tocksin/placard/kicad/README.md

# KiCad project

Date: 2026-11-11

The Placard schematic and PCB layout, one KiCad project for the main board
and one for each cartridge.  The files are saved by KiCad 9, so open them
with KiCad 9 or newer.  Board revisions are in
[docs/hardware/RELEASES.md](../docs/hardware/RELEASES.md): rev A is the
board as ordered (git tag `rev-A`), and the files here are the working
rev B.

| File | What it is |
|---|---|
| `placard.kicad_pro` | the project; open this in KiCad |
| `placard.kicad_sch` | the schematic's root sheet (A3): one box per sheet, laid out like the block diagram |
| `power.kicad_sch` ... `expansion.kicad_sch` | the ten sheets (power and clock, control, PC and address mux, ALU and registers, data bus, memory and I/O decode, video timing, video and audio out, shared port, expansion slots), docs/hardware/SCHEMATIC_PLAN.md |
| `cartridge_64k/` | the 64K ROM cartridge (5 chips), its own project (`cartridge_64k.kicad_pro`, one sheet and a routed 4-layer board), using the same `lib/` |
| `cartridge_32k/` | the 32K ROM cartridge (3 chips), its own project (`cartridge_32k.kicad_pro`, one sheet and a routed 4-layer board), using the same `lib/`; mounting hole H1 at the same place as on the 64K board |
| `placard.kicad_pcb` | the main board, routed: 4 layers (F.Cu, In1.Cu = GND, In2.Cu = VCC, B.Cu) |
| `lib/placard.kicad_sym` | PLD symbols: `ATF22V10C` (generic) and one `ATF22V10C_<name>` per `.pld` file, with its pin names |
| `lib/placard_parts.kicad_sym` | other project symbols: `AS7C256C` SRAM, `Expansion_Slot`, `Cartridge_Slot`, `SNES_Pad_Socket`, `PS2_Dual_Stacked`, `USB_C_Power` |
| `lib/placard_std.kicad_sym` | copies of the stock KiCad symbols the sheets use (74xx, R, C, D, connectors, regulator, the cartridge EEPROM `28C256`, and the power symbols `+5V`, `GND`, `+3V3`, `GNDA`, `PWR_FLAG`) with larger pin text, written by `src/scripts/gen_kicad_std.py` |
| `lib/placard.pretty/` | project footprints: the main board's connectors and switches (written by `src/scripts/gen_kicad_connectors.py`), and kit versions of KiCad's DIP socket footprints (`DIP-nn_..._Socket_Puller`: chip-puller room on User.Eco1, part number in silkscreen) and of the axial resistor (`..._Value`: value in silkscreen), written by `src/scripts/gen_kicad_kit_footprints.py`, and copies of the KiCad 9.0.6 footprints the boards use (capacitors, diodes, LED, pin header, oscillator, TO-92, SIP resistor array, mounting holes, net tie; KiCad 9 format), written by `src/scripts/gen_kicad_stock_footprints.py` |
| `lib/placard.3dshapes/` | 3D models (STEP) for the connectors, switches and polyfuse, named after their footprints and referenced as `${KIPRJMOD}/lib/placard.3dshapes/...`, so they show in any KiCad version without a 3D library path; written by `src/scripts/gen_kicad_3d_models.py` (CadQuery), which also copies in KiCad's own models for SW2, J7 and J13, and KiCad's models for the stock, socket and resistor footprints, copied by `src/scripts/gen_kicad_stock_footprints.py` |
| `sym-lib-table`, `fp-lib-table` | point KiCad at the project libraries |
| `fab/` | the rev A Gerber and drill files as ordered ([fab/README.md](fab/README.md)) |

The main board is 290 x 215 mm (290 wide, the keyboard's width; 215 deep, so
kit builders have room), 4 layers, placed and routed.

Main board

Main board copper, front red and back blue

The back edge carries USB-C power, audio line out, VGA and the stacked PS/2;
the left side the power switch, reset button and SD card; the front edge the
two SNES ports.  The cartridge and the four expansion cards stand up
through the case top.  Every DIP sits in a socket footprint with 2.5 mm of
chip-puller room clear past each socket end, and Cn sits beside Un.
`src/scripts/gen_board_pictures.py` draws the two pictures (and the
cartridge pictures in [EXPANSION.md](../docs/architecture/EXPANSION.md))
from the board files without changing them; rerun it after a layout change.

The board file is edited in KiCad and by the autorouter, so it is the
source.  `src/scripts/gen_kicad_pcb.py` made the first outline and placement
and `src/scripts/gen_kicad_cart_pcb.py` the cartridges' placement; do not
run either on the boards now (the cartridge script leaves an existing board
alone unless given `--force`).  The first placement drawings are in
[docs/archive/](../docs/archive/README.md).

The footprints KiCad has no part for (cartridge slot, expansion slots,
PS/2, SNES, the power switch, the relay) are written by
`src/scripts/gen_kicad_connectors.py`.  The SNES sockets were measured from
the part; the others are drawn from typical dimensions for the part family,
so check them against the parts when the rev A boards arrive.
Their 3D models (`src/scripts/gen_kicad_3d_models.py`) are drawn at typical
dimensions too, with the leads put on the footprint pads.  J4 (SD), J7 (VGA),
F1 and SW2 use project copies of KiCad's footprints (`placard:` library) only so
they can point at the project's models; the pads are KiCad's.
The schematic rules (which chips go on which sheet, numbering, and how
the sheets are drawn) are in [docs/hardware/SCHEMATIC_PLAN.md](../docs/hardware/SCHEMATIC_PLAN.md).  Parts and U-numbers come from
[docs/architecture/CHIPS.md](../docs/architecture/CHIPS.md); the PLD pinouts come from the `.pld` files
in `src/`.

Every part carries Manufacturer and MPN fields (empty where no part number
is chosen yet), set from the `MPN` table in `src/scripts/gen_kicad_schematic.py`,
so KiCad's BOM export lists them.  `src/scripts/gen_bom.py` writes one grouped
bill of materials per assembly (main board, 64K and 32K cartridges, case),
indexed in [docs/bom/BOM.md](../docs/bom/BOM.md), each as .md and .csv, including the
bare PCBs, sockets, shells and screws that are not on the schematic.

Backups, autosaves, lock files, `*.kicad_prl` (per-user view settings) and
`fp-info-cache` are git-ignored.

## PLD symbols

`src/scripts/gen_kicad_symbols.py` writes `lib/placard.kicad_sym` from the
`PIN` statements in `src/pld/*.pld`; rerun it after changing a PLD's pins
(it overwrites the whole library).  The pins are placed for the schematic,
not in pin-number order: the script's `LAYOUT` table puts inputs on the
left and outputs on the right, buses together in bit order, and each
function's pins in their own group.  Where one PLD does two unrelated jobs
(the audio PLD's /AC_SEL, the port PLD's pad read, the memory control's
RUN input) a dashed line across the box separates them.  Active-low pins are
`/NAME`, VCC (24) is on top and GND (12) underneath, unused pins are `nc`
(no-connect type), and the `.pld` file name is under the part number.  The
script stops if a `.pld`'s pins and its `LAYOUT` entry no longer match.
Each symbol has the footprint `Package_DIP:DIP-24_W7.62mm` and the
ATF22V10C datasheet link.

## Other symbols

`src/scripts/gen_kicad_parts.py` writes `lib/placard_parts.kicad_sym`, in
the same style, for the parts KiCad's libraries do not have: the AS7C256C
SRAM, the expansion slot (Molex 87715-9106 as the cartridge slot, contacts A1-A32 and B1-B32)
and the cartridge slot (Molex 87715-9106, 2 x 32 keyed, contacts A1-A32
and B1-B32), as in EXPANSION.md, with the +5 V and GND contacts stacked on
one pin each, the SNES pad socket (IO.md) and
`USB_C_Power`, the 5 V input: a power-only 6-contact USB-C receptacle
(GCT USB4125, footprint `placard:USB_C_Receptacle_GCT_USB4125_6P_HandSolder`:
KiCad's USB4125 footprint with the SMD pads 1.5 mm longer for the iron, made by gen_kicad_connectors.py)
with a 5.1k resistor from CC1 and from CC2 to GND so a charger gives 5 V.  Make
changes in the script, since rerunning it overwrites the library.

Every symbol, footprint and 3D model the sheets and boards use is in `lib/`
(since 2026-10-26): the projects' library tables list only the placard
libraries, so the project opens the same on any PC and DRC/ERC find nothing
missing or different from its library.  The parts below started as KiCad
library parts and are used through their copies in `placard_std` and
`placard.pretty`:

| Part | KiCad symbol |
|---|---|
| SN74F377AN | `74xx:74LS377` |
| SN74F541N | `74xx:74LS541` |
| CD74ACT273E | `74xx:74HC273` |
| SN74HCT574N | `74xx:74HCT574` |
| 25.175 MHz oscillator | `Oscillator:ACO-xxxMHz` |
| 3.3 V regulator (MCP1700-3302E/TO) | `Regulator_Linear:MCP1700x-330xxTO` |
| VGA | `Connector:DE15_Receptacle_HighDensity_MountingHoles` |
| SD socket | `Connector:SD_Card` |
| Audio line out | `Connector_Audio:AudioJack3` |
| Pull-up arrays | `Device:R_Network08` |

Set the Value to the real part number when placing them.
`src/scripts/render_kicad_symbols.py OUTDIR` draws all of these as PNG
review sheets (needs kicad-cli, cairosvg and Pillow).

## Schematic sheets

`src/scripts/gen_kicad_schematic.py` wrote the `.kicad_sch` files (main
board and cartridges) from its pin-by-pin net lists.  Since 2026-10-30 the
main-board sheets are edited in KiCad and the saved sheets are the source:
never commit a full regeneration of them.  To use the script for one sheet,
run it in a scratch copy, take only that sheet and check the netlist
against the saved one (docs/hardware/SCHEMATIC_PLAN.md).  Nets with two or more pins on a sheet are wired by the small router in
`src/scripts/kicad_route.py`, and numbered groups (`D0`-`D7`, ...) are drawn
as one bus per sheet (docs/hardware/SCHEMATIC_PLAN.md, "How the sheets are drawn").
`--check` compares KiCad's exported netlist with the script's nets and
runs basic electrical checks; for the full ERC open the project in KiCad
(Inspect > Electrical Rules Checker).  PDFs of both are in
[`../schematics/`](../schematics/).

## Dimension drawing

[`../docs/hardware/placard_main_dimensions.pdf`](../docs/hardware/placard_main_dimensions.pdf)
is a three-sheet mm drawing of the main board: outline and mounting holes,
edge connector positions, and the expansion card and cartridge space.  It is
made by `src/scripts/gen_board_dimensions.py`, which needs KiCad 9 (pcbnew
Python and kicad-cli).  The script never writes `placard.kicad_pcb`: it
adds KiCad dimension objects on Dwgs.User in temporary copies and plots
those, so rerun it after the layout changes.
