tocksin/placard/kicad/fab/README.md

# Fabrication files

These are the **rev A** outputs as ordered on 2026-11-06 (git tag `rev-A`,
see [docs/hardware/RELEASES.md](../../docs/hardware/RELEASES.md)). The working
main board and 32K cart files are now rev B, so these no longer match them;
regenerate before ordering rev B.

Generated with kicad-cli 9.0.8 from copies of the board files (the boards
themselves were not changed). Main board regenerated 2026-11-03 from main at
PR #243 (routed expansion-redesign board); cartridges 2026-10-29 (rev A).
Zone fills are the ones saved in each .kicad_pcb; kicad-cli 9 has no refill
option, so refill (B) and save in pcbnew before regenerating if a board was
edited after its last fill.

| Folder | Board | Size (mm) | Layers |
|---|---|---|---|
| `main/` | `kicad/placard.kicad_pcb` | 290.1 x 215.1 | 4, 1.6 mm |
| `cart32k/` | `kicad/cartridge_32k/cartridge_32k.kicad_pcb` | 39.1 x 66.1 | 4, 1.57 mm |
| `cart64k/` | `kicad/cartridge_64k/cartridge_64k.kicad_pcb` | 39.1 x 102.25 | 4, 1.57 mm |

Each folder holds `gerber/` (the files to zip and upload) and `drc.rpt`.
The upload zips (`placard_<board>_gerbers.zip`, Gerber files at the zip root)
and the ODB++ zips (`placard_<board>_odb.zip`) are git-ignored; copies are
in the project files under `hardware/fab/`.

## Gerber and drill settings

- Gerber RS-274X with X2 attributes, Protel extensions (.gtl .gbl .gto .gbo
  .gts .gbs .gtp .gbp .gm1; inner layers .g1 = In1 GND, .g2 = In2 VCC),
  soldermask subtracted from silkscreen, plus a Gerber job file (.gbrjob).
- Drill: Excellon, mm, decimal zeros, absolute origin, oval holes in
  alternate (G85) mode, PTH and NPTH in separate files, drill maps in Gerber X2.
- These settings match the JLCPCB and PCBWay KiCad guides, so one zip works
  for both.

## Ordering notes

- Upload the Gerber zip to JLCPCB or PCBWay. Both quote and check
  Gerber + Excellon zips; the ODB++ zip is for fabs or assembly houses that
  ask for it.
- Cartridges: the edge fingers mate with a Molex 87715-9106 (PCIe style)
  slot, so order 1.6 mm (1.57) thickness with gold fingers (hard gold / ENIG)
  and a 45 degree finger bevel.
- Main board 2026-11-03: refill gave a file identical to the saved one; DRC
  with schematic parity 0 violations, 0 unconnected, 0 parity issues.
- DRC (all three boards, run with each project's own rules and footprint
  library; main board uses the PCBWay-margin rules): 0 errors, 0 warnings,
  0 unconnected pads.
- Saved fills checked against a fresh refill: all three identical. The carts
  were regenerated on 2026-10-29 after Justin's Update PCB from Schematic
  (nets renamed to ADDR*/DATABUS*, part-number fields added; the mounting hole
  H1, which is not in the cart schematics, was put back at its old position)
  and a refill; copper geometry is unchanged apart from the refill.
- S/N box (17 x 5.5 mm) is a filled silk rectangle on all three boards
  (2026-10-29), so a black marker shows up on it.
