tocksin/placard/docs/sound/SOUND.md

# Sound

Date: 2026-11-11

The video circuit plays sound by itself.  On every scan line it reads one
8-bit sample from RAM, the same way it reads pixels, and a register feeds that
sample to a resistor DAC.  Software only keeps a 525-byte buffer filled.

| | |
|---|---|
| Format | 8-bit unsigned mono, 80h = silence |
| Sample rate | the line rate: 31.469 kHz at 25.175 MHz (31.25 kHz on the FPGA's 25.000 MHz) |
| Buffer | 5DF3h-5FFFh, 525 bytes, one frame, played in address order and repeated |
| Added chips | audio slot PLD (ATF22V10C) and DAC register (SN74HCT574N); the DAC, filter and line output are passives |
| CPU cost | one stall clock per line (525 per frame, 0.13 %) |

## Schematic

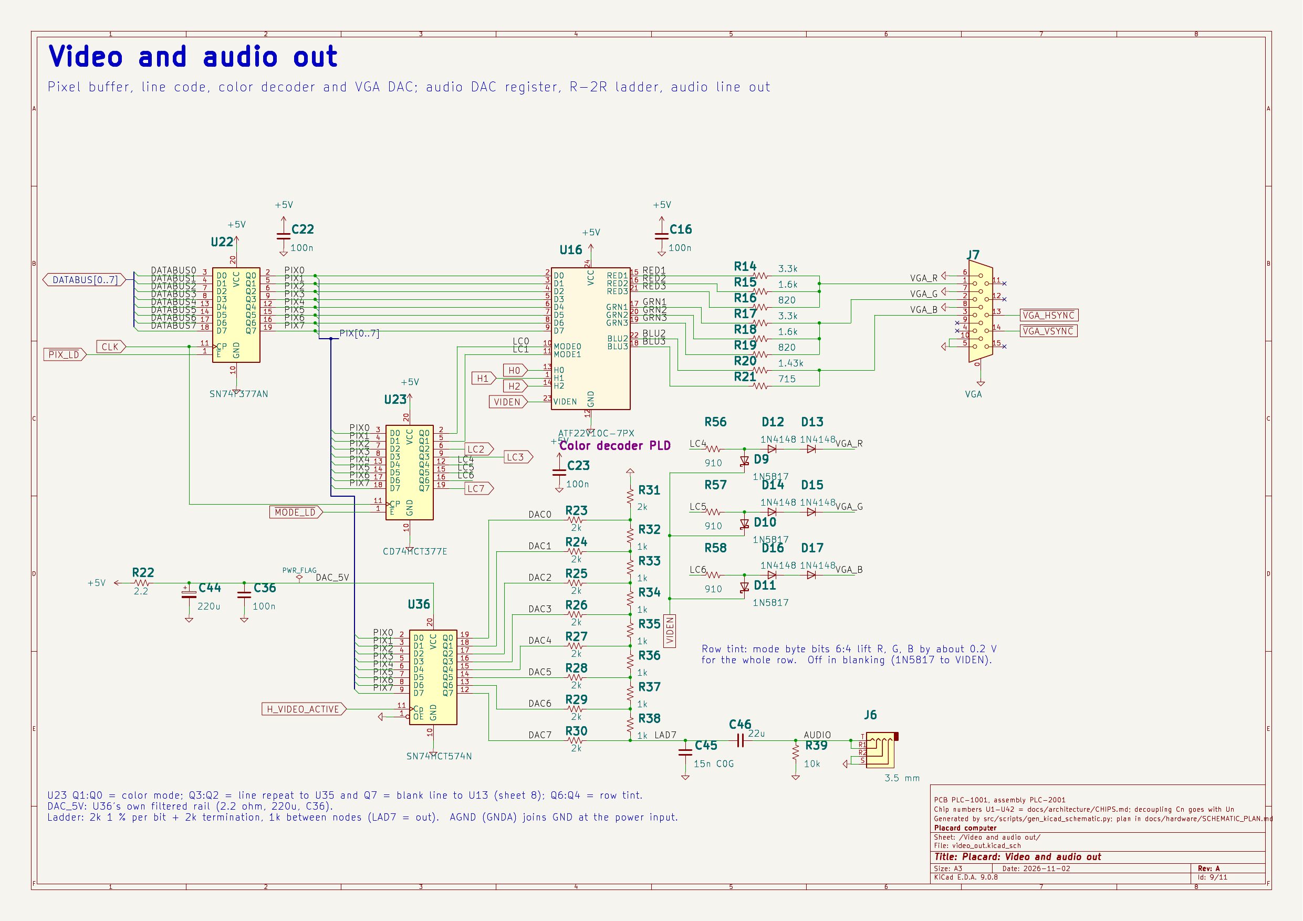
[picture p30: schematics/placard_video_audio_schematic.png]
Video and audio out, sheet 9 of the schematic


This is sheet 9 of the schematic (`schematics/placard_main.pdf`): the pixel
buffer (U22), the DAC register (U36) with its filtered supply (R22, C44,
C36), the R-2R ladder (R23-R38), the filter (C45, C46, R39) and the jack
(J6).  The audio slot PLD (U35) and the Sync PLD (U15) that make the read
are on sheet 8.

## How the sample is read

**The read.**  The Sync PLD raises PIXEL_ENABLE for one more
clock per line, in clock 1 of an 8-clock group in horizontal blanking, on all
525 lines including vertical blanking.  It is a video read in every way: the
address mux selects the video address, the Branch PLD stalls the CPU, the
memory control PLD enables the RAM (video reads always read the RAM), and
the pixel buffer (F377) loads the byte.

**The address.**  The video address is H9:H3 on A15:A9 and V8:V0 on A8:A0.
The V counter runs 499-1023, 525 lines, but only 9 bits of it reach the
address, so lines 499-511 and 1011-1023 would read the same 13 bytes and 13
samples would repeat every frame (a 60 Hz buzz).  The audio slot PLD fixes
that by reading in group 46 when V9 = 0 and in group 47 when V9 = 1, which
puts V9 on A9:

| Lines | V9 | Group | H9:H3 | Addresses |
|---|---|---|---|---|
| 499-511 | 0 | 46 | 0101110 | 5C00h + 499..511 = 5DF3h-5DFFh |
| 512-1023 | 1 | 47 | 0101111 | 5E00h + 0..511 = 5E00h-5FFFh |

One frame reads 5DF3h through 5FFFh in order.  The buffer is at the top of
section 2, just below the video memory; the I/O window is 5000h-53FFh
(groups 40-41), where no memory answers.  The row address bits the audio
slot PLD remaps for the line repeat are passed through unchanged in groups
32-47, so the audio read is not affected by a row's mode byte.

**The output.**  The mode byte read (group 45) comes before the audio read,
so the pixel buffer holds the sample until the first pixel read of the line
loads it (end of clock 1 of group 48).  A 74HCT574 clocked by the rising
edge of H_VIDEO_ACTIVE (H counter PLD pin 22, start of group 48) copies it.
So every sample lasts exactly one line (800 clocks), even though the read
itself moves 8 clocks between group 46 and group 47.

### Audio slot PLD (`ATF22V10_AUDIO.pld`, `audio_pld.vhd`)

It also marks group 45, where the video circuit
reads the line's mode byte (see [VIDEO.md](../video/VIDEO.md#mode-byte)), and makes
four row address bits for the line repeat (see
[VIDEO.md](../video/VIDEO.md#line-repeat)).

    BLANK_RD = !H9 & H8 & !H7 & H6 & H5 &  H4 &  H3 &  V9      /* group 47 */
             # !H9 & H8 & !H7 & H6 & H5 &  H4 & !H3 & !V9      /* group 46 */
             # !H9 & H8 & !H7 & H6 & H5 & !H4 &  H3;           /* group 45 */

    MODE_LD  = !H9 & H8 & !H7 & H6 & H5 & !H4 &  H3;           /* pin 22, active low */

| Pin | Signal | From / to |
|---:|---|---|
| 1 | V0 | V counter PLD pin 14 (Q0) |
| 2-8 | H9, H8, H7, H6, H5, H4, H3 | H counter PLD pins 20, 19, 18, 17, 16, 15, 14 |
| 9 | V9 | V counter PLD pin 19 (Q9) |
| 10, 11, 13 | V1, V7, V8 | V counter PLD pins 23, 17, 18 |
| 14, 15 | LC2, LC3 | Line code register (74HCT377) Q2, Q3 |
| 17-20 | R0, R1, R7, R8 | Address mux video inputs for A0, A1, A7, A8 |
| 22 | /MODE_LD | Line code register (74HCT377) /E |
| 23 | BLANK_RD | Sync PLD pin 13 |
| 16, 21 | unused | |

### Sync PLD term

    PIXEL_ENABLE.D = V_VIDEO_ACTIVE & H_VIDEO_ACTIVE & H2 & H1 & !H0
                   # BLANK_RD & H2 & H1 & !H0;

BLANK_RD comes in on the Sync PLD's pin 13 and reads in clock 1 of the
group it marks, like a pixel read ([VIDEO_TIMING.md](../timing/VIDEO_TIMING.md)).

### Timing

| Path | Total | Slack at 39.72 ns (datasheet) |
|---|---:|---:|
| BLANK_RD to the Sync register: H counter tCO 5.5, audio PLD tPD 7.5, Sync tS 3.5 | 16.5 ns | +23.2 |
| The audio read: the same path as a pixel read, through /RAM_OE ([VIDEO_TIMING.md](../timing/VIDEO_TIMING.md)) | 36.4 ns | +3.4 (−1.1 on the routed board, see [TIMING.md](../timing/TIMING.md)) |
| DAC register data: the pixel buffer is steady from group 46/47 to clock 1 of group 48, and the clock edge (H_VIDEO_ACTIVE, tCO 5.5 ns) is at the start of group 48 | at least 6 clocks before the edge and 2 after | |

### Checked in simulation

The FPGA model (GHDL) reads exactly one sample per line, 5DF3h-5FFFh in
order with no repeats, and the DAC register steps once per line.

## DAC, filter and audio line out

All passive, with no op-amp and no headphone amplifier: the jack is an
audio **line out**, meant for a line input (an amplifier, powered speakers,
a mixer or a capture card, 10 kΩ or more).  It is not a headphone output
(Justin, 2026-10-23).

    +5V ──2.2Ω──┬── VCC (pin 20) of the 74HCT574 ("DAC 5V")
                ├── 220µF ── AGND
                └── 100nF ── AGND

    74HCT574 Q7 (MSB) ─ 2k ─┬───────────────── ladder out (Rth = 1k)
    74HCT574 Q6       ─ 2k ─┼ 1k ┐
                             ...  (each node: 2k from its bit,
    74HCT574 Q1       ─ 2k ─┼ 1k ┐  1k to the next node up)
    74HCT574 Q0 (LSB) ─ 2k ─┤
                             └─ 2k ─ AGND   (termination)

    ladder out ──┬── 15nF ── AGND                (filter)
                 └── 22µF ceramic ────────────────┬── jack tip and ring
                                                  └── 10k ── AGND   (bleed)
    jack sleeve ── AGND

### The register

- **74HCT574, not 74HC574 or 74F574.**  HCT inputs read the pixel buffer's
  74F outputs (2.7 V minimum high) correctly, which an HC input (3.5 V
  threshold at 5 V) does not.  HCT outputs swing rail to rail, which the
  ladder needs for even steps; 74F outputs only reach about 3.4 V and differ
  from bit to bit.
- D7:D0 from the pixel buffer Q7:Q0.  CLK from H_VIDEO_ACTIVE (H counter PLD
  pin 22).  /OE (pin 1) to ground.
- **Power it from its own filtered rail** (2.2 Ω, 220 µF and 100 nF above).
  The ladder's full scale is this chip's VCC, so any noise on it comes out in
  the audio in proportion to the sample (at silence, 80h, half of it).  The
  chip and ladder draw at most about 5 mA, which drops about 11 mV across the
  2.2 Ω (0.2 % of full scale), less than one step.
- In the FPGA model the register is `audioDacProc` in `basys_top.vhd`, and
  Q7:Q0 come out on Pmod JA (JA10 = Q7 down to JA1 = Q0, 3.3 V full scale).
  The same ladder and output work there, at two thirds of the level.

### The R-2R ladder

| Part | Value | Qty |
|---|---|---:|
| 2R: one per bit, plus the termination | 2.00 kΩ, 1 % metal film | 9 |
| R: between neighboring nodes | 1.00 kΩ, 1 % metal film | 7 |

- Open-circuit output = VCC × code / 256, so 0 V to 4.98 V, 2.49 V at
  silence (80h).  The ladder's output resistance is R (1 kΩ) at every code.
- The low R (1 k instead of a more usual 10 k) keeps the output impedance
  low enough to drive a line input and its cable without a buffer.  Each bit
  sources at most about 2.5 mA, well inside what a 74HCT574 output can do.
- Linearity: with 1 % parts the steps are even to about 7 bits.  The HCT
  output resistance (roughly 25-50 Ω) against 2 kΩ adds about one step of
  error at the middle of the range.  Neither is audible as distortion in
  sound like this.  For better, use 0.1 % parts for the MSB leg and the two
  legs below it.

### The filter

One capacitor, 15 nF (C0G or film), from the ladder output to AGND.

- Into a line input (10 kΩ or more) it forms a single pole with the
  ladder's 1 kΩ: 10.6 kHz (11.7 kHz with a 10 kΩ load).  That softens the
  31.5 kHz steps.
- A low-impedance load (headphones, 16-32 Ω) would swamp the 1 kΩ and the
  pole would move far above the audio.  That is one more reason the jack is
  a line out only.
- A C0G (NP0) or film capacitor, not X7R, whose value moves with voltage.

### The line output

| Part | Value | Why |
|---|---|---|
| Coupling capacitor | 22 µF ceramic (X5R/X7R, non-polar), 10 V or more | blocks the 2.49 V offset; low corner about 7 Hz into 16 Ω, under 1 Hz into 10 kΩ |
| Bleed resistor | 10 kΩ, jack side to AGND | holds the jack side at 0 V so plugging in does not pop; also the minimum load when nothing is plugged in |
| Jack J6 | 3.5 mm, 4 pole (TRRS); tip and ring tied together, sleeve to AGND | mono on both channels of a stereo line input |

- **Level.**  Into a 10 kΩ line input (in parallel with the 10 kΩ bleed,
  5 kΩ in all) a full-scale sine is about 4.2 V peak to peak (1.5 V rms,
  +3.4 dBV); open circuit it is 5 V peak to peak.  That is hotter than the
  consumer line level (-10 dBV, 0.9 V peak to peak) but under the 2 V rms
  most line inputs accept.  Software sets the volume by scaling the samples
  around 80h; a sine of 80h ± 20h is about 1 V peak to peak, close to
  consumer line level.  Output impedance is about 1 kΩ.
- **Headphones are not supported.**  There is no headphone amplifier: into
  16-32 Ω headphones the swing drops to about 80-150 mV peak to peak, very
  quiet.
  Plug the jack into an amplifier or powered speakers instead.
- **Short circuit** (a plug going in): the 1 kΩ ladder resistance limits the
  current, so nothing is harmed.
- **Power-on.**  At power-up the coupling capacitor charges to 2.49 V, which
  makes one soft thump if an amplifier is already connected.  After that the
  output stays at mid-scale (see the click-free rules), so it happens only
  once.
- **Grounds:** the ladder termination, the 15 nF capacitor, the bleed
  resistor and the jack sleeve all return to an analog ground (AGND) that
  meets the logic ground at one point, at the power input.

## Click-free rules

The hardware never adds a click on its own:

1. **One sample per line, no gaps, no repeats**, on all 525 lines, and every
   update at the same point in the line.
2. **All 8 bits change on one edge** of the 74HCT574, so the ladder never sees
   a half-updated value; the few-ns skew between bits is far above the audio
   band, and the filter removes it.
3. **Silence is 80h**, and the output is AC coupled, so starting and stopping
   never makes a DC step.
4. **Power-up.**  Video reads always come from the RAM (memory control PLD), which is random at power-up, so the output plays noise until
   software fills 5DF3h-5FFFh with 80h; that should be one of the first things
   a program (or the boot loader) does.  The 74HCT574 powers up with a random
   value for one line (32 us), which the filter and coupling capacitor turn
   into nothing worth hearing.

Software has its own part:

- Fade a sound in and out over a few milliseconds; never cut it off mid-wave.
- Leave 80h in the buffer when nothing is playing.
- Keep the buffer filled ahead of playback (next section).  If a program stops
  refilling, the last frame repeats, which is a buzz, so fade to 80h first.

## Software

### The sound driver

The library's sound driver (`src/scripts/placard_snd.asm`, in the library
at `SND_CODE`, ROM x9200-x96FF, section 4) does the buffer work.  A program calls `snd_init` once,
`snd_update` once every frame (from anywhere in the frame; a game loop that
already calls `wait_frames` or `frame_poll` just adds it), and starts sounds
with one call:

```
    (CALL snd_init)             ; once
    ...
    ld   69, ac                 ; A 440 Hz
    (CALL snd_beep)             ; a short note that fades out
    ...
loop:
    (CALL snd_update)           ; every frame
    ...
```

| Routine | In | Does |
|---|----|---|
| `snd_tone` | R1:R0 = step (frequency in Hz x 1.0413), AC = volume 0-127, R2 = frames (0 = until stopped), R3 = volume taken off each frame | Square wave |
| `snd_note` | AC = MIDI note 0-127 (60 = middle C, 69 = A 440) | R1:R0 = the step for `snd_tone` |
| `snd_beep` | AC = MIDI note | Volume 96, 12 frames, fading by 8 a frame |
| `snd_noise` | AC = volume, R0 = rate 1-128 (128ths of the line rate), R2, R3 as `snd_tone` | Noise (a 16-bit LFSR, the same seed each time) for drums and hits |
| `snd_play` | R1:R0 = samples (RAM or ROM), R3:R2 = count, AC = rate 1-128 (128 = 31.5 kHz, 32 = 7.9 kHz) | 8-bit unsigned samples, 80h = silence |
| `snd_stop` | | Silent within a frame |
| `snd_busy` | | AC = 0 when silent |

One sound plays at a time; starting another replaces it.  The step is a
16-bit phase increment per line (32768 = half a cycle per line), so the
pitch error is under 0.01 % above 100 Hz.

**How `snd_update` keeps up.**  Instead of double buffering it writes just
behind the player: it waits for the line read to change (so it knows the
line exactly, to 4 lines) and writes every sample from where it stopped
last time up to the line now playing.  Sounds start within a frame.  When
the sound is over and the buffer has been all 80h for two laps, it returns
at once.  The line read only says where the player is within its lap, so
the driver also counts the frames between calls (`FRAME_LO`, which
`frame_poll`, `wait_frames` and BASIC keep): a call a whole frame after
the last one, with the player a line or two past where it was, writes a
lap and the little more, not just the little more.

**Measured CPU time** (`test_snd.py`, about 380,000 usable clocks per frame):

| Sound | Clocks per frame | Share |
|---|---:|---:|
| Silence (buffer clean) | about 90 | 0 % |
| Samples (`snd_play`) | about 18,300 | 5 % |
| Tone | about 26,000 | 7 % |
| Noise | about 42,700 | 11 % |

Plus up to 3,200 clocks waiting for the line read to change.  The driver
uses zero page x90-x9E and T0-T3.  `test_snd.py` checks the buffer against
a Python model of every sound, sample for sample.

### The music player

For music, `src/scripts/placard_mus.masm` is a four-voice SID-style player
(patterns, instruments, envelopes, effects, a fifth voice for sound effects)
that a program includes instead of the driver: [MUSIC.md](MUSIC.md).

### By hand

A program that does not use the driver can fill the buffer itself.

**Playback position.**  The sample playing is line V - 499, and the line read
at 5000h returns V9:V2 (V / 4).

**Double buffering.**  The buffer splits at line 768, which is where the line
read reaches C0h and the address reaches 5F00h:

| Half | Lines | Line read | Bytes | Addresses |
|---|---|---|---|---|
| A | 499-767 | 7Ch-BFh | 269 | 5DF3h-5EFFh |
| B | 768-1023 | C0h-FFh | 256 | 5F00h-5FFFh (one page) |

At least twice per frame (every 8 ms), read the line count and refill the
half that is not playing:

    ld 0x50, y
    ld [y,x], ac          ; line read (V9:V2)
    ; ac >= 0xC0: half B is playing, so refill half A if not done this frame
    ; ac <  0xC0: half A is playing, so refill half B if not done this frame

Each refill has 8 ms to finish, so no exact timing is needed.  If one is
late, the old half plays again (a stutter).

**Other rates.**  Writing each sample twice gives 15.7 kHz, four times
7.9 kHz.  A tone with a whole number of cycles per frame (a multiple of
59.94 Hz) loops with no refills at all.

**CPU time** (estimates from the instruction clock counts in CPU.md, not
measured; about 380,000 CPU clocks per frame):

| Work | Clocks per sample | Per frame |
|---|---:|---:|
| Hardware read (stall) | 1 | 0.14 % |
| Polling the line read twice | | under 0.1 % |
| Silence or a looping tone | 0 | 0 % |
| Copying a stored sound | about 25 | about 3.5 % |
| One generated voice (phase add and wavetable) | about 40 | about 5.5 % |
| Each extra mixed voice | about +25 | about +3.5 % |

## Memory map impact

- 5DF3h-5FFFh is the audio buffer while sound is used.  5A20h-5BFFh holds the
  row mode bytes (see [VIDEO.md](../video/VIDEO.md#mode-byte)).  4000h-4FFFh,
  5400h-5A1Fh and 5C00h-5DF2h are free.
- The video reads the buffer from the RAM whatever the map says.  For the
  CPU to read it back, section 2 (map bit 2) must read RAM.
