tocksin/placard/docs/software/SOFTWARE_ROADMAP.md

# Software roadmap

Date: 2026-11-11

Programs to write for the Placard, what each needs, and where it fits.
The libraries it builds on are in [LIBRARY.md](LIBRARY.md)
and [IO.md](../architecture/IO.md).  The sizes below are estimates, to be replaced by real
numbers as each program is written.

## The long-term plan

The ROM holds only the essentials: the library (core routines, font, I/O
drivers, FAT, sound), the boot loader, and a small resident program that
can find and load everything else from the SD card.  Other programs are
files on the SD card, loaded into RAM one at a time.  The cartridge can be
32 KB (x8000-xFFFF, mirrored) or 64 KB (ROM.md, "Loading the cartridge"),
so the resident set shares **x8000-xFFFF (32 KB)** with the library, one
kind of thing per 8 KB section (ROM.md, "ROM map").

### What the machine gives a program

| Resource | Amount | Notes |
|---|---|---|
| Clock | 25.175 MHz | one frame = 800 × 525 = 420,000 clocks, 59.94 Hz |
| CPU time | about 380,000 clocks a frame | 80 video stall clocks per drawn line (38,400 a frame); blanked rows give them back (VIDEO.md, "Blank line") |
| Native instructions | 2-4 clocks each, about 3 typical | about 125,000 a frame, 7.5 million a second |
| ROM, resident | x8000-xBFFF (16 KB) on a 32 KB cart | plus x2000-x3FFF and x6000-x7FFF on a 64 KB cart |
| RAM for a loaded program | x0100-x1EFF (7.75 KB) and x2000-x3FFF (8 KB, map section 1 to RAM) | about 15.75 KB of code; x1F00-x1FFF is `LIB_RAM` |
| RAM for data | x4000-x4CFF (3.25 KB), x5400-x5A1F, x5C00-x5DF2 | x4D00-x4FFF is the FAT buffer |
| Video RAM freed | 20 KB with an 80 × 28 text screen | see below |

**Text screen versus free RAM.**  The full 80 × 60 console uses all 37.5 KB
of video RAM.  A program that needs memory (editor, assembler, BASIC, CP/M)
can use text rows 0-27 only (1x rows 0-223, which use the low 256 bytes of
each video column) and blank the rest of the screen: that leaves the high
256 bytes of every column free, 80 pages (x61, x63 ... xFF), 20 KB, and the
blanked lines give back about 20,000 clocks a frame.  The pages are not
contiguous, so programs keep their data in 256-byte pages through a page
list.  Reading them needs sections 3-7 mapped to RAM, so that code runs
from RAM (as `plot1` and `con_scroll` do), not from ROM x6000-xFFFF.

## Missing pieces in the library

| Piece | Needed by | Size | Notes |
|---|---|---|---|
| FAT write | DOS, editor, assembler, BASIC SAVE | 3.2 KB | **Done 2026-10-26** (`placard_fsw.masm`, in the 32K image at xD600, vectors x8010-x8020): create, write, close, delete, save; every FAT kept up to date.  Not yet: rename, make folder. |
| Program file format | DOS, loader, every SD program | small | **Done 2026-10-26**: the `.PLC` header ("PLC", type, load address, length, entry; [DOS.md](DOS.md#program-files-plc)), `gen_plc.py` |
| Faster scroll / partial redraw | editor, monitor, BASIC | 0.5-1 KB | `con_scroll` takes 46 ms for the full 60 rows; an editor redraws only changed lines and scrolls a 28-row window (about half the time) |

## Programs

### 1. Monitor (SD program, MON.PLC)

Examine and change memory, hex dump, fill, copy, compare, jump to an
address, load and save memory ranges to SD files, and a disassembler built
from the opcode table (`reference/opcode_map.html`).  It is the first
program to write, because everything after it is debugged with it.

- Needs: console, keyboard (`kbd_getc`, `con_gets`), FAT read; FAT write for
  "save".
- Size: 3-5 KB, plus 1.5-2 KB for the disassembler.  RAM: a line buffer.
- BASIC takes the ROM's free space, so the monitor is
  planned as a program on the card; BASIC's `PEEK`, `POKE` and `CALL` cover
  quick changes without a card.

### 2. DOS: file browser and SD loader - done 2026-10-26

`dos.masm`, [DOS.md](DOS.md): `DOS.PLC` on the SD card (in the ROM until
later the same day, when it moved to the card to make room for BASIC; the
ROM keeps a 1.5 KB loader, `rom32.masm`, that starts it and runs programs).  A file browser
(Up / Down, Enter runs a `.PLC` file or opens a folder, Backspace, Del, B
picks the boot program) with a command line (`RUN`, `LOAD`, `SAVE`, `DEL`,
`CD`, `BOOT`, `DIR`), `BOOT.CFG` for what starts at power-up, Esc held at
power-up for the browser.  The FAT writer (`placard_fsw.masm`, 3.2 KB at
xD600) and the `.PLC` program file format (`gen_plc.py`) came with it; the
demo menu became a program on the card (`menu.masm`).  Not yet: `TYPE`,
`COPY`, `REN`, `MD`, `RD`.

### 3. Text editor (SD program)

A full-screen editor for assembly source: 80 × 28 window, cursor keys,
insert/delete, line join/split, search, go to line, load/save, and maybe
cut/paste of a line range.

- Needs: keyboard (PS/2), console, FAT read
  and write, faster redraw.
- Code: 4-6 KB.  Text buffer: the 20 KB of freed video pages plus
  x4000-x4CFF, about 23 KB of text, as a list of 256-byte pages holding
  lines (a gap per page) so inserting never moves the whole file.
- Files bigger than that are split with `#include`.

### 4. Assembler (SD program)

A native assembler for the Placard's own syntax, the subset of the
customasm rules the repo uses: labels, `NAME = value`, `#addr`, `#d`
(bytes and strings), `#include`, expressions with `+ - * / & | ^ >> <<`,
`>>8` and `&0xFF` for address halves.  Two passes, reading the source from
SD each pass, writing a program file (or a raw binary) to SD.  It warns
about a branch that leaves its page, like `placard_sim.py`.

- Needs: FAT read and write, console for errors, the library's jump table
  names (an include file with the `jt_` addresses, which never change).
- Code: 6-8 KB.  Symbol table: about 12 bytes a symbol, so 1,000-1,500
  symbols in 12-18 KB of freed video pages.
- Speed: the SD card reads 75 KB/s and parsing costs a few hundred native
  instructions a line, so a 20 KB source assembles in a few seconds.
- With the editor this makes the machine self-hosting.  Editor and
  assembler can later share one program (edit, assemble, run, back to the
  editor) if the memory allows.

### 5. BASIC (ROM, 32K image)

A 16-bit integer BASIC in the style of Tiny BASIC or Apple Integer BASIC:
line numbers, `PRINT`, `INPUT`, `IF`, `GOTO`, `GOSUB`, `FOR`, arrays,
strings, `PEEK`, `POKE`, `CALL`, `LOAD`, `SAVE`, `DIR`.  Placard extras:
`PLOT`, `LINE`, `MODE` (row color mode and repeat), `TINT`, `PAD`,
`SOUND`, `WAIT` (frames).  Floating point later, probably as a library of
its own.

- Needs: console, keyboard, FAT read and write, sound, pixel routines
  (`plot1`, and the 2/4/8 bpp plots still to write).
- Code: 6-10 KB (integer), 3-4 KB more for floating point.  Program space:
  the freed video pages, about 20 KB, or more when a program draws in 2x/4x
  rows.
- Speed: a tokenised interpreter should do a few thousand simple
  statements a second, ahead of the 1 MHz home computers' BASICs.
- BASIC is in the ROM (x8100-xAFFF of the 32K
  image, about 10.5 KB) with the DOS on the card, so the machine is useful
  without a card.
- **Done 2026-10-26** ([BASIC.md](BASIC.md)): a Microsoft-style integer
  BASIC with strings, arrays, `DATA`, graphics under a text window, sound
  and `SAVE`/`LOAD` of text files, about 9 KB.  Written in a compact
  bytecode (`basic.vm`, compiled by `vmc.py`) run by a small native
  machine (`basic.masm`).  80 x 60 or 80 x 30 text.

### 6. Console emulator: CHIP-8 and SUPER-CHIP (SD program)

The realistic console emulator.  CHIP-8 is a small virtual machine made for
hobby games (35 opcodes, 64 × 32 display, 16 keys, two 60 Hz timers);
SUPER-CHIP adds 128 × 64 and scrolling.  Hundreds of free games exist.

- Needs: keyboard or SNES pad, sound (`snd_beep`), FAT read for the game
  files, a file picker.
- Code: 2-3 KB.  RAM: 4 KB for the machine.
- Speed: games run 500-1,000 CHIP-8 instructions a second; at 50-100 native
  instructions each that is about 5 % of the CPU.  Each CHIP-8 pixel can be
  one whole byte of a 1 bpp row (8 pixels wide) with 4x line repeat, so
  drawing is just storing 00 or FF.
- Runs at full speed with room to spare: a good first emulator.

### 7. CP/M emulator (SD program)

An 8080 emulator with the BDOS and BIOS written natively (CP/M's calls to
address 0005 and the BIOS jump table trap into Placard code), so the 8080
memory holds only the program area.  Disks are disk image files on the SD
card, read and written block by block in place (the image is made full
size on a PC, so the FAT never has to grow it).

- Needs: FAT read, `sd_write` into an existing file, console with a 24-line
  terminal (ADM-3A or VT52 codes), keyboard.
- Code: the 8080 core, BDOS and BIOS, 10-14 KB, run from RAM x0100-x3FFF so
  sections 3-7 can stay mapped to RAM while the 8080 runs.
- 8080 memory: through a page table (the 8080's high address byte picks a
  Placard page), from the freed video pages and x4000-x4CFF: about 26-30 KB
  of TPA.  Enough for many CP/M programs (Microsoft BASIC-80, small
  assemblers and editors); some want 48 KB or more and will not run.
- Speed: about 40-50 native instructions per 8080 instruction, so about
  150,000-190,000 8080 instructions a second, roughly a 1-1.3 MHz 8080.
  Usable, a bit slower than a real 2 MHz CP/M machine.
- A RAM expansion card (a banked 128 KB SRAM behind a slot's I/O window)
  would give a full 64 KB TPA later; not designed.
- The BDOS and BIOS are our own code, so no Digital Research code has to
  ship; the CP/M programs themselves come from disk images.
- Z80 instead of 8080 (most later CP/M software) costs more decode work
  and about 20-30 % more time per instruction.

## Which computers it could emulate

The rule of thumb from the estimates above: an emulated 6502 runs like a
**0.5-0.6 MHz 6502** and an emulated Z80 or 8080 like a **1-1.3 MHz Z80**,
before any time spent on the emulated machine's video and sound.  So a
1 MHz 6502 machine runs at about half speed, less when its screen or sound
chip needs much work.  Machines whose screen is plain text, or that spend
most of their time waiting for the keyboard, feel much better than that
number.  Machines with clever video chips (most consoles) do not work.

| Machine | CPU | Screen | Estimated speed | Verdict |
|---|---|---|---|---|
| CHIP-8, SUPER-CHIP | virtual machine | 64 × 32, 128 × 64 mono | full speed, about 5 % of the CPU | **Yes** (program 6) |
| Apple 1, KIM-1, Ben Eater-style 6502 | 6502, 1 MHz | 40 × 24 text terminal or LEDs | CPU about 55 %, but they wait on the terminal, so they feel full speed | **Yes**, small and easy; a good first 6502 core |
| CP/M (8080) | 8080, 2 MHz | 80 × 24 terminal | about 50-65 % | **Yes** (program 7) |
| ZX81 | Z80, 3.25 MHz | 32 × 24 characters, mono | close to a real one in SLOW mode, which spends about three quarters of its time drawing the screen | **Probably yes**; simple screen, 1-16 KB RAM, 8 KB ROM |
| TRS-80 Model I | Z80, 1.77 MHz | 64 × 16 text, block graphics | about 60 % | **Decent**; text screen, 4-16 KB RAM |
| VIC-20 | 6502, 1.02 MHz | 22 × 23 characters (176 × 184), 16 colors | about 40-55 % | **Possible, at about half speed**; see below |
| Apple II | 6502, 1 MHz | 40 × 24 text, lo-res, 280 × 192 hi-res with artifact color | about 50 %, hi-res games slower | Text and BASIC yes, hi-res games poor |
| ZX Spectrum | Z80, 3.5 MHz | 256 × 192 with color per 8 × 8 cell | about 30 % | No |
| Commodore 64, NES, Atari 2600, Game Boy | 6502 or similar with a sprite/video chip | | 15-40 % | No |

**VIC-20 in more detail.**  It is one of the better fits among real home
computers, because it is small and its screen is made of characters:

- *Memory:* 5 KB of RAM and 20 KB of ROM (BASIC 8 KB, KERNAL 8 KB,
  character set 4 KB).  It fits: ROM images in the 20 KB of freed video
  pages (or in the cartridge ROM on a 64 KB cart), emulator code in RAM
  x0100-x3FFF, the VIC's RAM in x4000-x4CFF.  A 3-8 KB memory expansion
  also fits; a 24 KB one does not.
- *CPU:* the 6502 core at about half the speed of the real 1.02 MHz one.
- *Screen:* 506 character cells.  Redrawing a cell costs about 100 native
  instructions, so the emulator keeps track of which cells and character
  shapes changed and redraws only those.  BASIC and slow games look fine;
  games that scroll the whole screen or rewrite many character shapes
  every frame slow down further.
- *Color:* the hard part.  The VIC-20 gives each cell its own color, but
  the Placard's rows that are wide enough are 1 bpp (640 across, so the
  VIC's 176 pixels can be shown three times wider, one color per row with
  the row tint) or 2 bpp (320 across, a fixed 4-color palette).  The
  16-color rows are only 160 across, 16 pixels short.  Expect a
  compromise: monochrome with tinted rows, or 16 colors with the picture
  squeezed to 160 across.
- *Sound:* 3 square-wave voices and noise, mixed into the audio buffer one
  sample a line, about 15,000-25,000 clocks a frame.
- *ROMs:* the Commodore ROMs are still copyrighted; the user would supply
  their own images on the SD card.

So a VIC-20 emulator could run BASIC and simple games at about half speed
with simplified color.  The Apple 1 / KIM-1 machine is the better first
6502 target: same CPU core, far less work, and it feels full speed.

## Atari 2600: not feasible at full speed

The 2600 is cheap for a real 2600 because its video chip (the TIA) does the
pixel work in hardware.  An emulator has to do the TIA's work in software
as well as the 6507's, and keep the two in step to the cycle, because
2600 games "race the beam": they rewrite the TIA's registers in the middle
of a line to change the playfield, move sprites and change colors.

**What one 2600 frame needs:**

| Job | Work | Placard clocks |
|---|---|---|
| 6507 | 262 lines × 76 cycles = 19,912 cycles; about 4,000-6,000 instructions executed (the rest is waiting in WSYNC) | 5,000 × ~40 native × 3 = **about 600,000** |
| TIA picture | 192 lines × 160 pixels: playfield, 2 sprites, 2 missiles, ball, priorities, 15 collision bits, writes split at their color clock | at least ~5 native per output byte plus ~150 per line: **about 320,000** |
| TIA sound | 2 channels of polynomial counters, one sample a line | about 15,000 |
| **Total** | | **about 935,000** |
| Placard has | | **about 380,000** |

So even a carefully written emulator runs about **2.5 times too slow**: a
game would play at about 40 % speed (24 frames a second instead of 60),
with its music slowed to match.  That is a best case; cycle-exact sprite
positioning (`RESPx`, `HMOVE` and its comb), collisions for every pixel and
bank switching add to it, and the first version would likely be 4-8 times
too slow.

The picture is a second problem: the 2600 has 128 colors at 160 pixels
across.  The Placard's 4 bpp rows are 160 across but a fixed 16-color
palette, and its 8 bpp rows have 256 colors but only 80 pixels across.

**Verdict:** a slow-motion demo of a simple 4 KB game is possible as a
stunt, but a usable 2600 emulator is not; it is left off the list.
Realistic instead:

- CHIP-8 / SUPER-CHIP (program 6), at full speed.
- **Native 2600-style games**: the Placard is far faster than a 2600 when
  it runs its own code (the side-scroller and ray caster already run at
  60 frames a second).  Remakes of 2600 classics written in Placard code,
  or a "fantasy console" (a small sprite and tile engine in the library
  plus a game file format loaded from SD), give the same games at full
  speed and in color.

## Order

1. FAT write and the program file format: done (2026-10-26).
2. DOS with the SD loader and boot choice: done (2026-10-26); moved to the
   card the same day.
3. BASIC in the ROM: done (2026-10-26).
4. Monitor (MON.PLC), text editor.
5. Assembler (the machine is then self-hosting).
6. CHIP-8 / SUPER-CHIP.
7. CP/M (8080).
8. Later: a 6502 core with an Apple 1 or KIM-1 around it, then maybe a
   ZX81, TRS-80 or VIC-20; native games or a fantasy console engine.

Each program gets a Python model and a `placard_sim.py` test like the
library and the demos.  The 32K image ([ROM.md](../architecture/ROM.md#the-32k-image))
holds the loader, BASIC and the FAT writer in x8000-xBFFF; the rest are
programs on the card.
