tocksin/placard/docs/software/LIBRARY.md

# Standard library

`src/scripts/placard_lib.asm` is a library of subroutines for Placard
programs, with a standard way to call them, a software stack, and a zero
page map that every program shares.  `src/scripts/lib_demo.asm` is a short
example program that uses it, and `src/scripts/test_lib.py` tests every
routine in the simulator.

Date: 11/11/2026

| File | What it is |
|---|---|
| `src/scripts/placard_lib.asm` | The routines.  Each has a header with its inputs, outputs, changed registers and clocks |
| `src/scripts/zeropage.asm` | The zero page variable assignments (included by the library) |
| `src/scripts/lib_font.asm` | 8x8 font, generated by `gen_lib_font.py` |
| `src/scripts/lib_demo.asm` | Example program (`build\lib_demo.bat` loads it on the board) |
| `src/scripts/test_lib.py` | Tests every routine against a Python model and measures its clocks |
| `src/scripts/rom_lib.asm` | The library and font alone, for the ROM image (`rom_lib.hex`) |

lib_demo in the simulator

## Using the library

```
#include "placard.asm"
#include "placard_lib.asm"      ; includes zeropage.asm and lib_font.asm

count = 0x20                    ; program variables: zero page x20-x8F

#addr 0x6000                    ; programs run in place from the ROM
main:
    ld   STACK_TOP, ac          ; set up the stack before anything else
    ld   ac, [SP]
    ...
```

The library is one block at the top of the ROM, just under the boot loader,
and runs in place.  The most used parts are highest:

| ROM address | Part | Constant | Source |
|---|---|---|---|
| xFB00-xFBFF | Jump table | `LIB_JT` | `placard_lib.asm` |
| xF400-xFAFF | Core routines | `LIB_CODE` | `placard_lib.asm` |
| xEC00-xF3FF | 8x8 font | `LIB_FONT` | `lib_font.asm` |
| xDC00-xEBFF | I/O drivers | `IO_CODE` | `placard_io.asm` |
| xD700-xDBFF | Sound driver | `SND_CODE` | `placard_snd.asm` |
| xD500-xD6FF | Line input, mouse pointer | `INPUT_CODE` | `placard_input.asm` |
| xC700-xD4FF | FAT file reader | `FS_CODE` | `placard_fs.asm` |
| xC600-xC6FF | Expansion slot helpers, then `con_dec16` in the page's free end | `SLOT_CODE` | `placard_slot.asm`, `lib_dec16.asm` |
| xC500-xC5FF | Menu hook | `MENU_CODE` | `placard_menu.asm` |
| xC000-xC4FF | PS/2 driver: keyboard decoding, the turns, `ps2_pause`, `wait_frames_io`; the mouse routines, `ps2_tx`/`ps2_rx`, `ps2_poll`, `ps2_cmd` and `kbd_lights` sit in free ends of I/O pages 1 and B-E; xC200-xC217 stay free (the bring-up ROM's marker) | `PS2_CODE` | `placard_ps2.asm` |
| RAM x1F00-x1FFF | Code that reads the video RAM (end of `plot1`, `con_scroll`), `lib_far` at x1FA0 (`LIB_FAR`) and `memset`'s loop (`ms_run`) | `LIB_RAM` | `placard_lib.asm` |

`placard_lib.asm` sets every constant and includes the other files.  These
are standard places that every program shares, so keep them.  The library
runs in sections 6 and 7, so they must read the ROM whenever a program
calls it (they do in map 05).  The code that reads the video RAM maps
sections 3-7 to RAM, so it can't run from there: it is assembled at
`LIB_RAM`, x1F00-x1FFF, and the boot loader copies it from the ROM into the
RAM before anything else.  Programs must leave RAM x1F00-x1FFF alone.

A program runs in place from ROM x6000-xBFFF (entry at x6000) and may put
more code and tables at ROM x2000-x3FFF (the 64K development image), or is
a `.PLC` file on the SD card that the ROM's loader (for the DOS) loads into RAM x0100-x3FFF
([DOS.md](DOS.md#program-files-plc)); the library is the same for both.  The boot loader maps the zero
page and x4000-x5FFF to RAM (map = 05, also in `MAP_SHADOW`) and jumps to
x6000.  Program variables and buffers go in RAM: the zero page x20-x8F,
x0100-x1EFF, x4000-x4CFF (x4D00-x4FFF if the program does not use the
FAT reader), x5400-x5A1F and x5C00-x5DF2 (the mode bytes are
at x5A20-x5BFF and the audio buffer is x5DF3-x5FFF).  A 2x or 4x screen
frees part of the video area too (see `vid_mode`).  The RAM is random at power-up, so set
variables in code.  The video always reads the RAM; to read the video RAM,
map sections 3-7 to RAM and back (`plot1` and `con_scroll` do this
themselves).  Both customasm and `placard_sim.py` assemble the library to the
same bytes.  See [ROM.md](../architecture/ROM.md).  New programs use the library routines
and the zero page map below.

The simulator's assembler now accepts `#include`, `NAME = value` constants
and `#d "string", 0x00` data, as customasm does, and `#addr` may go back to
a lower address (overlapping bytes are still an error).

## Jump table

`LIB_JT`, xFB00-xFBFF, has one 4-byte entry per public routine
(`ld routine >> 8, y` / `jmp routine`), labelled `jt_<name>`.  Entries are
only ever added at the end, never moved or removed, so code built without
`placard_lib.asm` (a card's boot code, a program loaded from the SD card)
can CALL a routine at its table address and keep working when the library
changes.  A program that includes `placard_lib.asm` may call the routines
directly instead, 4 clocks faster.  64 entries fit; 55 are used:

| Entry | Address | Routines |
|---|---|---|
| 0-24 | xFB00-xFB60 | `lib_leave` `map_set` `frame_poll` `wait_frames` `rand8` `add16` `sub16` `mul8` `div8` `div16` `memset` `memcpy` `vid_clear` `vid_mode` `vid_addr` `plot1` `con_putc` `con_newline` `con_home` `con_clear` `con_puts` `con_hex8` `con_dec8` `con_dec16` `con_scroll` |
| 25-35 | xFB64-xFB8C | `port_init` `kbd_scan` `kbd_getc` `pad_read` `spi_byte` `sd_init` `sd_read` `sd_write` `mouse_init` `mouse_poll` `mouse_cmd` |
| 36-44 | xFB90-xFBB0 | `snd_init` `snd_update` `snd_tone` `snd_note` `snd_beep` `snd_noise` `snd_play` `snd_stop` `snd_busy` |
| 45-53 | xFBB4-xFBD4 | `slot_id` `fs_mount` `fs_root` `fs_next` `fs_open` `fs_read` `fs_load` `con_gets` `mouse_move` |
| 54 | xFBD8 | `menu_poll` |
| 55 | xFBDC | `wait_frames_io` |
| 56 | xFBE0 | `ps2_poll` |

Entry n is at xFB00 + 4n.  A CALL through the table:

```
    ld   LINK_LO, x
    ld   back, [x]
    ld   LINK_HI, x
    ld   back >> 8, [x]
    ld   0xFB, y                ; jt_con_putc, entry 16
    jmp  0x40
back:
```

## Calling convention

There is no call instruction and no hardware stack.  A call puts the return
address in the zero page bytes `LINK_LO` / `LINK_HI` and jumps; the routine
returns with an indirect jump through them.  Every call needs its own return
label.

**CALL** (6 instructions, 12 bytes, 18 clocks; keeps AC, changes X and Y)

```
    ld   LINK_LO, x
    ld   back, [x]              ; return address low byte
    ld   LINK_HI, x
    ld   back >> 8, [x]         ; return address high byte
    ld   routine >> 8, y
    jmp  routine
back:
```

**RETURN** from a leaf routine (2 instructions, 8 clocks; keeps AC and X)

```
    ld   [LINK_HI], y
    jmp  [LINK_LO]
```

- Arguments go in **AC** and **R0-R7**.  Results come back in **AC**, **X**
  and **R0-R7**.  **Y** can never carry a result, because the return jump
  loads it.
- **R0-R7** belong to the caller.  A routine changes only the R registers
  its table entry lists.
- **T0-T7** are scratch.  Any library routine may change any of them, so a
  value kept in a T register does not survive a call.
- A 16-bit value in two R registers is written high:low, so `R1:R0` means
  R0 is the low byte.
- A **tail call** (jumping to another routine as the last step, without
  CALL) passes the caller's LINK on, so the other routine returns straight
  to the caller.  `con_clear` and `con_newline` do this.

## Software stack

The stack is the top of the zero page, xC0-xFF (64 bytes).  `SP` holds the
address of the next free byte, and the stack grows down from xFF.  It uses
the `[0,X]` address mode, so it never touches Y.

**PUSH AC** (6 instructions, 21 clocks; keeps AC, changes X)

```
    ld   [SP], x
    ld   ac, [x]
    ld   [SP], ac
    dec
    ld   ac, [SP]
    ld   [x], ac
```

**POP AC** (5 instructions, 16 clocks; changes X).  The value is the last
thing loaded into AC, so `beq` / `blt` can test it straight away.

```
    ld   [SP], ac
    inc
    ld   ac, [SP]
    ld   ac, x
    ld   [x], ac
```

X can't be read (it is not a source, CPU.md "Source mode"), so to push a
value that is in X, push it from wherever X was loaded from.  Nothing checks
for overflow: pushing more than 64 bytes runs down into the program
variables.

### Reading X

X is a destination and an address register only.  Code that needs the
value back keeps it somewhere it can read:

- **Loops**: count in AC and copy it to X each pass (`ld ac, x`), or let
  the ALU add the base on the way (`add base, x` makes X = AC + base).
  A store of an immediate (`ld 0xFF, [y,x]`) or a same-address copy
  (`ld [y,x], [y,x]`) leaves AC free for the count.
- **X loaded from memory** (`ld [p], x`): read the same byte into AC
  (`ld [p], ac`) instead of copying X.
- **Counts that AC can't hold**: keep them in the zero page and reload X
  from there (`ld [i], x`).
- **Counting down to 0**: `sub 1, ac` then `bcc loop` stops after AC = 0
  (the borrow sets the carry).

### Routines that call other routines

A CALL overwrites LINK, so a routine that makes calls (not a leaf) saves its
own return address on the stack when it starts, with **PUSH_LINK**, and
returns by jumping to **lib_leave**, which pops it.  Both keep AC, so AC can
carry an argument in and a result out.

**PUSH_LINK** (12 instructions, 42 clocks; keeps AC, changes X, uses 2
stack bytes)

```
    ld   ac, [SAVE_AC]
    ld   [SP], x
    ld   [LINK_HI], ac
    ld   ac, [x]
    ld   [SP], ac
    dec
    ld   ac, x
    dec
    ld   ac, [SP]
    ld   [LINK_LO], ac
    ld   ac, [x]
    ld   [SAVE_AC], ac
```

**LEAVE** (49 clocks with lib_leave; keeps AC, changes X and Y)

```
    ld   lib_leave >> 8, y
    jmp  lib_leave
```

Everything the routine pushed must be popped before LEAVE.  A template:

```
print_twice:                    ; AC = character, printed twice
    (PUSH_LINK)
    (CALL con_putc)             ; con_putc keeps AC
    (CALL con_putc)
    (LEAVE)
```

`con_puts`, `con_hex8`, `con_dec8` and `con_dec16` in the library are
complete examples.

## Zero page map

`zeropage.asm` defines these names.  Program variables go in x20-x8F.

| Address | Name | Used by | Use |
|---|---|---|-----|
| 00-03 | | program | Reset code: `ld main >> 8, y` / `jmp main` |
| 04 | `LINK_LO` | call | Return address low byte |
| 05 | `LINK_HI` | call | Return address high byte |
| 06 | `SP` | stack | Software stack pointer, next free byte |
| 07 | `MAP_SHADOW` | map_set, plot1, con_scroll | Copy of the write-only ROM/RAM map register (the boot sets it to 05 for a ROM program) |
| 08 | `FRAME_LO` | frame_poll, wait_frames | Frame counter low byte |
| 09 | `FRAME_HI` | frame_poll, wait_frames | Frame counter high byte |
| 0A | `LINE_LAST` | frame_poll, wait_frames | Last line read value |
| 0B | `RAND_LO` | rand8 | Random generator state low byte |
| 0C | `RAND_HI` | rand8 | Random generator state high byte |
| 0D | `CUR_COL` | console | Cursor byte column, 0-79 |
| 0E | `CUR_ROW` | console | Cursor text row, 0-59 |
| 0F | `SAVE_AC` | stack | AC parked by PUSH_LINK and lib_leave |
| 10-17 | `R0`-`R7` | caller | Arguments and results |
| 18-1F | `T0`-`T7` | library | Scratch, changed by any routine |
| 20-8F | `USER_ZP` | program | 112 bytes for the program's own variables |
| 90-9E | `SND_*` | sound driver | Sound state ([SOUND.md](../sound/SOUND.md#software)); free if the program never calls `snd_*` |
| 9F | `SND_LASTF` | sound driver | Frames counted at the last `snd_update` (bit 7: a whole lap being written) |
| A0-BF | `IO_ZP` | I/O drivers | Keyboard state and buffer, SD and mouse state, driver scratch ([IO.md](../architecture/IO.md#zero-page)) |
| C0-FF | `STACK_LOW`-`STACK_TOP` | stack | Software stack, grows down from FF |

Section 0 (x0000-x1FFF) must read from RAM for the zero page to work.

## Routines

Clocks are for the routine and its RETURN, without the 18-clock CALL, as
`test_lib.py` measured them.  They leave out video stalls (the CPU loses 1
clock in 8 during active video).  At 25.175 MHz, 25,175 clocks is 1 ms.
"Changes" lists everything a routine may change besides LINK and SAVE_AC;
AC is listed when it does not come back as a result.

### Stack

| Routine | In | Out | Changes | Clocks |
|---|----|-----|---|---|
| `lib_leave` | Return address on the stack (from PUSH_LINK).  Jump to it, don't CALL it | AC kept | X, Y, SP + 2 | 49 with the jump |

### Arithmetic

All of them use the carry flag (`bcs`, `bcc`, see [Idioms](#idioms)).
`add16` and `sub16` do not use T0-T2.

| Routine | In | Out | Changes | Clocks |
|---|----|-----|---|---|
| `add16` | R1:R0 = a, R3:R2 = b | R1:R0 = a + b (mod 65536), AC = R1 | - | 36-40 |
| `sub16` | R1:R0 = a, R3:R2 = b | R1:R0 = a - b (mod 65536), AC = R1 | - | 36-40 |
| `mul8` | R0 = a, R1 = b | R3:R2 = a × b, AC = R3 | T0 | 62-164, 123 on average (two table look-ups; the longer times are for a + b over 255) |
| `div8` | R0 = dividend, R1 = divisor | AC = quotient, X = remainder | T0-T3 | about 580-790 |
| `div16` | R1:R0 = dividend, R2 = divisor | R1:R0 = quotient, AC = X = remainder | T1-T3 | about 1300-1890; about 680-890 for a dividend under 256 (8 steps instead of 16) |
| `rand8` | RAND_HI:RAND_LO = state (seed it once, not 0) | AC = random byte | T0, state | 73-93 |

All are unsigned.  A divisor of 0 gives a quotient of all ones (00FF from
`div16` for a dividend under 256) and the dividend as the remainder.
`mul8` is a quarter-square multiply, as the 6502 machines did it: a × b =
f(a + b) - f(|a - b|) with f(n) = n² / 4 from two 256-byte tables in the
boot loader's free pages (`SQ_LO` xFF00, `SQ_HI` xFC00; `lib_sqtab.asm`,
made by `gen_lib_sqtab.py`, included by `rom_boot.asm`).  `rand8` is xorshift16 (`x ^= x << 7; x ^= x >> 9;
x ^= x << 8`), which runs through all 65,535 non-zero states.

### Memory

| Routine | In | Out | Changes | Clocks |
|---|----|-----|---|---|
| `memset` | AC = value, R1:R0 = address, R2 = count (0 = 256) | R1:R0 = end address, R2 = 0 | X, Y, T0, T1 | about 95 + 14 per byte (3,735 for 256; about 60 more across a page end) |
| `memcpy` | R1:R0 = source, R3:R2 = destination, R4 = count (0 = 256) | R1:R0, R3:R2 advanced, R4 = 0 | AC, X, Y | 9 + 64 per byte |

`memset`'s loop is four instructions in `LIB_RAM` (`ms_run`), where
`memset` writes the value and the offset into the loop's own operands
(self-modifying code, which a ROM routine can't do); it fills each run
from its last byte down, and is slower than the old loop only for 1 to 3
bytes.  `memcpy` copies first byte first, so an overlap is safe only when the
destination is below the source.  For more than 256 bytes, call again: the
pointers already point at the next block.

### Video and system

| Routine | In | Out | Changes | Clocks |
|---|----|-----|---|---|
| `vid_addr` | AC = byte column 0-79, R3:R2 = row 0-479 | AC = address high byte, X = low byte, for the row's own line repeat | T0, T1, T4 | 72-76 (1x), 85-89 (2x), 105-109 (4x) |
| `vid_clear` | AC = mode byte: bits 1:0 = 1, 2, 4, 8 bpp (0-3), bits 3:2 = 1x, 2x, 4x (0-2), bits 6:4 = R, G, B tint, bit 7 = blank | x6000-xFFFF = 0, every mode byte = AC | AC, X, Y, T0, T1 | 505,794 (20.1 ms) |
| `vid_mode` | AC = mode byte | Every row's mode byte = AC, pixels kept | AC, X, Y, T0 | 11,061 |
| `plot1` | R1:R0 = x 0-639, R3:R2 = y 0-479, AC = 0 clears, else sets | One pixel of a 1 bpp row (1x, 2x or 4x) | AC, X, Y, T0-T6 | 223-256 |
| `map_set` | AC = map (bit n = 1: section n reads RAM) | Map register and MAP_SHADOW = AC | Y | 18 |
| `frame_poll` | | AC = line read (V9:V2, 124-255), FRAME + 1 when a new frame started, LINE_LAST = AC | X, Y, T0 | 39-53 |
| `wait_frames` | AC = frames 1-255 (0 = 256) | FRAME + AC | AC, X, Y, T0, T1 | Until the AC-th new frame starts |
| `wait_frames_io` | AC = frames 1-255 (0 = 256) | as `wait_frames` | AC, X, Y, T0-T7, IO_T0-IO_T3, IO_TMP | `wait_frames`, taking the mouse's and a PS/2 keyboard's bytes from the receiver while it waits ([IO.md](../architecture/IO.md#turns-who-has-the-line)) |
| `ps2_poll` | - | - | AC, X, Y, T0-T6, IO_T0-IO_T3, IO_TMP | takes what the PS/2 devices sent (keys into the buffer, mouse packets into `mouse_poll`'s sum) and gives the line to the right device; for a program that polls more often than once a frame, or has no `kbd_scan` call; about 150 clocks with nothing in |

- After `vid_addr`, `ld ac, y` and then `ld [y,x], ac` or `ld ac, [y,x]`
  read or write the byte.
- Row r's mode byte is at x5A20 + r (x5A20-x5BFF), so a program can give
  different rows different modes.  The video circuit reads it from the RAM in
  horizontal blanking, before the row's pixels, so it takes no screen space.
  `vid_addr` and `plot1` read it too, so section 2 must read RAM (the boot
  sets map = 05).
- Bits 3:2 of the mode byte are the line repeat: in 2x (01) each byte shows
  on two lines and in 4x (10) on four, and the row's bytes move within the
  byte column (see [VIDEO.md](../video/VIDEO.md#line-repeat)).  Use `vid_addr` rather
  than x6020 + column × 512 + row for such rows.  Give both rows of a 2x
  pair (all four of a 4x group) the same repeat bits.  A full 2x screen
  leaves the even video pages x60, x62 ... xFE free (20 KB), a full 4x
  screen x6000-x617F, x6200-x637F ... (30 KB).  1x rows 0-223 never share a
  byte with 2x or 4x rows.
- Bits 6:4 of the mode byte tint the row (red, green, blue: about +0.2 V on
  that channel, black pixels included) and bit 7 blanks it (black, and no
  pixel reads, so the CPU is not stalled on those lines).  The library
  routines keep them as given: `vid_clear` and `vid_mode` copy the whole
  byte, and `vid_addr` and `plot1` look at bits 3:2 only.  Write a row's
  mode byte (x5A20 + r) to tint or blank just that row; blanking every row
  while computing gives the CPU about 10 % more clocks per frame
  ([VIDEO.md](../video/VIDEO.md#blank-line)).
- `plot1` became slower when it learned the line repeat (it calls
  `vid_addr`, 148-159 clocks before).  The text console still assumes 1x
  rows.
- `plot1`'s x = 0 is the first visible pixel (byte column 0, bit 0).
- `plot1` and `con_scroll` read the video RAM, so they write the map with
  `MAP_SHADOW` or F8 (sections 3-7 read RAM) for the read and write
  `MAP_SHADOW` back before they return.  `MAP_SHADOW` must hold the map
  (the boot sets it).
- `frame_poll` must run at least once per frame (16.8 ms) or it misses
  frames.  Elapsed time is FRAME × 16.8 ms plus the line value for finer
  detail (4 lines, 128 µs per step); see the
  [video line read](../../README.md#video-line-read).
- `wait_frames` reads the line right away, so the first frame it counts may
  be partly over: the wait is between AC - 1 and AC frames.
- `map_set` returns with its next fetch from the caller's section, so that
  section's map bit must not change, or its ROM and RAM must hold the same
  bytes (see the [memory map](../../README.md#memory-map)).

### Text console

An 80 × 60 text screen of 8×8 characters on 1 bpp rows.  The cursor is
`CUR_COL` (byte column 0-79) and `CUR_ROW` (text row 0-59); write those two
bytes to move it.  The font has printable ASCII (20-7E); codes 80-FF print
the same characters in inverse video.  Call `con_clear` (or `con_home`
after setting the modes yourself) before printing.

**Your own font.**  `con_putc` (and so `con_puts`, the number routines and
`con_gets`) takes each character's pixels from the font that `FONT_PG`
(zero page xBF) points at.  The boot and the card loader set it to the
standard font, `LIB_FONT >> 8`.  To use another, put 8 pages somewhere the
program's map reads (RAM x0100-x5FFF for a card program), page k holding
row k (0 = top) of all 256 characters, the same layout as `lib_font.asm`
(`gen_lib_font.py` writes it), and store the first page's high byte:

```
    ld   MY_FONT >> 8, ac
    ld   ac, [FONT_PG]
```

BASIC, SCRAPWRIGHT, the tracker and the text demo draw their own text and
read the font through `FONT_PG` as well.  The loader puts the standard font
back whenever a program starts or ends.

| Routine | In | Out | Changes | Clocks | Stack |
|---|----|-----|---|---|---|
| `con_clear` | | Screen cleared, every row 1 bpp, cursor at 0, 0 | AC, X, Y, T0, T1 | 505,814 (20.1 ms) | |
| `con_home` | | Cursor at column 0, row 0 | X | 20 | |
| `con_putc` | AC = character, 0A = newline | AC kept, cursor moved on | X, Y, T0-T5 | 376 | |
| `con_newline` | | AC kept, cursor at the start of the next row | X, Y, T0-T5 | 39 | |
| `con_scroll` | | AC kept, text moved up one row, bottom row cleared | X, Y, T1-T5 | 1,159,005 (46.0 ms) | |
| `con_puts` | R1:R0 = string ending in a 00 byte | R1:R0 = address of the 00 | AC, X, Y, T0-T5 | about 369 per character | 2 |
| `con_hex8` | AC = value | Two hex digits, AC kept | X, Y, T0-T5 | 859 | 3 |
| `con_dec8` | AC = value 0-255 | Decimal, no leading zeros | AC, X, Y, T0-T7 | 570-1527 | 4 |
| `con_dec16` | R1:R0 = value 0-65535 | Decimal, no leading zeros; R1:R0 = 0, R2 = 10 | AC, X, Y, T0-T5 | about 900-4,200 (about 800 a digit) | 2 |

Moving past column 79 wraps to the next row, and moving past row 59 scrolls
the screen up one text row (49 ms) and stays on row 59.  Strings in a
program are written with `#d`:

```
title:
    #d "PLACARD", 0x0A, 0x00
```

### Sound

The sound driver (`placard_snd.asm`) keeps the audio buffer filled with one
sound at a time.  Call `snd_init` once and `snd_update` every frame; the
others only set a sound up.  [SOUND.md](../sound/SOUND.md#software) has the details.

| Routine | In | Out | Changes | Clocks |
|---|----|-----|---|---|
| `snd_init` | | Buffer = 80h, no sound | AC, X, Y | about 6,300 |
| `snd_update` | | Samples written up to the line playing | AC, X, Y, T0-T3 | 18k-42k a frame while a sound plays, about 90 when silent |
| `snd_tone` | R1:R0 = step (Hz x 1.0413), AC = volume 0-127, R2 = frames (0 = until stopped), R3 = fade per frame | | AC | about 110 |
| `snd_note` | AC = MIDI note 0-127 (69 = A 440) | R1:R0 = step for `snd_tone` | AC, X | about 50 |
| `snd_beep` | AC = MIDI note | A 12-frame note that fades | AC, X, Y | about 180 |
| `snd_noise` | AC = volume, R0 = rate 1-128, R2 = frames, R3 = fade | | AC | about 110 |
| `snd_play` | R1:R0 = samples, R3:R2 = count, AC = rate 1-128 (128 = 31.5 kHz) | | AC | about 90 |
| `snd_stop` | | Silent within a frame | AC | 20 |
| `snd_busy` | | AC = 0 when silent | | 17 |

### Calls from a program that maps every section to RAM

A program that keeps code or data above x6000 in the RAM (SCRAPWRIGHT and
the tracker run with the map at FF) can't see the ROM, so it can't call the
library directly.  `lib_far`, at the fixed address `LIB_FAR` (x1FA0, in
`LIB_RAM`, so it is there under any map), makes the call for it: it sets
the map to `MAP_SHADOW` (07 or 05: set it once at the start), calls the
routine, sets the map back to FF and returns to the caller.  The program
has one small stub per routine, which writes the routine's address into
`lib_far` and jumps to it; the program CALLs the stub as if it were the
routine:

```
l_mul8:                         ; CALL l_mul8 as if it were mul8
    ld   LF_HI >> 8, y
    ld   LF_HI & 0xFF, x
    ld   mul8 >> 8, [y,x]
    ld   LF_LO & 0xFF, x
    ld   mul8 & 0xFF, [y,x]
    ld   LIB_FAR >> 8, y
    jmp  LIB_FAR
```

| Routine | In | Out | Changes | Clocks |
|---|----|-----|---|---|
| `lib_far` | The stub's CALL (LINK), the routine's address (written by the stub), the routine's AC and R0-R7, `MAP_SHADOW` = the library's map | The routine's AC, R0-R7 and carry; the map FF | X, Y, LINK, SAVE_AC, what the routine changes (X does not come back) | 95 more than calling the routine directly |

The stub (14 bytes) runs under any map, uses no stack, and keeps every T
register the routine keeps; a stub that wraps the call in PUSH_LINK, a
map write, CALL, a map write and LEAVE is about 48 bytes and 129 clocks.
`lib_far` is not re-entrant (no library routine calls back into a
program).

### Expansion cards

| Routine | In | Out | Changes | Clocks |
|---|----|-----|---|---|
| `slot_id` | AC = slot 1-4 | AC = card ID (0 = no card or no "PLC" header), R1:R0 = the slot's base address | X, Y | about 110 |

The boot loader runs a card's boot code before the program starts; see
[EXPANSION.md](../architecture/EXPANSION.md#boot-code-on-a-card).

### SD card files (FAT16 and FAT32)

`placard_fs.asm` reads files from an SD card formatted by a PC (FAT16 or
FAT32, with or without a partition table; short 8.3 names; read only).
Call `sd_init` and then `fs_mount`.  [IO.md](../architecture/IO.md#files-on-the-sd-card)
has the details.

| Routine | In | Out |
|---|----|-----|
| `fs_mount` | | AC = 0, the root is the current folder |
| `fs_root` | | AC = 0, the root is the current folder |
| `fs_next` | | AC = 0 and `FS_ENTRY` = the next entry of the current folder, 1 at the end |
| `fs_open` | R1:R0 = name ending in 00 ("GAME.BIN", "GAMES", "..") | AC = 0: a file is open (`FS_REM` = its size) or a folder is the current folder |
| `fs_read` | R5:R4 = 512-byte buffer | AC = 0 and R5:R4 + 512, 1 at the end of the file |
| `fs_load` | R1:R0 = name, R5:R4 = load address | AC = 0 when loaded |

Errors in AC: 1 end, 2 not found, 4 and 5 SD read errors, 8 not mounted,
9 no FAT file system, 10 FAT12.  They change R0-R5, T0-T7 and the I/O
zero page scratch.  A sector takes about 160,000 clocks (75 KB/s).

Writing (`fs_create`, `fs_write`, `fs_close`, `fs_delete`, `fs_save`) is
not in the library: it is part of the 32K image, reached through the
vectors at x8010-x8020 ([DOS.md](DOS.md#the-fat-writer)).

### Line input and mouse pointer

| Routine | In | Out | Changes | Clocks |
|---|----|-----|---|---|
| `con_gets` | R1:R0 = buffer, R2 = most characters (1-255) | AC = length, the line and a 00 in the buffer; Backspace works, Enter ends | R3, X, Y, T0-T7, I/O scratch | waits for keys |
| `mouse_move` | R1:R0 = X, R3:R2 = Y, after `mouse_poll` returns 1 | X and Y moved by the packet, kept to 0-639, 0-479 | AC | 88-138 |

### Demo menu

| Routine | In | Out | Changes | Clocks |
|---|----|-----|---|---|
| `menu_poll` | call about once per frame, after `frame_poll` | returns, or never returns when Esc is down or the program's time is up under the DOS or the menu ([MENU.md](MENU.md)) | AC, X, Y, T0; when `kbd_scan` has not run this frame, also as `ps2_poll` | 15 without the menu block, about 75 with it, plus `ps2_poll` (about 150) when the program doesn't scan the keyboard itself |

## Idioms

Branches test AC (`blt` AC < 0, `bne`, `beq`, `ble` AC <= 0) or the carry
flag (`bcs`, `bcc`).  There is no `bgt` or `bge`: branch the other way with
`ble` or `blt`.

**Carry flag.**  Every ADD or SUB with an AC, X or Y destination (`inc`,
`dec` and `shl` too) sets it: the carry out of an add, the borrow out of a
subtract (1 when a < b, unsigned), the bit shifted out by `shl`.  Every
other instruction keeps it, stores and ADD/SUB to RAM included, so it can be
tested a few instructions later (CPU.md, "Carry flag").

**Unsigned compare a ≥ b** (both 0-255):

```
    ld   [a], ac
    sub  [b], ac
    bcc  a_ge_b                 ; no borrow
```

**AC ≥ 0 / AC > 0**: `blt` or `ble` round the code that runs when it is.

**Bit 7 into the carry**: `shl` (it also shifts AC).  `div8` and `div16`
shift a byte left and test the bit that fell out with `bcc`.

**16-bit add** (how `add16` does it): add the low bytes, then add the
carry into the high byte with `inc` before adding the other high byte
(`sub16` is the same with `sub` and `dec`):

```
    ld   [R0], ac
    add  [R2], ac
    ld   ac, [R0]
    ld   [R1], ac               ; ld and stores keep the carry
    bcc  no_carry
    inc
no_carry:
    add  [R3], ac
    ld   ac, [R1]
```

The `inc` changes the carry, so after it the flag is not the carry out of
the whole sum.  For more bytes, `inc` sets the carry only when the byte was
FF (and is then 00, so the add after it cannot carry): `fs_add` in
`placard_fs.asm` adds 32 bits that way.

**Branches stay in their page.**  A conditional branch changes only the low
byte of PC, so a routine's branches and their targets must be in one
256-byte page; `jmp` (with Y) crosses pages.  `placard_sim.py` reports a
branch that leaves its page; customasm does not.

## Testing

```
python3 test_lib.py             600 random cases per routine, about 20 s
python3 test_lib.py --quick     60 cases
python3 test_lib.py -k div      only the tests whose name contains "div"
```

Each routine is called through the CALL sequence above with its inputs set
directly in memory, and its results are compared with a Python model.  The
test also fails if a routine changes any zero page byte its documentation
does not list, or leaves SP moved.  The simulator does not model the video
line read, so the test supplies it: a V counter that steps every 800 clocks
through 525 lines.

## Not in the library yet

The keyboard, SNES pad, SD card and mouse drivers are in
`placard_io.asm` at `IO_CODE`, included by `placard_lib.asm`, with the
same calling convention; [IO.md](../architecture/IO.md) lists them and `test_io.py` tests
them.  Pixel routines for 2, 4 and 8 bpp rows, line drawing and writing
files to the SD card are good next additions.  The library has no free
pages left (the PS/2 keyboard driver takes xC000-xC4FF): new
code goes below xC000 (taking ROM from the program area) or into the free
ends of pages, and new public routines get the next jump table entries.  `test_snd.py`, `test_fs.py` and `test_slots.py` test the
sound driver, the FAT reader and the slot helpers.
