tocksin/placard/docs/timing/TIMING.md

# Timing at 25.175 MHz

Date: 2026-11-03

This is the worst-case timing of the Placard as it is built: the PLD
sources in `src/pld`, the parts in [CHIPS.md](../architecture/CHIPS.md),
and the routed main board `kicad/placard.kicad_pcb` with the 64K
cartridge `kicad/cartridge_64k`.  Every path is given twice: from the
datasheets alone, and on the board with its trace delays and clock skew.

The documents next to this one go into single paths in more detail:
[FETCH_TIMING.md](FETCH_TIMING.md) (instruction fetch and the address
muxes), [WE_TIMING.md](WE_TIMING.md) (the RAM write strobe),
[ALU_TIMING.md](ALU_TIMING.md) (ALU, wait clock, carry),
[VIDEO_TIMING.md](VIDEO_TIMING.md) (video read and pixel pipeline) and
[XY_TIMING.md](XY_TIMING.md) (X/Y-indexed addresses).

## Summary

From the datasheets, every path meets 25.175 MHz with a 50 % clock.
Since I/O decode PLD revision 07 the I/O selects come straight from the
address and no I/O read waits for STALL ([I/O reads](#io-reads)), so a
plain 15 ns SRAM on an expansion card meets timing; and since Sync PLD
revision 11 /WE falls with CLK, which closed the zero-page store start on
the board ([Memory writes](#memory-writes)).

On the routed board (main 2026-11-03: router v4 with the track-length
budgets of `src/scripts/router_v4/budgets.py`, the memory control PLD on
CLK_E (fix 4) and a 505.9 mm CLK_E lead), every path meets 25.175 MHz
with a 50 % clock, and the setup paths keep at least 1.8 ns.  The tightest:

| Path | Datasheet | Board |
|---|---:|---:|
| RAM address hold after /WE (end of write) | +0.5 | +0.75 |
| Zero-page read `[0,D]` into D | +3.4 | +1.81 |
| Write pulse, tWP | +2.4 | +2.24 |
| STALL to the State PLD strobes and an F377 /E | +7.2 | +2.43 |
| Fetch from the cartridge ROM through /ROM_OE | +1.9 | +2.56 |
| Fetch from RAM through /RAM_OE | +1.9 | +3.20 |
| Expansion slot read, plain 15 ns SRAM card (worst slot) | +8.7 | +3.41 |
| Port select hold after /WE (port and PS/2 PLDs) | | +0.94 |

Rerun from scratch on 2026-11-03 after the expansion redesign (branch-111):
the 64K cartridge's track lengths were re-measured from
`kicad/cartridge_64k/cartridge_64k.kicad_pcb` (unchanged from
`src/scripts/router_v4/timing/cart_c64.json`; the 32K board is shorter on
every path) and `budgets.py` run on the new main board at a fixed 50 %
clock; the example card is the plain SRAM card of
[EXPANSION.md](../architecture/EXPANSION.md#card-timing), at its fingers.
Every figure above is unchanged by the redesign; the new I/O paths are
under [I/O reads](#io-reads) and [Hold and race checks](#hold-and-race-checks).

The four paths that were short on the earlier board (cartridge ROM fetch,
zero-page read and video read at −1.1, RAM fetch through /OE at −0.2) are
closed: fix 4 moves /OE about 3.7 ns earlier and the budgets kept the data
bus short (DATABUS0 U31 → U22 is now 96 mm, was 819).  The datasheet
column keeps U11 on CLK; with fix 4 the /OE rows gain about 3 ns there too.
These are worst-case figures; typical PLD and SRAM delays are about half
the maximum.  The scripts are listed under [Method](#method); rerun them
after any routing change.

The clock's duty cycle is an open item: the design needs a high half of
about 42 % to 54.6 % from the datasheets ([Clock duty](#clock-duty)), and
the ECS-100A oscillator is only specified to 40/60 %.

## Clock and assumptions

- **Clock**: 25.175 MHz from oscillator X1, T = 39.72 ns.  The high half
  must be between about 42 % and 54.6 % of the period (below), so the
  oscillator needs a 50 % output or one divided down to it.
- **Clock tree**: X1 drives **CLK_E** to the Sync PLD's pin 9 first, then
  at least 420 mm of track (500 mm nominal, about 3 ns) to net tie NT2;
  **CLK**, on the far side of NT2, goes to every other chip, the Sync
  PLD's pin 1 included.  The Sync PLD makes /WE from both: it falls with
  CLK and rises on CLK_E, about 3 ns ahead of everything clocked by CLK
  ([WE_TIMING.md](WE_TIMING.md)).
- **Memory control PLD on CLK_E** (schematic 2026-11-02, timing fix 4; on
  the routed board since 2026-11-03, 34.5 mm from X1): U11
  pin 1 moves from CLK to the CLK_E tap next to X1, so /RAM_OE and /ROM_OE
  fall and rise about 3.7 ns earlier.  That gives every read through /OE
  (fetch, cartridge ROM fetch, operand, zero-page, video) its margin back
  and lets the high half reach 53 % with 0.5 ns to spare on the new
  placement (`src/scripts/router_v4/budgets.py U11E=1`).  The earlier /OE high
  leaves the bus to its capacitance and the 10k pull-ups until the
  capture edge, and shortens the memory/F541 overlap at the start of EXEC.
- **Worst case**: datasheet maximum delays and minimum setup times at 0 to
  70 °C.  Hold checks use the datasheet minimums (PLD tPD 3.0, tCO 2.0).
- **PLD pin feedback**: an equation that names another combinational
  output pin costs a second tPD; registered feedback reaches the array
  after tCF (2.5 ns).  Intermediate expressions cost nothing.
- **Board**: track delay 6 ps/mm (FR4, unloaded).  The data bus has about
  19 loads, so it is somewhat slower than that.  Each path is measured from
  the edge at X1 to the edge at the capturing chip, so clock skew is
  included.

## Parts and datasheet figures

| Part | Used for | Figures (ns) |
|---|---|---|
| ATF22V10C-7PX (PDIP-24) | all 20 main-board PLDs and the cartridge loader | tPD 3.0 to 7.5, tCO 2.0 to 5.5 (DIP), tCF 2.5, tS 3.5, tH 0, tEA 7.5 |
| AS7C256C-15PCN | main RAM U31, U32; cartridge SRAMs | tAA 15, tACE 15, tOE 7, tOHZ 7, tOLZ 0, tAS 0, tAW 12, tWP 10, tDW 8, tDH 0, tWR 0 |
| SN74F377AN | D, AC, X, Y, pixel buffer | CLK to Q 4 to 10.5, data setup 2, /E setup 4.5, hold 1 |
| SN74F541N | source drivers U26, U27; line read U29 | A to Y 1.5 to 6, enable 2.5 to 9.5, disable 1.5 to 6.5 |
| CD74ACT273E | ROM/RAM map register | CP to Q 12.3 |

Sources: Atmel ATF22V10C datasheet 0735P (tCO 5.5 is the DIP figure),
Alliance AS7C256C Rev 1.0 (June 2024), TI SN74F377A (SDFS018D) and
SN74F541 (SDFS021A).

**Logic levels**: 74F outputs guarantee 2.5 V high and the AS7C256C needs
2.4 V, so the source F541s drive the RAM with 0.1 V to spare; the series
resistors between them and the data bus carry only input leakage.  The
PLD and SRAM outputs (2.4 V) drive only TTL-level inputs.  No plain 74HC
input sits on the address or data bus.

## The routed board

Clock lengths (mm of track):

| Net | To | mm |
|---|---|---:|
| CLK_E | X1 → U11 memory control, U15 pin 9 (Sync) | 34.5, 117.7 |
| | X1 → NT2 (the delay lead, rule ≥ 420, aim 480 to 540) | 505.9 |
| CLK (past NT2) | U18 D, U13, U15 pin 1 (Sync), U23 | 79, 112, 132, 132 |
| | U21 Y, U17 IR, U22 pixel buffer, U14 | 152, 159, 166, 174 |
| | U3 PC low, U20 X, U1 State, U19 AC, U4 PC high, U2 Branch | 181, 187, 203, 206, 222, 245 |
| | J8 cartridge, J9 to J12 slots | 50; 150, 161, 189, 218 |

Other nets that set the limits:

| Net | From → to | mm |
|---|---|---:|
| /WE | U15 → U31, U32 | 115, 133 |
| PC_ENABLE | U1 → muxes U8, U9, U10, U7 | 51 to 91 |
| PIXEL_ENABLE | U15 → muxes U10, U9, U8, U7; → U2 | 152 to 273; 208 |
| STALL_IN / STALL_OUT | U2 → J8 / J8 → U1, U3, U4 | 198 / 193, 256, 289 |
| DATABUS0 | U31 → U22, U18, U1, U17 | 96, 181, 304, 353 |
| DATABUS0 | J8 → U1 | 296 |
| D5, D6, D7 | U18 → muxes | 137, 165, 182 |
| /RAM_OE, /ROM_OE | U11 → U32, U31 / → J8 | 35, 54 / 71 |
| /CE_HI | U12 → U32, J8 | 43, 87 |

## All paths

Slack in ns.  "Board" is the main board of 2026-11-03 with the 64K
cartridge and a 50 % clock; paths with more than about 8 ns from the
datasheets were not measured on the board.

### Memory reads

A CPU read starts when the clock falls: the memory control PLD gates
/RAM_OE and /ROM_OE with !CLK, so the memories only drive the bus in the
low half of a clock.  A read is therefore limited either by the address
(tAA from the address muxes) or by /OE (clock fall, memory control PLD,
tOE).

| Path | Stages (datasheet) | Datasheet | Board |
|---|---|---:|---:|
| Fetch, address side: PC_ENABLE tCO, mux, tAA, State/IR setup | 5.5 + 7.5 + 15 + 3.5 = 31.5 | +8.2 | +4.1 |
| Fetch after a branch (the PC loads at the same edge) | same | +8.2 | +4.1 |
| Fetch from RAM through /RAM_OE: clock fall, memory control, tOE, setup | 19.9 + 7.5 + 7 + 3.5 = 37.9 | +1.9 | +3.2 |
| Fetch from the cartridge ROM through /ROM_OE | same | +1.9 | +2.6 |
| Operand from RAM into D (LOAD_IMM) | 19.9 + 7.5 + 7 + 2 = 36.4 | +3.4 | +5.1 |
| Operand from the cartridge ROM into D | same | +3.4 | +4.5 |
| X/Y-indexed read after FETCH into D | same | +3.4 | +5.1 |
| Zero-page read `[0,D]` after LOAD_IMM (D register 10.5, mux 7.5, tAA 15, or /OE) | | +3.4 | +1.8 |
| Upper 32K chip: /CE_HI (selects 5.5, I/O decode 7.5), tACE 15, setup 2 | 30.0 | +9.7 | |
| Video read into the pixel buffer: PIXEL_ENABLE tCO, mux, tAA, or /OE | | +3.4 | +6.1 |

### Memory writes

/WE = !CLK_E & !CLK & !RW & !PIXEL_ENABLE (Sync PLD revision 11), so a
write uses the low half of a store's EXEC clock: it starts when CLK
falls and ends about 3 ns before the CPU's clock rises (on CLK_E).

| Check | Datasheet | Board |
|---|---:|---:|
| Zero-page store start: address (D register 10.5 + mux 7.5 = 18) before /WE can fall (T/2 + 3 = 22.9) | +4.9 | +4.2 |
| Zero-page store start: /CE_HI before /WE can fall (13 vs 22.9) | +9.9 | +9.4 |
| Store after a video stall: video address gone before /WE can fall | +9.9 | +7.9 |
| RW settled before CLK falls (IR 5.5 + State 7.5 = 13 vs T/2) | +6.9 | +5.0 |
| End of write: /WE high (7.5 − 3 = 4.5) before the address, /CE_LO, /CE_HI change (2 + 3 = 5) | +0.5 | +0.75 |
| End of write: data held until /WE is high (source F541s off) | +2.0 | +5.0 |
| Write data setup, tDW 8 (source bus valid by 22.5 ns) | +9.2 | +4.8 |
| Write pulse, tWP 10: low half less the CLK_E lead (3) less the spread of the two /WE edges (4.5), 12.4 | +2.4 | +2.2 |
| tAW 12: address by 18 vs /WE high at T at the earliest (T − 12 = 27.7) | +9.7 | |

### CPU control, ALU and branches

| Path | Stages | Datasheet | Board |
|---|---|---:|---:|
| STALL to the State PLD strobes and an F377 /E: PIXEL_ENABLE tCO, Branch STALL, cartridge PLD, State, /E setup | 5.5 + 7.5 + 7.5 + 7.5 + 4.5 = 32.5 | +7.2 | +2.4 |
| STALL to the PC PLDs | 5.5 + 7.5 + 7.5 + 3.5 = 24.0 | +15.7 | +11.9 |
| Single-clock ALU op, source AC after FETCH: IR 5.5, /AC_SEL 7.5, F541 enable 9.5, ALU 7.5, AC setup 2 | 32.0 | +7.7 | +3.6 |
| Single-clock ALU op, source D: /SRC_EN (State 5.5, Branch 7.5), F541 enable 9.5, ALU 7.5, AC setup 2 | 32.0 | +7.7 | |
| ADD/SUB, two clocks (lookahead ALU, 5 levels) | 22.5 + 37.5 + 2 = 62.0 of 79.4 | +17.4 | |
| Carry flag: source bus 22.5, four ALU levels 30, Branch setup 3.5 | 56.0 of 79.4 | +23.4 | |
| Branch decision: IR 5.5, ALU F (PASS A) 7.5, Z 7.5, LOAD_PC_LOW 7.5, PC setup 3.5 | 31.5 | +8.2 | |
| Branch target (AC or D on the source bus) into the PC PLDs | 22.5 + 3.5 = 26.0 | +13.7 | |
| Opcode into X_ENABLE / Y_ENABLE (State PLD, from the data bus) | as the fetch | +8.2 | +4.1 |

### I/O reads

Since I/O decode PLD revision 07 the decode makes the selects straight
from the address: `IOSEL = !PIXEL_ENABLE & !PC_ENABLE & Y_ENABLE &
Y = 0101 00xx`, and /P0, /PORT and /EXP1-/EXP4 are combinational outputs
of U12, valid about 13 ns into the clock.  A read is the select and Q0
low (LOAD_MEM): the line read F541 U29 has /OE1 = /P0 and /OE2 = Q0, the
port and PS/2 PLDs use `PORT & !Q0`, and an expansion card uses /EXPn
and Q0 itself.  None of it waits for STALL.  D still loads with the
State PLD's /LOAD_IMM, which waits for STALL (the STALL row under
[CPU control](#cpu-control-alu-and-branches)).

| Path | Stages | Datasheet | Board |
|---|---|---:|---:|
| Line read (U29): select 13, F541 enable 9.5, D setup 2 | 24.5 | +15.2 | +11.7 |
| Port (U38) or PS/2 (U42) read: select 13, PLD tEA 7.5, D setup 2 | 22.5 | +17.2 | +13.6 |
| Expansion card read, a card within the [card budget](../architecture/EXPANSION.md#card-timing) (select 13, card 16, D setup 2) | 31.0 | +8.7 | +3.4 (worst slot, plain 15 ns SRAM card) |

The board figures are the `io_line_read`, `io_port_read` and `slot_read`
checks of `budgets.py` on the present tracks (U12 inputs from the
register tracks, the select track, the longest data bus track to D).
Revision 06 decoded `RD = IO & !PC_ENABLE & !Q0 & !PIXEL_ENABLE` one PLD
pass later and gave +3.4 (line read), +5.2 and +5.7 (port, PS/2) and
+0.6 (expansion, with a card that had to read ahead through a register).

### Video and the rest

| Path | Stages | Datasheet |
|---|---|---:|
| Pixel buffer /E (Branch PLD /PIX_LD from PIXEL_ENABLE) | 5.5 + 7.5 + 4.5 = 17.5 | +22.2 |
| PIXEL_ENABLE.D: H_VIDEO_ACTIVE tCO, Sync setup | 5.5 + 3.5 = 9.0 | +30.7 |
| H_TC to the V counter | 5.5 + 7.5 + 3.5 = 16.5 | +23.2 |
| Color decoder: pixel buffer 10.5, two levels, settled into a 39.7 ns pixel | 25.5 | no register after it |
| Video address (H, V, audio PLD row bits): changes in clock 0 of a group, read in clock 1 | over a clock | |
| I/O write selects: /PORT, /EXPn and /MAP_WR's P0 at 13 before /WE falls (22.9) | | +9.9 |
| ROM/RAM map write into the very next fetch: /MAP_WR high by T + 12, map CP→Q 12.3, memory control 7.5, tOE 7, setup 3.5 | 42.3 | −2.6 (software rule below) |

**Map write rule**: the instruction straight after a write to the map
register must not be fetched from a section whose map bit that write
changes, unless ROM and RAM hold the same byte there.  The shadow copy
(copy the ROM into the RAM under it, then map it to RAM) is safe, and so
is any instruction between the map write and the first fetch from the
switched section.

### Bus hand-overs

The source F541s and the memories share one data bus
([CPU.md](../architecture/CPU.md), "One data bus").

| Hand-over | Check | Slack |
|---|---|---:|
| End of EXEC: source F541s off (/SRC_EN 13 + disable 6.5 = 19.5) before a read can start (clock fall + 3) | 19.5 vs 22.9 | +3.4 (+2.2 at a 47 % high half) |
| Start of EXEC: the memory stops driving (/OE high by 7.5, tOHZ 7 = 14.5) while the F541s can turn on from about 7.5 ns | overlap up to 7 ns | limited by the series resistors |
| End of a write: data held, /WE high first | above | +2.0 |
| I/O reads: neither memory drives in 5000h-53FFh | | |

### Clock duty

- High half at most **54.6 %**: a fetch through /OE starts at the clock
  fall and has 1.9 ns from the datasheets (on the board +3.2 ns at 50 %
  since fix 4).  The write pulse (tWP) allows up to 55.9 %
  (about 53 % on the board).
- High half at least about **42 %**: the hand-over at the end of EXEC
  (source F541s off by 19.5 ns, a read starts at the clock fall + 3);
  below that the overlap is limited only by the 47 Ω series resistors.
  The zero-page store start allows 37.8 % (about 43 % on the board) and
  RW 32.7 %.
- A 50 % clock meets all of them.  **Open item**: the ECS-100A is
  specified only to 40/60 % symmetry (at 1.4 V), typical 50 ± 3 %.  The
  CTS MXO45 (full-size DIP-14, 5 V, pin-compatible) is specified to
  45/55 % at VDD/2.

## Cartridge loader

The cartridge PLD writes its SRAMs only while it loads them, one address
per 8-clock group, with the CPU held at the PC by STALL_OUT
([WE_TIMING.md](WE_TIMING.md#cartridge-sram-loader)):

| Check | Slack |
|---|---:|
| Address setup to /SR_WE low | +148 |
| Address hold after /SR_WE high | +79.9 |
| tAW 12 | +176 |
| tWP 10 | +26 |
| tDW 8 (EEPROM byte valid by K0 + 178 ns) | +14.6 |

## Hold and race checks

- **Register hold**: the data bus cannot change earlier than about 8 ns
  after an edge (PLD tCO 2 + mux 3 + the RAM's tOH 3), and the ALU result
  no earlier than F377 4 + PLD 3, against the F377's 1 ns data hold and
  the PLD's 0 ns.  The clock skew on the board (past NT2, CLK reaches U18
  after 79 mm and U2 after 245 mm, 1.0 ns apart) is inside that margin;
  U11 on CLK_E only drives /OE.
- **I/O select hold after /WE**: the port and PS/2 PLDs clock on /WE and
  hold their registers while /PORT is high, so /PORT must stay low until
  after /WE rises: +0.94 ns on the board (`port_sel_hold`).  The slot
  selects hold +2.05 ns and the slot data +1.37 ns after /WE.
- **RAM address hold after /WE**: +0.5 from the datasheets, +0.75 on the
  board; it rests on the CLK_E lead (≥ 420 mm of track).
- **Line code register** (CD74HCT377): copies the mode byte from the pixel
  buffer with /E from /MODE_LD in blanking; the pixel buffer holds the
  byte for several clocks around it.

## Method

- Board: `kicad/placard.kicad_pcb` (2026-11-03, PR #238 and #239, then
  the expansion redesign of branch-111) and
  `kicad/cartridge_64k/cartridge_64k.kicad_pcb`.
- Each length is the shortest path along the net's tracks and vias from
  the driving pin to the load pin, at 6 ps/mm
  (`src/scripts/router_v4/tracklen.py`).
- The paths: `U11E=1 FIXED=CLK_E:X1-8:NT2-1 DUTY=0.5,0.5 python budgets.py
  kicad/placard.kicad_pcb out.json` in `src/scripts/router_v4` prints the
  slack of every check on the present tracks ("slack now"); DUTY=0.45,0.53
  gives the worst case over that high-half range.  The I/O reads
  and the expansion slots are checks of the same script (`io_*`,
  `slot_*`, `port_sel_hold`).  The 2026-11-02 scripts
  (`meas.py`, `timing.py`) are in the project files under
  `hardware/routing/timing_2026-11-02/`.
