tocksin/placard/docs/case/CASE.md

# Case

Date: 2026-11-02

This is a concept for the PLACARD case. The case is black powder-coated
aluminium, strong on the bottom and sides, with a clear acrylic top so the
board shows through. Each expansion slot (J9-J12) and the cartridge slot (J8)
has its own removable 3D-printed cover, held on by snap tabs that click through
small slots in the acrylic. A cover that is out parks under the case, upside down: its tabs
click into slots in the floor, right below where it fits on the top. The case
stands on 10 mm feet, so the parked covers clear the desk.

The aluminium is a tray (the floor with the front and right walls) and two
flat plates for the back and left walls. Only the back and left have
connectors that reach through the wall (VGA, audio, power and reset), so the
board drops straight down into the tray. Each plate then slides onto its
connectors from outside and screws to the floor, and the acrylic top holds
the tops of all four walls. Every connector opening is a single clean hole
in one part, and no seam runs through any of them.

There is no built-in keyboard; the computer takes a PS/2 keyboard on J5.

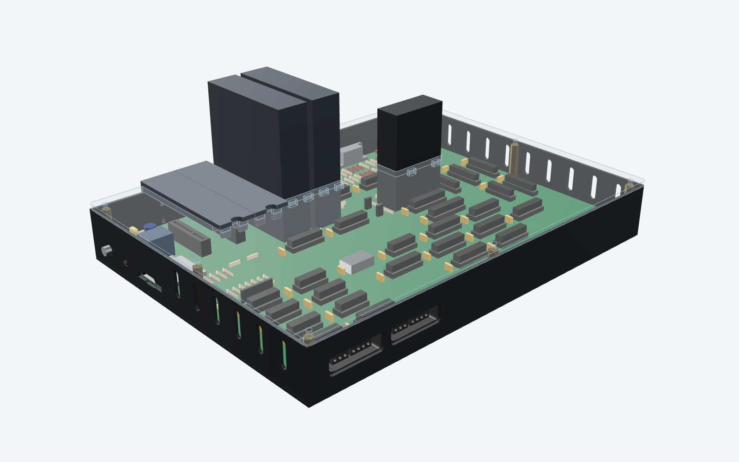
[picture p33: docs/case/case_assembled.png]
Assembled with a 32K cartridge and two cards; their covers are parked underneath


Every cover fitted

Underside: all five covers parked in the floor slots, 10 mm feet, vent slots

Exploded: tray, back and left plates slid out, board on its standoffs, acrylic top, covers

Everything here is made by `src/scripts/gen_case.py` from the board file, so
the cut-outs follow the connectors when they move. The script reads each
wall connector's position from `kicad/placard.kicad_pcb`, and where the
connector's 3D model (`kicad/lib/placard.3dshapes`) meets the wall. The board
file is only read, never written. The files in `case/` and these drawings
were made from the 290 x 215 mm board.

## Size

| | mm | in |
|---|--:|--:|
| Outside, width x depth | 295 x 220 | 11.6 x 8.7 |
| Height, desk to the acrylic top | 50.6 | 1.99 |
| Height of the case itself, without the feet | 40.6 | 1.60 |
| Feet | 10 | 0.39 |

The case is the board plus 0.5 mm all round and the 2 mm walls. Its height is
set by the stacked PS/2 socket J5, which is 25 mm tall; the acrylic top,
lying on the walls, clears it by 2 mm. The feet are as tall as a parked cover (7 mm) plus 3 mm.

Walls (back, left, front, right, with the side vent slots) and a section front to back: a cover in place and the same cover parked under the floor

## Parts

| Part | Qty | Material and finish | Made by |
|---|--:|---|---|
| Tray | 1 | 2.0 mm 5052-H32 aluminium, two bends (inside radius 2 mm, open front-right corner with a relief): the floor, to the case's outside edges, with the front wall (SNES cut-outs) and the right wall up to the acrylic, with vent slots in the floor and 10 in the right wall, 10 small parking slots for the covers' tabs and 14 countersunk M3 holes (8 at the board holes H1-H8 for the floor standoffs' screws, 6 for the plate screws), plus 4 plain 3.4 mm holes at the feet for optional screw-on feet. Black powder coat | Sheet metal service: laser cut, bend, countersink, powder coat |
| Back plate | 1 | 2.0 mm 5052-H32, standing on the floor, with a 14 mm flange bent in along the bottom: USB-C, audio, VGA and PS/2 cut-outs, an M3 screw hole behind each expansion slot (J9-J12) with a parking hole for that slot's cover 12.6 mm below it, 3 plain 3.4 mm screw holes in the flange (loose M3 hex nuts on top), the flange notched round the floor standoffs and J7's pins | Same |
| Left plate | 1 | Same: power switch, reset and SD cut-outs, 6 vent slots, 3 screw holes | Same |
| Acrylic top | 1 | 4 mm clear cast acrylic, 295 x 220 mm, laser cut, with 14 small slots (6.4 x 2.2 mm) for the covers' tabs | Laser cutting service |
| Slot cover | 4 | 3D printed in one piece, PETG (black): plug, cap, two snap tabs, back lip with a dome (`case/slot_cover.stl`) | The builder or kitter prints them |
| Cartridge cover | 1 | Same, sized for J8, four snap tabs (`case/cart_cover.stl`) | Same |
| M3 male-female hex standoff, 6 mm, 6 mm stud | 8 | On the floor under board holes H1-H8, screwed down from below; its stud goes up through the board | |
| M3 female-female hex standoff, 27 mm | 8 | On the 6 mm standoffs' studs, board top to the acrylic top; clamps the board | Ettinger and others sell 1 mm steps; or 25 mm + a 2 mm spacer |
| M3 x 8 button head screw, black or stainless | 8 | Acrylic top | |
| M3 x 6 countersunk screw | 14 | Up through the floor, flush under the case: 8 into the floor standoffs, 6 through the plates' flanges into hex nuts | |
| M3 hex nut, ISO 4032 (5.5 across flats, 2.4 mm) | 6 | On top of the plates' flanges, under the board's edge. The screw goes 2 mm into it, so its tip stays 2 mm under the board; the parts nearest (SW2's and K1's leads, R1/R2, F1) are clear of it | |
| M3 x 6 button head screw, black | 4 | Through the back plate into each expansion card's shell (one per card fitted) | |
| Rubber feet, 16 mm across, 10 mm tall, self-adhesive | 4 | 24 mm in from each corner, clear of the corner standoffs and the parked covers. Each sticks on over the floor's foot hole | Or screw-on feet, see "Screw-on feet" below |

The VGA connector's 4-40 jackscrews pass through the back plate and hold it
to J7 as well.

All three metal parts are powder coated the same stock black, the cheapest
finish (Justin, 2026-10-27). There is no printing or engraving on the case.

STEP models of every part are in `case/`, and the DXF cutting file for the
acrylic top is in `case/dxf/`. The covers print from `case/slot_cover.stl`
(print 4) and `case/cart_cover.stl`, turned cap face down for the bed.
Sheet metal services (Protocase, JLCCNC, PCBWay, Xometry) quote bent parts
from STEP. SendCutSend wants a flat pattern, which their own tool or any CAD
program unfolds from the STEP.

## How it goes together

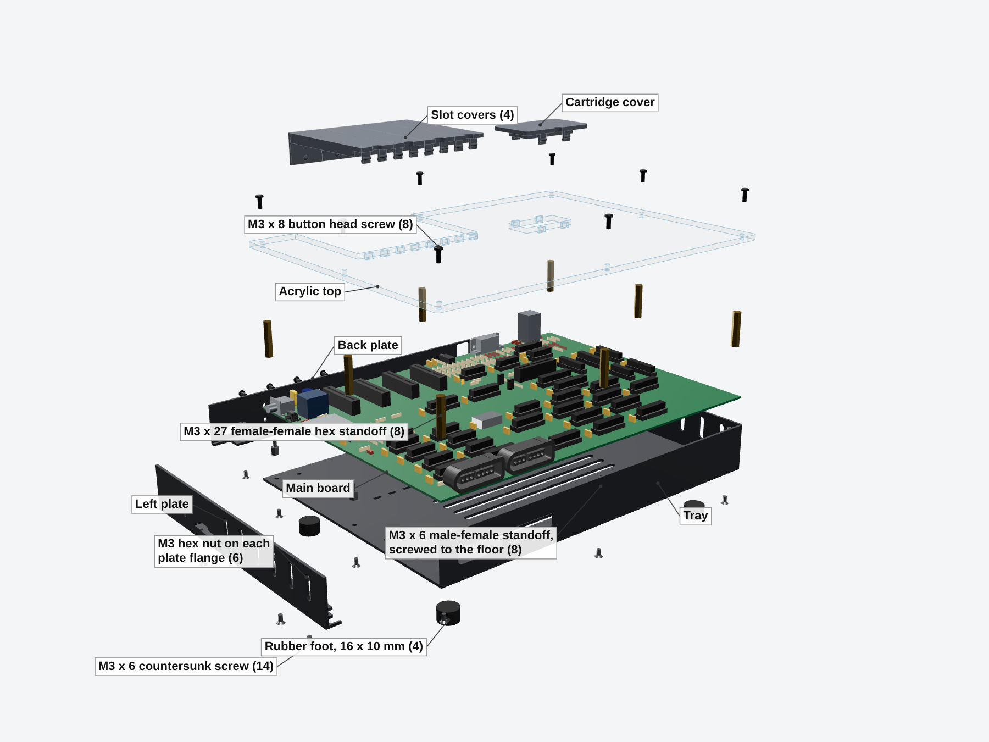
[picture p34: docs/case/case_exploded_hardware.png]
Exploded view with all the case hardware


Exploded view from the back: card screws, plate screws, feet

Each fastener stack, exploded along its axis

The hardware meshes and the stack drawing come from
`src/scripts/case_render/gen_case_hardware.py` (run after `gen_case.py --mesh`;
views `exploded_hw` and `exploded_hw_rear`).

1. The sheet metal service powder coats the tray and plates. There is no
   PEM hardware in any part.
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
