tocksin/placard/docs/case_concept_snap_bends_rear.png

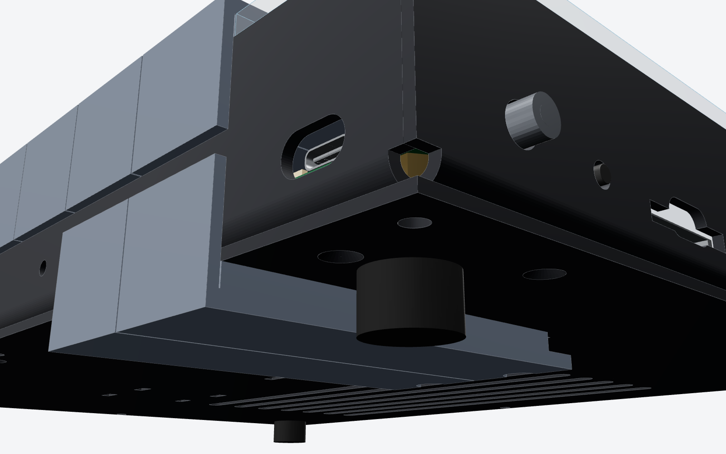
docs/case_concept_snap_bends_rear.png
