tocksin/placard/docs/case_concept_snap_lifted.png

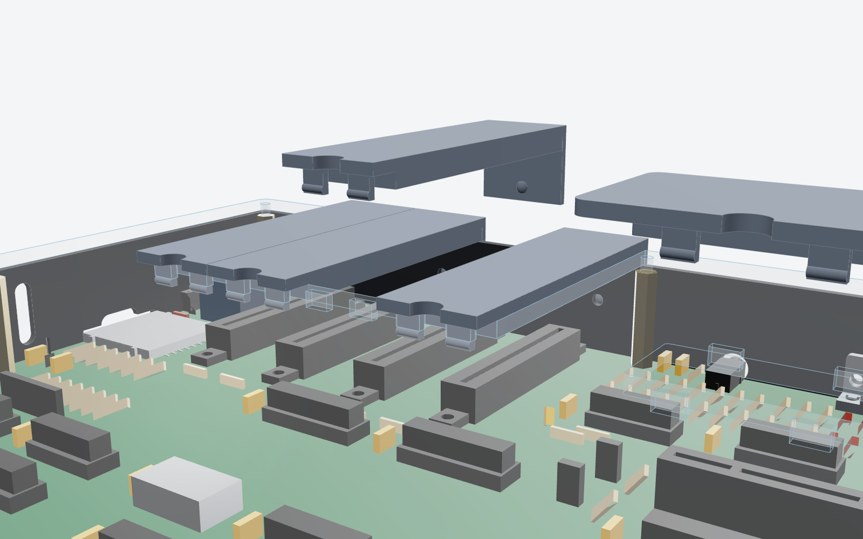
docs/case_concept_snap_lifted.png
