tocksin/placard/docs/case_concept_snap_rear.png

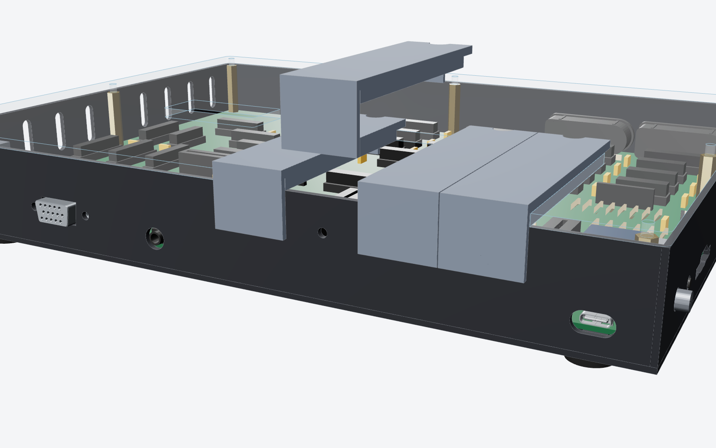
docs/case_concept_snap_rear.png
