tocksin/placard/docs/case_concept_snap_section.png

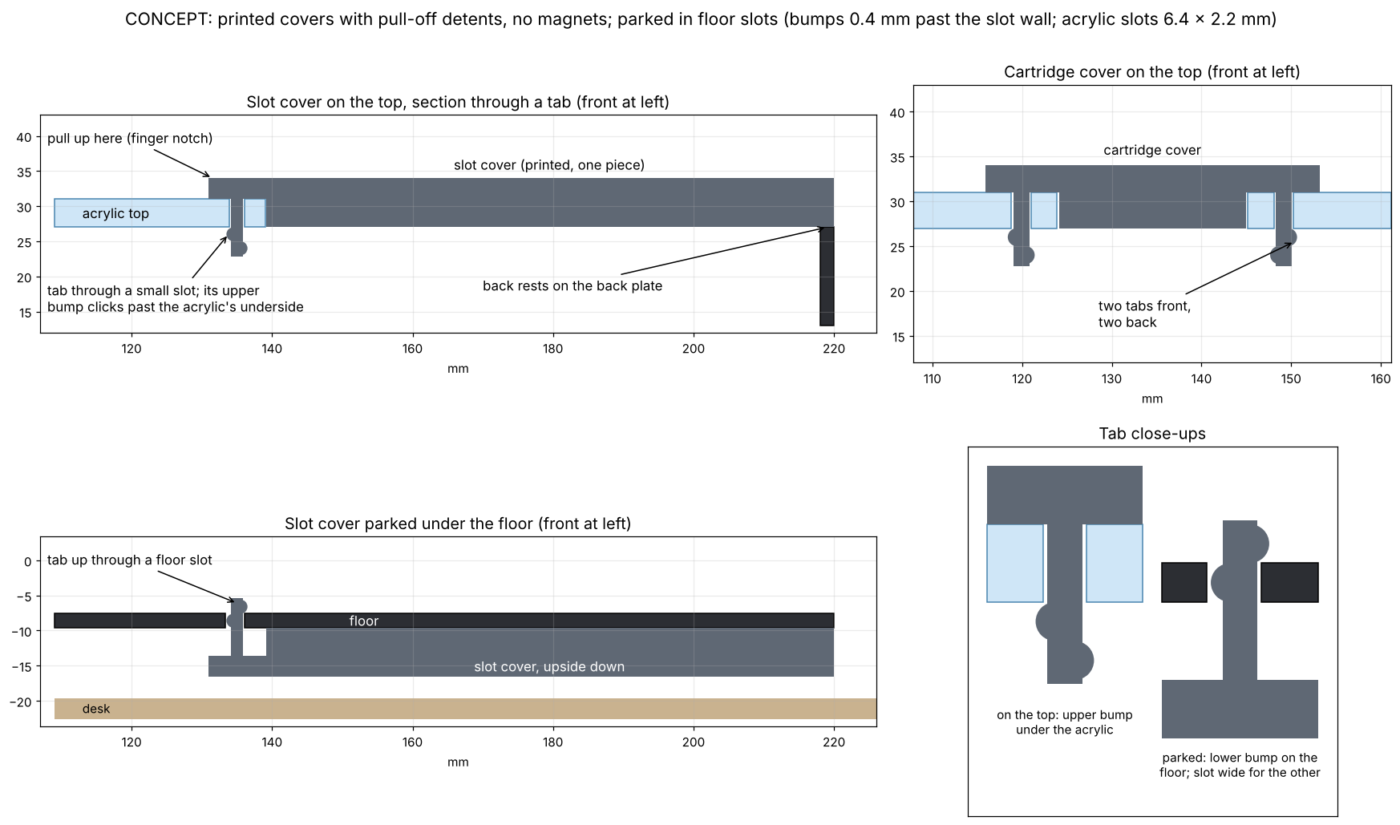
docs/case_concept_snap_section.png
