tocksin/placard/docs/keyboard_schematic.png

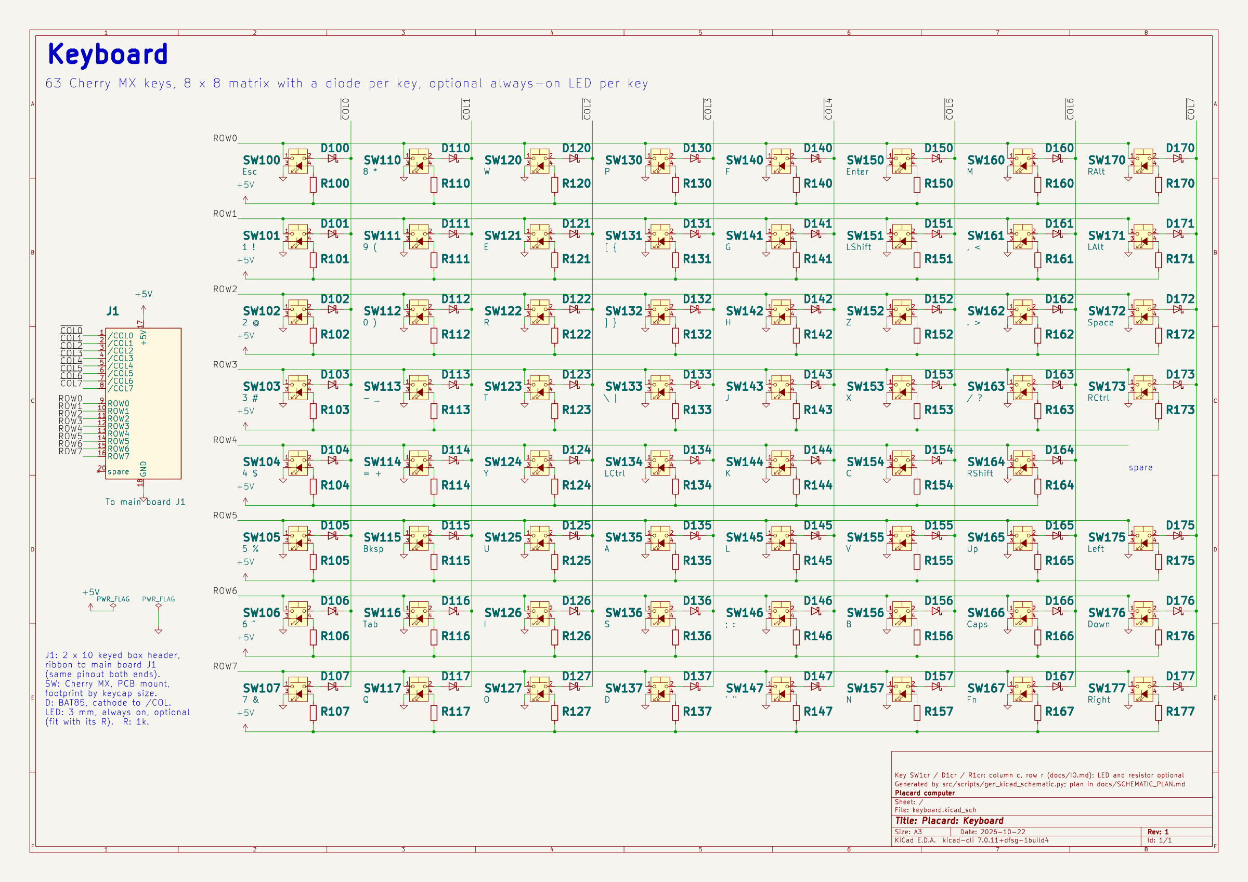
docs/keyboard_schematic.png
