tocksin/placard/reference/game_of_life_sim.png

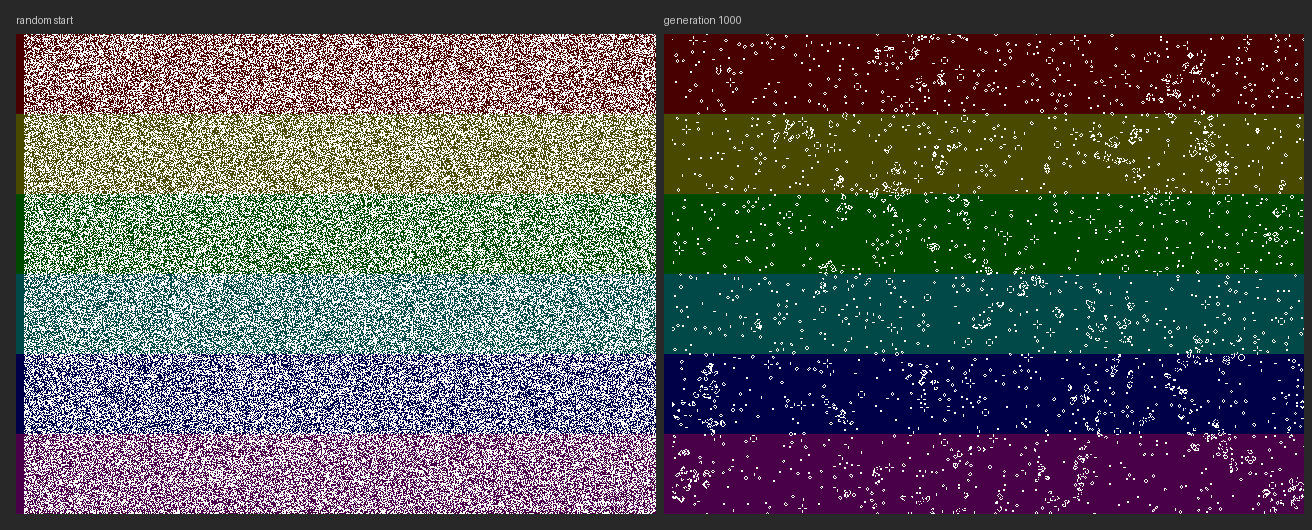
reference/game_of_life_sim.png
