tocksin/placard/reference/lamp_brine.png

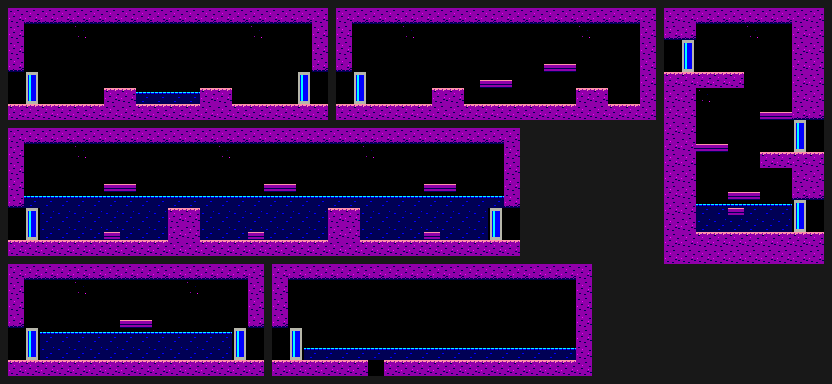
reference/lamp_brine.png
