tocksin/placard/reference/mandelbrot_sim.png

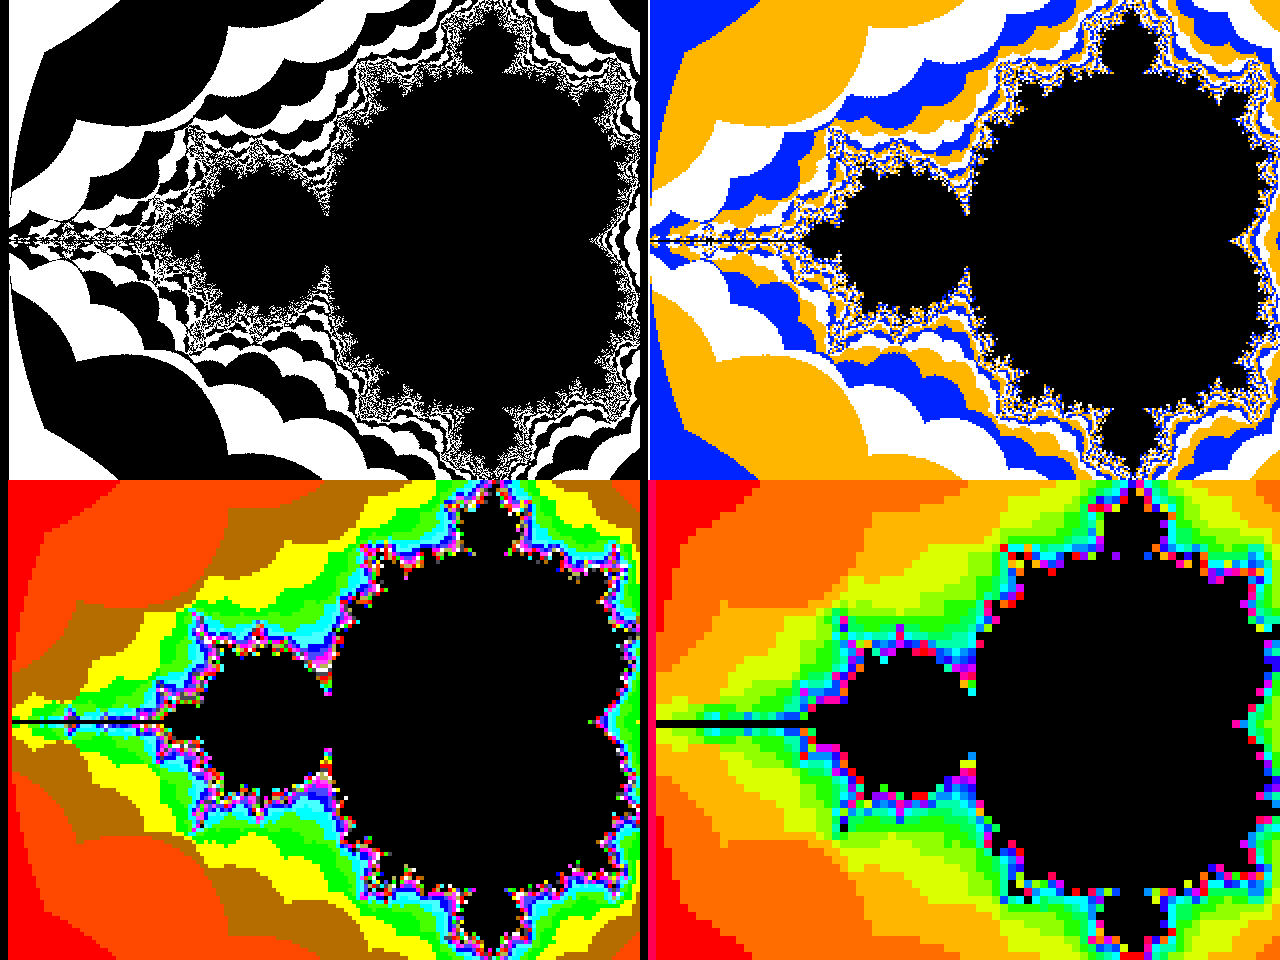
reference/mandelbrot_sim.png
