tocksin/placard/reference/skyward_story.png

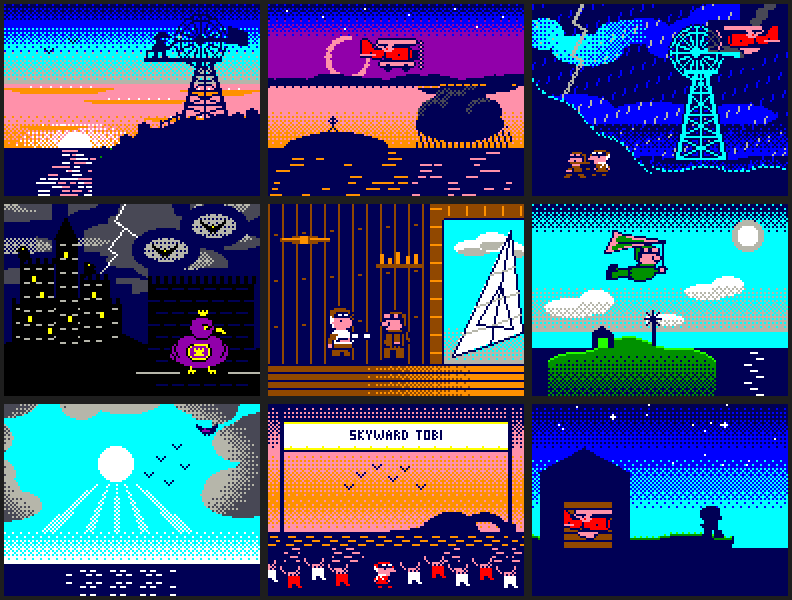
reference/skyward_story.png
