tocksin/placard/reference/wire3d_sim.png

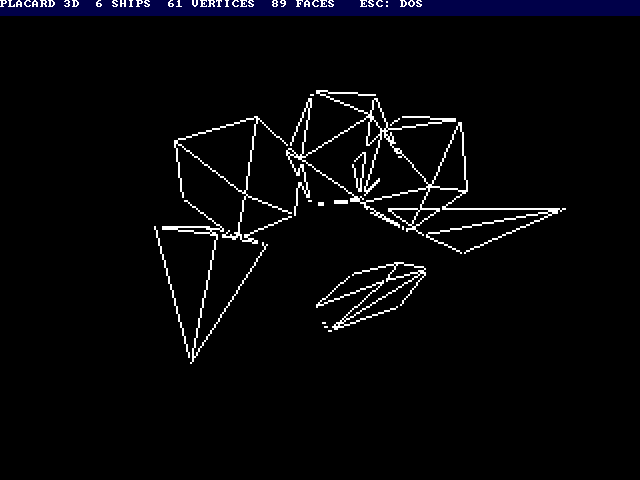
reference/wire3d_sim.png
