tocksin/placard/src/scripts/router_v4/bench/bench_cpu_tidy.png

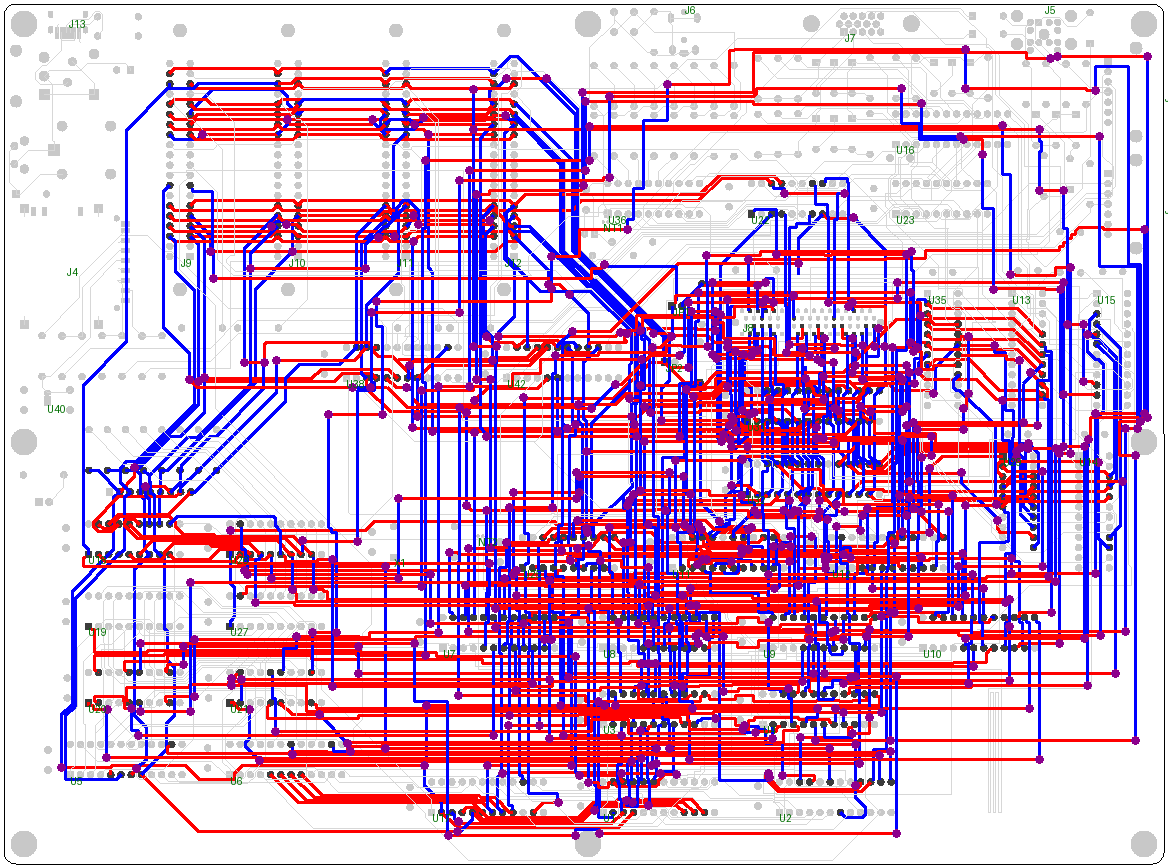
src/scripts/router_v4/bench/bench_cpu_tidy.png
