tocksin/placard/case/quote/PARTS.csv

part | description | qty_per_case | material | finish | process | hardware | size_mm | files
tray | Tray: floor, front and right walls (2 bends) | 1 | Aluminium 5052-H32, 2.0 mm (0.080 in) | Black powder coat, stock color, texture or matte, both sides | laser cut, bend (press brake), countersink, powder coat | No PEM hardware in the tray.; 14 x 3.4 mm holes with a 90 deg countersink, 6.5 mm on the underside (M3 flat head screws: 8 at the board holes H1-H8 into the floor standoffs, 6 through the plates' flanges into nuts); 4 x 3.4 mm plain holes (no countersink) at the feet, 24 mm in from each corner; 10 small slots, 6.4 wide, for the printed covers' tabs (parking under the case) | bent 295.0 x 220.0 x 36.6; flat 328.1 x 253.1 | step/tray.step, dxf/tray_flat.dxf, pdf/tray.pdf
back_plate | Back plate (1 bend) | 1 | Aluminium 5052-H32, 2.0 mm (0.080 in) | Black powder coat, stock color, texture or matte, both sides | laser cut, bend (press brake), powder coat | No PEM hardware.; 3 x 3.4 mm plain holes in the flange (M3 screws, loose nuts fitted by the builder); 8 x 3.4 mm holes in the wall: 4 card screws, 4 cover parking holes | bent 291.0 x 16.0 x 34.6; flat 291.0 x 47.1 | step/back_plate.step, dxf/back_plate_flat.dxf, pdf/back_plate.pdf
left_plate | Left plate (1 bend) | 1 | Aluminium 5052-H32, 2.0 mm (0.080 in) | Black powder coat, stock color, texture or matte, both sides | laser cut, bend (press brake), powder coat | No PEM hardware.; 3 x 3.4 mm plain holes in the flange (M3 screws, loose nuts fitted by the builder) | bent 16.0 x 218.0 x 34.6; flat 218.0 x 47.1 | step/left_plate.step, dxf/left_plate_flat.dxf, pdf/left_plate.pdf
acrylic_top | Top, 4 mm clear acrylic | 1 | Clear cast acrylic (PMMA), 4 mm, protective film both sides | none | laser cut |  | 295.0 x 220.0 x 4 | step/acrylic_top.step, dxf/acrylic_top.dxf, pdf/acrylic_top.pdf
