tocksin/placard/case/dxf/acrylic_top_4mm.dxf

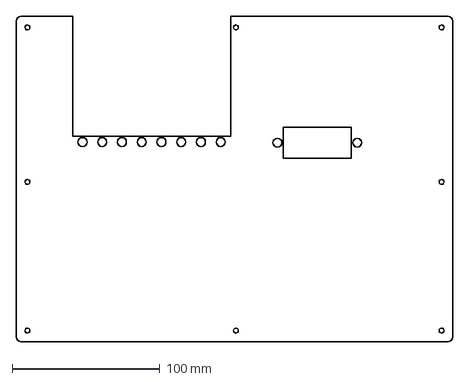
[picture p46: CAD file, 2026-10-29]
case/dxf/acrylic_top_4mm.dxf
295.0 x 220.0 mm
