tocksin/placard/case/print/tray_front_left.stl

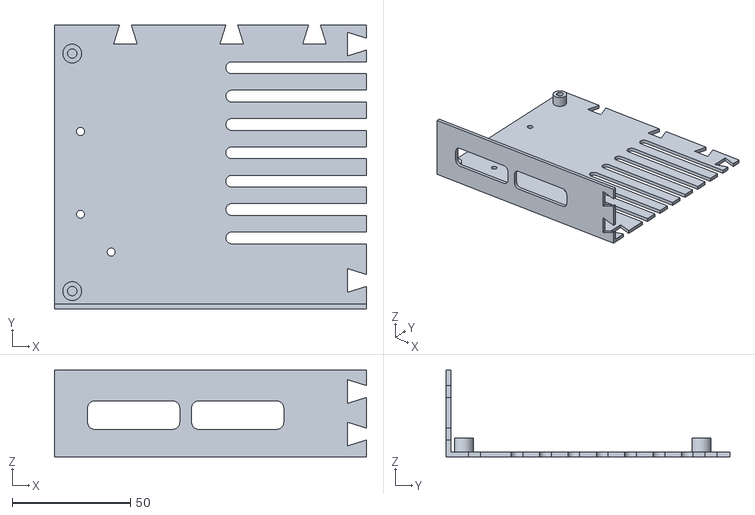
[picture p47: CAD file, 2026-11-02]
case/print/tray_front_left.stl
132.0 x 120.0 x 36.6
