tocksin/placard/case/quote/dxf/back_plate_flat.dxf

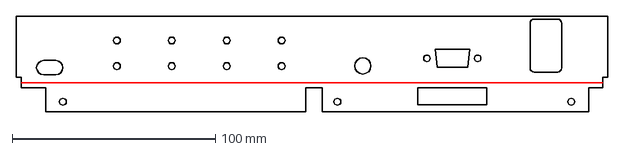
[picture p48: CAD file, 2026-11-01]
case/quote/dxf/back_plate_flat.dxf
291.0 x 47.1 mm
