tocksin/placard/case/quote/step/tray.step

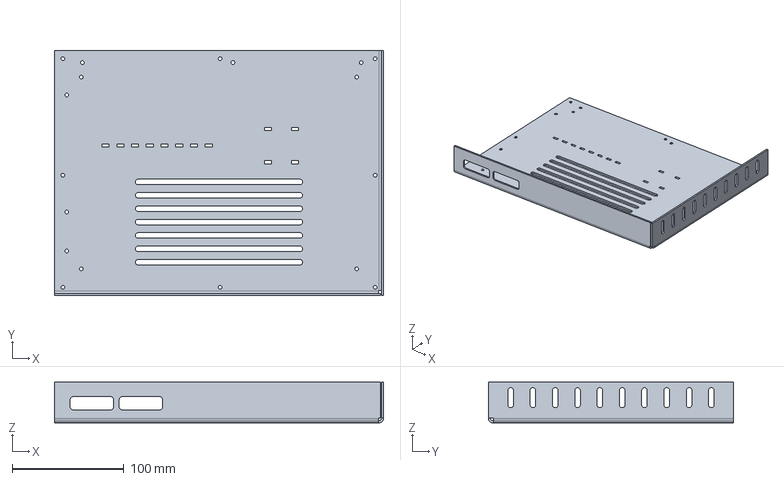
[picture p49: CAD file, 2026-11-02]
case/quote/step/tray.step
295.0 x 220.0 x 36.6 mm
