tocksin/placard/case/dxf/magnet_jig_base_3mm.dxf

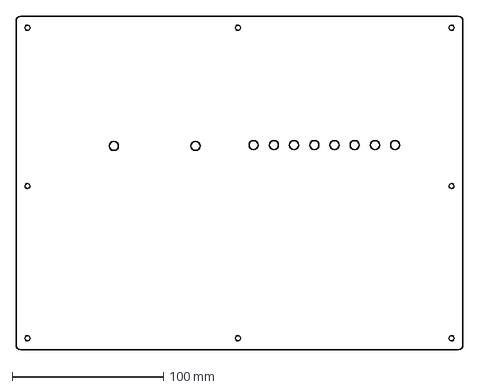
[picture p50: CAD file, 2026-10-29]
case/dxf/magnet_jig_base_3mm.dxf
295.0 x 220.0 mm
