tocksin/placard/case/left_plate.step

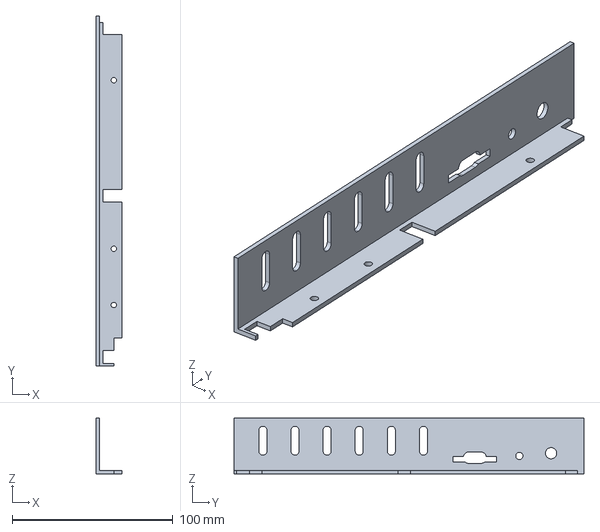
[picture p51: CAD file, 2026-11-01]
case/left_plate.step
16.0 x 218.0 x 34.6 mm
