tocksin/placard/case/print/tray_back_right.stl

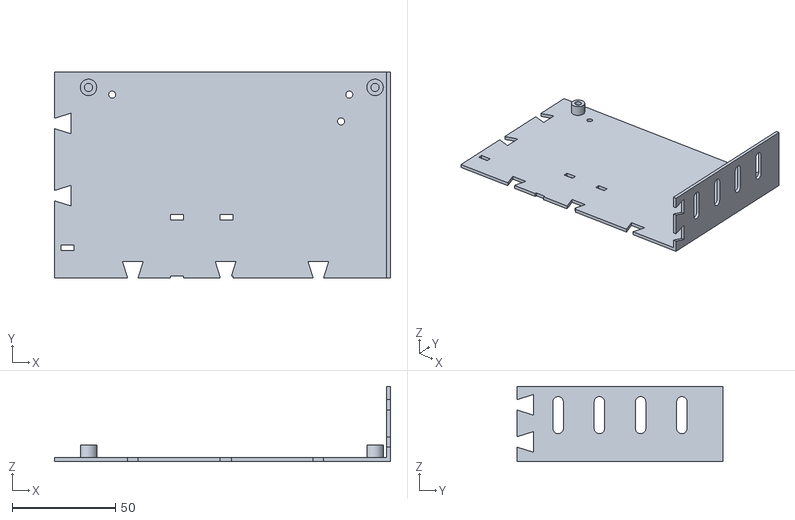
[picture p52: CAD file, 2026-11-02]
case/print/tray_back_right.stl
163.0 x 100.0 x 36.6
