tocksin/placard/case/acrylic_top.step

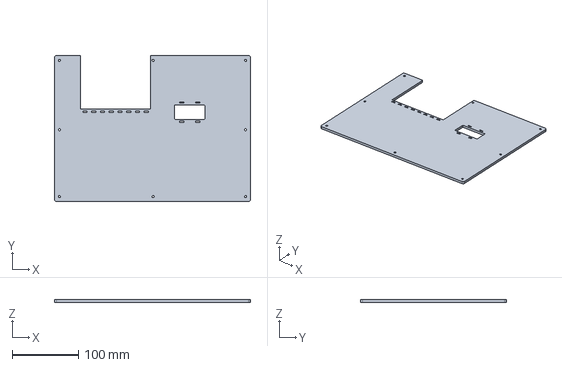
[picture p54: CAD file, 2026-11-01]
case/acrylic_top.step
295.0 x 220.0 x 4.00 mm
