tocksin/placard/case/print/back_plate_left.stl

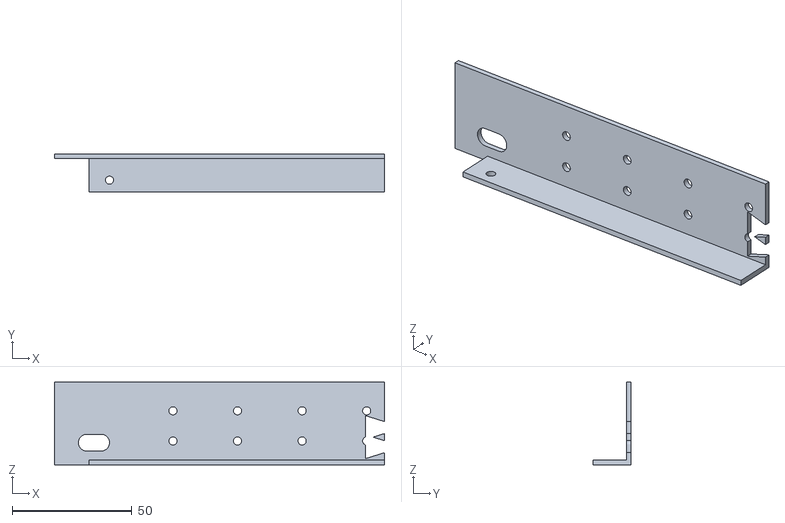
[picture p56: CAD file, 2026-11-01]
case/print/back_plate_left.stl
138.0 x 16.0 x 34.6
