tocksin/placard/case/back_plate.step

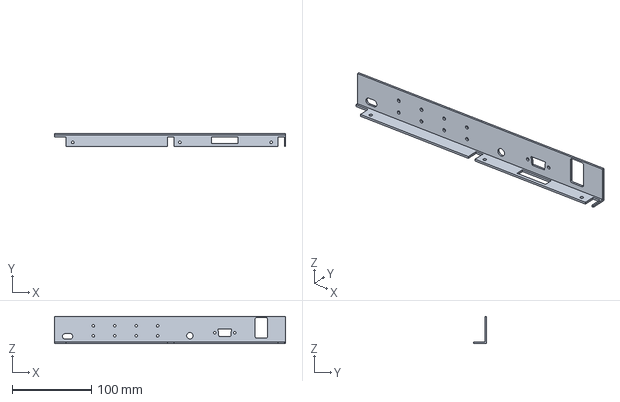
[picture p57: CAD file, 2026-10-30]
case/back_plate.step
291.0 x 16.0 x 34.6 mm
