tocksin/placard/case/print/left_plate_front.stl

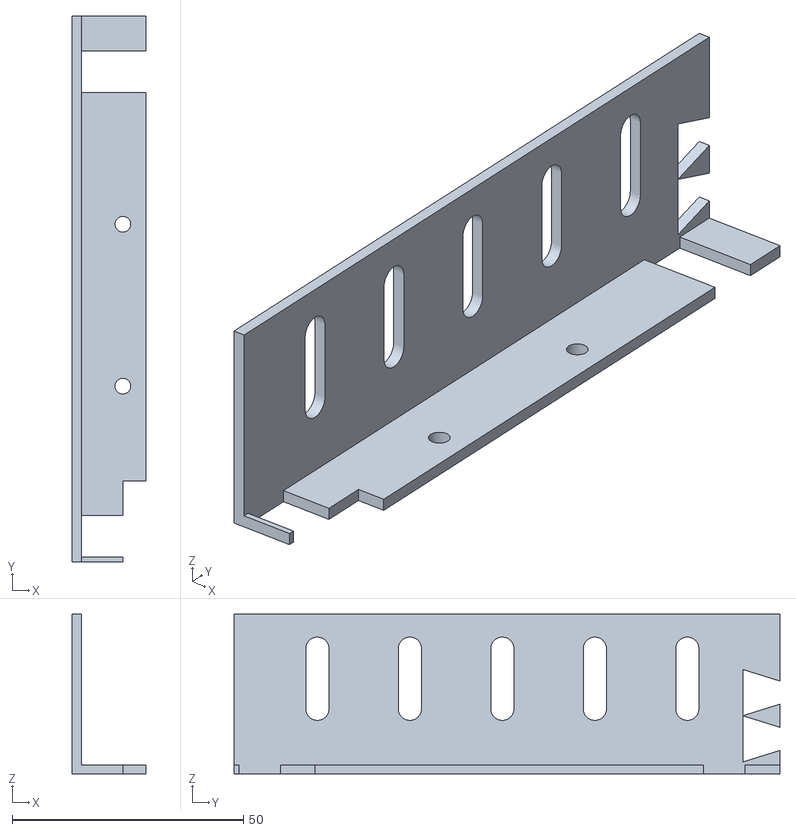
[picture p58: CAD file, 2026-10-30]
case/print/left_plate_front.stl
16.0 x 118.0 x 34.6
