tocksin/placard/case/quote/step/cart_cover_plug.step

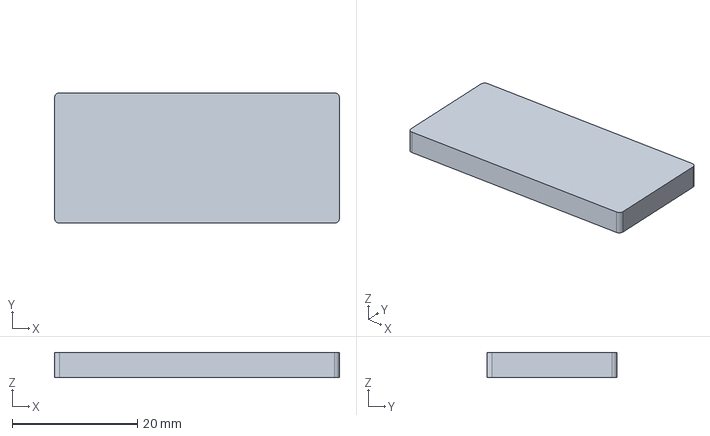
[picture p59: CAD file, 2026-10-30]
case/quote/step/cart_cover_plug.step
45.6 x 20.8 x 4.00 mm
