tocksin/placard/case/cart_cover.step

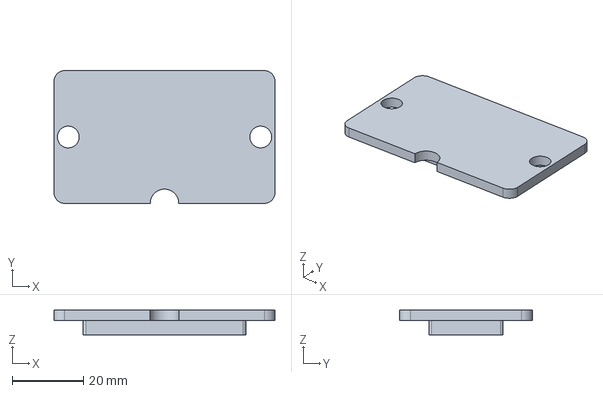
[picture p60: CAD file, 2026-10-29]
case/cart_cover.step
62.0 x 37.2 x 7.00 mm
