tocksin/placard/case/print/tray_front_right.stl

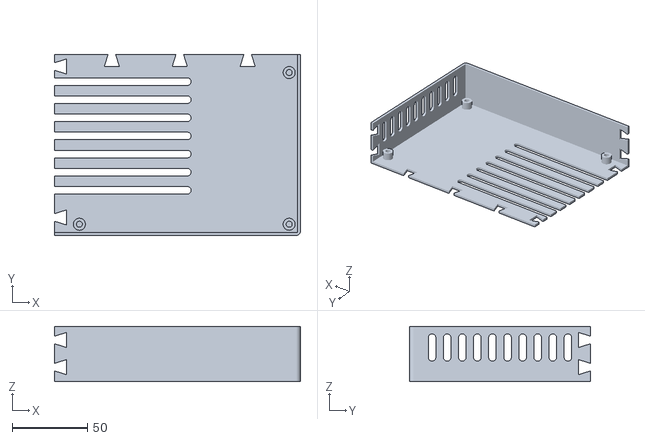
[picture p61: CAD file, 2026-10-29]
case/print/tray_front_right.stl
163.0 x 120.0 x 36.6
