tocksin/placard/case/quote/step/cart_cover_cap.step

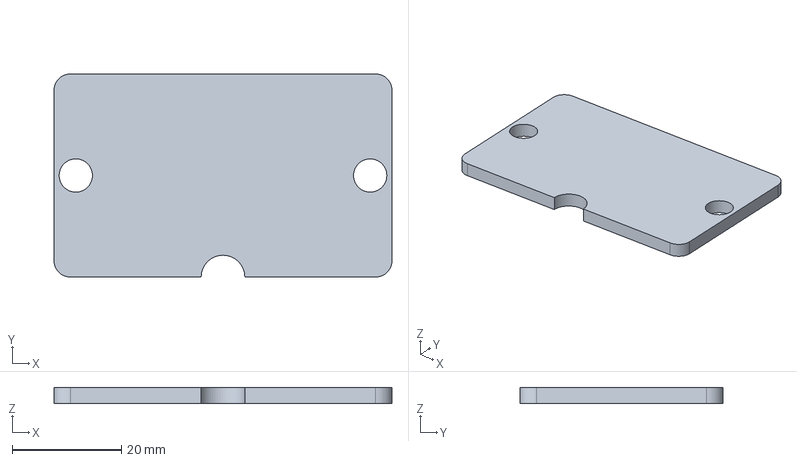
[picture p62: CAD file, 2026-10-30]
case/quote/step/cart_cover_cap.step
62.0 x 37.2 x 3.00 mm
