tocksin/placard/case/print/top_front_right.stl

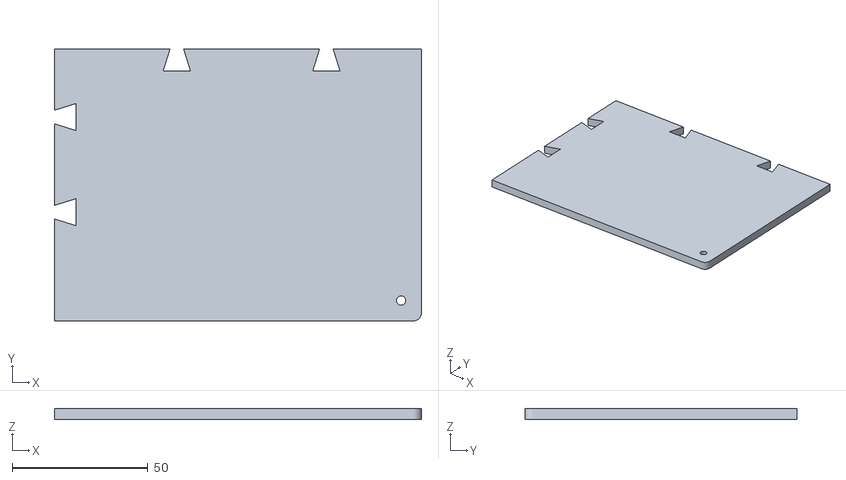
[picture p63: CAD file, 2026-10-29]
case/print/top_front_right.stl
135.0 x 100.0 x 4.00
