tocksin/placard/case/quote/step/slot_cover_cap.step

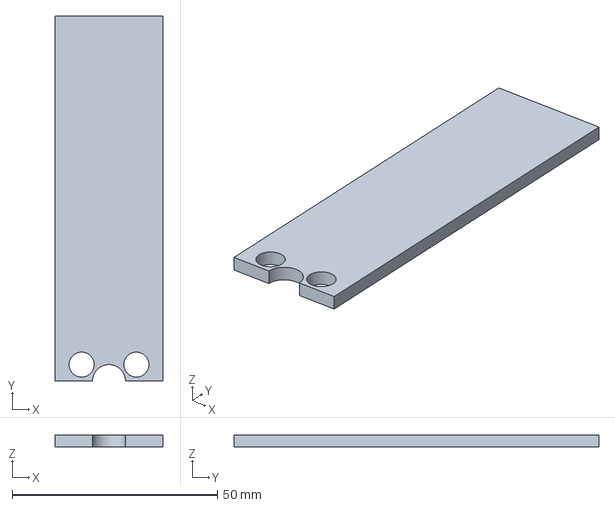
[picture p64: CAD file, 2026-10-30]
case/quote/step/slot_cover_cap.step
26.3 x 89.0 x 3.00 mm
