tocksin/placard/case/slot_cover.step

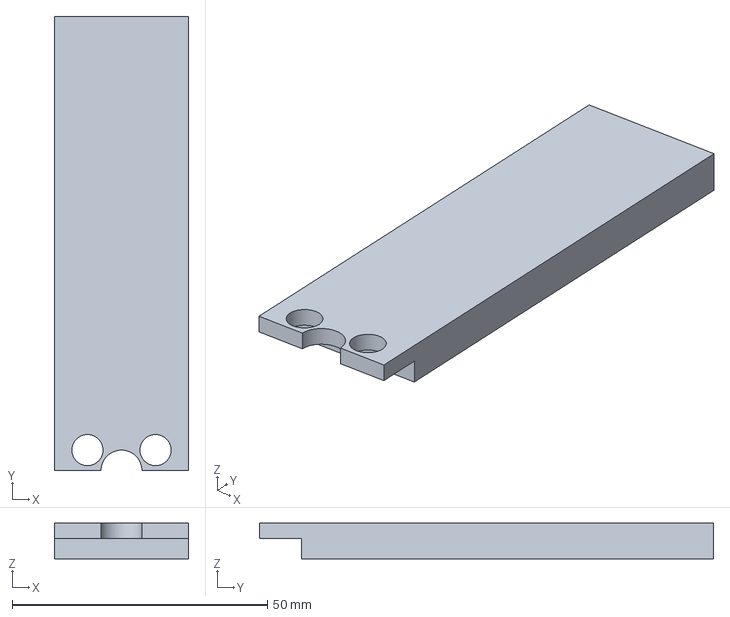
[picture p65: CAD file, 2026-10-29]
case/slot_cover.step
26.3 x 89.0 x 7.00 mm
