tocksin/placard/case/print/left_plate_back.stl

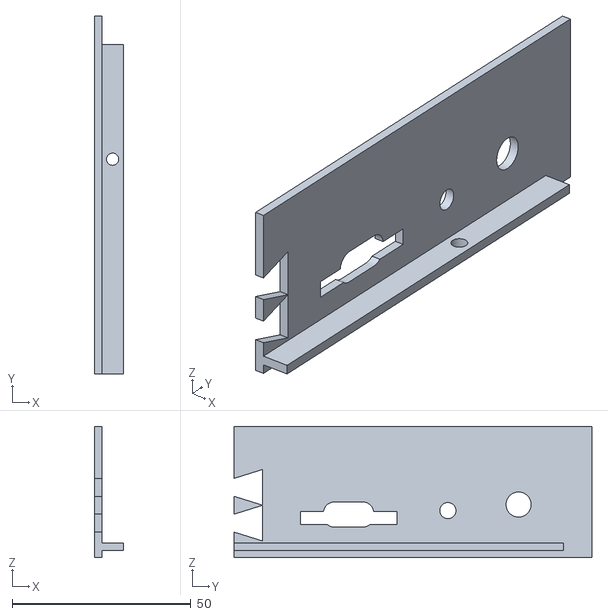
[picture p66: CAD file, 2026-10-29]
case/print/left_plate_back.stl
8.00 x 100.0 x 36.6
