tocksin/placard/case/print/key_2mm.stl

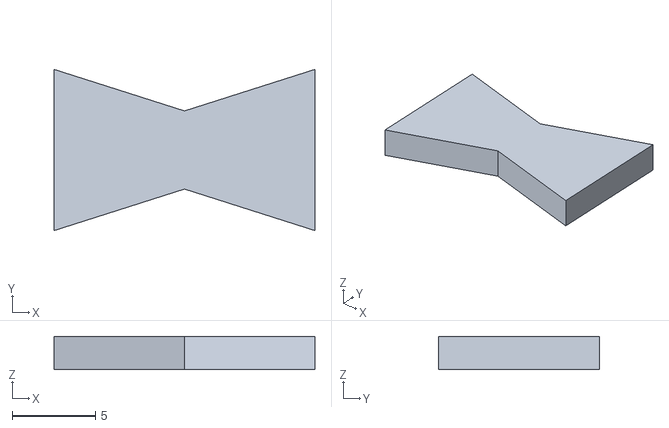
[picture p67: CAD file, 2026-10-29]
case/print/key_2mm.stl
15.7 x 9.70 x 2.00
