tocksin/placard/(list of files, cad)

Other CAD files:
case/tray.step
case/quote/step/acrylic_top.step
case/print/cart_cover.stl
case/quote/dxf/acrylic_top.dxf
case/quote/dxf/cart_cover_cap.dxf
