tocksin/placard/docs/case_concept_snap_assembled.png

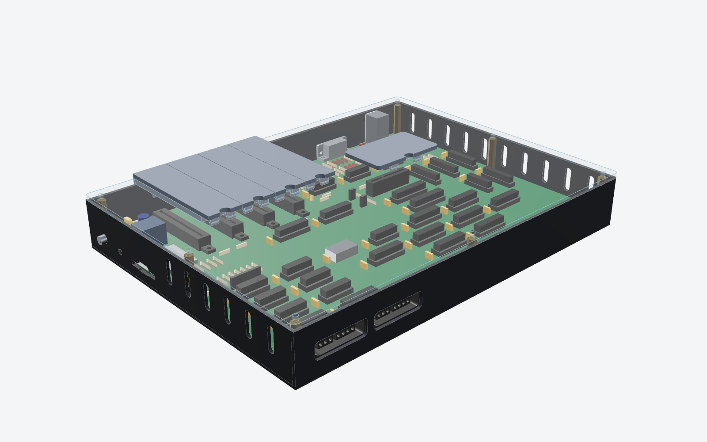
docs/case_concept_snap_assembled.png
