tocksin/placard/docs/hardware/bringup_screens/step21_tone.png

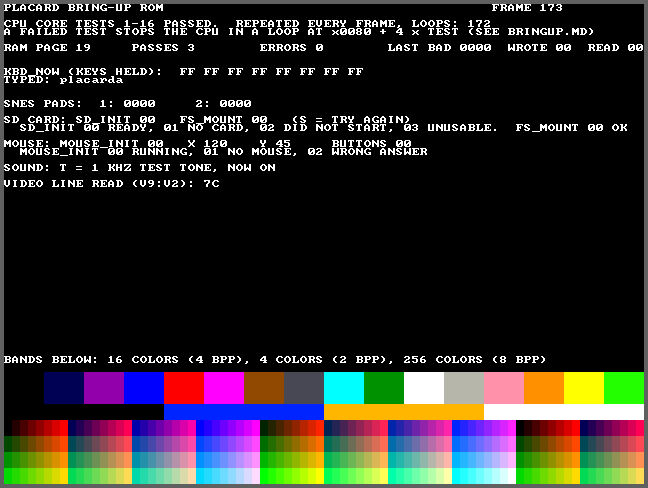
docs/hardware/bringup_screens/step21_tone.png
