tocksin/placard/schematics/placard_main.pdf

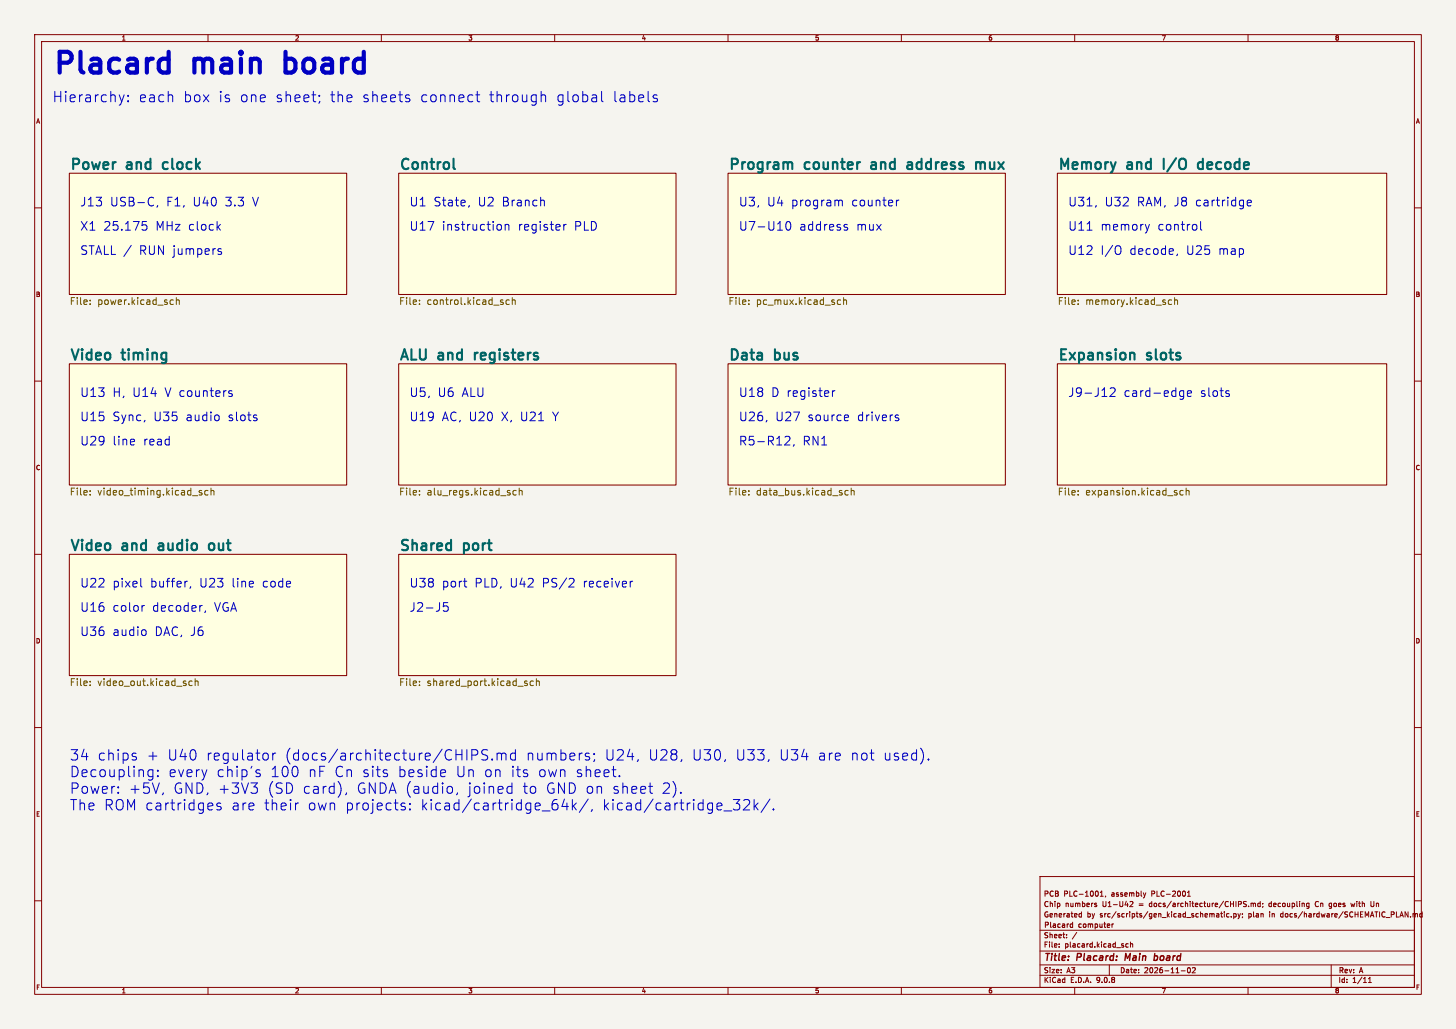
[picture p96: page 1]

Hierarchy: each box is one sheet; the sheets connect through global labels

U22 pixel buffer, U23 line code
U16 color decoder, VGA
U36 audio DAC, J6

U38 port PLD, U42 PS/2 receiver

Power: +5V, GND, +3V3 (SD card), GNDA (audio, joined to GND on sheet 2).

Id: 1/11 Title: Placard: Main board

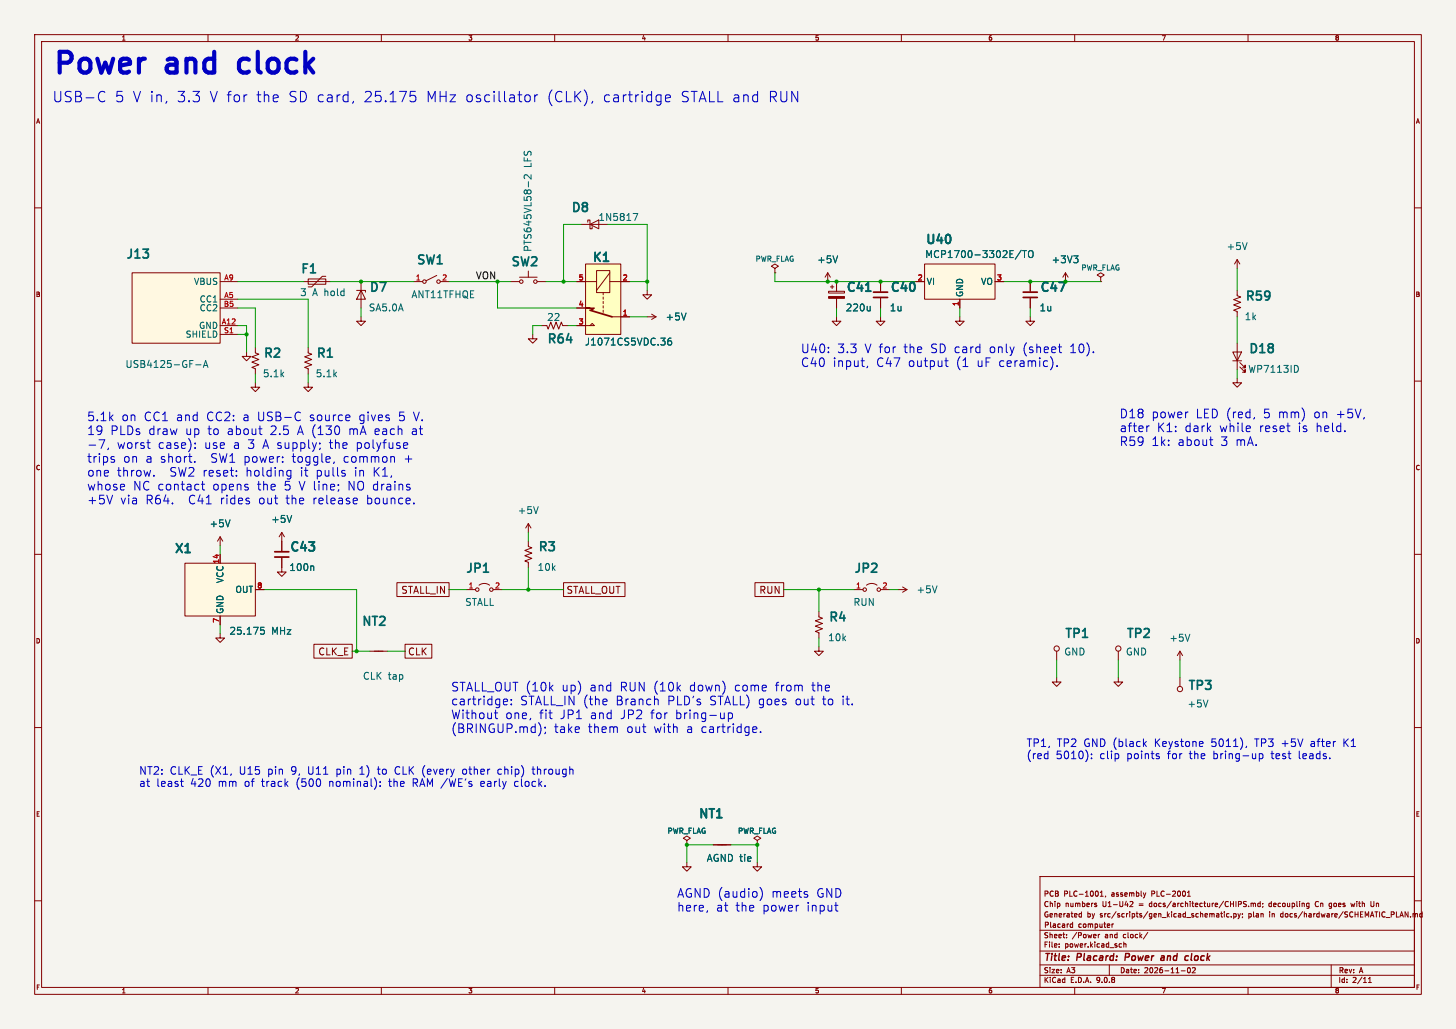
[picture p97: page 2]

U40: 3.3 V for the SD card only (sheet 10).
C40 input, C47 output (1 uF ceramic).

5.1k on CC1 and CC2: a USB-C source gives 5 V.
19 PLDs draw up to about 2.5 A (130 mA each at
-7, worst case): use a 3 A supply; the polyfuse
whose NC contact opens the 5 V line; NO drains
+5V via R64. C41 rides out the release bounce.

D18 power LED (red, 5 mm) on +5V,
after K1: dark while reset is held.
R59 1k: about 3 mA.

STALL_OUT (10k up) and RUN (10k down) come from the
Without one, fit JP1 and JP2 for bring-up
(BRINGUP.md); take them out with a cartridge.

TP1, TP2 GND (black Keystone 5011), TP3 +5V after K1

NT2: CLK_E (X1, U15 pin 9, U11 pin 1) to CLK (every other chip) through

AGND (audio) meets GND
here, at the power input

Id: 2/11 Title: Placard: Power and clock

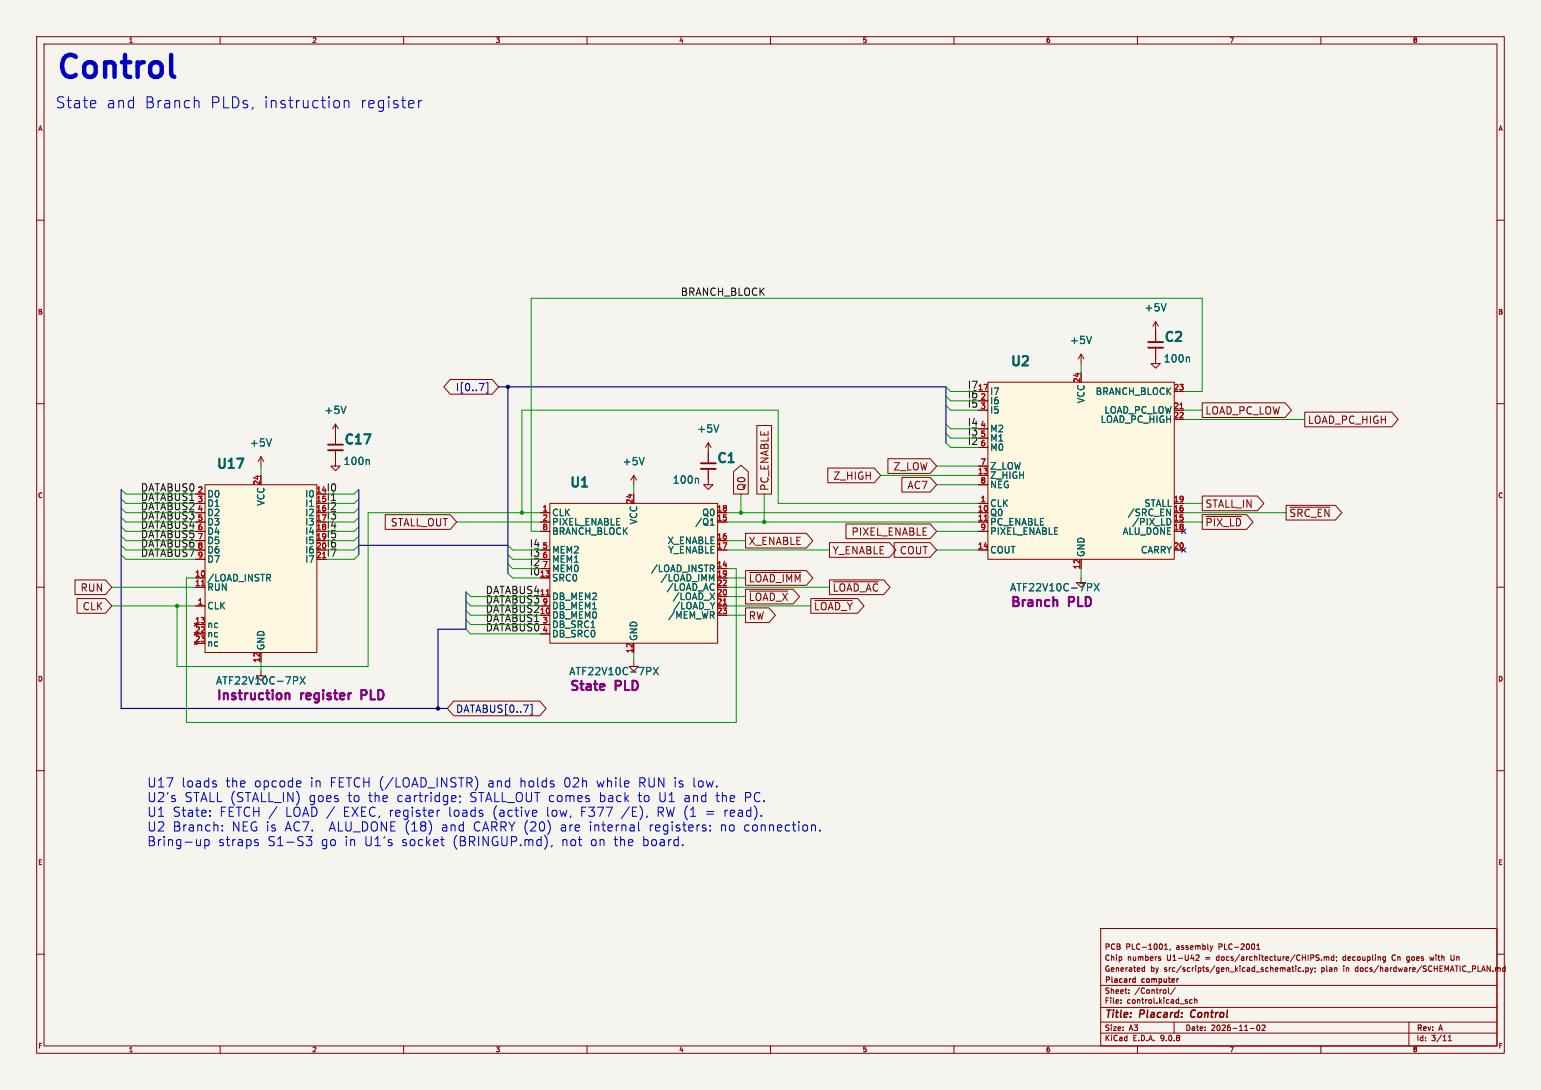
[picture p98: page 3]

U17 loads the opcode in FETCH (/LOAD_INSTR) and holds 02h while RUN is low.
U1 State: FETCH / LOAD / EXEC, register loads (active low, F377 /E), RW (1 = read).

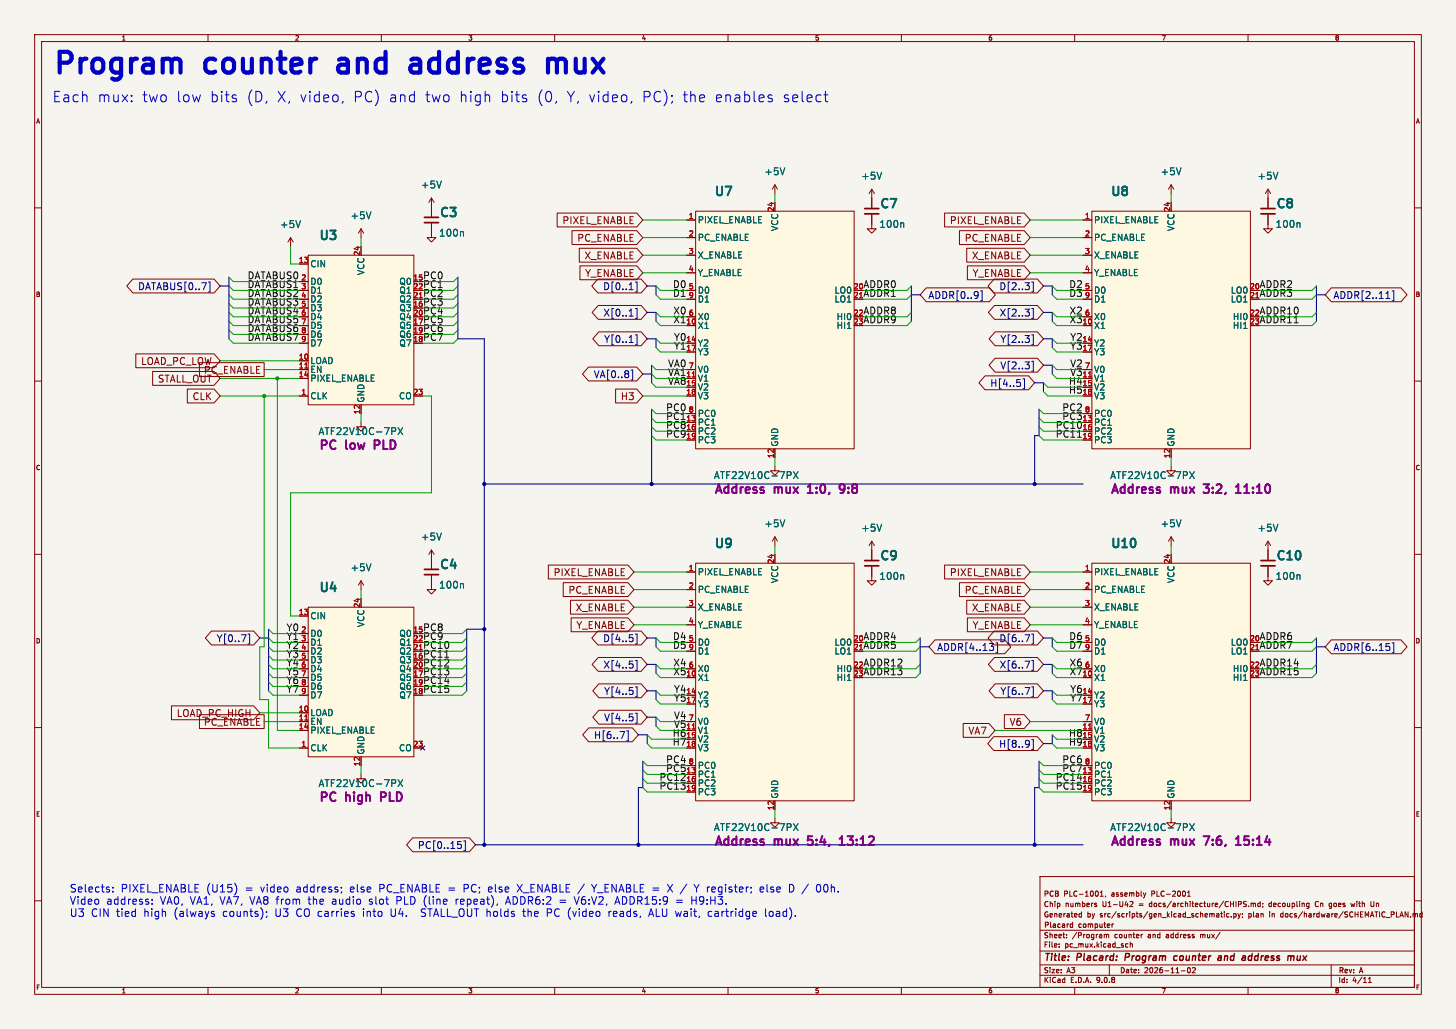
[picture p99: page 4]

Program counter and address mux

Each mux: two low bits (D, X, video, PC) and two high bits (0, Y, video, PC); the enables select

Selects: PIXEL_ENABLE (U15) = video address; else PC_ENABLE = PC; else X_ENABLE / Y_ENABLE = X / Y register; else D / 00h.
Video address: VA0, VA1, VA7, VA8 from the audio slot PLD (line repeat), ADDR6:2 = V6:V2, ADDR15:9 = H9:H3.

Id: 4/11 Title: Placard: Program counter and address mux

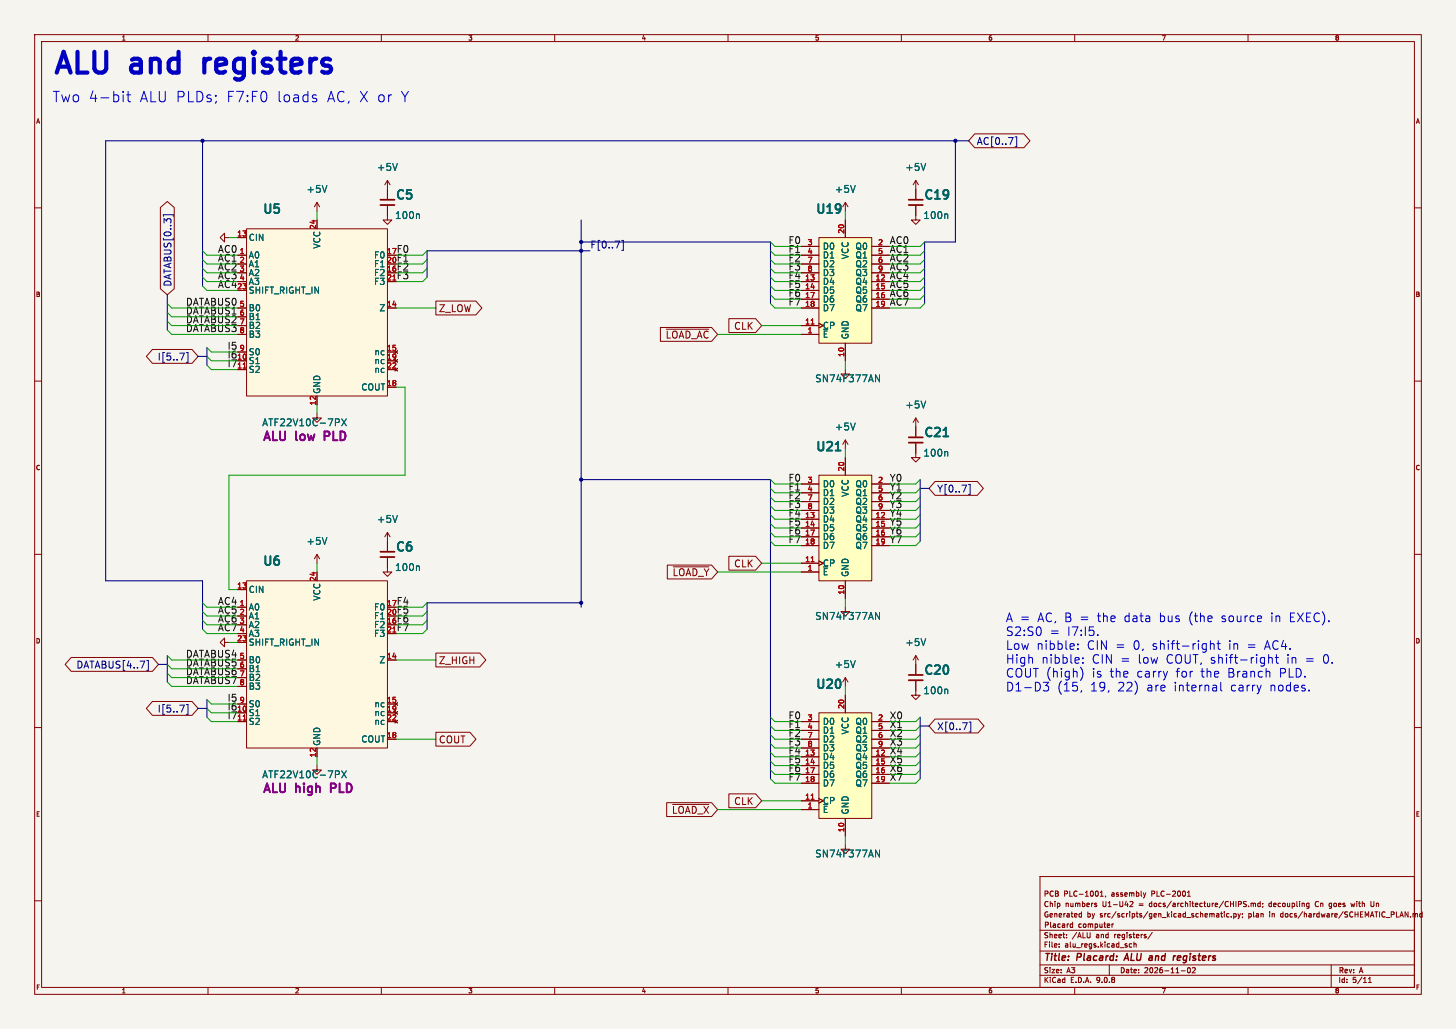
[picture p100: page 5]

A = AC, B = the data bus (the source in EXEC).
COUT (high) is the carry for the Branch PLD.
D1-D3 (15, 19, 22) are internal carry nodes.

Id: 5/11 Title: Placard: ALU and registers

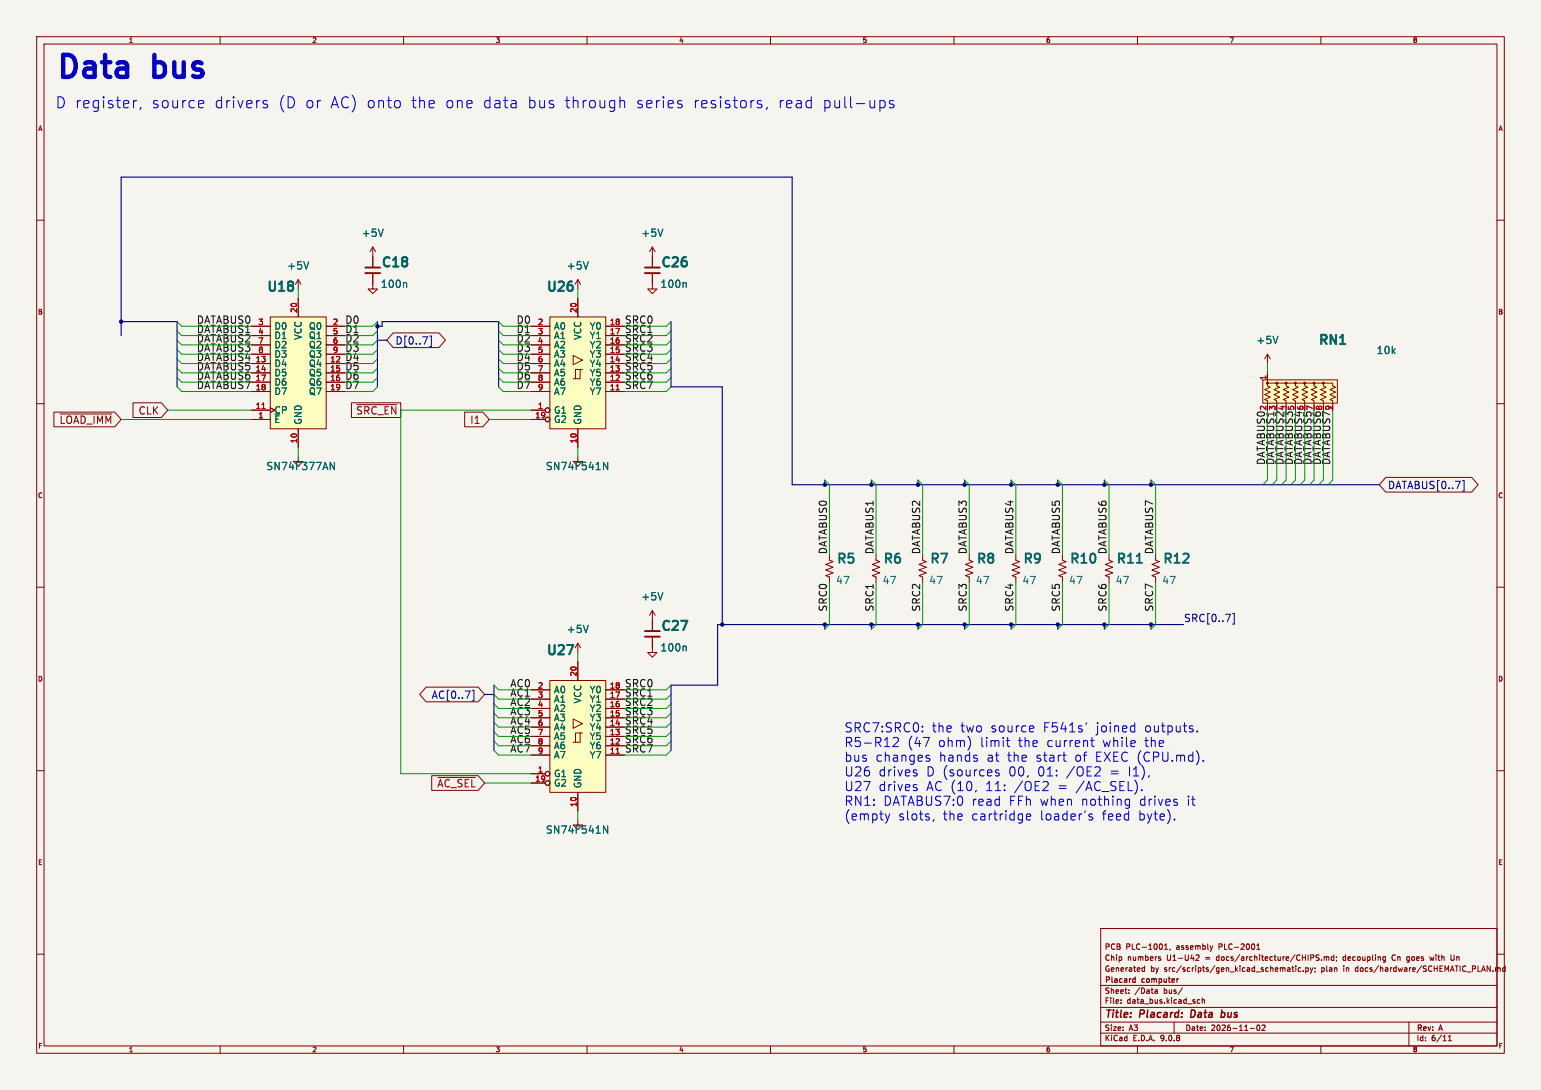
[picture p101: page 6]

SRC7:SRC0: the two source F541s' joined outputs.
bus changes hands at the start of EXEC (CPU.md).
U26 drives D (sources 00, 01: /OE2 = I1),
U27 drives AC (10, 11: /OE2 = /AC_SEL).
RN1: DATABUS7:0 read FFh when nothing drives it

Id: 6/11 Title: Placard: Data bus

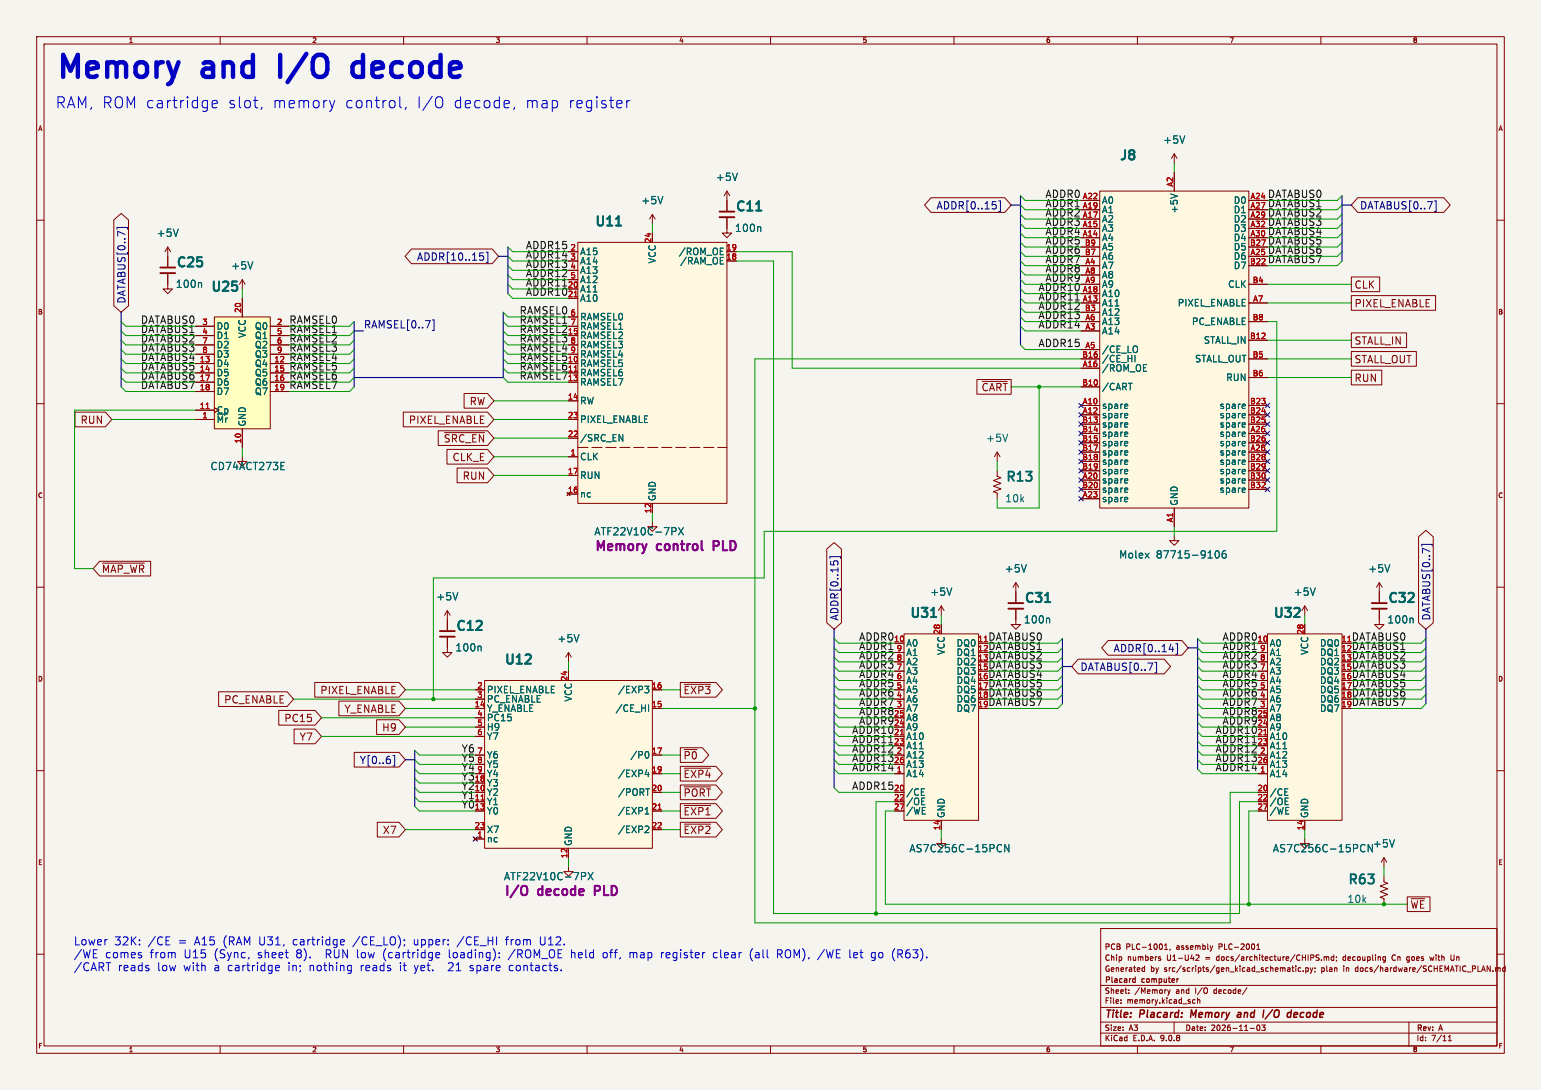
[picture p102: page 7]

Id: 7/11 Title: Placard: Memory and I/O decode

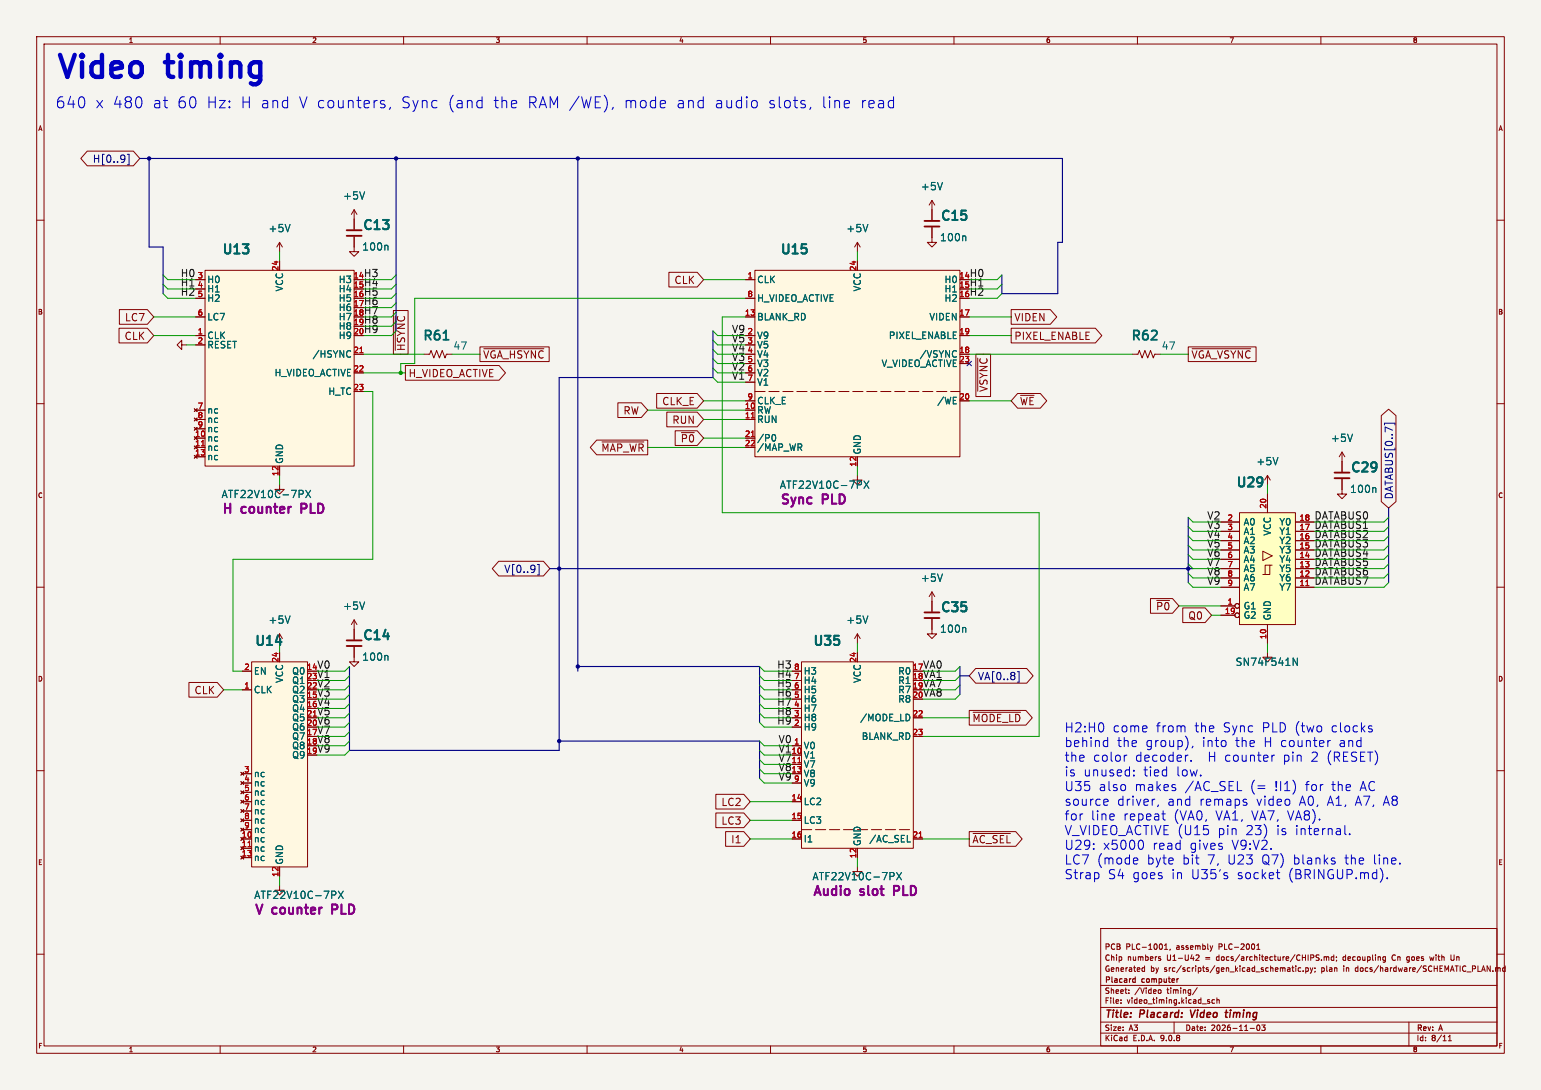
[picture p103: page 8]

640 x 480 at 60 Hz: H and V counters, Sync (and the RAM /WE), mode and audio slots, line read
H0 3 H1 4 H2 5 LC7 6 CLK 1 RESET 2 nc

H2:H0 come from the Sync PLD (two clocks
behind the group), into the H counter and
is unused: tied low.
U35 also makes /AC_SEL (= !I1) for the AC
source driver, and remaps video A0, A1, A7, A8
for line repeat (VA0, VA1, VA7, VA8).
V_VIDEO_ACTIVE (U15 pin 23) is internal.
U29: x5000 read gives V9:V2.
LC7 (mode byte bit 7, U23 Q7) blanks the line.
Strap S4 goes in U35's socket (BRINGUP.md).

Id: 8/11 Title: Placard: Video timing

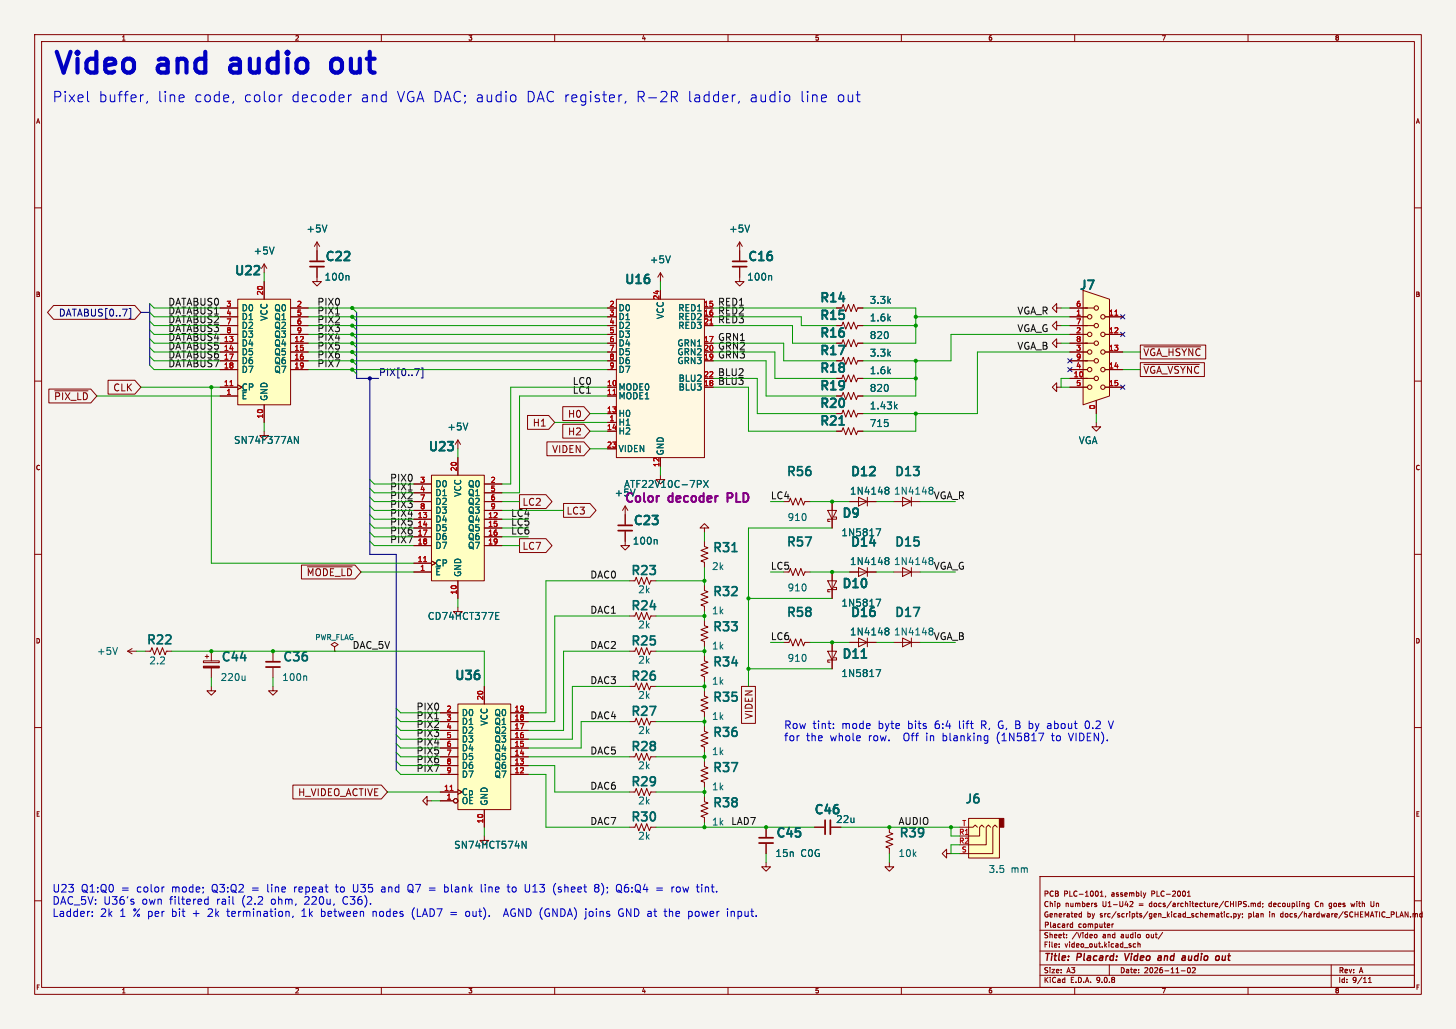
[picture p104: page 9]

Video and audio out

Pixel buffer, line code, color decoder and VGA DAC; audio DAC register, R-2R ladder, audio line out

Row tint: mode byte bits 6:4 lift R, G, B by about 0.2 V

U23 Q1:Q0 = color mode; Q3:Q2 = line repeat to U35 and Q7 = blank line to U13 (sheet 8); Q6:Q4 = row tint.

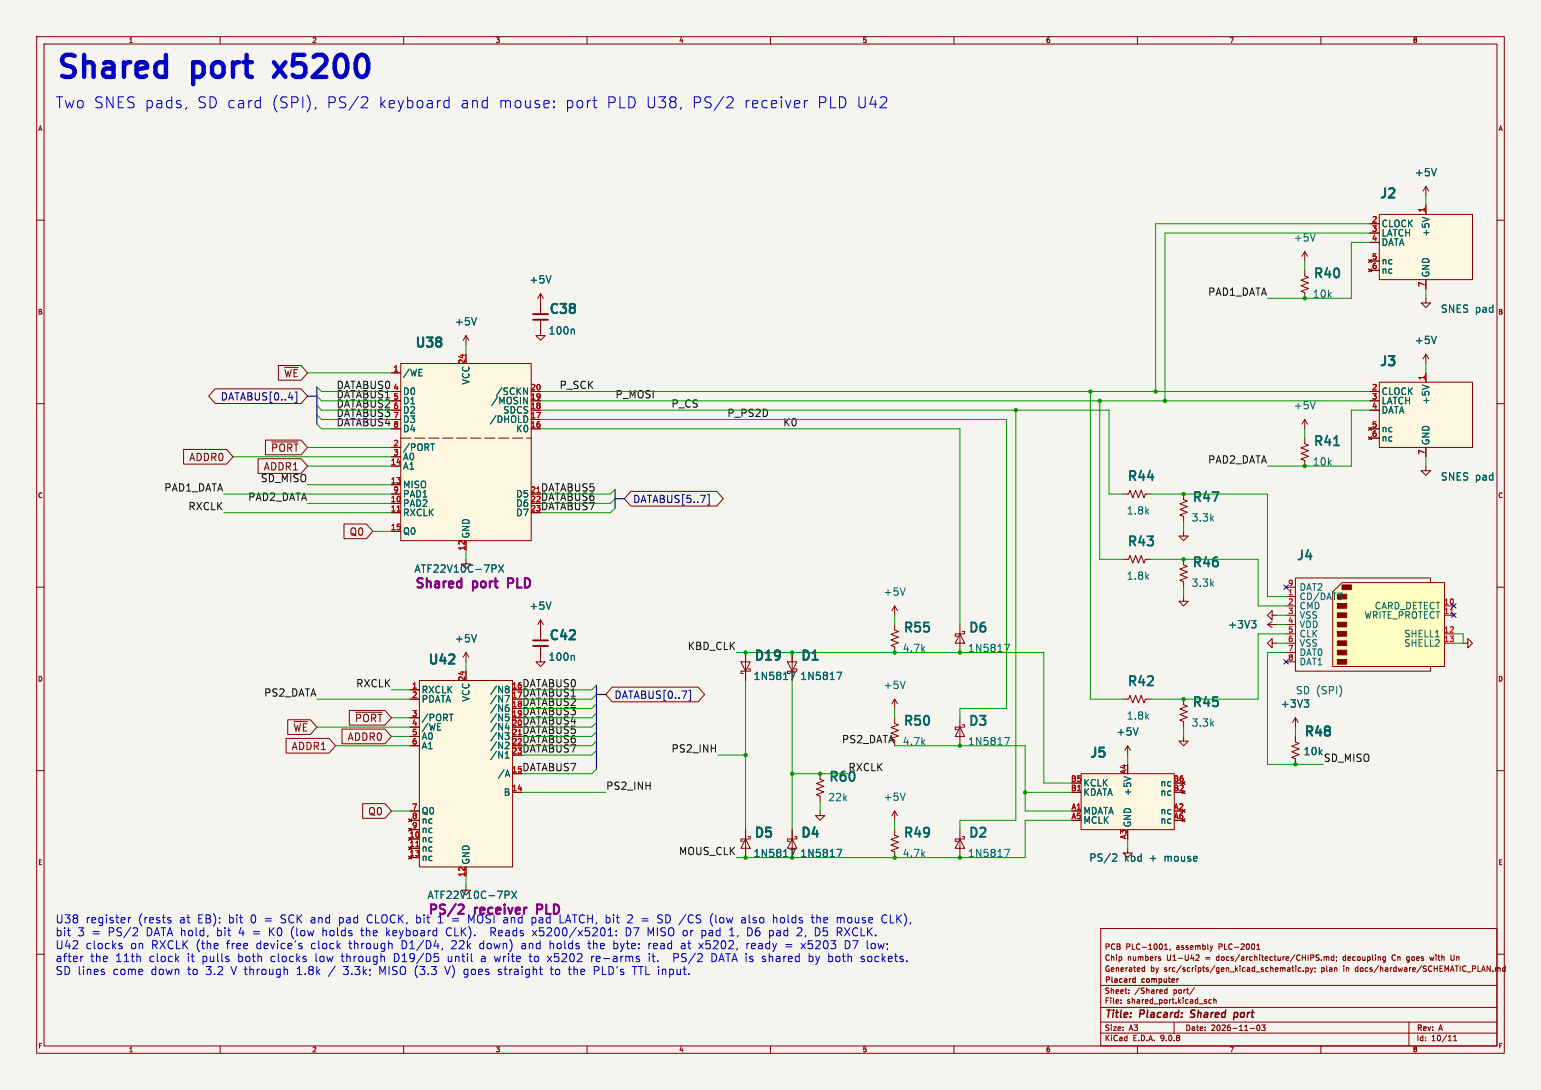
[picture p105: page 10]

Two SNES pads, SD card (SPI), PS/2 keyboard and mouse: port PLD U38, PS/2 receiver PLD U42

U38 register (rests at EB): bit 0 = SCK and pad CLOCK, bit 1 = MOSI and pad LATCH, bit 2 = SD /CS (low also holds the mouse CLK),
U42 clocks on RXCLK (the free device's clock through D1/D4, 22k down) and holds the byte: read at x5202, ready = x5203 D7 low;

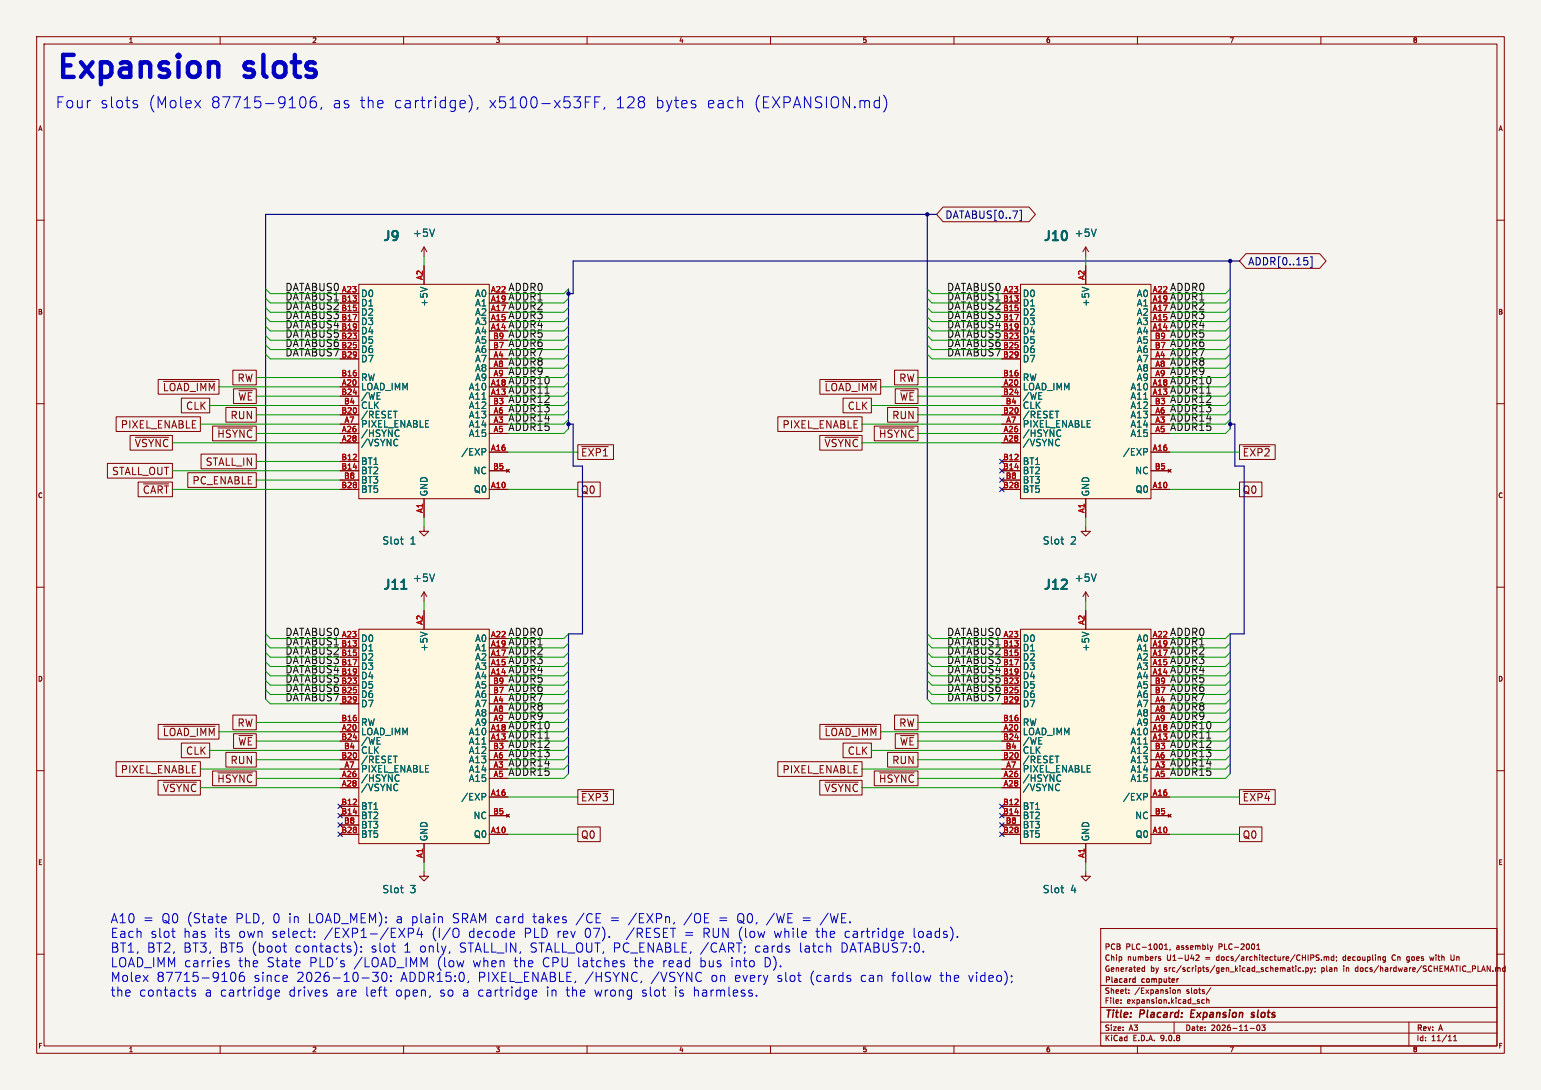
[picture p106: page 11]

A10 = Q0 (State PLD, 0 in LOAD_MEM): a plain SRAM card takes /CE = /EXPn, /OE = Q0, /WE = /WE.
LOAD_IMM carries the State PLD's /LOAD_IMM (low when the CPU latches the read bus into D).

Id: 11/11 Title: Placard: Expansion slots
