tocksin/placard/schematics/placard_cartridge_32k.pdf

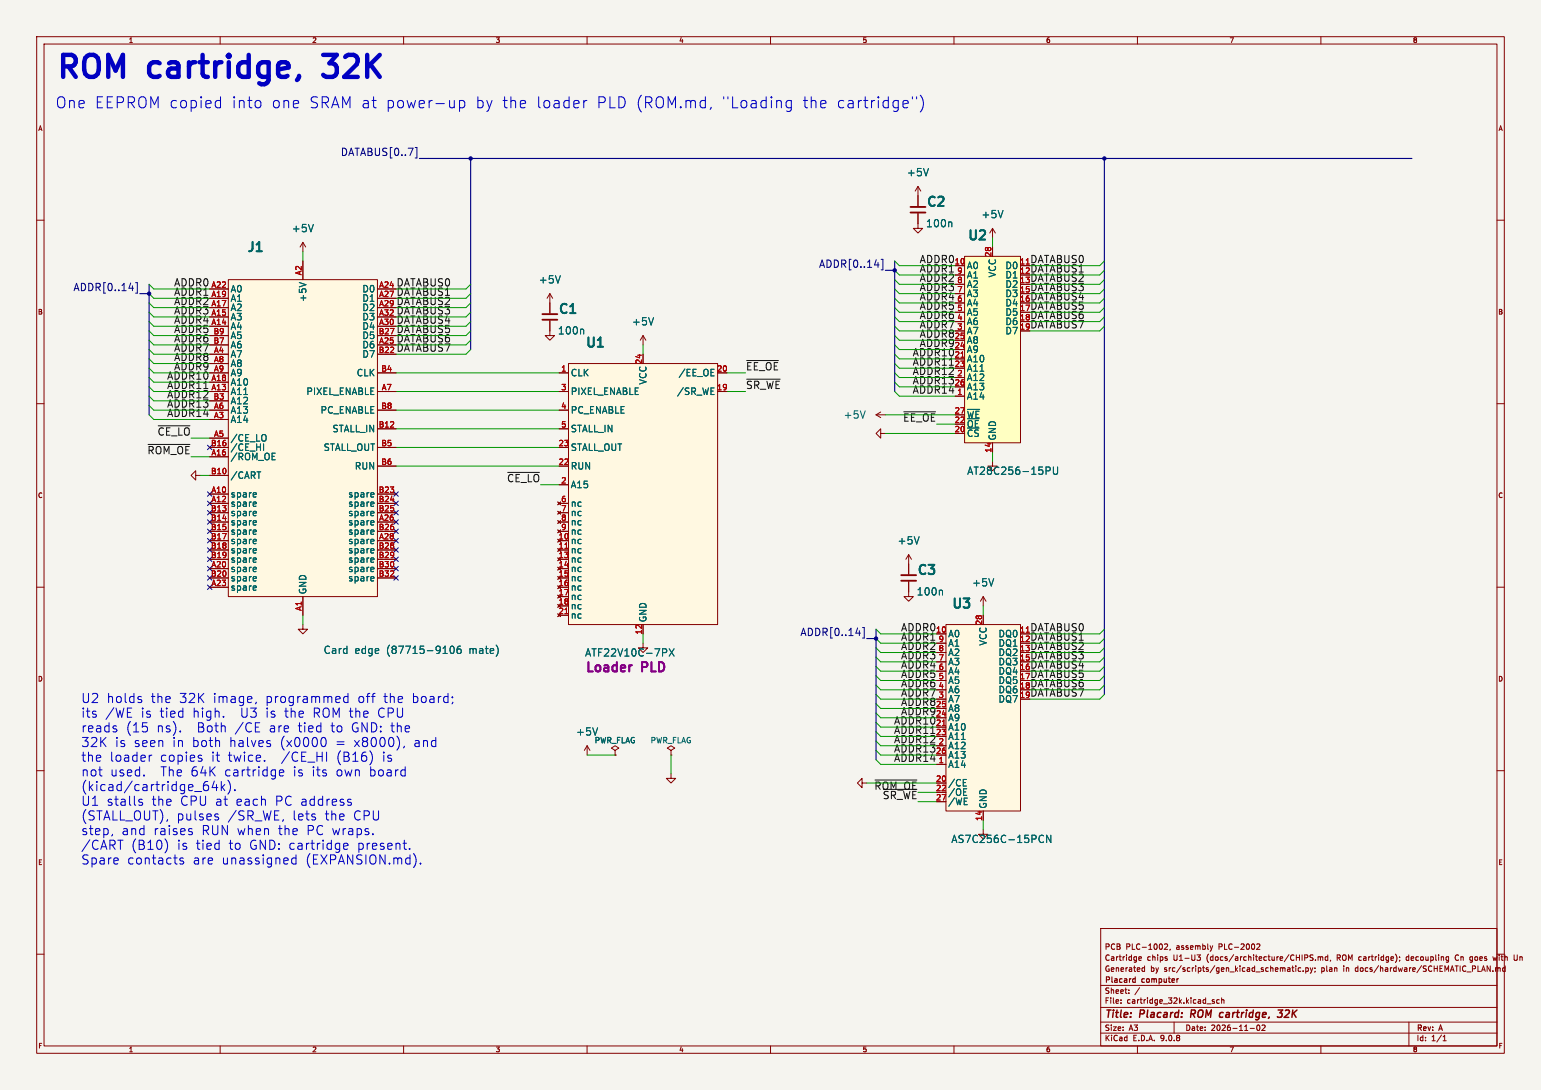
[picture p107: page 1]

32K is seen in both halves (x0000 = x8000), and
(kicad/cartridge_64k).
U1 stalls the CPU at each PC address
(STALL_OUT), pulses /SR_WE, lets the CPU
step, and raises RUN when the PC wraps.
