tocksin/placard/case/quote/pdf/acrylic_top.pdf

# Top, 4 mm clear acrylic - flat pattern, inside face up (mm)

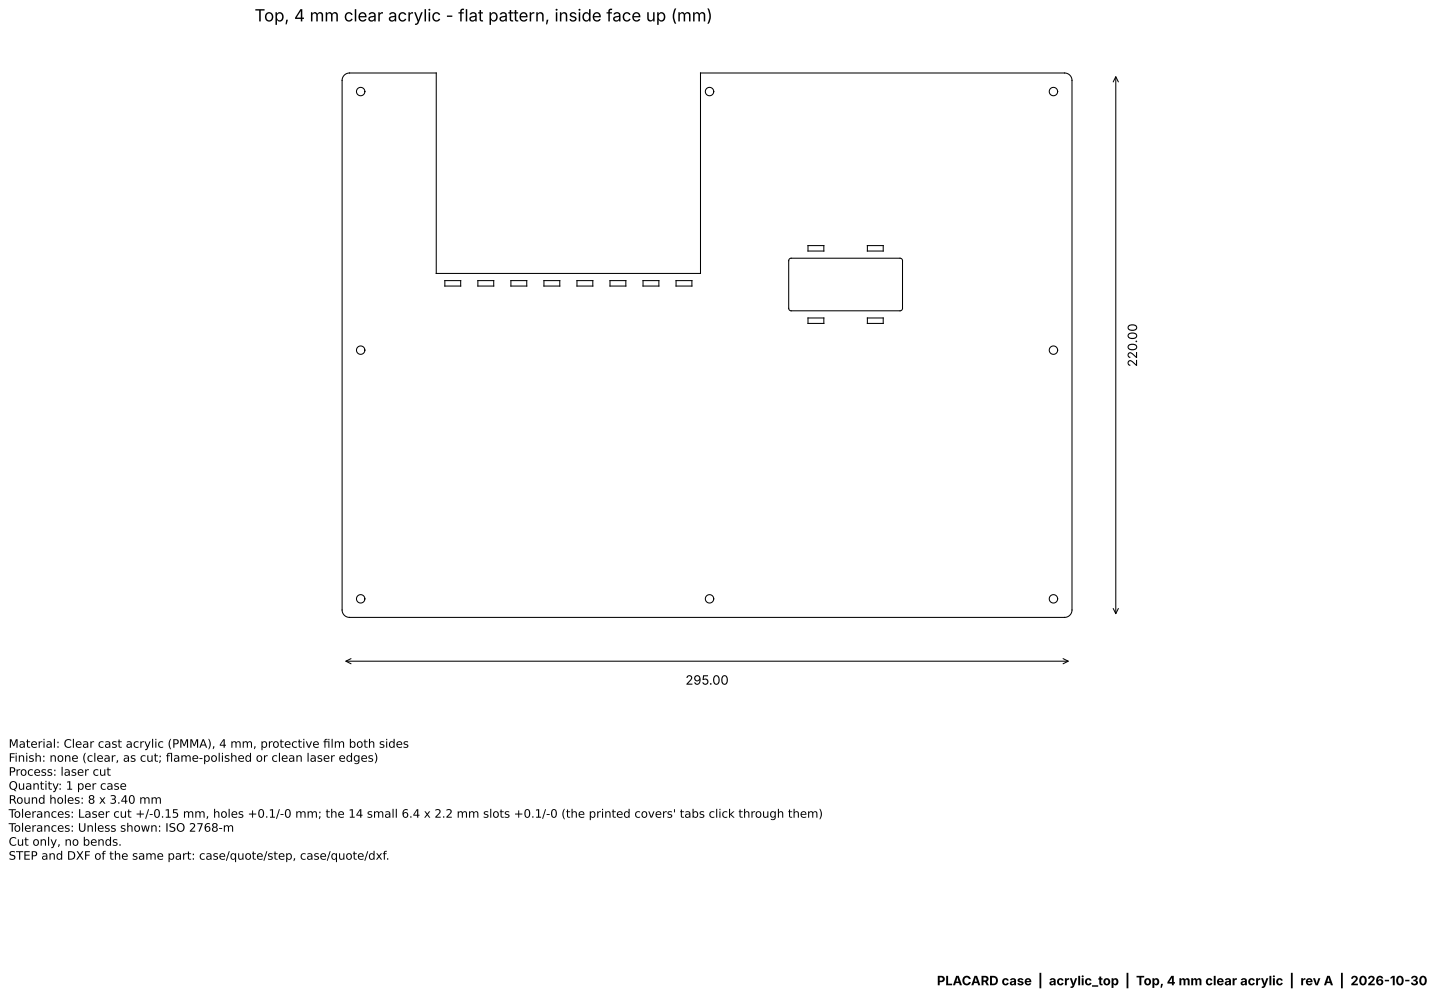
[picture p108: page 1]

Material: Clear cast acrylic (PMMA), 4 mm, protective film both sides
Finish: none (clear, as cut; flame-polished or clean laser edges)
Process: laser cut
Quantity: 1 per case
Round holes: 8 x 3.40 mm
Tolerances: Laser cut +/-0.15 mm, holes +0.1/-0 mm; the 14 small 6.4 x 2.2 mm slots +0.1/-0 (the printed covers' tabs click through them)
Tolerances: Unless shown: ISO 2768-m
Cut only, no bends.
STEP and DXF of the same part: case/quote/step, case/quote/dxf.

PLACARD case | acrylic_top | Top, 4 mm clear acrylic | rev A | 2026-10-30
