tocksin/placard/kicad/placard.kicad_pcb

## KiCad design kicad/placard.kicad_pcb (2026-11-06)

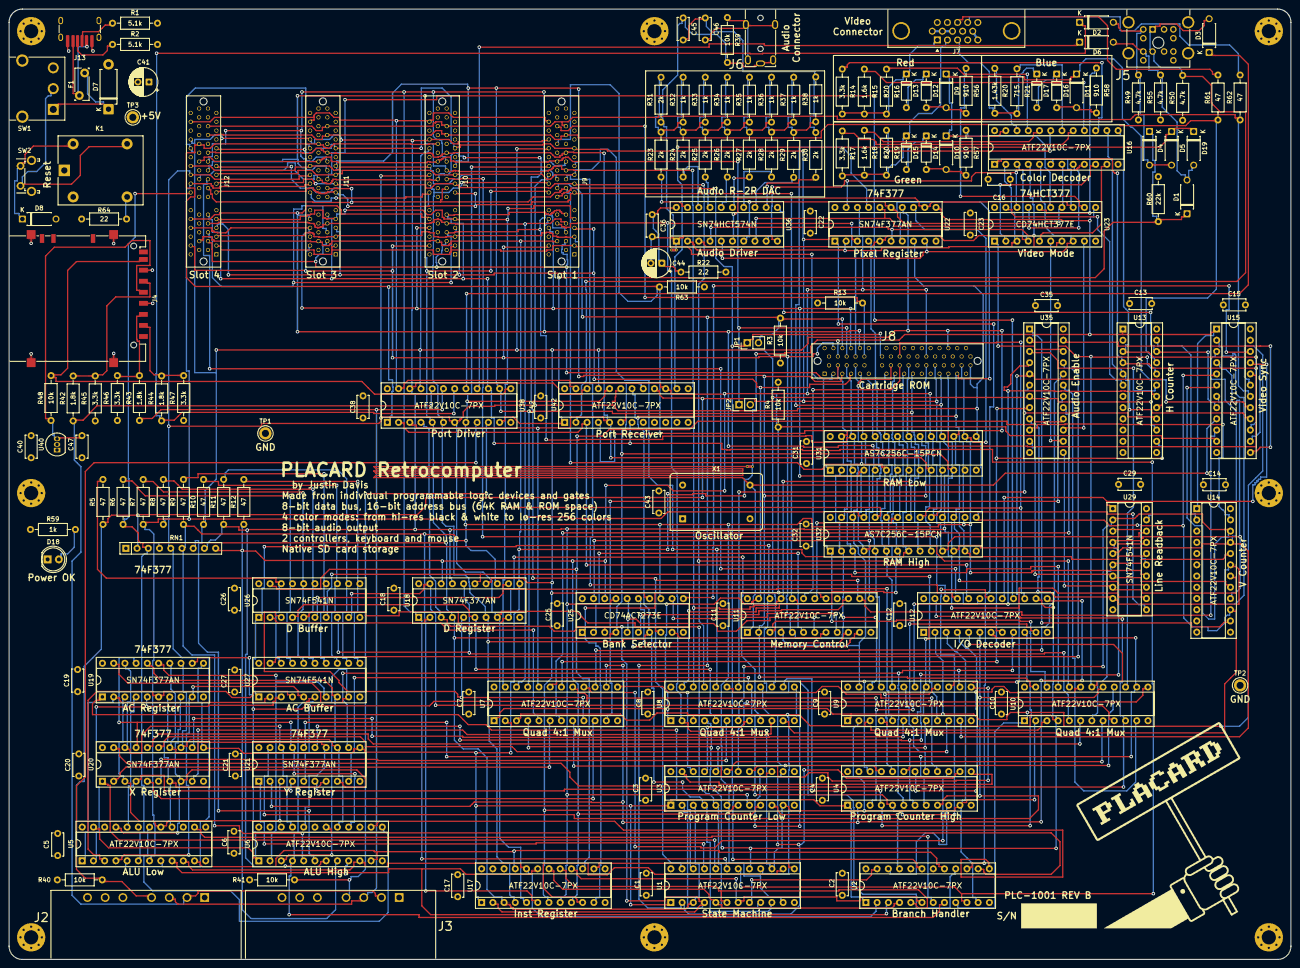
[picture p109: board placard.kicad_pcb from above]

Board: 4 copper layers, 290.0 x 215.0 mm, 187 parts (0 on the bottom side), 255 nets.

Parts:
C1, C2, C3, C4, C5, C6, C7, C8, C9, C10, C11, C12, C13, C14, C15, C16, C17, C18, C19, C20, C21, C22, C23, C25, C26, C27, C29, C31, C32, C35, C36, C38, C42, C43: 100n; C_Disc_D5.0mm_W2.5mm_P5.00mm
C40, C47: 1u; C_Disc_D5.0mm_W2.5mm_P5.00mm
C41, C44: 220u; CP_Radial_D6.3mm_P2.50mm
C45: 15n C0G; C_Disc_D5.0mm_W2.5mm_P5.00mm
C46: 22u; C_Disc_D5.0mm_W2.5mm_P5.00mm
D1, D2, D3, D4, D5, D6, D8, D9, D10, D11, D19: 1N5817; D_DO-41_SOD81_P7.62mm_Horizontal_Pad1.6
D7: SA5.0A; D_DO-15_P10.16mm_Horizontal
D12, D13, D14, D15, D16, D17: 1N4148; D_DO-35_SOD27_P7.62mm_Horizontal
D18: WP7113ID; LED_D5.0mm
F1: 3 A hold; Fuse_Bourns_MF-RG300
H1, H2, H3, H4, H5, H6, H7, H8: M3; MountingHole_3.2mm_M3_Pad_Via
J2, J3: SNES pad; SNES_Pad_Socket_Horizontal
J4: SD (SPI); SD_Hirose_DM1AA_SF_PEJ82
J5: PS/2 kbd + mouse; PS2_Kycon_KMDGX-6S-6S-S4N
J6: 3.5 mm; Jack_3.5mm_Tensility_54-00174_Horizontal
J7: VGA; DSUB-15-HD_Female_Horizontal_P2.29x1.98mm_EdgePinOffset3.03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
J8: Molex 87715-9106; Molex_87715-9106_PCIe_x4_Vertical
J9: Slot 1; Molex_87715-9106_Expansion_Slot
J10: Slot 2; Molex_87715-9106_Expansion_Slot
J11: Slot 3; Molex_87715-9106_Expansion_Slot
J12: Slot 4; Molex_87715-9106_Expansion_Slot
J13: USB4125-GF-A; USB_C_Receptacle_GCT_USB4125_6P_HandSolder
JP1: STALL; PinHeader_1x02_P2.54mm_Vertical
JP2: RUN; PinHeader_1x02_P2.54mm_Vertical
K1: J1071CS5VDC.36; Relay_SPDT_CIT_J107
LOGO1: PLACARD_Logo
NT1: AGND tie; NetTie-2_THT_Pad0.3mm
NT2: CLK tap; NetTie-2_THT_Pad0.3mm
R1, R2: 5.1k; R_Axial_DIN0207_L6.3mm_D2.5mm_P10.16mm_Horizontal_Value
R3, R4, R13, R39, R40, R41, R48, R63: 10k; R_Axial_DIN0207_L6.3mm_D2.5mm_P10.16mm_Horizontal_Value
R5, R6, R7, R8, R9, R10, R11, R12, R61, R62: 47; R_Axial_DIN0207_L6.3mm_D2.5mm_P10.16mm_Horizontal_Value
R14, R17, R45, R46, R47: 3.3k; R_Axial_DIN0207_L6.3mm_D2.5mm_P10.16mm_Horizontal_Value
R15, R18: 1.6k; R_Axial_DIN0207_L6.3mm_D2.5mm_P10.16mm_Horizontal_Value
R16, R19: 820; R_Axial_DIN0207_L6.3mm_D2.5mm_P10.16mm_Horizontal_Value
R20: 1.43k; R_Axial_DIN0207_L6.3mm_D2.5mm_P10.16mm_Horizontal_Value
R21: 715; R_Axial_DIN0207_L6.3mm_D2.5mm_P10.16mm_Horizontal_Value
R22: 2.2; R_Axial_DIN0207_L6.3mm_D2.5mm_P10.16mm_Horizontal_Value
R23, R24, R25, R26, R27, R28, R29, R30, R31: 2k; R_Axial_DIN0207_L6.3mm_D2.5mm_P10.16mm_Horizontal_Value
R32, R33, R34, R35, R36, R37, R38, R59: 1k; R_Axial_DIN0207_L6.3mm_D2.5mm_P10.16mm_Horizontal_Value
R42, R43, R44: 1.8k; R_Axial_DIN0207_L6.3mm_D2.5mm_P10.16mm_Horizontal_Value
R49, R50, R55: 4.7k; R_Axial_DIN0207_L6.3mm_D2.5mm_P10.16mm_Horizontal_Value
R56, R57, R58: 910; R_Axial_DIN0207_L6.3mm_D2.5mm_P10.16mm_Horizontal_Value
R60: 22k; R_Axial_DIN0207_L6.3mm_D2.5mm_P10.16mm_Horizontal_Value
R64: 22; R_Axial_DIN0207_L6.3mm_D2.5mm_P10.16mm_Horizontal_Value
RN1: 10k; R_Array_SIP9
SW1: ANT11TFHQE; SW_Toggle_CIT_ANT11TFHQE
SW2: PTS645VL58-2 LFS; SW_Tactile_SPST_Angled_PTS645Vx58-2LFS
TP1, TP2: GND; TestPoint_Keystone_5010-5014_Multipurpose
TP3: +5V; TestPoint_Keystone_5010-5014_Multipurpose
U1, U2, U3, U4, U5, U6, U7, U8, U9, U10, U11, U12, U13, U14, U15, U16, U17, U35, U38, U42: ATF22V10C-7PX; DIP-24_W7.62mm_Socket_Puller
U18, U19, U20, U21, U22: SN74F377AN; DIP-20_W7.62mm_Socket_Puller
U23: CD74HCT377E; DIP-20_W7.62mm_Socket_Puller
U25: CD74ACT273E; DIP-20_W7.62mm_Socket_Puller
U26, U27, U29: SN74F541N; DIP-20_W7.62mm_Socket_Puller
U31, U32: AS7C256C-15PCN; DIP-28_W7.62mm_Socket_Puller
U36: SN74HCT574N; DIP-20_W7.62mm_Socket_Puller
U40: MCP1700-3302E/TO; TO-92_Inline
X1: 25.175 MHz; Oscillator_DIP-14

Connections:
+3V3: C47.1, J4.4 (VDD), R48.1, U40.3 (VO)
+5V: C1.1, C2.1, C3.1, C4.1, C5.1, C6.1, C7.1, C8.1, C9.1, C10.1, C11.1, C12.1, C13.1, C14.1, C15.1, C16.1, C17.1, C18.1, C19.1, C20.1, C21.1, C22.1, C23.1, C25.1, C26.1, C27.1, C29.1, C31.1, C32.1, C35.1, C38.1, C40.1, C41.1, C42.1, C43.1, J2.1 (+5V), J3.1 (+5V), J5.A4 (+5V), J5.B4 (+5V), J8.A2 (+5V), J8.B2 (+5V), J9.A2 (+5V), J9.B2 (+5V), J10.A2 (+5V), J10.B2 (+5V), J11.A2 (+5V), J11.B2 (+5V), J12.A2 (+5V), J12.B2 (+5V), JP2.2 (B), K1.1, R3.1, R13.1, R22.1, R40.1, R41.1, R49.1, R50.1, R55.1, R59.1, R63.1, RN1.1 (common), TP3.1, U1.24 (VCC), U2.24 (VCC), U3.13 (CIN), U3.24 (VCC), U4.24 (VCC), U5.24 (VCC), U6.24 (VCC), U7.24 (VCC), U8.24 (VCC), U9.24 (VCC), U10.24 (VCC), U11.24 (VCC), U12.24 (VCC), U13.24 (VCC), U14.24 (VCC), U15.24 (VCC), U16.24 (VCC), U17.24 (VCC), U18.20 (VCC), U19.20 (VCC), U20.20 (VCC), U21.20 (VCC), U22.20 (VCC), U23.20 (VCC), U25.20 (VCC), U26.20 (VCC), U27.20 (VCC), U29.20 (VCC), U31.28 (VCC), U32.28 (VCC), U35.24 (VCC), U38.24 (VCC), U40.2 (VI), U42.24 (VCC), X1.14 (VCC)
/ALU and registers/F0: U5.17 (F0), U19.3 (D0), U20.3 (D0), U21.3 (D0)
/ALU and registers/F1: U5.20 (F1), U19.4 (D1), U20.4 (D1), U21.4 (D1)
/ALU and registers/F2: U5.16 (F2), U19.7 (D2), U20.7 (D2), U21.7 (D2)
/ALU and registers/F3: U5.21 (F3), U19.8 (D3), U20.8 (D3), U21.8 (D3)
/ALU and registers/F4: U6.17 (F0), U19.13 (D4), U20.13 (D4), U21.13 (D4)
/ALU and registers/F5: U6.20 (F1), U19.14 (D5), U20.14 (D5), U21.14 (D5)
/ALU and registers/F6: U6.16 (F2), U19.17 (D6), U20.17 (D6), U21.17 (D6)
/ALU and registers/F7: U6.21 (F3), U19.18 (D7), U20.18 (D7), U21.18 (D7)
/Control/BRANCH_BLOCK: U1.8 (BRANCH_BLOCK), U2.23 (BRANCH_BLOCK)
/Data bus/SRC0: R5.2, U26.18 (Y0), U27.18 (Y0)
/Data bus/SRC1: R6.2, U26.17 (Y1), U27.17 (Y1)
/Data bus/SRC2: R7.2, U26.16 (Y2), U27.16 (Y2)
/Data bus/SRC3: R8.2, U26.15 (Y3), U27.15 (Y3)
/Data bus/SRC4: R9.2, U26.14 (Y4), U27.14 (Y4)
/Data bus/SRC5: R10.2, U26.13 (Y5), U27.13 (Y5)
/Data bus/SRC6: R11.2, U26.12 (Y6), U27.12 (Y6)
/Data bus/SRC7: R12.2, U26.11 (Y7), U27.11 (Y7)
/Memory and I/O decode/RAMSEL0: U11.6 (RAMSEL0), U25.2 (Q0)
/Memory and I/O decode/RAMSEL1: U11.7 (RAMSEL1), U25.5 (Q1)
/Memory and I/O decode/RAMSEL2: U11.15 (RAMSEL2), U25.6 (Q2)
/Memory and I/O decode/RAMSEL3: U11.8 (RAMSEL3), U25.9 (Q3)
/Memory and I/O decode/RAMSEL4: U11.9 (RAMSEL4), U25.12 (Q4)
/Memory and I/O decode/RAMSEL5: U11.10 (RAMSEL5), U25.15 (Q5)
/Memory and I/O decode/RAMSEL6: U11.11 (RAMSEL6), U25.16 (Q6)
/Memory and I/O decode/RAMSEL7: U11.13 (RAMSEL7), U25.19 (Q7)
/Power and clock/VON: K1.4, SW1.2 (B), SW2.1
/Shared port/K0: D6.1 (K), U38.16 (K0)
/Shared port/KBD_CLK: D1.2 (A), D6.2 (A), D19.2 (A), J5.B5 (KCLK), R55.2
/Shared port/MOUS_CLK: D2.2 (A), D4.2 (A), D5.2 (A), J5.A5 (MCLK), R49.2
/Shared port/PAD1_DATA: J2.4 (DATA), R40.2, U38.9 (PAD1)
/Shared port/PAD2_DATA: J3.4 (DATA), R41.2, U38.10 (PAD2)
/Shared port/PS2_DATA: D3.2 (A), J5.A1 (MDATA), J5.B1 (KDATA), R50.2, U42.2 (PDATA)
/Shared port/PS2_INH: D5.1 (K), D19.1 (K), U42.14 (B)
/Shared port/P_CS: D2.1 (K), R44.1, U38.18 (SDCS)
/Shared port/P_MOSI: J2.3 (LATCH), J3.3 (LATCH), R43.1, U38.19 (/MOSIN)
/Shared port/P_PS2D: D3.1 (K), U38.17 (/DHOLD)
/Shared port/P_SCK: J2.2 (CLOCK), J3.2 (CLOCK), R42.1, U38.20 (/SCKN)
/Shared port/RXCLK: D1.1 (K), D4.1 (K), R60.1, U38.11 (RXCLK), U42.1 (RXCLK)
/Shared port/SD_MISO: J4.7 (DAT0), R48.2, U38.13 (MISO)
/Video and audio out/AUDIO: C46.2, J6.R1, J6.T, R39.1
/Video and audio out/BLU2: R20.1, U16.22 (BLU2)
/Video and audio out/BLU3: R21.1, U16.18 (BLU3)
/Video and audio out/DAC0: R23.1, U36.19 (Q0)
/Video and audio out/DAC1: R24.1, U36.18 (Q1)
/Video and audio out/DAC2: R25.1, U36.17 (Q2)
/Video and audio out/DAC3: R26.1, U36.16 (Q3)
/Video and audio out/DAC4: R27.1, U36.15 (Q4)
/Video and audio out/DAC5: R28.1, U36.14 (Q5)
/Video and audio out/DAC6: R29.1, U36.13 (Q6)
/Video and audio out/DAC7: R30.1, U36.12 (Q7)
/Video and audio out/DAC_5V: C36.1, C44.1, R22.2, U36.20 (VCC)
/Video and audio out/GRN1: R17.1, U16.17 (GRN1)
/Video and audio out/GRN2: R18.1, U16.20 (GRN2)
/Video and audio out/GRN3: R19.1, U16.19 (GRN3)
/Video and audio out/LAD7: C45.1, C46.1, R30.2, R38.2
/Video and audio out/LC0: U16.10 (MODE0), U23.2 (Q0)
/Video and audio out/LC1: U16.11 (MODE1), U23.5 (Q1)
/Video and audio out/LC4: R56.1, U23.12 (Q4)
/Video and audio out/LC5: R57.1, U23.15 (Q5)
/Video and audio out/LC6: R58.1, U23.16 (Q6)
/Video and audio out/PIX0: U16.2 (D0), U22.2 (Q0), U23.3 (D0), U36.2 (D0)
/Video and audio out/PIX1: U16.3 (D1), U22.5 (Q1), U23.4 (D1), U36.3 (D1)
/Video and audio out/PIX2: U16.4 (D2), U22.6 (Q2), U23.7 (D2), U36.4 (D2)
/Video and audio out/PIX3: U16.5 (D3), U22.9 (Q3), U23.8 (D3), U36.5 (D3)
/Video and audio out/PIX4: U16.6 (D4), U22.12 (Q4), U23.13 (D4), U36.6 (D4)
/Video and audio out/PIX5: U16.7 (D5), U22.15 (Q5), U23.14 (D5), U36.7 (D5)
/Video and audio out/PIX6: U16.8 (D6), U22.16 (Q6), U23.17 (D6), U36.8 (D6)
/Video and audio out/PIX7: U16.9 (D7), U22.19 (Q7), U23.18 (D7), U36.9 (D7)
/Video and audio out/RED1: R14.1, U16.15 (RED1)
/Video and audio out/RED2: R15.1, U16.16 (RED2)
/Video and audio out/RED3: R16.1, U16.21 (RED3)
/Video and audio out/VGA_B: D17.1 (K), J7.3, R20.2, R21.2
/Video and audio out/VGA_G: D15.1 (K), J7.2, R17.2, R18.2, R19.2
/Video and audio out/VGA_R: D13.1 (K), J7.1, R14.2, R15.2, R16.2
AC0: U5.1 (A0), U19.2 (Q0), U27.2 (A0)
AC1: U5.2 (A1), U19.5 (Q1), U27.3 (A1)
AC2: U5.3 (A2), U19.6 (Q2), U27.4 (A2)
AC3: U5.4 (A3), U19.9 (Q3), U27.5 (A3)
AC4: U5.23 (SHIFT_RIGHT_IN), U6.1 (A0), U19.12 (Q4), U27.6 (A4)
AC5: U6.2 (A1), U19.15 (Q5), U27.7 (A5)
AC6: U6.3 (A2), U19.16 (Q6), U27.8 (A6)
AC7: U2.8 (NEG), U6.4 (A3), U19.19 (Q7), U27.9 (A7)
ADDR0: J8.A22 (A0), J9.A22 (A0), J10.A22 (A0), J11.A22 (A0), J12.A22 (A0), U7.20 (LO0), U31.10 (A0), U32.10 (A0), U38.3 (A0), U42.5 (A0)
ADDR1: J8.A19 (A1), J9.A19 (A1), J10.A19 (A1), J11.A19 (A1), J12.A19 (A1), U7.21 (LO1), U31.9 (A1), U32.9 (A1), U38.14 (A1), U42.6 (A1)
ADDR2: J8.A17 (A2), J9.A17 (A2), J10.A17 (A2), J11.A17 (A2), J12.A17 (A2), U8.20 (LO0), U31.8 (A2), U32.8 (A2)
ADDR3: J8.A15 (A3), J9.A15 (A3), J10.A15 (A3), J11.A15 (A3), J12.A15 (A3), U8.21 (LO1), U31.7 (A3), U32.7 (A3)
ADDR4: J8.A14 (A4), J9.A14 (A4), J10.A14 (A4), J11.A14 (A4), J12.A14 (A4), U9.20 (LO0), U31.6 (A4), U32.6 (A4)
ADDR5: J8.B9 (A5), J9.B9 (A5), J10.B9 (A5), J11.B9 (A5), J12.B9 (A5), U9.21 (LO1), U31.5 (A5), U32.5 (A5)
ADDR6: J8.B7 (A6), J9.B7 (A6), J10.B7 (A6), J11.B7 (A6), J12.B7 (A6), U10.20 (LO0), U31.4 (A6), U32.4 (A6)
ADDR7: J8.A4 (A7), J9.A4 (A7), J10.A4 (A7), J11.A4 (A7), J12.A4 (A7), U10.21 (LO1), U31.3 (A7), U32.3 (A7)
ADDR8: J8.A8, J9.A8, J10.A8, J11.A8, J12.A8, U7.22 (HI0), U31.25 (A8), U32.25 (A8)
ADDR9: J8.A9, J9.A9, J10.A9, J11.A9, J12.A9, U7.23 (HI1), U31.24 (A9), U32.24 (A9)
ADDR10: J8.A18 (A10), J9.A18 (A10), J10.A18 (A10), J11.A18 (A10), J12.A18 (A10), U8.22 (HI0), U11.21 (A10), U31.21 (A10), U32.21 (A10)
ADDR11: J8.A13 (A11), J9.A13 (A11), J10.A13 (A11), J11.A13 (A11), J12.A13 (A11), U8.23 (HI1), U11.20 (A11), U31.23 (A11), U32.23 (A11)
ADDR12: J8.B3 (A12), J9.B3 (A12), J10.B3 (A12), J11.B3 (A12), J12.B3 (A12), U9.22 (HI0), U11.5 (A12), U31.2 (A12), U32.2 (A12)
ADDR13: J8.A6 (A13), J9.A6 (A13), J10.A6 (A13), J11.A6 (A13), J12.A6 (A13), U9.23 (HI1), U11.4 (A13), U31.26 (A13), U32.26 (A13)
ADDR14: J8.A3 (A14), J9.A3 (A14), J10.A3 (A14), J11.A3 (A14), J12.A3 (A14), U10.22 (HI0), U11.3 (A14), U31.1 (A14), U32.1 (A14)
ADDR15: J8.A5 (/CE_LO), J9.A5 (A15), J10.A5 (A15), J11.A5 (A15), J12.A5 (A15), U10.23 (HI1), U11.2 (A15), U31.20 (/CE)
CLK: J8.B4 (CLK), J9.B4 (CLK), J10.B4 (CLK), J11.B4 (CLK), J12.B4 (CLK), NT2.2, U1.1 (CLK), U2.1 (CLK), U3.1 (CLK), U4.1 (CLK), U13.1 (CLK), U14.1 (CLK), U15.1 (CLK), U17.1 (CLK), U18.11 (CP), U19.11 (CP), U20.11 (CP), U21.11 (CP), U22.11 (CP), U23.11 (CP)
CLK_E: NT2.1, U11.1 (CLK), U15.9 (CLK_E), X1.8 (OUT)
COUT: U2.14 (COUT), U6.18 (COUT)
D0: U7.5 (D0), U18.2 (Q0), U26.2 (A0)
D1: U7.9 (D1), U18.5 (Q1), U26.3 (A1)
D2: U8.5 (D0), U18.6 (Q2), U26.4 (A2)
D3: U8.9 (D1), U18.9 (Q3), U26.5 (A3)
D4: U9.5 (D0), U18.12 (Q4), U26.6 (A4)
D5: U9.9 (D1), U18.15 (Q5), U26.7 (A5)
D6: U10.5 (D0), U18.16 (Q6), U26.8 (A6)
D7: U10.9 (D1), U18.19 (Q7), U26.9 (A7)
DATABUS0: J8.A24 (D0), J9.A23 (D0), J10.A23 (D0), J11.A23 (D0), J12.A23 (D0), R5.1, RN1.2 (R1), U1.4 (DB_SRC0), U3.2 (D0), U5.5 (B0), U17.2 (D0), U18.3 (D0), U22.3 (D0), U25.3 (D0), U29.18 (Y0), U31.11 (DQ0), U32.11 (DQ0), U38.4 (D0), U42.16 (/N8)
DATABUS1: J8.A27 (D1), J9.B13 (D1), J10.B13 (D1), J11.B13 (D1), J12.B13 (D1), R6.1, RN1.3 (R2), U1.3 (DB_SRC1), U3.3 (D1), U5.6 (B1), U17.3 (D1), U18.4 (D1), U22.4 (D1), U25.4 (D1), U29.17 (Y1), U31.12 (DQ1), U32.12 (DQ1), U38.5 (D1), U42.17 (/N7)
DATABUS2: J8.A29 (D2), J9.B15 (D2), J10.B15 (D2), J11.B15 (D2), J12.B15 (D2), R7.1, RN1.4 (R3), U1.10 (DB_MEM0), U3.4 (D2), U5.7 (B2), U17.4 (D2), U18.7 (D2), U22.7 (D2), U25.7 (D2), U29.16 (Y2), U31.13 (DQ2), U32.13 (DQ2), U38.6 (D2), U42.18 (/N6)
DATABUS3: J8.A32 (D3), J9.B17 (D3), J10.B17 (D3), J11.B17 (D3), J12.B17 (D3), R8.1, RN1.5 (R4), U1.9 (DB_MEM1), U3.5 (D3), U5.8 (B3), U17.5 (D3), U18.8 (D3), U22.8 (D3), U25.8 (D3), U29.15 (Y3), U31.15 (DQ3), U32.15 (DQ3), U38.7 (D3), U42.19 (/N5)
DATABUS4: J8.A30 (D4), J9.B19 (D4), J10.B19 (D4), J11.B19 (D4), J12.B19 (D4), R9.1, RN1.6 (R5), U1.11 (DB_MEM2), U3.6 (D4), U6.5 (B0), U17.6 (D4), U18.13 (D4), U22.13 (D4), U25.13 (D4), U29.14 (Y4), U31.16 (DQ4), U32.16 (DQ4), U38.8 (D4), U42.20 (/N4)
DATABUS5: J8.B27 (D5), J9.B23 (D5), J10.B23 (D5), J11.B23 (D5), J12.B23 (D5), R10.1, RN1.7 (R6), U3.7 (D5), U6.6 (B1), U17.7 (D5), U18.14 (D5), U22.14 (D5), U25.14 (D5), U29.13 (Y5), U31.17 (DQ5), U32.17 (DQ5), U38.21 (D5), U42.21 (/N3)
DATABUS6: J8.A25 (D6), J9.B25 (D6), J10.B25 (D6), J11.B25 (D6), J12.B25 (D6), R11.1, RN1.8 (R7), U3.8 (D6), U6.7 (B2), U17.8 (D6), U18.17 (D6), U22.17 (D6), U25.17 (D6), U29.12 (Y6), U31.18 (DQ6), U32.18 (DQ6), U38.22 (D6), U42.22 (/N2)
DATABUS7: J8.B22 (D7), J9.B29 (D7), J10.B29 (D7), J11.B29 (D7), J12.B29 (D7), R12.1, RN1.9 (R8), U3.9 (D7), U6.8 (B3), U17.9 (D7), U18.18 (D7), U22.18 (D7), U25.18 (D7), U29.11 (Y7), U31.19 (DQ7), U32.19 (DQ7), U38.23 (D7), U42.15 (/A), U42.23 (/N1)
GND: C1.2, C2.2, C3.2, C4.2, C5.2, C6.2, C7.2, C8.2, C9.2, C10.2, C11.2, C12.2, C13.2, C14.2, C15.2, C16.2, C17.2, C18.2, C19.2, C20.2, C21.2, C22.2, C23.2, C25.2, C26.2, C27.2, C29.2, C31.2, C32.2, C35.2, C38.2, C40.2, C41.2, C42.2, C43.2, C47.2, D7.2 (A), D8.2 (A), D18.1 (K), J2.7 (GND), J3.7 (GND), J4.3 (VSS), J4.6 (VSS), J4.12 (SHELL1), J4.13 (SHELL2), J5.A3 (GND), J5.B3 (GND), J5.SH (SHIELD), J7.0, J7.5, J7.6, J7.7, J7.8, J7.10, J8.A1 (GND), J8.A11 (GND), J8.A21 (GND), J8.A31 (GND), J8.B1 (GND), J8.B11 (GND), J8.B21 (GND), J8.B31 (GND), J9.A1 (GND), J9.A11 (GND), J9.A12 (GND), J9.A21 (GND), J9.A31 (GND), J9.B1 (GND), J9.B11 (GND), J9.B18 (GND), J9.B21 (GND), J9.B26 (GND), J9.B30 (GND), J9.B31 (GND), J9.B32 (GND), J10.A1 (GND), J10.A11 (GND), J10.A12 (GND), J10.A21 (GND), J10.A31 (GND), J10.B1 (GND), J10.B11 (GND), J10.B18 (GND), J10.B21 (GND), J10.B26 (GND), J10.B30 (GND), J10.B31 (GND), J10.B32 (GND), J11.A1 (GND), J11.A11 (GND), J11.A12 (GND), J11.A21 (GND), J11.A31 (GND), J11.B1 (GND), J11.B11 (GND), J11.B18 (GND), J11.B21 (GND), J11.B26 (GND), J11.B30 (GND), J11.B31 (GND), J11.B32 (GND), J12.A1 (GND), J12.A11 (GND), J12.A12 (GND), J12.A21 (GND), J12.A31 (GND), J12.B1 (GND), J12.B11 (GND), J12.B18 (GND), J12.B21 (GND), J12.B26 (GND), J12.B30 (GND), J12.B31 (GND), J12.B32 (GND), J13.A12 (GND), J13.B12 (GND), J13.S1 (SHIELD), K1.2, NT1.1, R1.2, R2.2, R4.2, R45.2, R46.2, R47.2, R60.2, R64.2, TP1.1, TP2.1, U1.12 (GND), U2.12 (GND), U3.12 (GND), U4.12 (GND), U5.12 (GND), U5.13 (CIN), U6.12 (GND), U6.23 (SHIFT_RIGHT_IN), U7.12 (GND), U8.12 (GND), U9.12 (GND), U10.12 (GND), U11.12 (GND), U12.12 (GND), U13.2 (RESET), U13.12 (GND), U14.12 (GND), U15.12 (GND), U16.12 (GND), U17.12 (GND), U18.10 (GND), U19.10 (GND), U20.10 (GND), U21.10 (GND), U22.10 (GND), U23.10 (GND), U25.10 (GND), U26.10 (GND), U27.10 (GND), U29.10 (GND), U31.14 (GND), U32.14 (GND), U35.12 (GND), U38.12 (GND), U40.1 (GND), U42.12 (GND), X1.7 (GND)
GNDA: C36.2, C44.2, C45.2, J6.R2, J6.S, NT1.2, R31.1, R39.2, U36.1 (OE), U36.10 (GND)
H0: U13.3 (H0), U15.14 (H0), U16.13 (H0)
H1: U13.4 (H1), U15.15 (H1), U16.1 (H1)
H2: U13.5 (H2), U15.16 (H2), U16.14 (H2)
H3: U7.18 (V3), U13.14 (H3), U35.8 (H3)
H4: U8.15 (V2), U13.15 (H4), U35.7 (H4)
H5: U8.18 (V3), U13.16 (H5), U35.6 (H5)
H6: U9.15 (V2), U13.17 (H6), U35.5 (H6)
H7: U9.18 (V3), U13.18 (H7), U35.4 (H7)
H8: U10.15 (V2), U13.19 (H8), U35.3 (H8)
H9: U10.18 (V3), U12.5 (H9), U13.20 (H9), U35.2 (H9)
H_VIDEO_ACTIVE: U13.22 (H_VIDEO_ACTIVE), U15.8 (H_VIDEO_ACTIVE), U36.11 (Cp)
I0: U1.13 (SRC0), U17.14 (I0)
I1: U17.15 (I1), U26.19 (G2), U35.16 (I1)
I2: U1.7 (MEM0), U2.6 (M0), U17.16 (I2)
I3: U1.6 (MEM1), U2.5 (M1), U17.17 (I3)
I4: U1.5 (MEM2), U2.4 (M2), U17.18 (I4)
I5: U2.3 (I5), U5.9 (S0), U6.9 (S0), U17.19 (I5)
I6: U2.2 (I6), U5.10 (S1), U6.10 (S1), U17.20 (I6)
I7: U2.17 (I7), U5.11 (S2), U6.11 (S2), U17.21 (I7)
LC2: U23.6 (Q2), U35.14 (LC2)
LC3: U23.9 (Q3), U35.15 (LC3)
LC7: U13.6 (LC7), U23.19 (Q7)
LOAD_PC_HIGH: U2.22 (LOAD_PC_HIGH), U4.10 (LOAD)
LOAD_PC_LOW: U2.21 (LOAD_PC_LOW), U3.10 (LOAD)
unnamed: D7.1 (K), F1.2, SW1.1 (A)
unnamed: D8.1 (K), K1.5, SW2.2
unnamed: D10.2 (A), D14.2 (A), R57.2
unnamed: D11.2 (A), D16.2 (A), R58.2
unnamed: D9.2 (A), D12.2 (A), R56.2
unnamed: D12.1 (K), D13.2 (A)
unnamed: D14.1 (K), D15.2 (A)
unnamed: D16.1 (K), D17.2 (A)
unnamed: D18.2 (A), R59.2
unnamed: F1.1, J13.A9 (VBUS), J13.B9 (VBUS)
unnamed: J4.1 (CD/DAT3), R44.2, R47.1
unnamed: J4.5 (CLK), R42.2, R45.1
unnamed: J4.2 (CMD), R43.2, R46.1
unnamed: J8.B16 (/CE_HI), U12.15 (/CE_HI), U32.20 (/CE)
unnamed: J8.A16 (/ROM_OE), U11.19 (/ROM_OE)
unnamed: J13.A5 (CC1), R1.1
unnamed: J13.B5 (CC2), R2.1
unnamed: K1.3, R64.1
unnamed: R23.2, R31.2, R32.1
unnamed: R24.2, R32.2, R33.1
unnamed: R25.2, R33.2, R34.1
unnamed: R26.2, R34.2, R35.1
unnamed: R27.2, R35.2, R36.1
unnamed: R28.2, R36.2, R37.1
unnamed: R29.2, R37.2, R38.1
unnamed: U1.14 (/LOAD_INSTR), U17.10 (/LOAD_INSTR)
unnamed: U3.23 (CO), U4.13 (CIN)
unnamed: U5.18 (COUT), U6.13 (CIN)
unnamed: U11.18 (/RAM_OE), U31.22 (/OE), U32.22 (/OE)
unnamed: U13.23 (H_TC), U14.2 (EN)
unnamed: U15.13 (BLANK_RD), U35.23 (BLANK_RD)
PC0: U3.15 (Q0), U7.8 (PC0)
PC1: U3.22 (Q1), U7.13 (PC1)
PC2: U3.21 (Q2), U8.8 (PC0)
PC3: U3.16 (Q3), U8.13 (PC1)
PC4: U3.20 (Q4), U9.8 (PC0)
PC5: U3.17 (Q5), U9.13 (PC1)
PC6: U3.19 (Q6), U10.8 (PC0)
PC7: U3.18 (Q7), U10.13 (PC1)
PC8: U4.15 (Q0), U7.16 (PC2)
PC9: U4.22 (Q1), U7.19 (PC3)
PC10: U4.21 (Q2), U8.16 (PC2)
PC11: U4.16 (Q3), U8.19 (PC3)
PC12: U4.20 (Q4), U9.16 (PC2)
PC13: U4.17 (Q5), U9.19 (PC3)
PC14: U4.19 (Q6), U10.16 (PC2)
PC15: U4.18 (Q7), U10.19 (PC3), U12.4 (PC15)
PC_ENABLE: J8.B8 (PC_ENABLE), J9.B8 (BT3), U1.15 (/Q1), U2.11 (PC_ENABLE), U3.11 (EN), U4.11 (EN), U7.2 (PC_ENABLE), U8.2 (PC_ENABLE), U9.2 (PC_ENABLE), U10.2 (PC_ENABLE), U12.3 (PC_ENABLE)
PIXEL_ENABLE: J8.A7 (PIXEL_ENABLE), J9.A7 (PIXEL_ENABLE), J10.A7 (PIXEL_ENABLE), J11.A7 (PIXEL_ENABLE), J12.A7 (PIXEL_ENABLE), U2.9 (PIXEL_ENABLE), U7.1 (PIXEL_ENABLE), U8.1 (PIXEL_ENABLE), U9.1 (PIXEL_ENABLE), U10.1 (PIXEL_ENABLE), U11.23 (PIXEL_ENABLE), U12.2 (PIXEL_ENABLE), U15.19 (PIXEL_ENABLE)
Q0: J9.A10 (SEL), J10.A10 (SEL), J11.A10 (SEL), J12.A10 (SEL), U1.18 (Q0), U2.10 (Q0), U29.19 (G2), U38.15 (nc), U42.7 (nc)
RUN: J8.B6 (RUN), J9.B20 (/RESET), J10.B20 (/RESET), J11.B20 (/RESET), J12.B20 (/RESET), JP2.1 (A), R4.1, U11.17 (RUN), U15.11 (RUN), U17.11 (RUN), U25.1 (~Mr)
RW: J9.B16 (RW), J10.B16 (RW), J11.B16 (RW), J12.B16 (RW), U1.23 (/MEM_WR), U11.14 (RW), U15.10 (RW)
STALL_IN: J8.B12 (STALL_IN), J9.B12 (BT1), JP1.1 (A), U2.19 (STALL)
STALL_OUT: J8.B5 (STALL_OUT), J9.B14 (BT2), JP1.2 (B), R3.2, U1.2 (PIXEL_ENABLE), U3.14 (PIXEL_ENABLE), U4.14 (PIXEL_ENABLE)
V0: U14.14 (Q0), U35.1 (V0)
V1: U14.23 (Q1), U15.7 (V1), U35.10 (V1)
V2: U8.7 (V0), U14.22 (Q2), U15.6 (V2), U29.2 (A0)
V3: U8.11 (V1), U14.15 (Q3), U15.5 (V3), U29.3 (A1)
V4: U9.7 (V0), U14.16 (Q4), U15.4 (V4), U29.4 (A2)
V5: U9.11 (V1), U14.21 (Q5), U15.3 (V5), U29.5 (A3)
V6: U10.7 (V0), U14.20 (Q6), U29.6 (A4)
V7: U14.17 (Q7), U29.7 (A5), U35.11 (V7)
V8: U14.18 (Q8), U29.8 (A6), U35.13 (V8)
V9: U14.19 (Q9), U15.2 (V9), U29.9 (A7), U35.9 (V9)
VA0: U7.7 (V0), U35.17 (R0)
VA1: U7.11 (V1), U35.18 (R1)
VA7: U10.11 (V1), U35.19 (R7)
VA8: U7.15 (V2), U35.20 (R8)
VIDEN: D9.1 (K), D10.1 (K), D11.1 (K), U15.17 (VIDEN), U16.23 (VIDEN)
X0: U7.6 (X0), U20.2 (Q0)
X1: U7.10 (X1), U20.5 (Q1)
X2: U8.6 (X0), U20.6 (Q2)
X3: U8.10 (X1), U20.9 (Q3)
X4: U9.6 (X0), U20.12 (Q4)
X5: U9.10 (X1), U20.15 (Q5)
X6: U10.6 (X0), U20.16 (Q6)
X7: U10.10 (X1), U12.23 (Q0), U20.19 (Q7)
X_ENABLE: U1.16 (X_ENABLE), U7.3 (X_ENABLE), U8.3 (X_ENABLE), U9.3 (X_ENABLE), U10.3 (X_ENABLE)
Y0: U4.2 (D0), U7.14 (Y2), U12.13 (A8), U21.2 (Q0)
Y1: U4.3 (D1), U7.17 (Y3), U12.11 (A9), U21.5 (Q1)
Y2: U4.4 (D2), U8.14 (Y2), U12.10 (A10), U21.6 (Q2)
Y3: U4.5 (D3), U8.17 (Y3), U12.18 (A11), U21.9 (Q3)
Y4: U4.6 (D4), U9.14 (Y2), U12.9 (A12), U21.12 (Q4)
Y5: U4.7 (D5), U9.17 (Y3), U12.8 (A13), U21.15 (Q5)
Y6: U4.8 (D6), U10.14 (Y2), U12.7 (A14), U21.16 (Q6)
Y7: U4.9 (D7), U10.17 (Y3), U12.6 (Y7), U21.19 (Q7)
Y_ENABLE: U1.17 (Y_ENABLE), U7.4 (Y_ENABLE), U8.4 (Y_ENABLE), U9.4 (Y_ENABLE), U10.4 (Y_ENABLE), U12.14 (Y_ENABLE)
Z_HIGH: U2.13 (Z_HIGH), U6.14 (Z)
Z_LOW: U2.7 (Z_LOW), U5.14 (Z)
~AC_SEL: U27.19 (G2), U35.21 (/AC_SEL)
~CART: J8.B10 (/CART), J9.B28 (BT5), R13.2
~EXP1: J9.A16 (/EXP), U12.21 (/EXP1)
~EXP2: J10.A16 (/EXP), U12.22 (/EXP2)
~EXP3: J11.A16 (/EXP), U12.16 (/MAP_WR)
~EXP4: J12.A16 (/EXP), U12.19 (/PORT_WR)
~HSYNC: J9.A26 (/HSYNC), J10.A26 (/HSYNC), J11.A26 (/HSYNC), J12.A26 (/HSYNC), R61.1, U13.21 (/HSYNC)
~LOAD_AC: U1.22 (/LOAD_AC), U19.1 (~E)
~LOAD_IMM: J9.A20 (LOAD_IMM), J10.A20 (LOAD_IMM), J11.A20 (LOAD_IMM), J12.A20 (LOAD_IMM), U1.19 (/LOAD_IMM), U18.1 (~E)
~LOAD_X: U1.20 (/LOAD_X), U20.1 (~E)
~LOAD_Y: U1.21 (/LOAD_Y), U21.1 (~E)
~MAP_WR: U15.22 (nc), U25.11 (Cp)
~MODE_LD: U23.1 (~E), U35.22 (/MODE_LD)
~P0: U12.17 (/LINE_RD), U15.21 (nc), U29.1 (G1)
~PIX_LD: U2.15 (/PIX_LD), U22.1 (~E)
~PORT: U12.20 (/PORT_RD), U38.2 (/PORT_RD), U42.3 (/PORT_RD)
~SRC_EN: U2.16 (/SRC_EN), U11.22 (/SRC_EN), U26.1 (G1), U27.1 (G1)
~VGA_HSYNC: J7.13, R61.2
~VGA_VSYNC: J7.14, R62.2
~VSYNC: J9.A28 (/VSYNC), J10.A28 (/VSYNC), J11.A28 (/VSYNC), J12.A28 (/VSYNC), R62.1, U15.18 (/VSYNC)
~WE: J9.B24 (/WE), J10.B24 (/WE), J11.B24 (/WE), J12.B24 (/WE), R63.2, U15.20 (/WE), U31.27 (/WE), U32.27 (/WE), U38.1 (/PORT_WR), U42.4 (/PORT_WR)
