tocksin/placard/kicad/cartridge_32k/cartridge_32k.kicad_pcb

## KiCad design kicad/cartridge_32k/cartridge_32k.kicad_pcb (2026-11-06)

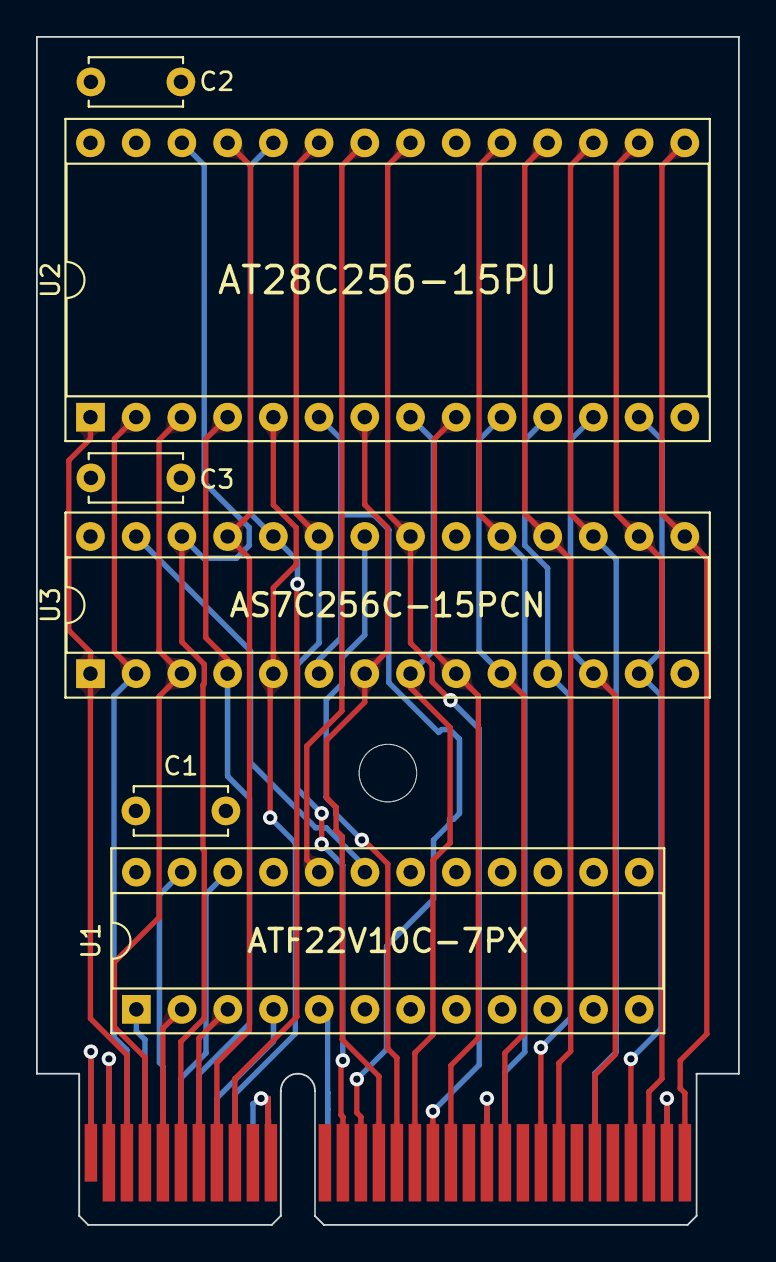
[picture p110: board cartridge_32k.kicad_pcb from above]

Board: 4 copper layers, 39.0 x 66.0 mm, 8 parts (0 on the bottom side), 35 nets.

Parts:
C1, C2, C3: 100n; C_Disc_D5.0mm_W2.5mm_P5.00mm
H1: M3; MountingHole_3.2mm_M3
J1: Card edge (87715-9106 mate); Card_Edge_87715-9106
U1: ATF22V10C-7PX; DIP-24_W7.62mm_Socket_Puller
U2: AT28C256-15PU; DIP-28_W15.24mm_Socket_Puller
U3: AS7C256C-15PCN; DIP-28_W7.62mm_Socket_Puller

Connections:
+5V: C1.1, C2.1, C3.1, J1.A2 (+5V), J1.B2 (+5V), U1.24 (VCC), U2.27 (~WE), U2.28 (VCC), U3.28 (VCC)
/ADDR0: J1.A22 (A0), U2.10 (A0), U3.10 (A0)
/ADDR1: J1.A19 (A1), U2.9 (A1), U3.9 (A1)
/ADDR2: J1.A17 (A2), U2.8 (A2), U3.8 (A2)
/ADDR3: J1.A15 (A3), U2.7 (A3), U3.7 (A3)
/ADDR4: J1.A14 (A4), U2.6 (A4), U3.6 (A4)
/ADDR5: J1.B9 (A5), U2.5 (A5), U3.5 (A5)
/ADDR6: J1.B7 (A6), U2.4 (A6), U3.4 (A6)
/ADDR7: J1.A4 (A7), U2.3 (A7), U3.3 (A7)
/ADDR8: J1.A8, U2.25 (A8), U3.25 (A8)
/ADDR9: J1.A9, U2.24 (A9), U3.24 (A9)
/ADDR10: J1.A18 (A10), U2.21 (A10), U3.21 (A10)
/ADDR11: J1.A13 (A11), U2.23 (A11), U3.23 (A11)
/ADDR12: J1.B3 (A12), U2.2 (A12), U3.2 (A12)
/ADDR13: J1.A6 (A13), U2.26 (A13), U3.26 (A13)
/ADDR14: J1.A3 (A14), U2.1 (A14), U3.1 (A14)
/DATABUS0: J1.A24 (D0), U2.11 (D0), U3.11 (DQ0)
/DATABUS1: J1.A27 (D1), U2.12 (D1), U3.12 (DQ1)
/DATABUS2: J1.A29 (D2), U2.13 (D2), U3.13 (DQ2)
/DATABUS3: J1.A32 (D3), U2.15 (D3), U3.15 (DQ3)
/DATABUS4: J1.A30 (D4), U2.16 (D4), U3.16 (DQ4)
/DATABUS5: J1.B27 (D5), U2.17 (D5), U3.17 (DQ5)
/DATABUS6: J1.A25 (D6), U2.18 (D6), U3.18 (DQ6)
/DATABUS7: J1.B22 (D7), U2.19 (D7), U3.19 (DQ7)
/~CE_LO: J1.A5 (/CE_LO), U1.2 (A15)
/~EE_OE: U1.20 (/EE_OE), U2.22 (~OE)
/~ROM_OE: J1.A16 (/ROM_OE), U3.22 (/OE)
/~SR_WE: U1.19 (/SR_WE), U3.27 (/WE)
GND: C1.2, C2.2, C3.2, J1.A1 (GND), J1.A11 (GND), J1.A21 (GND), J1.A31 (GND), J1.B1 (GND), J1.B10 (/CART), J1.B11 (GND), J1.B21 (GND), J1.B31 (GND), U1.12 (GND), U2.14 (GND), U2.20 (~CS), U3.14 (GND), U3.20 (/CE)
unnamed: J1.B4 (CLK), U1.1 (CLK)
unnamed: J1.B8 (PC_ENABLE), U1.4 (PC_ENABLE)
unnamed: J1.A7 (PIXEL_ENABLE), U1.3 (PIXEL_ENABLE)
unnamed: J1.B6 (RUN), U1.22 (RUN)
unnamed: J1.B12 (STALL_IN), U1.5 (STALL_IN)
unnamed: J1.B5 (STALL_OUT), U1.23 (STALL_OUT)
