tocksin/placard/src/hdl/state_pld.vhd

-- ============================================================
-- STATE_CTRL  (VHDL conversion of ATF22V10_STATE.pld, Rev 15)
-- Rev 15 is the same logic as Rev 13; Rev 14 (opcode byte stored XOR FDh) was reverted 2026-10-21.
-- Date: 10/21/2026
--
-- Binary state machine:  Q1 Q0
--     00 FETCH, 01 LOAD_IMM, 10 LOAD_MEM, 11 EXEC
--
-- Zero-page ([0,D]) accesses chain LOAD_IMM (operand byte -> D)
-- into LOAD_MEM (D used as the address).
--
-- Rev 10: a store from AC or X to [0,X] or [Y,X] goes FETCH ->
-- LOAD_MEM -> EXEC, so the write clock's address, source bus and
-- instruction FF are a clock old (see the PLD source).  Q0 moved to
-- pin 18 and load_instr to pin 14 for product terms.
--
-- Rev 11: source 1x with mem = 101 always goes FETCH -> LOAD_IMM.
-- BGE with an AC or X target has a pad byte after the opcode, so
-- branch_block is no longer used in FETCH.
-- (Branch PLD Rev 11 made memory field 101 BCC, branch if carry
-- clear, in place of BGE; the pad byte and these equations stay.)
--
-- Rev 12: mem_wr no longer has "not pixel_enable" (pixel_enable here is
-- STALL).  The memory control PLD blocks the write strobe during a video
-- stall with the real PIXEL_ENABLE, so mem_rw settles early in the clock.
--
-- Rev 13: the five load strobes (pins 14, 19-22) are declared active
-- low, because each drives a 74F377 /E (load when low).  The ports are
-- load_instr_n, load_imm_n, load_x_n, load_y_n and load_ac_n; the
-- equations are unchanged.
--
-- Equations are transcribed directly from the PLD source
-- without optimization.  All pins are kept as individual
-- std_logic signals.
--
-- Pin 15 is !Q1 (= PC_ENABLE) and pin 23 is !MEM_WR (= R/W,
-- 1 = read), exactly as declared in the PLD.
-- PC_INC is not generated here: PC_INC = pc_enable and not pixel_enable.
--
-- branch_block (pin 8, from the branch PLD) inhibits load_ac, load_x,
-- load_y and the memory write in EXEC while a branch/jump executes.
-- ============================================================

library ieee;
use ieee.std_logic_1164.all;

entity state_pld is
    port (
        clk          : in  std_logic;   -- pin 1
        pixel_enable : in  std_logic;   -- pin 2, STALL from the branch PLD (pixel enable or ALU wait)
        db_src1      : in  std_logic;   -- pin 3, data bus bit 1 (instruction being fetched)
        db_src0      : in  std_logic;   -- pin 4, data bus bit 0 (instruction being fetched)
        mem2         : in  std_logic;   -- pin 5, memory field bit 2 (from instruction FF)
        mem1         : in  std_logic;   -- pin 6
        mem0         : in  std_logic;   -- pin 7
        branch_block : in  std_logic;   -- pin 8, from branch PLD (1 = branch/jump executing)
        db_mem1      : in  std_logic;   -- pin 9, data bus bit 3 (instruction being fetched)
        db_mem0      : in  std_logic;   -- pin 10, data bus bit 2
        db_mem2      : in  std_logic;   -- pin 11, data bus bit 4
        src0         : in  std_logic;   -- pin 13, source field bit 0 (from instruction FF)

        q0           : out std_logic;   -- pin 18, state bit 0
        pc_enable    : out std_logic;   -- pin 15, = not q1
        x_enable     : out std_logic;   -- pin 16, registered
        y_enable     : out std_logic;   -- pin 17, registered
        load_instr_n : out std_logic;   -- pin 14, low = load (F377 /E)
        load_imm_n   : out std_logic;   -- pin 19, low = load (F377 /E)
        load_x_n     : out std_logic;   -- pin 20, low = load (F377 /E)
        load_y_n     : out std_logic;   -- pin 21, low = load (F377 /E)
        load_ac_n    : out std_logic;   -- pin 22, low = load (F377 /E)
        mem_rw       : out std_logic    -- pin 23, 1 = read, 0 = write
    );
end entity state_pld;

architecture rtl of state_pld is

    -- Internal copies of the state registers so they can be
    -- read back inside the architecture.  Registers power up
    -- to 0 (FETCH), as on the ATF22V10C.
    signal q0_r     : std_logic := '0';
    signal q1_r     : std_logic := '0';
    signal x_enable_r : std_logic := '0';
    signal y_enable_r : std_logic := '0';

    signal s_fetch  : std_logic;
    signal s_limm   : std_logic;
    signal s_lmem   : std_logic;
    signal s_exec   : std_logic;

    signal dest_ac  : std_logic;
    signal dest_x   : std_logic;
    signal dest_y   : std_logic;
    signal dest_ram : std_logic;

    signal mem_wr   : std_logic;

    -- load strobes as logical true (the pins are their inverse, Rev 13)
    signal load_instr : std_logic;
    signal load_imm   : std_logic;
    signal load_x     : std_logic;
    signal load_y     : std_logic;
    signal load_ac    : std_logic;

begin

    -- --------------------------------------------------------
    -- State decode
    -- --------------------------------------------------------
    s_fetch <= not q1_r and not q0_r;
    s_limm  <= not q1_r and q0_r;
    s_lmem  <= q1_r and not q0_r;
    s_exec  <= q1_r and q0_r;

    -- --------------------------------------------------------
    -- State registers
    -- --------------------------------------------------------
    process (clk)
    begin
        if rising_edge(clk) then
            q0_r <= (q0_r and pixel_enable)
                 or (s_fetch and not pixel_enable and db_src1 and not db_mem1)
                 or (s_fetch and not pixel_enable and db_src1 and not db_mem2)
                 or (s_fetch and not pixel_enable and not db_src1 and not db_src0)
                 or (s_fetch and not pixel_enable and not db_mem1 and not db_mem0)
                 or (s_fetch and not pixel_enable and not db_mem2 and db_mem1 and db_mem0)
                 or (s_limm  and not pixel_enable and not src0)
                 or (s_limm  and not pixel_enable and mem2 and not mem1 and mem0)
                 or (s_lmem  and not pixel_enable);

            q1_r <= (q1_r and pixel_enable)
                 or (s_fetch and not pixel_enable and not db_src1 and db_src0 and not db_mem1 and db_mem0)
                 or (s_fetch and not pixel_enable and not db_src1 and db_src0 and db_mem2 and db_mem1)
                 or (s_fetch and not pixel_enable and not db_src1 and db_src0 and not db_mem2 and db_mem1 and not db_mem0)
                 or (s_fetch and not pixel_enable and db_src1 and not db_mem2)
                 or (s_fetch and not pixel_enable and db_src1 and db_mem1)
                 or (s_fetch and not pixel_enable and db_src1 and not db_mem0)
                 or (s_limm  and not pixel_enable)
                 or (s_lmem  and not pixel_enable);

            -- Memory-mode address selects (registered).
            -- Loaded from the data bus memory field on a FETCH clock the
            -- CPU owns (the same condition as load_instr), held otherwise.
            x_enable_r <= (s_fetch and not pixel_enable and not db_mem2 and not db_mem1 and db_mem0)
                       or (s_fetch and not pixel_enable and not db_mem2 and db_mem1 and not db_mem0)
                       or (s_fetch and not pixel_enable and db_mem2 and db_mem1 and not db_mem0)
                       or (s_fetch and not pixel_enable and db_mem2 and db_mem1 and db_mem0)
                       or (q1_r and x_enable_r)
                       or (q0_r and x_enable_r)
                       or (pixel_enable and x_enable_r);

            y_enable_r <= (s_fetch and not pixel_enable and not db_mem2 and db_mem1 and not db_mem0)
                       or (s_fetch and not pixel_enable and db_mem2 and db_mem1 and db_mem0)
                       or (q1_r and y_enable_r)
                       or (q0_r and y_enable_r)
                       or (pixel_enable and y_enable_r);
        end if;
    end process;

    q0        <= q0_r;
    pc_enable <= not q1_r;

    -- --------------------------------------------------------
    -- Memory field decode
    -- --------------------------------------------------------
    x_enable <= x_enable_r;
    y_enable <= y_enable_r;

    dest_ac  <= (not mem2 and not mem1 and not mem0)
             or (not mem2 and not mem1 and mem0)
             or (not mem2 and mem1 and not mem0);

    dest_x   <= not mem2 and mem1 and mem0;

    dest_y   <= mem2 and not mem1 and not mem0;

    dest_ram <= (mem2 and not mem1 and mem0)
             or (mem2 and mem1 and not mem0)
             or (mem2 and mem1 and mem0);

    -- --------------------------------------------------------
    -- Strobes
    -- --------------------------------------------------------
    load_instr <= s_fetch and not pixel_enable;

    load_imm   <= (s_limm and not pixel_enable)
               or (s_lmem and not pixel_enable);

    load_ac    <= s_exec and not pixel_enable and not branch_block and dest_ac;

    load_x     <= s_exec and not pixel_enable and not branch_block and dest_x;

    load_y     <= s_exec and not pixel_enable and not branch_block and dest_y;

    mem_wr     <= s_exec and not branch_block and dest_ram;

    mem_rw     <= not mem_wr;

    -- Rev 13: the strobe pins are active low (F377 /E)
    load_instr_n <= not load_instr;
    load_imm_n   <= not load_imm;
    load_x_n     <= not load_x;
    load_y_n     <= not load_y;
    load_ac_n    <= not load_ac;

end architecture rtl;
