tocksin/placard/src/hdl/mem_ctrl_pld.vhd

-- ============================================================
-- MEMORY READ ENABLES
-- VHDL conversion of ATF22V10_MEM_CTRL.pld (revision 10)
-- Date: 11/02/2026
--
-- Revision 10: /WE is gone (pin 16 free).  The Sync PLD (revision 10)
-- makes it from an early clock tap, CLK_E, so it is back high before
-- the address can change now that the address muxes take their
-- selects directly (docs/timing/FETCH_TIMING.md).
--
-- Replaces the '32 OR gate (/WE = RW or CLK) and the read enables
-- of ROM/RAM select revision 03.  Every memory bus cycle uses the
-- low half of the clock only, so the memories never drive the data
-- bus in the high half (see the PLD source and docs/timing/TIMING.md).
--
-- Revision 06: the RAM write-data buffer is gone and the source bus is
-- the data bus.  The source F541s drive it in EXEC with pixelEnable = 0,
-- so srcEn (pin 22, branch PLD pin 16) blocks CPU reads then.
-- Revision 07: pin 22 is active low (srcEnN), as the branch PLD's pin 16
-- became when the source '138 was removed.
--
-- Revision 08: pin 17 is an input, run, from the ROM cartridge: low
-- while the cartridge loads its SRAM.  romOeN stays high while run is
-- low (romRead = cpuRead and run).  run also drives the map register's
-- /MR and the cards' /RESET, so the mapRun register is gone.
--
-- Revision 02 (until revision 08): mapRun (pin 19) is a register that powers up to 0 and
-- loads 1 on every clock, so it is low from power-up to the first
-- clock.  It drives /MR of the 74ACT273 map register, which clears the
-- map to all ROM before the CPU starts.
--
-- Revision 03: ramsel2 (pin 15) maps 4000h-4FFFh like the other
-- sections (it was always RAM).  romOeN moved to pin 19 and mapRun to
-- pin 17.
--
-- Revision 04: a video read (pixelEnable = 1) always reads the RAM;
-- only CPU reads follow the map, so the CPU can run from the ROM under
-- the video area while the video shows the RAM.
--
-- Revision 05: the I/O window is 5000h-53FFh.  a11 (pin 20) and a10
-- (pin 21) let 5400h-5FFFh be memory again, mapped by ramsel2, and
-- read by the video (mode bytes and the audio buffer).
--
--     write  = not rw and not pixelEnable
--     cpuRead   = rw and not pixelEnable and srcEnN
--     videoRead = pixelEnable
--     weN    = low while clk = 0 and a write   (Sync PLD since revision 10)
--     romOeN = low while clk = 0, run = 1 and a CPU read of a ROM section
--     ramOeN = low while clk = 0 and a CPU read of a RAM section,
--              or a video read
--              (section 2 is mapped for 4000h-4FFFh and 5400h-5FFFh;
--              neither memory reads in the I/O window 5000h-53FFh)
--
-- rw is State PLD pin 23 (Rev 12: low for the whole EXEC state of a
-- store).  pixelEnable is the Sync PLD's PIXEL_ENABLE, not STALL.
--
-- Equations are transcribed directly from the PLD source
-- without optimization.  All pins are kept as individual
-- std_logic signals.
--
-- Pin assignments (ATF22V10C):
--   1  clk         2  a15        3  a14        4  a13       5  a12
--   6  ramsel0     7  ramsel1    8  ramsel3    9  ramsel4  10  ramsel5
--  11  ramsel6    13  ramsel7   14  rw        15  ramsel2
--  20  a11        21  a10       23  pixelEnable
--  16  free       17  run       18  ramOeN    19  romOeN
--  22  srcEnN
-- ============================================================

library ieee;
use ieee.std_logic_1164.all;

entity mem_ctrl_pld is
    port (
        clk         : in  std_logic;   -- pin 1, CPU clock (array input only)
        a15         : in  std_logic;   -- pin 2
        a14         : in  std_logic;   -- pin 3
        a13         : in  std_logic;   -- pin 4
        a12         : in  std_logic;   -- pin 5
        ramsel0     : in  std_logic;   -- pin 6, map from the 74ACT273 map register
        ramsel1     : in  std_logic;   -- pin 7
        ramsel3     : in  std_logic;   -- pin 8
        ramsel4     : in  std_logic;   -- pin 9
        ramsel5     : in  std_logic;   -- pin 10
        ramsel6     : in  std_logic;   -- pin 11
        ramsel7     : in  std_logic;   -- pin 13
        ramsel2     : in  std_logic;   -- pin 15 (I/O pin used as input)
        rw          : in  std_logic;   -- pin 14, State PLD pin 23, 0 = store
        pixelEnable : in  std_logic;   -- pin 23, Sync PLD PIXEL_ENABLE
        a11         : in  std_logic;   -- pin 20 (I/O pin used as input, revision 05)
        a10         : in  std_logic;   -- pin 21 (I/O pin used as input, revision 05)
        srcEnN      : in  std_logic;   -- pin 22, branch PLD pin 16, 0 = source F541s drive the bus (revision 07)
        run         : in  std_logic;   -- pin 17, ROM cartridge, 0 = loading (revision 08)

        romOeN      : out std_logic;   -- pin 19, ROM /OE
        ramOeN      : out std_logic    -- pin 18, RAM /OE
    );
end entity mem_ctrl_pld;

architecture rtl of mem_ctrl_pld is

    -- section decode
    signal sec0 : std_logic;
    signal sec1 : std_logic;
    signal sec2 : std_logic;
    signal sec3 : std_logic;
    signal sec4 : std_logic;
    signal sec5 : std_logic;
    signal sec6 : std_logic;
    signal sec7 : std_logic;

    signal cpuRead   : std_logic;
    signal videoRead : std_logic;
    signal romRead   : std_logic;
    signal romOe   : std_logic;
    signal ramOe   : std_logic;

begin

    -- ---------------- section decode ----------------

    sec0 <= (not a15) and (not a14) and (not a13);
    sec1 <= (not a15) and (not a14) and (    a13);
    sec2 <= (not a15) and (    a14) and (not a13);
    sec3 <= (not a15) and (    a14) and (    a13);
    sec4 <= (    a15) and (not a14) and (not a13);
    sec5 <= (    a15) and (not a14) and (    a13);
    sec6 <= (    a15) and (    a14) and (not a13);
    sec7 <= (    a15) and (    a14) and (    a13);

    -- ---------------- bus cycle ----------------

    cpuRead   <= (not clk) and rw and (not pixelEnable) and srcEnN;
    videoRead <= (not clk) and pixelEnable;

    -- ---------------- equations ----------------

    romRead <= cpuRead and run;

    romOe <= (sec0 and (not ramsel0) and romRead)
          or (sec1 and (not ramsel1) and romRead)
          or (sec2 and (not a12) and (not ramsel2) and romRead)
          or (sec2 and a11 and (not ramsel2) and romRead)
          or (sec2 and a10 and (not ramsel2) and romRead)
          or (sec3 and (not ramsel3) and romRead)
          or (sec4 and (not ramsel4) and romRead)
          or (sec5 and (not ramsel5) and romRead)
          or (sec6 and (not ramsel6) and romRead)
          or (sec7 and (not ramsel7) and romRead);

    ramOe <= (sec0 and ramsel0 and cpuRead)
          or (sec1 and ramsel1 and cpuRead)
          or (sec2 and (not a12) and ramsel2 and cpuRead)
          or (sec2 and a11 and ramsel2 and cpuRead)
          or (sec2 and a10 and ramsel2 and cpuRead)
          or (sec3 and ramsel3 and cpuRead)
          or (sec4 and ramsel4 and cpuRead)
          or (sec5 and ramsel5 and cpuRead)
          or (sec6 and ramsel6 and cpuRead)
          or (sec7 and ramsel7 and cpuRead)
          or (a15 and videoRead)
          or ((not a14) and videoRead)
          or (a13 and videoRead)
          or ((not a12) and videoRead)
          or (a11 and videoRead)
          or (a10 and videoRead);

    romOeN <= not romOe;
    ramOeN <= not ramOe;

end architecture rtl;
