tocksin/placard/src/hdl/sync_pld.vhd

--------------------------------------------------------------------------------
-- Name     VGA_SYNC
-- PartNo   01
-- Date     2026-11-03
-- Revision 12
-- Designer Justin
-- Company
-- Assembly
-- Location
-- Device   ATF22V10C (CUPL: g22v10)
--
-- Converted from WinCUPL source ATF22V10_SYNC.pld (Revision 12)
--
-- Revision 12: /MAP_WR (pin 22), the map register clock, moved here from
-- the I/O decode PLD (rev 07), made from the page 0 select /P0 (pin 21)
-- with the /WE equation.
--
-- Pin assignments (ATF22V10C, 24-pin DIP/SOIC; pin 12 = GND, pin 24 = VCC):
--   PIN 1  = CLK
--   PIN 2  = V9
--   PIN 3  = V5
--   PIN 4  = V4
--   PIN 5  = V3
--   PIN 6  = V2
--   PIN 7  = V1
--   PIN 8  = H_VIDEO_ACTIVE
--   PIN 9  = CLK_E             (early clock tap, revision 10; was PC_ENABLE)
--   PIN 10 = RW                (revision 10; was Y_ENABLE)
--   PIN 11 = RUN               (revision 10; was X_ENABLE)
--   PIN 13 = BLANK_RD
--
--   PIN 14 = H0                (registered output)
--   PIN 15 = H1                (registered output)
--   PIN 16 = H2                (registered output)
--   PIN 17 = VIDEN             (registered output; VIDEO_ACTIVE before revision 08)
--   PIN 18 = VSYNC             (combinatorial output, ACTIVE LOW)
--   PIN 19 = PIXEL_ENABLE      (registered output)
--   PIN 20 = /WE               (combinatorial output, ACTIVE LOW, OE = RUN; revision 10, was ADDR_SEL)
--   PIN 21 = /P0               (input, ACTIVE LOW, I/O decode PLD pin 17; revision 12)
--   PIN 22 = /MAP_WR           (combinatorial output, ACTIVE LOW; revision 12)
--   PIN 23 = V_VIDEO_ACTIVE    (registered output)
--------------------------------------------------------------------------------

library ieee;
use ieee.std_logic_1164.all;

entity sync_pld is
    port (
        -- ============================================================
        -- INPUTS
        -- ============================================================

        CLK              : in  std_logic;   -- PIN 1

        -- Vertical counter inputs
        -- V9:V1 are bits 9..1 of the external 10-bit vertical counter.
        -- V0 is not connected, so each decode below sees two counts at
        -- once (e.g. 532 and 533 look identical to this PLD).
        -- V8, V7 and V6 are not connected and are not needed.
        V9               : in  std_logic;   -- PIN 2
        V5               : in  std_logic;   -- PIN 3
        V4               : in  std_logic;   -- PIN 4
        V3               : in  std_logic;   -- PIN 5
        V2               : in  std_logic;   -- PIN 6
        V1               : in  std_logic;   -- PIN 7

        -- Horizontal active-video indication
        H_VIDEO_ACTIVE   : in  std_logic;   -- PIN 8

        -- RAM write strobe inputs (revision 10; pins 9-11 were the
        -- PC_ENABLE, Y_ENABLE and X_ENABLE inputs of the address mux
        -- control, which went to the mux PLDs themselves)
        CLK_E            : in  std_logic;   -- PIN 9, early clock tap (the same clock in the FPGA model)
        RW               : in  std_logic;   -- PIN 10, State PLD pin 23, 0 = store
        RUN              : in  std_logic;   -- PIN 11, ROM cartridge, 0 = loading

        -- Blanking read slot, from the audio slot PLD (revision 06; named
        -- AUD_SLOT before revision 07).  High for the whole 8-clock group
        -- of each line where the mode byte (group 45, see docs/video/VIDEO.md) or the
        -- audio sample (group 46 or 47, see docs/sound/SOUND.md) is read (groups
        -- 37-39 before audio slot PLD revision 03).
        BLANK_RD         : in  std_logic;   -- PIN 13

        -- ============================================================
        -- OUTPUTS
        -- ============================================================

        H0               : out std_logic;   -- PIN 14
        H1               : out std_logic;   -- PIN 15
        H2               : out std_logic;   -- PIN 16

        VIDEN            : out std_logic;   -- PIN 17
        VSYNC            : out std_logic;   -- PIN 18  (active low)

        PIXEL_ENABLE     : out std_logic;   -- PIN 19

        WE_N             : out std_logic;   -- PIN 20  (active low; floats while RUN = 0 on the real part)

        -- Map register write strobe (revision 12)
        P0_N             : in  std_logic;   -- PIN 21  (active low, I/O decode PLD pin 17: page 0 select)
        MAP_WR_N         : out std_logic;   -- PIN 22  (active low, map register clock)

        -- Vertical active-region state (registered).
        -- Needed internally by VIDEN, PIXEL_ENABLE and VSYNC.
        -- Brought out on pin 23 because the 22V10 has no buried registers.
        V_VIDEO_ACTIVE   : out std_logic    -- PIN 23
    );

    -- Pin number attributes for the fitter
    attribute pin_numbers : string;
    attribute pin_numbers of sync_pld : entity is
        "CLK:1 V9:2 V5:3 V4:4 V3:5 V2:6 V1:7 H_VIDEO_ACTIVE:8 " &
        "CLK_E:9 RW:10 RUN:11 BLANK_RD:13 " &
        "H0:14 H1:15 H2:16 VIDEN:17 VSYNC:18 PIXEL_ENABLE:19 " &
        "WE_N:20 P0_N:21 MAP_WR_N:22 V_VIDEO_ACTIVE:23";
end entity sync_pld;


architecture rtl of sync_pld is

    -- Internal copies of the output pins (outputs are also used as feedback).
    -- The ATF22V10C powers up with all registers at 0, so the registers are
    -- initialized to '0' to match the device in simulation.
    signal H0_Q              : std_logic := '0';
    signal H1_Q              : std_logic := '0';
    signal H2_Q              : std_logic := '0';
    signal V_VIDEO_ACTIVE_Q  : std_logic := '0';
    signal VIDEN_Q           : std_logic := '0';
    signal PIXEL_ENABLE_Q    : std_logic := '0';

    -- Next-state (D input) equations
    signal H0_D              : std_logic;
    signal H1_D              : std_logic;
    signal H2_D              : std_logic;
    signal V_VIDEO_ACTIVE_D  : std_logic;
    signal VIDEN_D           : std_logic;
    signal PIXEL_ENABLE_D    : std_logic;

begin

    -- ============================================================
    -- HORIZONTAL LOW-BIT COUNTER
    -- ============================================================

    --
    -- H0 toggles every clock.
    --
    -- H1 toggles whenever H0 is high.
    --
    -- H2 toggles whenever H1 and H0 are both high.
    --
    -- Revision 08: H2:H0 goes straight to the color decoder as its
    -- pixel select, so the count runs two clocks behind the 8-clock
    -- group of the H counter PLD (revision 07):
    --
    --     clock of the group   0    1    2    3    4    5    6    7
    --     H2:H0               110  111  000  001  010  011  100  101
    --
    -- The byte is read in clock 1 (H2:H0 = 111), the pixel buffer
    -- loads at the end of it, and its first pixel is shown in clock 2
    -- (H2:H0 = 000).  The H counter PLD advances the group on 101.
    -- The counter equations do not change; only the decodes that use
    -- H2:H0 do.  Before revision 08, H2:H0 was 000 in clock 0 and a
    -- two-stage delay register (F574) between this PLD and the color
    -- decoder delayed H2:H0 and VIDEO_ACTIVE by two clocks.
    --

    H0_D <= not H0_Q;

    H1_D <= H1_Q xor H0_Q;

    H2_D <= H2_Q xor (H1_Q and H0_Q);


    -- ============================================================
    -- VERTICAL ACTIVE-REGION STATE
    -- ============================================================

    --
    -- V_VIDEO_ACTIVE is high for vertical counts 544-1023.
    --
    -- Counts 512-543 have V9 = 1 and V5 = 0.
    -- Count 544 is the first count with V9 = 1 and V5 = 1.
    -- Only V9 and V5 are needed to detect it.
    --
    -- Set:
    --     V9 = 1
    --     V5 = 1
    --
    -- Once set, it holds while V9 is high.  V5 returns low at
    -- count 576, but the held state keeps the region active.
    --
    -- V9 going low (counter wraps from 1023) clears it.
    --

    V_VIDEO_ACTIVE_D <= V9 and (V5 or V_VIDEO_ACTIVE_Q);


    -- ============================================================
    -- VIDEO ENABLE (color decoder VIDEN)
    -- ============================================================

    --
    -- VIDEN blanks the color decoder.  It is high for the 640 clocks
    -- in which pixels are shown: from clock 2 of group 48 (the first
    -- pixel of the first byte) to clock 1 of group 28 of the next line
    -- (the last pixel of the last byte), on lines where V_VIDEO_ACTIVE
    -- is high (counts 544-1023).
    --
    -- Revision 08: registered, and loaded only in clock 1 of each group
    -- (H2:H0 = 111, the video read clock).  It holds on the other seven
    -- clocks.  In clock 1 of group 48 H_VIDEO_ACTIVE has just gone high,
    -- so VIDEN goes high at the end of it; in clock 1 of group 28 it has
    -- just gone low, so VIDEN goes low at the end of it.  That is
    -- exactly the old VIDEO_ACTIVE (V_VIDEO_ACTIVE & H_VIDEO_ACTIVE,
    -- combinational) delayed by two clocks in the delay register, which
    -- is no longer needed.  Nothing else used VIDEO_ACTIVE.
    --

    VIDEN_D <=
          (V_VIDEO_ACTIVE_Q
      and H_VIDEO_ACTIVE
      and H2_Q
      and H1_Q
      and H0_Q)
       or (VIDEN_Q
      and (not H2_Q))
       or (VIDEN_Q
      and (not H1_Q))
       or (VIDEN_Q
      and (not H0_Q));


    -- ============================================================
    -- PIXEL ENABLE
    -- ============================================================

    --
    -- One byte is read every eight clocks during active video.
    --
    -- PIXEL_ENABLE is registered, so it is decoded in the first clock
    -- of the group and is high in the second one, where the byte is
    -- read.  Since revision 08 those are H2:H0 = 110 and 111 (000 and
    -- 001 before).  Being registered,
    -- it reaches the address mux PLDs (their select since revision 10,
    -- ADDR_SEL before) and the State, PC and Branch PLDs at tCO,
    -- instead of three array passes after the clock (see
    -- docs/timing/VIDEO_TIMING.md).
    --
    -- It is decoded from the V_VIDEO_ACTIVE register and the
    -- H_VIDEO_ACTIVE input, so it is one array pass.
    --
    -- The pixel buffer loads at the end of the second clock, so its
    -- first pixel is shown in the third (H2:H0 = 000), and the color
    -- decoder takes H2:H0 and VIDEN from this PLD directly.
    --
    -- Audio (revision 06): one more read per line, on every line
    -- including vertical blanking, in clock 1 of the group that
    -- BLANK_RD marks (group 38 or 39, in horizontal blanking).  It is
    -- a video read in every way: the address mux takes the video
    -- address, the CPU stalls, MEM_CTRL enables the RAM or ROM by the
    -- map, and the pixel buffer loads the byte.  The pixel buffer
    -- holds it until the first pixel read of the line (group 48), and
    -- the DAC register copies it at the end of HSYNC (group 42).
    --
    -- Mode byte (revision 07): the audio slot PLD (revision 02) also
    -- marks group 37 on every line, so the same term reads the line's
    -- mode byte there, and the line code register copies it from the
    -- pixel buffer.  The input is renamed BLANK_RD; the equations do
    -- not change.
    --

    PIXEL_ENABLE_D <=
          (V_VIDEO_ACTIVE_Q
      and H_VIDEO_ACTIVE
      and H2_Q
      and H1_Q
      and (not H0_Q))
       or (BLANK_RD
      and H2_Q
      and H1_Q
      and (not H0_Q));


    -- ============================================================
    -- VERTICAL SYNC
    -- ============================================================

    --
    -- VSYNC is logically true during counts 532-533; the VSYNC pin is
    -- active low (declared !VSYNC since revision 09), so it is low during sync.
    --
    -- V0 is not available, so counts 532 and 533 are decoded together:
    --
    --     532 = 10 0001 0100
    --     533 = 10 0001 0101
    --
    -- V4:V1 = 1010 selects 532-533 within any 32-count window.
    -- V9 = 1 restricts the match to counts 512-1023, and
    -- !V_VIDEO_ACTIVE restricts it to counts 512-543 (before the
    -- active region begins at 544).  The only count in 512-543 with
    -- V4:V1 = 1010 is 532-533, so V8, V7, V6 and V5 are not needed.
    --

    VSYNC <= not (V9 and (not V_VIDEO_ACTIVE_Q) and V4 and (not V3) and V2 and (not V1));


    -- ============================================================
    -- RAM WRITE STROBE (revision 10)
    -- ============================================================

    --
    -- Revision 10 (docs/timing/FETCH_TIMING.md): the address mux
    -- control (ADDR_SEL, ADDR_SEL_HI, ADDR_SEL_LO) is gone; the four
    -- mux PLDs (quad_4to1_mux revision 02) take PIXEL_ENABLE and the
    -- State PLD's enables as their selects directly.
    --
    -- This PLD takes over the RAM write strobe from the memory control
    -- PLD (same equation, revision 09 there), but from CLK_E, an early
    -- tap of the clock: the clock net runs from the oscillator to this
    -- pin first, then through about 500 mm of track (3 ns) before any
    -- other load, pin 1 included.  So /WE is back high before the
    -- address or a chip enable can change (docs/timing/WE_TIMING.md).  In the
    -- FPGA model CLK_E is the same clock as CLK.
    --
    --     /WE low while CLK_E = 0, RW = 0 and PIXEL_ENABLE = 0
    --
    -- The output enable term is RUN (WE.OE = RUN): the pin floats while
    -- RUN is low so a slot-1 boot card can drive /WE.  As in the memory
    -- control model before, the FPGA model does not model the float; it
    -- drives the equation, which is high while RUN is low anyway (the
    -- IR holds 02h, which writes nothing).
    --

    -- Revision 11: /WE also waits for CLK, so it falls on the later edge
    -- and still rises on CLK_E (the same clock in the FPGA model).
    WE_N <= not ((not CLK_E) and (not CLK) and (not RW) and (not PIXEL_ENABLE_Q));

    -- Revision 12: the map register strobe, /WE's equation and the page 0
    -- select (MAP_WR = !CLK_E & !CLK & !RW & !PIXEL_ENABLE & P0).
    MAP_WR_N <= not ((not CLK_E) and (not CLK) and (not RW) and (not PIXEL_ENABLE_Q) and (not P0_N));


    -- ============================================================
    -- Registers (rising-edge D flip-flops, ATF22V10C
    -- output macrocells in registered mode)
    -- ============================================================

    process (CLK)
    begin
        if rising_edge(CLK) then
            H0_Q             <= H0_D;
            H1_Q             <= H1_D;
            H2_Q             <= H2_D;
            V_VIDEO_ACTIVE_Q <= V_VIDEO_ACTIVE_D;
            VIDEN_Q          <= VIDEN_D;
            PIXEL_ENABLE_Q   <= PIXEL_ENABLE_D;
        end if;
    end process;


    -- ============================================================
    -- Output pin connections
    -- ============================================================

    H0             <= H0_Q;
    H1             <= H1_Q;
    H2             <= H2_Q;
    V_VIDEO_ACTIVE <= V_VIDEO_ACTIVE_Q;
    VIDEN          <= VIDEN_Q;
    PIXEL_ENABLE    <= PIXEL_ENABLE_Q;

end architecture rtl;
