tocksin/placard/src/scripts/placard_sim.py

#!/usr/bin/env python3
"""
placard_sim.py - assembler and instruction-level simulator for the Placard CPU

    python3 placard_sim.py prog.asm                 assemble, write prog.hex
    python3 placard_sim.py prog.asm --run           assemble and run
    python3 placard_sim.py prog.asm --run --hw-alu  run with the VHDL alu4 model
    python3 placard_sim.py prog.asm --run --png out.png   also render the screen
    python3 placard_sim.py prog.asm --run --stop-at LABEL  stop when PC = LABEL
    python3 placard_sim.py prog.asm --run --boot    start from the ROM image
                                                    (rom_boot.asm, the library
                                                    and the program) like the
                                                    hardware, see docs/architecture/ROM.md

The assembler accepts the syntax defined in placard.asm (it is not a general
customasm replacement: only #include, #addr, #overlay, #d8 and #d ("strings"
and 0x hex literals) directives and "NAME = expression" constants are
supported; #overlay X is #addr X for bytes that are RAM under a ROM address
at run time, kept at X + x10000 in the memory returned: a program's overlay,
gen_plc.py --overlay).  #include "file" pastes the
file in, relative to the including file, except placard.asm (the rule
definitions), which is skipped.  A constant must be defined before an #addr
that uses it.  Use it to check programs and to get a hex file
when customasm is not at hand; customasm with placard.asm should produce the
same bytes.

The simulator follows the hardware instruction flow (State PLD rev 12,
Branch PLD rev 11):
  - operand byte fetched for: immediate source; memory source with a [0,D]
    mode (MEM 000, 011, 100); register source with MEM 101 (zero-page store,
    or BCC with an AC or X target, whose second byte is a pad byte)
  - memory source reads into D (LOAD_MEM); the source bus is D or AC (source 11 = AC; X has not been a source since 2026-10-19)
  - register source with MEM 110 or 111 also passes through LOAD_MEM (one
    more clock; the read into D is not used)
  - ALU: A = AC, B = source bus
  - dest AC / X / Y load the ALU result; RAM stores take the SOURCE BUS
  - branches: Z and NEG from the accumulator, or the carry flag (BCS, BCC);
    PC low <- source bus, JMP also loads PC high <- Y
  - the carry flag (Branch PLD rev 11) is the high ALU's COUT, latched at
    the end of an ADD or SUB with an AC, X or Y destination (carry out for
    ADD, borrow out for SUB) and held by every other instruction
  - ADD and SUB with an AC, X or Y destination take one extra clock
    (the Branch PLD's ALU wait clock); stores do not
  - with an io model (io_devices.SharedPort), reads and writes of
    x5200-x52FF go to the shared port (keyboard, pads, SD card, mouse)
  - with a slots model (io_devices.Slots), reads and writes of
    x5100-x51FF and x5300-x53FF go to the expansion slots; with --boot and
    no cards those reads return FF (the read bus pull-ups)
  - a read of x5000-x50FF returns the video line read,
    V9:V2, with one line per 800 CPU clocks and V = 499-1023 (525 lines per
    frame).  Video fetch stalls are modeled only with Cpu.stalls = True
    (or --stalls): the mode byte, audio and pixel reads each take one CPU
    clock, and a blanked row (mode byte bit 7) makes no pixel reads.
  - with --boot, CPU reads follow the ROM/RAM map (a write to x5000-x50FF
    sets it, every write also goes to the RAM; the I/O window is
    x5000-x53FF, and x5400-x5FFF is memory in map section 2) and the CPU
    starts with an empty RAM and the map cleared to all ROM.  The video always reads the
    RAM, so --png shows the RAM.  Without it every read comes from
    one memory holding the program.

--hw-alu evaluates the ALU with the exact alu4.vhd equations wired as in
basys_top.vhd (low nibble CIN = 0, high nibble CIN = low nibble COUT, low
SHIFT_RIGHT_IN = AC bit 4, high SHIFT_RIGHT_IN = 0).  The default is an ideal
8-bit ALU (A - B is a true 8-bit subtraction).

Date: 11/11/2026
"""

import re
import sys

# ---------------------------------------------------------------------------
# Encoding tables (match placard.asm)
# ---------------------------------------------------------------------------
ALU = {'ld': 0, 'and': 1, 'or': 2, 'xor': 3, 'add': 4, 'sub': 5}
REG_SRC = {'ac': 2}       # source 11 also drives AC; X is not a source (2026-10-19)
REG_DST = {'ac': 0, 'x': 3, 'y': 4}
COND = {'bcs': 1, 'blt': 2, 'bne': 3, 'beq': 4, 'bcc': 5, 'ble': 6, 'bra': 7}
MEM_BRANCH = {   # indirect branch forms: (mnemonic, operand) -> m
    ('jmp', 'zp'): 0, ('bne', 'zp'): 3, ('beq', 'zp'): 4,
    ('bcs', '[x]'): 1, ('ble', '[x]'): 6,
    ('blt', '[y,x]'): 2, ('bra', '[y,x]'): 7,
}


def op(a, m, s):
    return (a << 5) | (m << 2) | s


class AsmError(Exception):
    pass


ZP_RE = re.compile(r'^\[(?!x\]$|y\s*,\s*x\]$)(.+)\]$')


def norm(t):
    t = t.strip()
    t = re.sub(r'\[\s*y\s*,\s*x\s*\]', '[y,x]', t)
    t = re.sub(r'\[\s*x\s*\]', '[x]', t)
    return t


def split_operands(rest):
    """split 'a, b' at the top-level comma (not inside brackets)"""
    depth, cur, out = 0, '', []
    for ch in rest:
        if ch == '[':
            depth += 1
        elif ch == ']':
            depth -= 1
        if ch == ',' and depth == 0:
            out.append(cur)
            cur = ''
        else:
            cur += ch
    if cur.strip():
        out.append(cur)
    return [norm(o) for o in out]


def encode(mn, ops):
    """return (list of byte templates); an int is a fixed byte, a str is an
    expression that must evaluate to a byte (low 8 bits taken)"""
    E = lambda e: ('expr', e)
    mn = mn.lower()
    n = len(ops)
    is_reg = lambda t: t in REG_SRC
    is_zp = lambda t: bool(ZP_RE.match(t))
    zp = lambda t: ZP_RE.match(t).group(1)

    # aliases
    if mn == 'nop' and n == 0:
        return [op(0, 0, 2)]
    if mn == 'shl' and (n == 0 or ops == ['ac']):
        return [op(4, 0, 2)]
    if mn == 'clr' and n == 1 and ops[0] in REG_DST:
        return [op(3, REG_DST[ops[0]], 2)]
    if mn == 'inc' and n == 0:
        return [op(4, 0, 0), 1]
    if mn == 'dec' and n == 0:
        return [op(5, 0, 0), 1]
    if mn == 'not' and n == 0:
        return [op(3, 0, 0), 0xFF]

    if mn in ALU and n == 2:
        a = ALU[mn]
        s, d = ops
        if s == 'x':
            raise AsmError('X is not a source (the X source F541 was removed 2026-10-19)')
        if is_reg(s) and d in REG_DST:
            return [op(a, REG_DST[d], REG_SRC[s])]
        if is_reg(s) and d == '[x]':
            return [op(a, 6, REG_SRC[s])]
        if is_reg(s) and d == '[y,x]':
            return [op(a, 7, REG_SRC[s])]
        if is_reg(s) and is_zp(d):
            return [op(a, 5, REG_SRC[s]), E(zp(d))]
        if s == '[x]' and d == 'ac':
            return [op(a, 1, 1)]
        if s == '[y,x]' and d == 'ac':
            return [op(a, 2, 1)]
        if s == '[x]' and d == '[x]':
            return [op(a, 6, 1)]
        if s == '[y,x]' and d == '[y,x]':
            return [op(a, 7, 1)]
        if is_zp(s) and d in REG_DST:
            return [op(a, REG_DST[d], 1), E(zp(s))]
        if is_zp(s) and is_zp(d):
            raise AsmError('zero-page read-modify-write is not supported')
        if not s.startswith('['):           # immediate
            if d in REG_DST:
                return [op(a, REG_DST[d], 0), E(s)]
            if d == '[x]':
                return [op(a, 6, 0), E(s)]
            if d == '[y,x]':
                return [op(a, 7, 0), E(s)]
            if is_zp(d):
                return [op(a, 5, 0), ('same', s, zp(d))]
    if mn == 'shr' and n == 1:
        d = ops[0]
        if d in REG_DST:
            return [op(6, REG_DST[d], 2)]
        if d == '[x]':
            return [op(6, 6, 2)]
        if d == '[y,x]':
            return [op(6, 7, 2)]
        if is_zp(d):
            return [op(6, 5, 2), E(zp(d))]
    if (mn == 'jmp' or mn in COND) and n == 1:
        t = ops[0]
        c = 0 if mn == 'jmp' else COND[mn]
        if t == 'x':
            raise AsmError('X is not a source (the X source F541 was removed 2026-10-19)')
        if is_reg(t):
            if mn == 'bcc':                 # MEM 101: pad byte (State PLD rev 11)
                return [op(7, c, REG_SRC[t]), 0]
            return [op(7, c, REG_SRC[t])]
        if t in ('[x]', '[y,x]'):
            key = (mn, t)
            if key in MEM_BRANCH:
                return [op(7, MEM_BRANCH[key], 1)]
            raise AsmError('%s has no %s form' % (mn, t))
        if is_zp(t):
            key = (mn, 'zp')
            if key in MEM_BRANCH:
                return [op(7, MEM_BRANCH[key], 1), E(zp(t))]
            raise AsmError('%s has no [0xNN] form' % mn)
        if mn == 'jmp':
            return [op(7, 0, 0), E(t)]
        return [op(7, c, 0), ('branch', t)]
    raise AsmError('no rule matches: %s %s' % (mn, ', '.join(ops)))


def parse_line(line):
    line = line.split(';', 1)[0].strip()
    labels = []
    while True:
        m = re.match(r'^([A-Za-z_][A-Za-z0-9_]*)\s*:(.*)$', line)
        if not m:
            break
        labels.append(m.group(1))
        line = m.group(2).strip()
    return labels, line


def instr_size(text):
    """size in bytes of one instruction line (no label)"""
    text = text.strip()
    if not text:
        return 0
    parts = text.split(None, 1)
    ops = split_operands(parts[1]) if len(parts) > 1 else []
    return len(encode(parts[0], ops))


def evaluate(expr, syms):
    e = expr.strip()
    e = re.sub(r'\b0x([0-9A-Fa-f]+)\b', lambda m: str(int(m.group(1), 16)), e)
    e = re.sub(r'\b0b([01]+)\b', lambda m: str(int(m.group(1), 2)), e)
    if re.search(r'[^\w\s\+\-\*\(\)<>&|^~]', e):
        raise AsmError('bad expression: ' + expr)
    try:
        return eval(e, {'__builtins__': {}}, syms)
    except NameError as ex:
        raise AsmError('unknown symbol in "%s": %s' % (expr, ex))


INCLUDE_RE = re.compile(r'^\s*#include\s+"([^"]+)"', re.I)
CONST_RE = re.compile(r'^([A-Za-z_][A-Za-z0-9_]*)\s*=\s*(.+)$')


def expand_includes(src, base_dir, depth=0):
    """paste in #include files (except placard.asm, the rule definitions)"""
    import os
    if depth > 8:
        raise AsmError('#include nested too deep')
    out = []
    for raw in src.splitlines():
        m = INCLUDE_RE.match(raw)
        if m and os.path.basename(m.group(1)).lower() != 'placard.asm':
            path = os.path.join(base_dir, m.group(1))
            try:
                text = open(path).read()
            except OSError:
                raise AsmError('cannot open #include file %s' % path)
            out.extend(expand_includes(text, os.path.dirname(path), depth + 1))
        else:
            out.append(raw)
    return out


def d8_items(text, lineno):
    """bytes of a #d line: "strings" and 0x hex literals (2 digits per byte)"""
    out, i = [], 0
    for item in re.findall(r'"(?:[^"\\]|\\.)*"|[^,]+', text):
        item = item.strip()
        if not item:
            continue
        if item.startswith('"'):
            body = item[1:-1].encode().decode('unicode_escape')
            out.extend(body.encode('latin-1'))
        elif re.match(r'^0x[0-9A-Fa-f]+$', item) and len(item) % 2 == 0:
            v = int(item, 16)
            nb = (len(item) - 2) // 2
            out.extend((v >> (8 * k)) & 0xFF for k in reversed(range(nb)))
        else:
            raise AsmError('line %d: #d takes "strings" and 0x hex literals only' % lineno)
    return out


def assemble(src, base_dir='.'):
    """two-pass assembly; returns (mem dict addr->byte, symbols, listing)"""
    lines = expand_includes(src, base_dir)
    for pass_no in (1, 2):
        addr = 0
        base = 0
        mem = {}
        listing = []
        if pass_no == 1:
            syms = {}
        for lineno, raw in enumerate(lines, 1):
            labels, text = parse_line(raw)
            for lb in labels:
                if pass_no == 1:
                    if lb in syms:
                        raise AsmError('line %d: duplicate label %s' % (lineno, lb))
                    syms[lb] = addr
            if not text:
                continue
            m = CONST_RE.match(text)
            if m:
                if pass_no == 1:
                    if m.group(1) in syms:
                        raise AsmError('line %d: duplicate symbol %s' % (lineno, m.group(1)))
                    try:
                        syms[m.group(1)] = evaluate(m.group(2), syms)
                    except AsmError:        # forward reference: resolve in pass 2
                        syms[m.group(1)] = 0
                else:
                    syms[m.group(1)] = evaluate(m.group(2), syms)
                continue
            if text.startswith('#'):
                d = text.split(None, 1)
                kw = d[0].lower()
                if kw in ('#include', '#bankdef', '#bits', '#outp', '#size', '{', '}'):
                    continue
                if kw in ('#addr', '#overlay', '#overlay2', '#overlay3', '#overlay4', '#overlay5'):
                    # may go backwards, as in customasm; overlapping bytes are an error.
                    # #overlay: the bytes that follow are RAM under a ROM address (a
                    # program's overlay, gen_plc.py --overlay): kept at address + x10000
                    addr = evaluate(d[1], syms) if pass_no == 2 else evaluate(d[1], dict(syms))
                    # (#overlay2: a second set at x20000, SCRAPWRIGHT's SCRAP.NAV
                    # at the addresses of SCRAP.INV; #overlay3: a third, x30000,
                    # SCRAP.DCK; #overlay4, x40000, SCRAP.PWR; #overlay5, x50000, SCRAP.INI)
                    base = {'#overlay': 0x10000, '#overlay2': 0x20000, '#overlay3': 0x30000,
                            '#overlay4': 0x40000, '#overlay5': 0x50000}.get(kw, 0)
                    continue
                if kw == '#d8':
                    for v in d[1].split(','):
                        if pass_no == 2:
                            if base + addr in mem:
                                raise AsmError('line %d: overlapping data at %04X' % (lineno, addr))
                            mem[base + addr] = evaluate(v, syms) & 0xFF
                        addr += 1
                    continue
                if kw == '#d':
                    for v in d8_items(d[1], lineno):
                        if pass_no == 2:
                            if base + addr in mem:
                                raise AsmError('line %d: overlapping data at %04X' % (lineno, addr))
                            mem[base + addr] = v
                        addr += 1
                    continue
                raise AsmError('line %d: unsupported directive %s' % (lineno, kw))
            if text in ('{', '}') or text.startswith('#bits') or text.startswith('#addr 0') and False:
                continue
            parts = text.split(None, 1)
            try:
                ops = split_operands(parts[1]) if len(parts) > 1 else []
                tmpl = encode(parts[0], ops)
            except AsmError as ex:
                raise AsmError('line %d: %s  [%s]' % (lineno, ex, raw.strip()))
            if pass_no == 2:
                out = []
                for t in tmpl:
                    if isinstance(t, int):
                        out.append(t)
                    elif t[0] == 'expr':
                        out.append(evaluate(t[1], syms) & 0xFF)
                    elif t[0] == 'same':
                        v = evaluate(t[1], syms)
                        a = evaluate(t[2], syms)
                        if (v & 0xFF) != (a & 0xFF):
                            raise AsmError('line %d: op n, [n] needs value == address' % lineno)
                        out.append(a & 0xFF)
                    elif t[0] == 'branch':
                        tv = evaluate(t[1], syms)
                        if (tv >> 8) != ((addr + 2) >> 8):
                            raise AsmError('line %d: branch target %04X not in the same page as %04X'
                                           % (lineno, tv, addr + 2))
                        out.append(tv & 0xFF)
                for i, b in enumerate(out):
                    if base + addr + i in mem:
                        raise AsmError('line %d: overlapping code at %04X' % (lineno, addr + i))
                    mem[base + addr + i] = b
                listing.append((addr, out, raw.strip()))
            addr += len(tmpl)
            if addr > 0x10000:
                raise AsmError('line %d: past end of memory' % lineno)
    return mem, syms, listing


def to_hexstr(mem):
    top = max(mem) + 1 if mem else 0
    return ''.join('%02X' % mem.get(a, 0) for a in range(top))


# ---------------------------------------------------------------------------
# ALU models
# ---------------------------------------------------------------------------
def alu_ideal(s, a, b, sri_low_unused=None):
    if s == 0:
        return b
    if s == 1:
        return a & b
    if s == 2:
        return a | b
    if s == 3:
        return a ^ b
    if s == 4:
        return (a + b) & 0xFF
    if s == 5:
        return (a - b) & 0xFF
    if s == 6:
        return a >> 1
    return a


def alu4(a, b, s, cin, sri):
    """exact alu4.vhd equations; a, b nibbles; returns (f, cout)"""
    bit = lambda v, i: (v >> i) & 1
    s0, s1, s2 = bit(s, 0), bit(s, 1), bit(s, 2)
    pass_sel = (1 - s2) & (1 - s1) & (1 - s0)
    and_sel = (1 - s2) & (1 - s1) & s0
    or_sel = (1 - s2) & s1 & (1 - s0)
    xor_sel = (1 - s2) & s1 & s0
    shr_sel = s2 & s1 & (1 - s0)
    passa_sel = s2 & s1 & s0
    arith_sel = s2 & (1 - s1)
    sh = [bit(a, 1), bit(a, 2), bit(a, 3), sri]
    maj = lambda x, y, z: (x & y) | (x & z) | (y & z)
    d = [cin, 0, 0, 0]
    for i in range(3):
        d[i + 1] = maj(bit(a, i) ^ s0, bit(b, i), d[i])
    d4 = maj(bit(a, 3) ^ s0, bit(b, 3), d[3])   # carry (ADD) / borrow (SUB)
    f = 0
    for i in range(4):
        ai, bi = bit(a, i), bit(b, i)
        fi = ((pass_sel & bi) | (and_sel & ai & bi) | (or_sel & (ai | bi)) |
              (xor_sel & (ai ^ bi)) | (arith_sel & (ai ^ bi ^ d[i])) |
              (shr_sel & sh[i]) | (passa_sel & ai))
        f |= fi << i
    cout = (arith_sel & d4) | (shr_sel & bit(a, 0))
    return f, cout


def alu_hw(s, a, b):
    lo, c = alu4(a & 15, b & 15, s, 0, (a >> 4) & 1)
    hi, _ = alu4(a >> 4, b >> 4, s, c, 0)
    return (hi << 4) | lo


def carry_ideal(s, a, b):
    """COUT of an 8-bit ADD (carry) or SUB (borrow)"""
    if s == 4:
        return (a + b) >> 8
    return 1 if a < b else 0


def carry_hw(s, a, b):
    """the high alu4's COUT, wired as in basys_top.vhd"""
    _, c = alu4(a & 15, b & 15, s, 0, (a >> 4) & 1)
    _, cout = alu4(a >> 4, b >> 4, s, c, 0)
    return cout


# ---------------------------------------------------------------------------
# CPU
# ---------------------------------------------------------------------------
class CpuError(Exception):
    pass


class Cpu:
    def __init__(self, mem, hw_alu=False, rom=None, io=None, slots=None):
        self.mem = bytearray(65536)
        # io: the shared port model (io_devices.SharedPort), or None; reads
        # and writes of x5200-x52FF go to it
        self.io = io
        # slots: the expansion slots (io_devices.Slots), or None; reads and
        # writes of x5100-x51FF and x5300-x53FF go to it.  With no slots
        # model those reads see the RAM (one flat memory) or FF (the ROM
        # map: nothing answers and the read bus pull-ups give FF)
        self.slots = slots
        for a, v in mem.items():
            self.mem[a] = v
        # rom: None = one flat memory (every read from mem, as the old FPGA
        # model did); else 64K of ROM bytes, and reads follow the ROM/RAM map
        # register (x5000-x50FF, cleared to all ROM at reset) like the hardware
        self.rom = None
        if rom is not None:
            self.rom = bytearray(65536)
            for a, v in rom.items():
                self.rom[a] = v
        self.map = 0
        self.pc = 0
        self.ac = self.x = self.y = self.d = 0
        self.c = 0                                # carry flag, powers up to 0
        self.alu = (lambda s, a, b: alu_hw(s, a, b)) if hw_alu else alu_ideal
        self.carry = carry_hw if hw_alu else carry_ideal
        self.steps = 0
        self.clocks = 0
        # stalls: model the video's stall clocks (one CPU clock lost per
        # video read: the mode byte and audio reads on every line, and one
        # pixel read per group on active lines whose mode byte has bit 7 = 0)
        self.stalls = False
        self.stall_clocks = 0

    def read(self, ad):
        """memory read through the ROM/RAM map (8K sections, bit n = 1: RAM)"""
        if self.rom is None or (self.map >> (ad >> 13)) & 1:
            return self.mem[ad]
        return self.rom[ad]

    def step(self):
        m_ = self.mem
        rd = m_.__getitem__ if self.rom is None else self.read
        opc = rd(self.pc)
        here = self.pc
        self.pc = (self.pc + 1) & 0xFFFF
        a, m, s = opc >> 5, (opc >> 2) & 7, opc & 3
        clocks = 2
        if s == 1 and m == 5:
            raise CpuError('%04X: unsupported opcode %02X (MEM 101 with memory source)' % (here, opc))
        operand = (s == 0) or (s == 1 and m in (0, 3, 4)) or (s >= 2 and m == 5)
        if operand:
            self.d = rd(self.pc)
            self.pc = (self.pc + 1) & 0xFFFF
            clocks += 1

        def addr():
            if m in (0, 3, 4, 5):
                return self.d
            if m in (1, 6):
                return self.x
            return (self.y << 8) | self.x
        if s == 1:
            ad = addr()
            if ad & 0xFF00 == 0x5000:             # /LINE_RD (x5000-x50FF)
                self.d = self.line_read()
            elif ad & 0xFF00 == 0x5200 and (self.io is not None or self.rom is not None):
                # /PORT_RD; with no port model, no key down (FF)
                self.d = self.io.read(ad, self.clocks + clocks) if self.io is not None else 0xFF
            elif ad & 0xFD00 == 0x5100 and (self.slots is not None or self.rom is not None):
                self.d = self.slots.read(ad) if self.slots is not None else 0xFF   # /EXP1, /EXP2
            else:
                self.d = rd(ad)
            clocks += 1
        if s >= 2 and m in (6, 7):
            clocks += 1                           # through LOAD_MEM (State PLD rev 10)
        src = [self.d, self.d, self.ac, self.ac][s]   # 11 drives AC too (2026-10-19)
        res = self.alu(a, self.ac, src)
        if a == 7:
            acv = self.alu(7, self.ac, src)       # PASS A -> Z flags
            z = acv == 0
            neg = (self.ac >> 7) & 1
            take = [True, self.c, (not z) and neg, not z, z,
                    not self.c, z or neg, True][m]
            if take:
                self.pc = (self.pc & 0xFF00) | src
                if m == 0:
                    self.pc = (self.y << 8) | src
        else:
            if a in (4, 5) and m <= 4:
                clocks += 1                       # ALU wait clock (Branch PLD rev 07)
                self.c = self.carry(a, self.ac, src)   # carry flag (Branch PLD rev 11)
            if m in (0, 1, 2):
                self.ac = res
            elif m == 3:
                self.x = res
            elif m == 4:
                self.y = res
            else:
                ad = addr()
                m_[ad] = src                      # every write goes to the RAM
                if ad & 0xFF00 == 0x5000:         # /MAP_WR (x5000-x50FF)
                    self.map = src
                elif ad & 0xFF00 == 0x5200 and self.io is not None:   # /PORT_WR
                    self.io.write(ad, src, self.clocks + clocks)
                elif ad & 0xFD00 == 0x5100 and self.slots is not None:
                    self.slots.write(ad, src)
        self.steps += 1
        if self.stalls:
            clocks = self.with_stalls(clocks)
        self.clocks += clocks
        return here

    def with_stalls(self, n):
        """wall clocks for n CPU clocks from self.clocks: a clock with
        H2:H0 = 111 that the video uses for a read is lost to the CPU.  The
        line starts at pixel 224 (group 28); groups 45 and 46 read the mode
        byte and the audio sample on every line, groups 48-127 read pixels
        on active lines (V 544-1023) unless the row is blanked (VIDEO.md)"""
        t = self.clocks
        end = t + n
        c = t | 7
        mem = self.mem
        while c < end:
            pos = c % 800
            g = 28 + (pos >> 3)
            if g == 45 or g == 46:
                end += 1
            elif g >= 48:
                line = (c // 800) % 525
                if line >= 45 and not mem[MODE_BASE + line - 45] & 0x80:
                    end += 1
            c += 8
        self.stall_clocks += end - t - n
        return end - t

    def line_read(self):
        """V9:V2 of the video line counter: 800 clocks per line, V = 499-1023"""
        return (499 + (self.clocks // 800) % 525) >> 2

    def run(self, max_steps=20_000_000, halt_detect=True, stop_pc=None):
        while self.steps < max_steps:
            here = self.step()
            if self.pc == stop_pc:
                return 'stop'
            if halt_detect and self.pc == here and m_is_branch(self.read(here)):
                return 'halt'
        return 'timeout'


def m_is_branch(o):
    return (o >> 5) == 7


# ---------------------------------------------------------------------------
# Screen rendering (matches gen_video_ram.tcl layout)
# ---------------------------------------------------------------------------
VID_BASE = 48 * 512 + 32     # byte column 0, row 0 (x6020)
MODE_BASE = 45 * 512 + 32    # row 0's mode byte (x5A20), read in group 45


def row_offset(row, mode):
    """row address A8:A0 of screen row 0-479 for mode byte bits 3:2 (line
    repeat), as the audio slot PLD makes it (docs/video/VIDEO.md, line repeat)"""
    v = 32 + row
    rep = (mode >> 2) & 3
    if rep == 0:
        return v
    v8, v7 = (v >> 8) & 1, (v >> 7) & 1
    if rep == 1:
        return 0x100 | (v & 0xFE) | v8
    return 0x180 | (v & 0x7C) | (v8 << 1) | v7


def rgb8(b):
    r = (b & 7) * 255 // 7
    bl = ((b >> 3) & 3) * 255 // 3
    g = ((b >> 5) & 7) * 255 // 7
    return (r, g, bl)


def render(mem, path):
    try:
        from PIL import Image
    except ImportError:
        print('PIL not available, no PNG written')
        return
    img = Image.new('RGB', (640, 480))
    px = img.load()
    pal2 = [(0, 0, 0), (0, 36, 255), (255, 182, 0), (255, 255, 255)]
    # 16-color palette, docs/video/COLORS.md: (R 0-7, G 0-7, B 0-3)
    pal4 = [(r * 255 // 7, g * 255 // 7, b * 255 // 3) for r, g, b in (
        (0, 0, 0), (0, 0, 1), (4, 0, 2), (0, 0, 3), (7, 0, 0), (7, 0, 3), (4, 2, 0), (2, 2, 1),
        (0, 7, 3), (0, 4, 0), (7, 7, 3), (5, 5, 2), (7, 4, 2), (7, 4, 0), (7, 7, 0), (1, 7, 0))]
    for y in range(480):
        mbyte = mem[MODE_BASE + y]
        if mbyte & 0x80:                # blank line: black, no pixel reads
            continue
        # row tint, bits 6:4 = R, G, B: about 0.2 V of 0.7 V on that channel
        tint = [73 if mbyte & (0x10 << k) else 0 for k in range(3)]
        bpp = 1 << (mbyte & 3)
        off = row_offset(y, mbyte)
        for col in range(80):
            byte = mem[0x6000 + col * 512 + off]
            per = 8 // bpp
            w = 8 // per
            for i in range(per):
                v = (byte >> (i * bpp)) & ((1 << bpp) - 1)
                if bpp == 1:
                    c = (255, 255, 255) if v else (0, 0, 0)
                elif bpp == 2:
                    c = pal2[v]
                elif bpp == 4:
                    c = pal4[v]
                else:
                    c = rgb8(v)
                if mbyte & 0x70:
                    c = tuple(min(255, c[k] + tint[k]) for k in range(3))
                for k in range(w):
                    xx = col * 8 + i * w + k
                    if xx < 640:
                        px[xx, y] = c
    img.save(path)


# ---------------------------------------------------------------------------
# ROM image (matches gen_rom.tcl and docs/architecture/ROM.md)
# ---------------------------------------------------------------------------
ROM_IMAGE_BASE = 0x6000      # RAM image: ROM address of RAM x0000 (RAM x0000-x1FFF)
IMAGE_SAME = 0x2000          # RAM image: from here up the ROM address is the RAM address
IMAGE_SIZE = 0x4A00          # RAM x0000-x49FF is copied at boot
LIB_RAM_START, LIB_RAM_END = 0x1F00, 0x2000   # library code the boot copies to RAM (LIB_RAM)
LIB_FONT = 0x9700            # the font (LIB_FONT in placard_lib.asm)
PROG_START, PROG_END = 0x6000, 0x8000   # ROM program area, entry at PROG_START
PROG2_START, PROG2_END = 0x2000, 0x4000 # more ROM program area (section 1)
BOOT_MODE = 0x0005           # 00 = ROM program, 01 = RAM image, 02 = the 32K image: the boot reads
                             # ROM x0005, where a 32K cartridge shows x8005
DOS_MARK = 0xFC00            # rom32.asm puts 02 here: how the tools know the 32K image's program
MODE_DOS = 2
LIB_RAM_IMAGE = 0x9F00       # where the 32K image keeps LIB_RAM (a 32K cartridge
                             # shows it at x1F00 too, where the boot copies it from)


def lib_area(a):
    """True for the addresses the library's own bytes go to in the ROM: the
    upper half (the 32K image; the library's parts are in sections 4, 6 and
    7, docs/architecture/ROM.md) and LIB_RAM"""
    return a >= 0x8000 or LIB_RAM_START <= a < LIB_RAM_END


def is_ram_image(prog, lib):
    """True for an older program written to run at RAM x0000 (bytes in
    x0000-x1FFF or x4000-x5FFF other than the library's own)"""
    for a, v in prog.items():
        if not (a < 0x2000 or 0x4000 <= a < PROG_START):
            continue
        if lib_area(a) and v == lib.get(a, 0):
            continue
        if v:
            return True
    return False


def is_dos_image(prog):
    """True for the 32K image's program (rom32.asm): it has 02 at DOS_MARK"""
    return prog.get(DOS_MARK) == MODE_DOS


def build_dos_rom(dos, boot, lib):
    """the 64K ROM for the 32K image's program (rom32.asm): the 32K image x8000-xFFFF (docs/architecture/ROM.md, "The
    32K image") in both halves, so a 32K cartridge (one EEPROM, read in
    both halves) and a 64K one boot the same.  rom32.asm includes the
    library and the FAT writer, so its bytes from x8000 up are the image,
    with the boot loader's (rom_boot.asm: xFC01 up), LIB_RAM's bytes at
    x9F00 (read at x1F00 by the boot through the mirror), BOOT_MODE = 02
    at x8005 and a copy of the reset code (x0000-x0004 of rom_boot.asm) at
    x8000, where a 32K cartridge shows it at x0000."""
    rom = {}
    for a, v in boot.items():
        if a >= 0x8000:
            rom[a] = v
    for a in range(5):
        rom[0x8000 + a] = boot.get(a, 0)
    for a, v in lib.items():
        if LIB_RAM_START <= a < LIB_RAM_END:
            rom[a - LIB_RAM_START + LIB_RAM_IMAGE] = v
    for a, v in dos.items():
        if a == DOS_MARK:
            continue
        if a >= 0x8000:
            if LIB_RAM_IMAGE <= a < LIB_RAM_IMAGE + 0x100 and v:
                raise AsmError('32K image byte at %04X is in the LIB_RAM image (x9F00-x9FFF)' % a)
            if a < 0x8005 and v != rom[a]:
                raise AsmError('32K image byte at %04X differs from the boot loader\'s reset code' % a)
            if a in boot and a >= 0x8005:
                raise AsmError('32K image byte at %04X is in the boot loader' % a)
            if a in lib and v != lib[a]:
                raise AsmError('32K image byte at %04X differs from the library (rom_lib.asm)' % a)
            rom[a] = v
        elif v and not (LIB_RAM_START <= a < LIB_RAM_END and v == lib.get(a, 0)):
            raise AsmError('32K image byte at %04X is outside the 32K image (x8000-xFFFF)' % a)
    for a in lib:
        if a >= 0x8000 and a not in dos:
            raise AsmError('library byte at %04X is not in the 32K image' % a)
    rom[DOS_MARK] = MODE_DOS
    rom[BOOT_MODE + 0x8000] = MODE_DOS
    for a in range(0x8000):
        rom[a] = rom.get(a + 0x8000, 0)
    return rom


def image_32k(rom):
    """the 32K EEPROM image (x8000-xFFFF) of a ROM from build_rom"""
    return bytes(rom.get(a, 0) for a in range(0x8000, 0x10000))


def build_rom(prog, base_dir=None):
    """ROM bytes {addr: value} for a program image {addr: value}, as gen_rom.tcl
    makes them (docs/architecture/ROM.md).  The upper half is always the 32K image as
    released (build_dos_rom: boot loader, library, loader, BASIC, FAT writer).
    The lower half is
      the same 32K again for the 32K image's own program (rom32.asm), or,
      in a development ROM, the reset code, LIB_RAM's bytes at x1F00 and
        a ROM program (assembled at x6000-x7FFF and x2000-x3FFF): in place,
        BOOT_MODE (ROM x0005) = 00, or
        a RAM image (older programs at RAM x0000, no library): BOOT_MODE = 01,
        RAM x0000-x1FFF at ROM x6000-x7FFF and x2000-x49FF at its own address."""
    import os
    base_dir = base_dir or os.path.dirname(os.path.abspath(__file__))
    boot, _, _ = assemble(open(os.path.join(base_dir, 'rom_boot.asm')).read(), base_dir)
    lib, _, _ = assemble(open(os.path.join(base_dir, 'rom_lib.asm')).read(), base_dir)
    if is_dos_image(prog):
        return build_dos_rom(prog, boot, lib)
    # a development ROM: the 32K image in the upper half, as released, and
    # the program in the lower half with the reset code and LIB_RAM's bytes
    dos, _, _ = assemble(open(os.path.join(base_dir, 'rom32.asm')).read(), base_dir)
    rom = build_dos_rom(dos, boot, lib)
    for a in range(0x8000):
        if not LIB_RAM_START <= a < LIB_RAM_END:
            rom[a] = boot.get(a, 0) if a < BOOT_MODE else 0
    if not is_ram_image(prog, lib):
        for a, v in prog.items():
            if PROG_START <= a < PROG_END or PROG2_START <= a < PROG2_END:
                rom[a] = v
            elif v and not (lib_area(a) and v == (rom if a >= 0x8000 else lib).get(a, 0)):
                raise AsmError('program byte at %04X is outside the ROM program area '
                               '(x%04X-x%04X, x%04X-x%04X)'
                               % (a, PROG_START, PROG_END - 1, PROG2_START, PROG2_END - 1))
        rom[BOOT_MODE] = 0
        return rom
    rom[BOOT_MODE] = 1
    for a, v in prog.items():
        if a >= IMAGE_SIZE and v and not (lib_area(a) and v == rom.get(a, 0)):
            raise AsmError('program byte at %04X is past the RAM image (x0000-x%04X)'
                           % (a, IMAGE_SIZE - 1))
    # RAM x0000-x1FFF is kept at ROM x6000-x7FFF, x2000-x49FF at its own address
    for a in range(IMAGE_SIZE):
        rom[a + ROM_IMAGE_BASE if a < IMAGE_SAME else a] = prog.get(a, 0)
    return rom


def main(argv):
    import argparse
    ap = argparse.ArgumentParser()
    ap.add_argument('asm')
    ap.add_argument('-o', '--hex')
    ap.add_argument('--run', action='store_true')
    ap.add_argument('--hw-alu', action='store_true')
    ap.add_argument('--png')
    ap.add_argument('--boot', action='store_true',
                    help='run from a ROM image (boot loader, library, program) with the '
                         'ROM/RAM map, from an empty RAM, as the hardware starts')
    ap.add_argument('--stalls', action='store_true',
                    help='model the video read stall clocks (blanked rows have none)')
    ap.add_argument('--max-steps', type=int, default=20_000_000)
    ap.add_argument('--stop-at', metavar='LABEL', help='stop when the PC reaches LABEL')
    args = ap.parse_args(argv)
    src = open(args.asm).read()
    import os
    mem, syms, _ = assemble(src, os.path.dirname(os.path.abspath(args.asm)))
    hexpath = args.hex or re.sub(r'\.asm$', '', args.asm) + '.hex'
    open(hexpath, 'w').write(to_hexstr(mem) + '\n')
    print('assembled %d bytes, top %04X -> %s' % (len(mem), max(mem), hexpath))
    if args.run:
        if not args.boot and is_dos_image(mem):
            print('the DOS image: running it from the ROM (--boot)')
            args.boot = True
        if not args.boot and all(LIB_RAM_START <= a < 0x4000 or a >= PROG_START for a in mem):
            print('a ROM program (code from x6000): running it from the ROM image (--boot)')
            args.boot = True
        if args.boot:
            cpu = Cpu({}, hw_alu=args.hw_alu, rom=build_rom(mem))
        else:
            cpu = Cpu(mem, hw_alu=args.hw_alu)
        cpu.stalls = args.stalls
        r = cpu.run(args.max_steps, stop_pc=syms[args.stop_at] if args.stop_at else None)
        print('%s after %d instructions, %d clocks, PC=%04X' % (r, cpu.steps, cpu.clocks, cpu.pc))
        if args.png:
            render(cpu.mem, args.png)
        return cpu, syms
    return None, syms


if __name__ == '__main__':
    main(sys.argv[1:])
