tocksin/placard/src/scripts/bringup.asm

; bringup.asm - the bring-up test ROM (docs/hardware/BRINGUP.md)
;
; Written by gen_bringup.py; edit that, not this file.  A complete 32 KB
; ROM image with its own reset code, for the 32K cartridge, which shows it
; in both halves of the ROM: the byte at file offset f is read at x0000 + f
; and at x8000 + f, so no two bytes here are x8000 apart
; (test_bringup_sim.py --bin writes bringup.bin).
;
; Test stages: pages x01-x07 stop the PC until the chips of one build step
; work, so PC high = the stage it waits in: 1 AC and ALU, 2 AC source
; buffer, 3 Y, 4 X, 5 D source buffer, 6 RAM, 7 line read buffer.
;
; Fail loops: test N stops at x0080 + 4N (PC high = 00, PC low Q7 = 1,
; Q6:Q2 = N) with its number in the top left corner of the screen;
; test 16 at start-up waits in stage 7 with a text on the screen.  Tests:
;   1 branches  2 AND  3 OR  4 XOR  5 ADD  6 SUB  7 carry  8 SHR
;   9 AC/X  10 Y address  11 X address  12 ROM data  13 RAM data
;   14 map register  15 RAM address lines  16 video line read
;
; Date: 11/12/2026

#include "placard.asm"
#include "placard_lib.asm"

T15A     = 0x30
T15B     = 0x31
T15C     = 0x32
LR_AND   = 0x33
LR_OR    = 0x34
LR_TMP   = 0x35
LR_CL    = 0x36
LR_CH    = 0x37
LASTF    = 0x40
LOOP_LO  = 0x41
LOOP_HI  = 0x42
RT_IDX   = 0x43
RT_PAGE  = 0x44
RT_GOT   = 0x45
RT_EXP   = 0x46
RT_PL    = 0x47
RT_PH    = 0x48
RT_EL    = 0x49
RT_EH    = 0x4A
RT_BADH  = 0x4B
RT_BADL  = 0x4C
RT_BADE  = 0x4D
RT_BADG  = 0x4E
ECHO     = 0x4F
TONE     = 0x50
SD_R     = 0x51
FS_R     = 0x52
M_INIT   = 0x53
MX_LO    = 0x54
MX_HI    = 0x55
MY_LO    = 0x56
MY_HI    = 0x57
B_C      = 0x58
B_Y      = 0x59
B_V      = 0x5A
LINEV    = 0x5B
KEYV     = 0x5C
RT_I     = 0x5D
B_I      = 0x5E

; reset (the CPU starts at x0000 with the map all ROM); the nop is for
; the cartridge hand-off, which can skip x0000 (docs/architecture/ROM.md)
#addr 0x0000
    nop
    bra  stage_exit0

; fail loops: test N stops here at x0080 + 4N
#addr 0x0084
#addr 0x0084
fail1:
    bra  fail1
#addr 0x0088
fail2:
    bra  fail2
#addr 0x008C
fail3:
    bra  fail3
#addr 0x0090
fail4:
    bra  fail4
#addr 0x0094
fail5:
    bra  fail5
#addr 0x0098
fail6:
    bra  fail6
#addr 0x009C
fail7:
    bra  fail7
#addr 0x00A0
fail8:
    bra  fail8
#addr 0x00A4
fail9:
    bra  fail9
#addr 0x00A8
fail10:
    bra  fail10
#addr 0x00AC
fail11:
    bra  fail11
#addr 0x00B0
fail12:
    bra  fail12
#addr 0x00B4
fail13:
    bra  fail13
#addr 0x00B8
fail14:
    bra  fail14
#addr 0x00BC
fail15:
    bra  fail15
#addr 0x00C0
fail16:
    bra  fail16

; the end of the page: on into stage 1 (no jump: Y is not tested yet)
#addr 0x00FE
stage_exit0:
    nop
    nop
stage1_stop = 0x01FC
stage2_stop = 0x02FC
stage3_stop = 0x03FC
stage4_stop = 0x04FC
stage5_stop = 0x05F0
stage6_stop = 0x06FC
stage7_stop = 0x07FC

; stage 1
#addr 0x0100
stage1:
    ld   0x00, ac
    bne  g1_flags
    blt  g1_flags
    ld   0x80, ac
    beq  g1_flags
    blt  g1_neg
    bra  g1_flags
g1_neg:
    ld   0x7F, ac
    beq  g1_flags
    blt  g1_flags
    ld   0x01, ac
    beq  g1_bits
    xor  0x01, ac
    bne  g1_bits
    ld   0x02, ac
    beq  g1_bits
    xor  0x02, ac
    bne  g1_bits
    ld   0x04, ac
    beq  g1_bits
    xor  0x04, ac
    bne  g1_bits
    ld   0x08, ac
    beq  g1_bits
    xor  0x08, ac
    bne  g1_bits
    ld   0x10, ac
    beq  g1_bits
    xor  0x10, ac
    bne  g1_bits
    ld   0x20, ac
    beq  g1_bits
    xor  0x20, ac
    bne  g1_bits
    ld   0x40, ac
    beq  g1_bits
    xor  0x40, ac
    bne  g1_bits
    ld   0x80, ac
    beq  g1_bits
    xor  0x80, ac
    bne  g1_bits
    ld   0xFF, ac
    xor  0xFF, ac
    bne  g1_bits
    ld   0xF0, ac
    and  0x3C, ac
    xor  0x30, ac
    bne  g1_bits
    ld   0x12, ac
    or   0x21, ac
    xor  0x33, ac
    bne  g1_bits
    ld   0x0F, ac
    add  0x01, ac
    xor  0x10, ac
    bne  g1_carry
    ld   0xFF, ac
    add  0x01, ac
    bne  g1_carry
    bcc  g1_carry
    ld   0x7F, ac
    add  0x01, ac
    bcs  g1_carry
    ld   0x00, ac
    sub  0x01, ac
    bcc  g1_carry
    xor  0xFF, ac
    bne  g1_carry
    ld   0x80, ac
    shr  ac
    xor  0x40, ac
    bne  g1_shift
    ld   0x10, ac
    shr  ac
    xor  0x08, ac
    bne  g1_shift
    ld   0x01, ac
    shr  ac
    bne  g1_shift
    bra  stage_exit1
    #d8 0xFC, 0xFC, 0xFC, 0xFC, 0xFC, 0xFC, 0xFC, 0xFC, 0xFC, 0xFC, 0xFC, 0xFC, 0xFC, 0xFC, 0xFC, 0xFC
    #d8 0xFC, 0xFC, 0xFC, 0xFC, 0xFC, 0xFC, 0xFC, 0xFC, 0xFC, 0xFC, 0xFC, 0xFC, 0xFC, 0xFC, 0xFC, 0xFC
    #d8 0xFC, 0xFC, 0xFC, 0xFC, 0xFC, 0xFC, 0xFC, 0xFC, 0xFC, 0xFC, 0xFC, 0xFC, 0xFC, 0xFC, 0xFC, 0xFC
    #d8 0xFC, 0xFC, 0xFC, 0xFC, 0xFC, 0xFC, 0xFC, 0xFC, 0xFC, 0xFC, 0xFC, 0xFC, 0xFC, 0xFC, 0xFC, 0xFC
    #d8 0xFC
g1_flags:
    bra  g1_flags
    #d8 0xFC, 0xFC
g1_bits:
    bra  g1_bits
    #d8 0xFC, 0xFC
g1_carry:
    bra  g1_carry
    #d8 0xFC, 0xFC
g1_shift:
    bra  g1_shift
    #d8 0xFC, 0xFC
#addr 0x01F1
    #d8 0xFC, 0xFC, 0xFC, 0xFC, 0xFC, 0xFC, 0xFC, 0xFC, 0xFC, 0xFC, 0xFC, 0xFC, 0xFC
stage_exit1:
    nop
    nop

; stage 2
#addr 0x0200
stage2:
    ld   0x55, ac
    clr  ac
    bne  stage2_stop
    ld   0xAA, ac
    clr  ac
    bne  stage2_stop
    ld   0x0F, ac
    clr  ac
    bne  stage2_stop
    ld   0xF0, ac
    clr  ac
    bne  stage2_stop
    ld   0x01, ac
    shl  ac
    xor  0x02, ac
    bne  stage2_stop
    ld   0x21, ac
    shl  ac
    xor  0x42, ac
    bne  stage2_stop
    ld   0x48, ac
    shl  ac
    xor  0x90, ac
    bne  stage2_stop
    ld   0x14, ac
    shl  ac
    xor  0x28, ac
    bne  stage2_stop
    ld   g2_a, ac
    bra  ac
    #d8 0xFC, 0xFC, 0xFC, 0xFC, 0xFC, 0xFC, 0xFC, 0xFC, 0xFC, 0xFC, 0xFC, 0xFC, 0xFC, 0xFC, 0xFC, 0xFC
    #d8 0xFC, 0xFC, 0xFC, 0xFC, 0xFC, 0xFC, 0xFC, 0xFC, 0xFC, 0xFC, 0xFC, 0xFC, 0xFC, 0xFC, 0xFC, 0xFC
    #d8 0xFC, 0xFC, 0xFC, 0xFC, 0xFC, 0xFC, 0xFC, 0xFC, 0xFC, 0xFC, 0xFC, 0xFC, 0xFC, 0xFC, 0xFC, 0xFC
    #d8 0xFC, 0xFC, 0xFC, 0xFC, 0xFC, 0xFC, 0xFC, 0xFC, 0xFC, 0xFC, 0xFC, 0xFC, 0xFC, 0xFC, 0xFC, 0xFC
    #d8 0xFC, 0xFC, 0xFC, 0xFC, 0xFC, 0xFC, 0xFC, 0xFC, 0xFC, 0xFC, 0xFC, 0xFC, 0xFC
g2_a:
    bra  stage_exit2
    #d8 0xFC, 0xFC, 0xFC, 0xFC, 0xFC, 0xFC, 0xFC, 0xFC, 0xFC, 0xFC, 0xFC, 0xFC, 0xFC, 0xFC, 0xFC, 0xFC
    #d8 0xFC, 0xFC, 0xFC, 0xFC, 0xFC, 0xFC, 0xFC, 0xFC, 0xFC, 0xFC, 0xFC, 0xFC, 0xFC, 0xFC, 0xFC, 0xFC
    #d8 0xFC, 0xFC, 0xFC, 0xFC, 0xFC, 0xFC, 0xFC, 0xFC, 0xFC, 0xFC, 0xFC, 0xFC, 0xFC, 0xFC, 0xFC, 0xFC
    #d8 0xFC, 0xFC, 0xFC, 0xFC, 0xFC, 0xFC, 0xFC, 0xFC, 0xFC, 0xFC, 0xFC, 0xFC, 0xFC, 0xFC, 0xFC, 0xFC
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
    #d8 0xFC, 0xFC, 0xFC, 0xFC, 0xFC, 0xFC, 0xFC, 0xFC, 0xFC, 0xFC, 0xFC, 0xFC, 0xFC, 0xFC, 0xFC, 0xFC
    #d8 0xFC, 0xFC, 0xFC, 0xFC, 0xFC, 0xFC, 0xFC, 0xFC, 0xFC, 0xFC, 0xFC, 0xFC, 0xFC, 0xFC, 0xFC, 0xFC
stage_exit3:
    nop
    nop

; stage 4
#addr 0x0400
stage4:
    ld   0x3F, y
    ld   0x00, x
    ld   [y,x], ac
    xor  0x00, ac
    bne  g4_bar
    ld   0xFF, x
    ld   [y,x], ac
    xor  0xFF, ac
    bne  g4_bar
    ld   0x55, x
    ld   [y,x], ac
    xor  0x55, ac
    bne  g4_bar
    ld   0xAA, x
    ld   [y,x], ac
    xor  0xAA, ac
    bne  g4_bar
    ld   0x01, x
    ld   [y,x], ac
    xor  0x01, ac
    bne  g4_bar
    ld   0x02, x
    ld   [y,x], ac
    xor  0x02, ac
    bne  g4_bar
    ld   0x04, x
    ld   [y,x], ac
    xor  0x04, ac
    bne  g4_bar
    ld   0x08, x
    ld   [y,x], ac
    xor  0x08, ac
    bne  g4_bar
    ld   0x10, x
    ld   [y,x], ac
    xor  0x10, ac
    bne  g4_bar
    ld   0x20, x
    ld   [y,x], ac
    xor  0x20, ac
    bne  g4_bar
    ld   0x40, x
    ld   [y,x], ac
    xor  0x40, ac
    bne  g4_bar
    ld   0x80, x
    ld   [y,x], ac
    xor  0x80, ac
    bne  g4_bar
    ld   0x3C, ac
    ld   ac, x
    ld   0x00, ac
    ld   [y,x], ac
    xor  0x3C, ac
    bne  g4_bar
    ld   0xC3, ac
    ld   ac, x
    ld   0x00, ac
    ld   [y,x], ac
    xor  0xC3, ac
    bne  g4_bar
    ld   0x5A, ac
    bra  stage_exit4
g4_bar:
    ld   0x50, y
    ld   0x02, [y,x]
g4_blink:
    ld   0x5A, y
    ld   0x00, [y,x]
    ld   0x5B, y
    ld   0x00, [y,x]
    ld   0x60, ac
g4_swFF:
    ld   ac, y
    ld   0xFF, [y,x]
    add  0x01, ac
    bne  g4_swFF
g4_dlFF:
    ld   0x21, y
    ld   [y,x], ac
    add  0x01, ac
    ld   ac, [y,x]
    bne  g4_dlFF
    ld   0x22, y
    ld   [y,x], ac
    add  0x01, ac
    ld   ac, [y,x]
    bne  g4_dlFF
    ld   0x23, y
    ld   [y,x], ac
    add  0x20, ac
    and  0xE0, ac
    ld   ac, [y,x]
    bne  g4_dlFF
    ld   0x5A, y
    ld   0x00, [y,x]
    ld   0x5B, y
    ld   0x00, [y,x]
    ld   0x60, ac
g4_sw00:
    ld   ac, y
    ld   0x00, [y,x]
    add  0x01, ac
    bne  g4_sw00
g4_dl00:
    ld   0x21, y
    ld   [y,x], ac
    add  0x01, ac
    ld   ac, [y,x]
    bne  g4_dl00
    ld   0x22, y
    ld   [y,x], ac
    add  0x01, ac
    ld   ac, [y,x]
    bne  g4_dl00
    ld   0x23, y
    ld   [y,x], ac
    add  0x20, ac
    and  0xE0, ac
    ld   ac, [y,x]
    bne  g4_dl00
    bra  g4_blink
    #d8 0xFC, 0xFC, 0xFC, 0xFC, 0xFC, 0xFC, 0xFC, 0xFC, 0xFC, 0xFC, 0xFC, 0xFC, 0xFC, 0xFC, 0xFC, 0xFC
    #d8 0xFC, 0xFC, 0xFC, 0xFC, 0xFC, 0xFC, 0xFC, 0xFC, 0xFC, 0xFC, 0xFC, 0xFC, 0xFC, 0xFC, 0xFC, 0xFC
    #d8 0xFC, 0xFC, 0xFC, 0xFC, 0xFC, 0xFC
#addr 0x04F1
    #d8 0xFC, 0xFC, 0xFC, 0xFC, 0xFC, 0xFC, 0xFC, 0xFC, 0xFC, 0xFC, 0xFC, 0xFC, 0xFC
stage_exit4:
    nop
    nop

; stage 5
#addr 0x0500
stage5:
    beq  ac
    ld   0x3F, y
    ld   0x00, ac
g5_loop0:
    ld   ac, x
    ld   0x00, ac
    xor  0x00, ac
    bne  stage5_stop
    ld   0xFF, ac
    xor  0xFF, ac
    bne  stage5_stop
    ld   0x55, ac
    xor  0x55, ac
    bne  stage5_stop
    ld   0xAA, ac
    xor  0xAA, ac
    bne  stage5_stop
    ld   0x0F, ac
    xor  0x0F, ac
    bne  stage5_stop
    ld   0xF0, ac
    xor  0xF0, ac
    bne  stage5_stop
    ld   0x33, ac
    xor  0x33, ac
    bne  stage5_stop
    ld   0xCC, ac
    xor  0xCC, ac
    bne  stage5_stop
    ld   0x01, ac
    xor  0x01, ac
    bne  stage5_stop
    ld   0x80, ac
    xor  0x80, ac
    bne  stage5_stop
    ld   0x69, ac
    xor  0x69, ac
    bne  stage5_stop
    ld   0x96, ac
    xor  0x96, ac
    bne  stage5_stop
    ld   0x3C, ac
    xor  0x3C, ac
    bne  stage5_stop
    ld   0xC3, ac
    xor  0xC3, ac
    bne  stage5_stop
    ld   0x5A, ac
    xor  0x5A, ac
    bne  stage5_stop
    ld   [y,x], ac
    sub  0x01, ac
    bne  g5_loop0
    ld   0x00, ac
g5_loop1:
    ld   ac, x
    ld   0x01, ac
    xor  0x01, ac
    bne  stage5_stop
    ld   0x80, ac
    xor  0x80, ac
    bne  stage5_stop
    ld   0x69, ac
    xor  0x69, ac
    bne  stage5_stop
    ld   0x96, ac
    xor  0x96, ac
    bne  stage5_stop
    ld   0x3C, ac
    xor  0x3C, ac
    bne  stage5_stop
    ld   0xC3, ac
    xor  0xC3, ac
    bne  stage5_stop
    ld   0x5A, ac
    xor  0x5A, ac
    bne  stage5_stop
    ld   0x00, ac
    xor  0x00, ac
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
    ld   ac, [0x36]
    ld   0x40, ac
    ld   ac, [0x37]
    ld   0x50, y
    ld   0x00, x
t16_212:
    ld   [y,x], ac
    ld   ac, [0x35]
    and  [0x33], ac
    ld   ac, [0x33]
    ld   [0x35], ac
    or   [0x34], ac
    ld   ac, [0x34]
    ld   [0x36], ac
    dec
    ld   ac, [0x36]
    bne  t16_212
    ld   [0x37], ac
    dec
    ld   ac, [0x37]
    bne  t16_212
; at start-up a failure waits in stage 7 (the line read buffer U29 is the
; last chip of the CPU to go in), not in fail loop 16
    ld   [0x33], ac
    xor  0x00, ac
    beq  ok_213
    ld   0x50, y
    ld   0x00, x
    ld   0x00, [y,x]
    ld   wait_u29 >> 8, y
    jmp  wait_u29
ok_213:
    ld   [0x34], ac
    xor  0xFF, ac
    beq  ok_214
    ld   0x50, y
    ld   0x00, x
    ld   0x00, [y,x]
    ld   wait_u29 >> 8, y
    jmp  wait_u29
ok_214:
    ld   main >> 8, y
    jmp  main
core_loop:
; frame loop copy: tests 1-14
; ---- core tests (loop) ----
    ld   0x50, y
    ld   0x00, x
    ld   0x00, [y,x]
; test 1: branches on AC
    ld   0x00, ac
    beq  t1t_216
    bra  t1f_215
t1t_216:
    bne  t1f_215
    blt  t1f_215
    ble  t1t_217
    bra  t1f_215
t1t_217:
    bra  t1ok_218
t1f_215:
    ld   0x84, ac
    ld   fail_h >> 8, y
    jmp  fail_h
t1ok_218:
    ld   pg_219 >> 8, y
    jmp  pg_219
#addr 0x2D00
pg_219:
    ld   0x01, ac
    beq  t1f_220
    bne  t1t_221
    bra  t1f_220
t1t_221:
    blt  t1f_220
    ble  t1f_220
    bra  t1ok_222
t1f_220:
    ld   0x84, ac
    ld   fail_h >> 8, y
    jmp  fail_h
t1ok_222:
    ld   0x10, ac
    beq  t1f_223
    bne  t1t_224
    bra  t1f_223
t1t_224:
    blt  t1f_223
    ble  t1f_223
    bra  t1ok_225
t1f_223:
    ld   0x84, ac
    ld   fail_h >> 8, y
    jmp  fail_h
t1ok_225:
    ld   0x80, ac
    beq  t1f_226
    bne  t1t_227
    bra  t1f_226
t1t_227:
    blt  t1t_228
    bra  t1f_226
t1t_228:
    ble  t1t_229
    bra  t1f_226
t1t_229:
    bra  t1ok_230
t1f_226:
    ld   0x84, ac
    ld   fail_h >> 8, y
    jmp  fail_h
t1ok_230:
    ld   0xFF, ac
    beq  t1f_231
    bne  t1t_232
    bra  t1f_231
t1t_232:
    blt  t1t_233
    bra  t1f_231
t1t_233:
    ble  t1t_234
    bra  t1f_231
t1t_234:
    bra  t1ok_235
t1f_231:
    ld   0x84, ac
    ld   fail_h >> 8, y
    jmp  fail_h
t1ok_235:
    ld   0x7F, ac
    beq  t1f_236
    bne  t1t_237
    bra  t1f_236
t1t_237:
    blt  t1f_236
    ble  t1f_236
    bra  t1ok_238
t1f_236:
    ld   0x84, ac
    ld   fail_h >> 8, y
    jmp  fail_h
t1ok_238:
; test 2: AND
    ld   0xFF, ac
    and  0x0F, ac
    xor  0x0F, ac
    beq  ok_239
    ld   0x88, ac
    ld   fail_h >> 8, y
    jmp  fail_h
ok_239:
    ld   0xF0, ac
    and  0x3C, ac
    xor  0x30, ac
    beq  ok_240
    ld   0x88, ac
    ld   fail_h >> 8, y
    jmp  fail_h
ok_240:
    ld   0x55, ac
    and  0xAA, ac
    xor  0x00, ac
    beq  ok_241
    ld   0x88, ac
    ld   fail_h >> 8, y
    jmp  fail_h
ok_241:
    ld   0xA5, ac
    and  0xFF, ac
    xor  0xA5, ac
    beq  ok_242
    ld   0x88, ac
    ld   fail_h >> 8, y
    jmp  fail_h
ok_242:
    ld   0x00, ac
    and  0xFF, ac
    xor  0x00, ac
    beq  ok_243
    ld   0x88, ac
    ld   fail_h >> 8, y
    jmp  fail_h
ok_243:
; test 3: OR
    ld   0x55, ac
    or   0xAA, ac
    xor  0xFF, ac
    beq  ok_244
    ld   0x8C, ac
    ld   fail_h >> 8, y
    jmp  fail_h
ok_244:
    ld   0x0F, ac
    or   0xF0, ac
    xor  0xFF, ac
    beq  ok_245
    ld   0x8C, ac
    ld   fail_h >> 8, y
    jmp  fail_h
ok_245:
    ld   0x00, ac
    or   0x00, ac
    xor  0x00, ac
    beq  ok_246
    ld   0x8C, ac
    ld   fail_h >> 8, y
    jmp  fail_h
ok_246:
    ld   0x12, ac
    or   0x21, ac
    xor  0x33, ac
    beq  ok_247
    ld   0x8C, ac
    ld   fail_h >> 8, y
    jmp  fail_h
ok_247:
    ld   0x80, ac
    or   0x01, ac
    xor  0x81, ac
    beq  ok_248
    ld   0x8C, ac
    ld   fail_h >> 8, y
    jmp  fail_h
ok_248:
; test 4: XOR
    ld   0xFF, ac
    xor  0x0F, ac
    ld   pg_249 >> 8, y
    jmp  pg_249
#addr 0x2E00
pg_249:
    xor  0xF0, ac
    beq  ok_250
    ld   0x90, ac
    ld   fail_h >> 8, y
    jmp  fail_h
ok_250:
    ld   0x55, ac
    xor  0xFF, ac
    xor  0xAA, ac
    beq  ok_251
    ld   0x90, ac
    ld   fail_h >> 8, y
    jmp  fail_h
ok_251:
    ld   0xA5, ac
    xor  0xA5, ac
    xor  0x00, ac
    beq  ok_252
    ld   0x90, ac
    ld   fail_h >> 8, y
    jmp  fail_h
ok_252:
    ld   0x3C, ac
    xor  0x0F, ac
    xor  0x33, ac
    beq  ok_253
    ld   0x90, ac
    ld   fail_h >> 8, y
    jmp  fail_h
ok_253:
; test 5: ADD
    ld   0x0F, ac
    add  0x01, ac
    xor  0x10, ac
    beq  ok_254
    ld   0x94, ac
    ld   fail_h >> 8, y
    jmp  fail_h
ok_254:
    ld   0x01, ac
    add  0x0F, ac
    xor  0x10, ac
    beq  ok_255
    ld   0x94, ac
    ld   fail_h >> 8, y
    jmp  fail_h
ok_255:
    ld   0x7F, ac
    add  0x01, ac
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
    jmp  fail_h3
ok_463:
    ld   0xC0, y
    ld   0x00, x
    ld   [y,x], ac
    xor  0x4F, ac
    beq  ok_464
    ld   0xBC, ac
    ld   fail_h3 >> 8, y
    jmp  fail_h3
ok_464:
    ld   0x50, y
    ld   0x00, x
    ld   0x00, [y,x]
    ld   t14b_211 >> 8, y
    jmp  t14b_211

; band tables
#addr 0x8900
tbl4:
    #d8 0x00, 0x00, 0x00, 0x00, 0x00, 0x11, 0x11, 0x11, 0x11, 0x11, 0x22, 0x22, 0x22, 0x22, 0x22, 0x33
    #d8 0x33, 0x33, 0x33, 0x33, 0x44, 0x44, 0x44, 0x44, 0x44, 0x55, 0x55, 0x55, 0x55, 0x55, 0x66, 0x66
    #d8 0x66, 0x66, 0x66, 0x77, 0x77, 0x77, 0x77, 0x77, 0x88, 0x88, 0x88, 0x88, 0x88, 0x99, 0x99, 0x99
    #d8 0x99, 0x99, 0xAA, 0xAA, 0xAA, 0xAA, 0xAA, 0xBB, 0xBB, 0xBB, 0xBB, 0xBB, 0xCC, 0xCC, 0xCC, 0xCC
    #d8 0xCC, 0xDD, 0xDD, 0xDD, 0xDD, 0xDD, 0xEE, 0xEE, 0xEE, 0xEE, 0xEE, 0xFF, 0xFF, 0xFF, 0xFF, 0xFF
#addr 0x8800
tbl2:
    #d8 0x00, 0x00, 0x00, 0x00, 0x00, 0x00, 0x00, 0x00, 0x00, 0x00, 0x00, 0x00, 0x00, 0x00, 0x00, 0x00
    #d8 0x00, 0x00, 0x00, 0x00, 0x55, 0x55, 0x55, 0x55, 0x55, 0x55, 0x55, 0x55, 0x55, 0x55, 0x55, 0x55
    #d8 0x55, 0x55, 0x55, 0x55, 0x55, 0x55, 0x55, 0x55, 0xAA, 0xAA, 0xAA, 0xAA, 0xAA, 0xAA, 0xAA, 0xAA
    #d8 0xAA, 0xAA, 0xAA, 0xAA, 0xAA, 0xAA, 0xAA, 0xAA, 0xAA, 0xAA, 0xAA, 0xAA, 0xFF, 0xFF, 0xFF, 0xFF
    #d8 0xFF, 0xFF, 0xFF, 0xFF, 0xFF, 0xFF, 0xFF, 0xFF, 0xFF, 0xFF, 0xFF, 0xFF, 0xFF, 0xFF, 0xFF, 0xFF

; RAM test pages
#addr 0x9000
rt_pages:
    #d8 0x01, 0x02, 0x03, 0x04, 0x05, 0x06, 0x07, 0x08, 0x09, 0x0A, 0x0B, 0x0C, 0x0D, 0x0E, 0x0F, 0x10
    #d8 0x11, 0x12, 0x13, 0x14, 0x15, 0x16, 0x17, 0x18, 0x19, 0x1A, 0x1B, 0x1C, 0x1D, 0x1E, 0x40, 0x41
    #d8 0x42, 0x43, 0x44, 0x45, 0x46, 0x47, 0x48, 0x49, 0x4A, 0x4B, 0x4C, 0x54, 0x55, 0x56, 0x57, 0x58
    #d8 0x59
; RAM test error return
rt_dispatch:
    ld   [0x31], ac
    xor  0, ac
    bne  dp_465
    ld   rt_ret0 >> 8, y
    jmp  rt_ret0
dp_465:
    ld   [0x31], ac
    xor  1, ac
    bne  dp_466
    ld   rt_ret1 >> 8, y
    jmp  rt_ret1
dp_466:
    ld   [0x31], ac
    xor  2, ac
    bne  dp_467
    ld   rt_ret2 >> 8, y
    jmp  rt_ret2
dp_467:
    ld   [0x31], ac
    xor  3, ac
    bne  dp_468
    ld   rt_ret3 >> 8, y
    jmp  rt_ret3
dp_468:
    ld   [0x31], ac
    xor  4, ac
    bne  dp_469
    ld   rt_ret4 >> 8, y
    jmp  rt_ret4
dp_469:
    ld   [0x31], ac
    xor  5, ac
    bne  dp_470
    ld   rt_ret5 >> 8, y
    jmp  rt_ret5
dp_470:
    ld   rt_ret0 >> 8, y
    jmp  rt_ret0
#addr 0x8950
s_title:
    #d "PLACARD BRING-UP ROM                                         FRAME", 0x00
#addr 0x8993
s_core:
    #d "CPU CORE TESTS 1-16 PASSED.  REPEATED EVERY FRAME, LOOPS:", 0x00
#addr 0x8850
s_core2:
    #d "A FAILED TEST STOPS THE CPU IN A LOOP AT x0080 + 4 x TEST (SEE BRINGUP.MD)", 0x00
#addr 0x889B
s_ram:
    #d "RAM PAGE        PASSES          ERRORS          LAST BAD       WROTE     READ", 0x00
#addr 0x89CD
s_kbd:
    #d "KBD_NOW (KEYS HELD):", 0x00
#addr 0x89E2
s_kbd2:
    #d "TYPED:", 0x00
#addr 0x90A0
s_pad:
    #d "SNES PADS:  1:          2:", 0x00
#addr 0x90BB
s_sd:
    #d "SD CARD: SD_INIT      FS_MOUNT      (S = TRY AGAIN)", 0x00
#addr 0x89E9
s_on:
    #d "ON ", 0x00
#addr 0x88E9
s_off:
    #d "OFF", 0x00

; strings
#addr 0xDC00
s_sd2:
    #d "  SD_INIT 00 READY, 01 NO CARD, 02 DID NOT START, 03 UNUSABLE.  FS_MOUNT 00 OK", 0x00
s_mouse:
    #d "MOUSE: MOUSE_INIT      X        Y        BUTTONS", 0x00
s_mouse2:
    #d "  MOUSE_INIT 00 RUNNING, 01 NO MOUSE, 02 WRONG ANSWER", 0x00
s_snd:
    #d "SOUND: T = 1 KHZ TEST TONE, NOW", 0x00
s_line:
    #d "VIDEO LINE READ (V9:V2):", 0x00
s_w1:
    #d "PLACARD BRING-UP ROM", 0x00
s_w2:
    #d "CPU AND MEMORY TESTS 1-15 PASSED.", 0x00
s_w3:
    #d "WAITING FOR THE LINE READ BUFFER U29 (STEP 22).", 0x00
s_w4:
    #d "FIT U29, OR IF IT IS IN, CHECK IT.  PC HIGH = 07.", 0x00
s_bands:
    #d "BANDS BELOW: 16 COLORS (4 BPP), 4 COLORS (2 BPP), 256 COLORS (8 BPP)", 0x00
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
