tocksin/placard/src/scripts/rom_boot.asm

; ============================================================
; rom_boot.asm - Placard ROM boot loader
; ============================================================
;
; The ROM/RAM map clears to all ROM at power-up, so the CPU starts here,
; in the ROM, at PC = 0000.  Video reads always read the RAM (memory
; control PLD revision 04); only CPU reads follow the map.  The byte at
; BOOT_MODE (ROM x0005, written by gen_rom.tcl) picks how to start.
; docs/architecture/ROM.md has the ROM layout.  Every ROM has the released
; 32K image's sections 4-7 (x8000-xFFFF: the library, the FAT code, BASIC);
; a development ROM adds a program in the first 32K.
;
; BOOT_MODE = 02: the 32K image (the release, docs/architecture/ROM.md "The 32K image").
;   Map = 05 and MAP_SHADOW = 05, then a jump to the loader at DOS_START
;   (x8100).  The image is x8000-xFFFF: gen_rom.tcl puts a copy of the
;   reset code at x8000 and BOOT_MODE at x8005, which a 32K cartridge
;   reads at x0000 and x0005.  Programs come from the SD card.
;
; BOOT_MODE = 00: ROM program (a development ROM, 64K cartridge).
;   The program runs in place from ROM x6000-x7FFF (and x2000-x3FFF) and
;   calls the library in place.  The boot writes map = 05: sections 0
;   (zero page, x0000-x1FFF) and 2 (x4000-x5FFF: mode bytes, audio,
;   program data) read RAM; 1 and 3-7 (program, library) read ROM, while
;   the video still shows the RAM.  It sets MAP_SHADOW = 05 and jumps to
;   the program's entry at x6000.
;
; BOOT_MODE = 01: RAM image (the older demos, written to run at RAM x0000;
; a development ROM, 64K cartridge).
;     ROM x6000-x7FFF  ->  RAM x0000-x1FFF      (ROM address = RAM + x6000)
;     ROM x2000-x49FF  ->  RAM x2000-x49FF      (the same address)
;   1. map = 01: section 0 (the zero page) reads RAM, so the loop can keep
;      its page counters there.  The boot loader runs in section 7, whose
;      map bit does not change, so the next fetch is safe.
;   2. copy RAM pages x01-x1F from ROM pages x61-x7F, pages x20-x49 from
;      the same ROM pages (IMAGE_SAME), then page x00 from ROM x60 (last,
;      because it holds the loop's counters).
;   3. copy map_switch (8 bytes) from the ROM into the RAM under it, so the
;      fetch after the map write reads the same bytes from either memory.
;      map_switch is in byte column 79's first 32 bytes (xFE00-xFE1F),
;      which the video reads only in vertical blanking, so they are never
;      seen on the screen.
;   4. map = FF (every section reads RAM), jump to x0000.  The RAM's zero
;      page is then exactly the program's page x00 (MAP_SHADOW is not set,
;      because the older demos keep code there).
;   The copy takes about 30 clocks a byte (the count is kept in the zero
;   page, X is not a source), about 23 ms for the 18,944 bytes.
;
; The boot reads BOOT_MODE from the ROM with map 00 just before it starts
; the program (not earlier into the zero page, which a card's boot code may
; use).
;
;     customasm rom_boot.asm -f hexstr -o rom_boot.hex
;     python3 placard_sim.py rom_boot.asm
;
;
; LIBRARY RAM CODE, first of all: the library code that reads the video RAM
; (LIB_RAM, placard_lib.asm) must run from the RAM, so the boot copies ROM
; x1F00-x1FFF into RAM x1F00-x1FFF while the map is still 00 (every read
; from ROM, every write to RAM), keeping its count in AC: ld [y,x], [y,x]
; reads the ROM and writes the RAM at the same address.
;
; EXPANSION CARDS (docs/architecture/EXPANSION.md), before either mode, like the Apple II's
; slot scan:
;   1. map = 01, so the zero page is RAM.
;   2. For slots 4, 3, 2, 1: if the card's first bytes are "PLC", card
;      ID, code length n (1-90), checksum (the sum of the n code bytes),
;      then the n code bytes are copied to RAM x0100 and called (the
;      library's CALL) with AC = slot number, R1:R0 = the slot's base
;      address, SP = FE and MAP_SHADOW = 01.  Before the first card found
;      is called, esc_wait lets the PS/2 keyboard send for up to about
;      1 s (its self test takes up to 0.75 s after power-up; its AA then
;      buys 0.17 s more): Esc held (make code 76) skips every card.  The card's code
;      returns to go on with the next slot and then the normal boot, or
;      never returns to take the boot over (load its own program, start
;      from its own ROM).  It may use the library and the I/O drivers.
;      It must keep zero page xFF (the slot being scanned), leave map 01
;      when it returns, and keep section 7 reading the ROM.
;   An empty slot reads FF (the read bus pull-ups), so it fails the check.
;
; gen_rom.tcl merges rom_boot.hex, rom_lib.hex and the program into
; rom.mem.  The CPU's PC starts at 0000, so x0000-x0004 of the ROM is
; this file's reset code, not the program's.  x0000 is a 1-byte nop:
; the cartridge loader hands the CPU over at x0000 either in FETCH or in
; LOAD_IMM (the operand read of the image's last instruction), so the
; byte there is either run or skipped, and the CPU fetches x0001 next
; (docs/architecture/ROM.md, "Loading the cartridge").
;
; Date: 11/11/2026

#include "placard.asm"

ROM_IMAGE   = 0x60      ; ROM page that holds RAM page x00
IMAGE_END   = 0x4A      ; first RAM page not copied (x4A00; the older demos fit below it)
IMAGE_SAME  = 0x20      ; RAM pages from here up are kept in the ROM at their own address
MAP_PORT    = 0x50      ; ROM/RAM map register page (write only)
DST         = 0xFE      ; RAM page being written (zero page, during the copy)
SRC         = 0xFF      ; ROM page being read (then page x00's count)
CNT         = 0xFD      ; byte in the page (X is not a source)
MAP_SHADOW  = 0x07      ; zeropage.asm: copy of the map register
FONT_PG     = 0xBF      ; zeropage.asm: high byte of the font's first page
LIB_FONT    = 0x9700    ; placard_lib.asm: the standard font
MAP_ROM_RUN = 0x05      ; ROM program: sections 0 and 2 read RAM, 1 and 3-7 ROM
PROG_START  = 0x6000    ; ROM program entry
DOS_START   = 0x8100    ; the DOS's entry (dos.masm)
BOOT_MODE   = 0x05      ; ROM x0005: 00 = ROM program, 01 = RAM image, 02 = the 32K image (set by gen_rom.tcl)
MODE_DOS    = 0x02
PORT        = 0x5200    ; shared port latch (placard_io.asm)
PORT_RX     = 0x02      ; x5202: the PS/2 receiver's byte; a write re-arms it
PORT_RDY    = 0x03      ; x5203: D7 = 0 while a byte is ready
P_IDLE      = 0xEB      ; the latch at rest (both PS/2 clocks held)
P_KFREE     = 0xFB      ; the same with the PS/2 keyboard's clock free
ESC_MAKE    = 0x76      ; Esc's scan code (set 2)
KBD_BAT     = 0xAA      ; the keyboard's self test passed
ESC_WAIT    = 12        ; esc_wait: about 83 ms units, 1 s
ESC_MORE    = 2         ; ... after the keyboard's AA: 0.17 s more
KCHK        = 0xFC      ; zero page: 1 once esc_wait has looked
MAP_ZP_RAM  = 0x01      ; section 0 reads RAM, the rest ROM
LIB_RAM     = 0x1F00    ; placard_lib.asm: library code that runs from the RAM
CARD_CODE   = 0x0100    ; where a card's boot code is copied and run
CARD_MAX    = 90        ; longest card boot code (offsets 06-5F)

LINK_LO     = 0x04      ; zeropage.asm
LINK_HI     = 0x05
SP          = 0x06
R0          = 0x10
R1          = 0x11
T0          = 0x18      ; code length
T1          = 0x19      ; checksum from the card
T2          = 0x1A      ; byte being copied
T3          = 0x1B      ; sum of the bytes copied
T4          = 0x1C
T5          = 0x1D      ; esc_wait: the time left, low
T6          = 0x1E
T7          = 0x1F      ; and high (83 ms units)
SLOT        = 0xFF      ; slot being scanned, 4 down to 1

#addr 0x0000
    nop                 ; the cartridge hands off in FETCH or LOAD_IMM at x0000
reset:
    ld   boot >> 8, y
    jmp  boot

#addr BOOT_MODE
boot_mode:
    #d8 0x00                    ; gen_rom.tcl writes the mode here

#addr 0xFD00
boot:
    ld   PORT >> 8, y           ; shared port at rest (docs/architecture/IO.md): SD /CS low
    ld   PORT_RX, x             ; (holds both PS/2 clocks low), SCK and MOSI
    ld   P_IDLE, [y,x]          ; high; the PS/2 receiver re-armed
    ld   LIB_RAM >> 8, y        ; copy LIB_RAM from the ROM to the RAM (map 00)
    clr  ac
lib_copy:
    ld   ac, x
    ld   [y,x], [y,x]           ; read the ROM, write the RAM
    inc
    bne  lib_copy
    ld   MAP_PORT, y
    ld   MAP_ZP_RAM, [y,x]      ; map = 01: the zero page is RAM
    clr  ac                     ; Esc not looked for yet (esc_wait)
    ld   ac, [KCHK]
    ld   4, ac
    ld   ac, [SLOT]
    ld   scan >> 8, y
    jmp  scan

; ------------------------------------------------------------
; esc_wait - a card was found: is Esc held on the PS/2 keyboard?
;   Lets the keyboard send and takes its bytes for about 1 s (ESC_WAIT),
;   its self test's AA buying ESC_MORE more: Esc's make code skips the
;   cards (boot_go), anything else or nothing runs the card (run_card).
;   Looks once (KCHK).  A loop pass is about 1.3 us, 65536 of them 83 ms.
; ------------------------------------------------------------
esc_wait:
    ld   1, ac                  ; once
    ld   ac, [KCHK]
    ld   PORT >> 8, y
    ld   PORT_RX, x
    ld   P_KFREE, [y,x]         ; let the keyboard send
    ld   ESC_WAIT, ac
    ld   ac, [T7]
    clr  ac
    ld   ac, [T6]
    ld   ac, [T5]
ew_loop:
    ld   PORT_RDY, x
    ld   [y,x], ac
    blt  ew_count               ; D7 = 1: nothing yet
    ld   PORT_RX, x
    ld   [y,x], ac              ; the byte
    ld   P_KFREE, [y,x]         ; re-arm
    xor  ESC_MAKE, ac
    beq  ew_esc
    xor  ESC_MAKE ^ KBD_BAT, ac ; its self test done: a held key comes soon
    bne  ew_count
    ld   ESC_MORE, ac
    ld   ac, [T7]
ew_count:
    ld   [T5], ac
    dec
    ld   ac, [T5]
    bne  ew_loop
    ld   [T6], ac
    dec
    ld   ac, [T6]
    bne  ew_loop
    ld   [T7], ac
    dec
    ld   ac, [T7]
    bne  ew_loop
    ld   PORT_RX, x             ; no Esc: hold the keyboard, run the card
    ld   P_IDLE, [y,x]
    ld   run_card >> 8, y
    jmp  run_card
ew_esc:
    ld   PORT_RX, x             ; Esc: hold the keyboard, skip the cards
    ld   P_IDLE, [y,x]
    ld   boot_go >> 8, y
    jmp  boot_go

boot_go:
    ld   MAP_PORT, y            ; map = 00 again: the zero page reads the ROM,
    ld   0x00, [y,x]            ; where BOOT_MODE is (x0005; a 32K cartridge
    ld   [BOOT_MODE], ac        ; shows x8005 there)
    beq  boot_rom
    xor  MODE_DOS, ac
    bne  boot_copy

    ld   MAP_PORT, y            ; the DOS
    ld   MAP_ROM_RUN, [y,x]     ; map = 05 (section 7 keeps its bit)
    ld   MAP_ROM_RUN, ac
    ld   ac, [MAP_SHADOW]
    ld   DOS_START >> 8, y
    jmp  DOS_START & 0xFF

boot_rom:
    ld   MAP_PORT, y            ; ROM program
    ld   MAP_ROM_RUN, [y,x]     ; map = 05 (section 7 keeps its bit)
    ld   MAP_ROM_RUN, ac
    ld   ac, [MAP_SHADOW]
    ld   LIB_FONT >> 8, ac      ; the standard font
    ld   ac, [FONT_PG]
    ld   PROG_START >> 8, y
    jmp  PROG_START & 0xFF

boot_copy:                      ; RAM image
    ld   MAP_PORT, y
    ld   0x01, [y,x]            ; map = 01: section 0 reads RAM, the rest ROM

    ld   0x01, ac               ; pages x01-x49 first (the zero page is RAM now)
    ld   ac, [DST]
    ld   ROM_IMAGE + 1, ac
    ld   ac, [SRC]
    clr  ac
    ld   ac, [CNT]
    clr  x
copy_byte:                      ; X = CNT = byte in the page, 00 at the start of a page
    ld   [SRC], y
    ld   [y,x], ac              ; read the ROM (sections 3-7 read ROM)
    ld   [DST], y
    ld   ac, [y,x]              ; write the RAM (every write goes to RAM)
    ld   [CNT], ac
    inc
    ld   ac, [CNT]
    ld   ac, x
    bne  copy_byte
    ld   [SRC], ac              ; next page; X is 00 again
    inc
    ld   ac, [SRC]
    ld   [DST], ac
    inc
    ld   ac, [DST]
    xor  IMAGE_END, ac
    beq  copy_done
    xor  IMAGE_END ^ IMAGE_SAME, ac
    bne  copy_byte
    ld   IMAGE_SAME, ac         ; from here the ROM page is the RAM page
    ld   ac, [SRC]
    bra  copy_byte
copy_done:

    ld   ac, [SRC]              ; AC = X = 00: SRC counts page x00 now
copy_page0:                     ; page x00 last: it overwrites DST, CNT and,
    ld   ROM_IMAGE, y           ; last of all, SRC (xFF)
    ld   [y,x], ac
    ld   0x00, y
    ld   ac, [y,x]
    ld   [SRC], ac
    inc
    ld   ac, [SRC]
    ld   ac, x
    xor  0xFF, ac
    bne  copy_page0
    ld   ROM_IMAGE, y           ; X = FF
    ld   [y,x], ac
    ld   0x00, y
    ld   ac, [y,x]

    ld   map_switch >> 8, y     ; map_switch into the RAM under it
    ld   7, ac
copy_switch:
    add  map_switch & 0xFF, x   ; X = map_switch + AC, AC = 7 ... 0
    ld   [y,x], [y,x]           ; read the ROM, write the RAM
    sub  1, ac
    bcc  copy_switch            ; no borrow, AC was not 0
    jmp  map_switch             ; Y is still map_switch's page

#addr 0xFE00
map_switch:                     ; also in the RAM: the fetches after the map write
    ld   MAP_PORT, y
    ld   0xFF, [y,x]            ; map = FF: every section reads RAM
    ld   0x00, y
    jmp  0x00                   ; the program's reset code in the RAM

; ------------------------------------------------------------
; the expansion card scan, slots 4 down to 1
; ------------------------------------------------------------
scan:
    ld   [SLOT], ac             ; R1:R0 = the slot's base address
    add  (slot_hi - 1) & 0xFF, x
    ld   slot_hi >> 8, y
    ld   [y,x], ac
    ld   ac, [R1]
    ld   [SLOT], ac
    add  (slot_lo - 1) & 0xFF, x
    ld   [y,x], ac
    ld   ac, [R0]
    ld   [R1], y
    ld   [R0], x                ; "PLC"
    ld   [y,x], ac
    xor  0x50, ac
    bne  next
    ld   [R0], ac
    add  1, x
    ld   [y,x], ac
    xor  0x4C, ac
    bne  next
    ld   [R0], ac
    add  2, x
    ld   [y,x], ac
    xor  0x43, ac
    bne  next
    ld   [R0], ac               ; code length, 1-90
    add  4, x
    ld   [y,x], ac
    ld   ac, [T0]
    beq  next
    blt  next
    sub  CARD_MAX + 1, ac
    bcc  next
    ld   [R0], ac               ; checksum
    add  5, x
    ld   [y,x], ac
    ld   ac, [T1]
    clr  ac
    ld   ac, [T2]
    ld   ac, [T3]
copy_card:                      ; card offset 6 + n to RAM x0100 + n
    ld   [R0], ac
    add  6, ac
    add  [T2], x
    ld   [R1], y
    ld   [y,x], ac
    ld   ac, [T4]
    add  [T3], ac
    ld   ac, [T3]
    ld   [T2], x
    ld   CARD_CODE >> 8, y
    ld   [T4], ac
    ld   ac, [y,x]
    ld   [T2], ac
    inc
    ld   ac, [T2]
    xor  [T0], ac
    bne  copy_card
    ld   [T3], ac
    xor  [T1], ac
    bne  next
    ld   [KCHK], ac             ; the first card found: Esc held?
    bne  run_card
    ld   esc_wait >> 8, y
    jmp  esc_wait
run_card:
    ld   0xFE, ac               ; run it: stack below SLOT
    ld   ac, [SP]
    ld   MAP_ZP_RAM, ac
    ld   ac, [MAP_SHADOW]
    ld   LINK_LO, x
    ld   card_back, [x]
    ld   LINK_HI, x
    ld   card_back >> 8, [x]
    ld   [SLOT], ac
    ld   CARD_CODE >> 8, y
    jmp  CARD_CODE & 0xFF
card_back:
    ld   MAP_PORT, y
    ld   MAP_ZP_RAM, [y,x]
next:
    ld   [SLOT], ac
    dec
    ld   ac, [SLOT]
    bne  scan
    ld   boot_go >> 8, y
    jmp  boot_go

slot_hi:    ; slots 1-4: x5100, x5300, x5180, x5380
    #d8 0x51, 0x53, 0x51, 0x53
slot_lo:
    #d8 0x00, 0x00, 0x80, 0x80

; mul8's quarter-square tables (placard_lib.asm), in the free pages here:
; the high bytes at xFC01-xFCFF, the low bytes at xFF00-xFFFF
#include "lib_sqtab.asm"
