tocksin/placard/src/scripts/tracker.asm

; ============================================================
; made by asm_expand.py from tracker.masm: change that file, then run
;     python3 asm_expand.py tracker.masm
; ============================================================

; ============================================================
; tracker.masm - TRACKER.PLC: the PLACARD music editor (docs/sound/MUSIC.md)
; ============================================================
;
; A library program the DOS runs from the card.  It edits a song for the
; music player (placard_mus.masm) on the machine: the orderlists, the
; patterns of the four voices side by side, the instruments and the wave
; and pulse tables, plays it while editing, and loads and saves .SNG
; files on the card (the same files mus_tool.py makes).  It starts with
; DEMO.SNG when the card has it, else with a blank song.
;
; The screen is 80 x 30 text on 2x lines (VIDEO.md, line repeat): the
; editor and the player are more code than the RAM beside a 1x screen
; holds, and the even video pages that 2x frees hold most of the code and
; the patterns.
;
;
;   row 0        the header: file, title, octave, instrument, mode, state
;   rows 2-10    left: the orderlists (8 positions, the > marks the one
;                shown below); right: the instrument and its fields
;   row 12-13    the pattern's title and the voice columns
;   rows 14-     the four voices' patterns at the order position, a row
;                per line: note, instrument, effect (or the wave or
;                pulse table when that pane is shown)
;   rows -2, -1  the status line and the keys
;
; Tints: the header and the keys gold, the active pane's cursor row blue,
; the row being played green (cyan when the cursor follows it).
;
; Memory.  TRACKER.PLC loads at x0100-x3DFF (code to x33FF, then the
; player's tables); the rest of the code is TRACKER.OVL, which main reads
; into the even pages xA8, xAA ... xFE (gen_plc.py --overlay).  Every
; pattern has a 256-byte slot of its own: the 40 slots are the even pages
; x60 ... xA6 and the RAM pages x57, x58, x59, x5C.  The song's header
; pages (title, tables, instruments, custom waves) are at x4800-x4CFF and
; the orderlists at x5600 (64 bytes a voice); the player reads the
; patterns where they are through the offsets in page 0, which this
; program keeps.  The decoded form of the orderlists is in the player's
; own state pages (x4310-x436D and the same in the next three pages); a
; pattern being edited is decoded into x5400 (64 rows x 4 bytes);
; x5400-x55FF is the file buffer while loading and saving.
;
; The map.  The CPU reads the ROM above x6000 under the map a library
; program runs with (07), so this program sets the map to FF (every
; section RAM) and goes back to 07 only for the library and DOS routines
; it calls (the l_* stubs below call them through the library's lib_far,
; x1FA0, which uses MAP_SHADOW = 07) and in tputc while it reads
; the font.  LEAVE goes to tr_leave, a copy of lib_leave in the RAM.  The
; stubs, tr_leave, tputc, ovl_load and exit_dos must therefore sit below
; x3400 (they do: they come first in the file).
;
; Keys (no function keys on the 63-key layout; Ctrl-Q/R/S/T are the
; arrows, so the file keys are Ctrl-O, Ctrl-W, Ctrl-N, Ctrl-E, Ctrl-X):
;
;   Z-M , L .      notes, the lower octave      Q-I 9 O 0 P  the upper
;   1              key off (note column)        - =          octave
;   < >            the instrument for new notes
;   Tab            next pane: pattern, order, instrument, wave, pulse
;   arrows         move                         Del, Backspace  clear
;   0-9 A-F        a hex digit into the field under the cursor
;   [ ]            order pane: transpose; instrument and table panes: -1 +1
;   I / L / S      order pane: insert a position / loop here / stop here
;   Enter          play the song from the start
;   Space          play from the order position shown (stop when playing)
;   Esc            back to the DOS (twice when the song is not saved)
;   Ctrl-L         pattern length 64 > 16 > 32 > 64
;   Ctrl-O / W     load / save a .SNG (the name is asked on the status row)
;   Ctrl-N         a blank song
;   Ctrl-X         the same
;
;     python3 asm_expand.py tracker.masm              tracker.asm
;     python3 gen_plc.py tracker.asm -o ../../sdcard/TRACKER.PLC --overlay 0xA800,2
;                                                     (and TRACKER.OVL)
;     python3 test_tracker.py                         runs it in placard_sim
;
; Date: 11/11/2026
; ============================================================

#include "placard.asm"
#include "placard_lib.asm"

MUS_TABLES = 0x3400         ; the player's tables, 10 pages (in the file)
MUS_RAM    = 0x3E00         ; the player's RAM, 10 pages
VSPAGE     = (MUS_RAM >> 8) + 5   ; voice state pages (voice v at VSPAGE + v)
SONG       = 0x4800         ; the song's header pages 0-4
OLIST      = 0x5600         ; the encoded orderlists, voice v at v x 64
EMPTY_LO   = 0x07           ; SONG + 7 holds FF: the pattern of unused slots
OLH        = (OLIST - SONG) >> 8   ; the orderlists' offset, high byte
OVL_PAGE   = 0xA8           ; the overlay's first page (every 2nd page from there)
CAP        = 40             ; pattern slots
CAP_VID    = 36             ; of them in the video pages x60 + 2n; the rest in ramsl
SLOT_LO    = 0              ; a slot's low byte (256-byte slots)
ROWS       = 30             ; text rows
PV         = 14             ; pattern rows shown
SCRATCH    = 0x5400         ; the decoded pattern: 64 rows x 4 bytes
ENCBUF     = 0x5500         ; a pattern being encoded
FBUF       = 0x5400         ; 512-byte file buffer (both pages) while loading, saving
PTAB_PG    = 0x5D           ; slot table: x5D00 + n = page, x5D40 + n = low byte
PTAB_HI    = 0x00
PTAB_LO    = 0x40
FS_REM_LO  = 0x4D28         ; the FAT reader's bytes left (placard_fs.asm V_REM)
FS_REM_HI  = 0x4D29
dos_back   = 0x8008
fs_create  = 0x8010         ; the DOS's FAT writer (docs/software/DOS.md)
fs_write   = 0x8014
fs_close   = 0x8018

; decoded orderlists, in the voice state pages (below the player's x76)
OD_PAT  = 0x10              ; + 2k: pattern of position k (k < 30)
OD_TR   = 0x11              ; + 2k: its transpose (signed)
OD_LEN  = 0x4C              ; positions
OD_END  = 0x4D              ; FE stop, FF loop
OD_TGT  = 0x4E              ; the loop's position
OD_OFF  = 0x50              ; + k: byte offset of position k in the encoded list (k <= len)
OD_MAX  = 30

; the decoded pattern: SCRATCH + 4 x row
D_NOTE = 0                  ; 00-5F, 60 key off, 61 none
D_INS  = 1                  ; FF none
D_FX   = 2                  ; FF none
D_PAR  = 3

; instrument bytes
I_AD = 0
I_SR = 1
I_WAVE = 2
I_PULSE = 3
I_PW = 4
I_FLAGS = 5
I_VDLY = 6
I_VIB = 7
I_VOL = 8
I_NAME = 9

; screen
ROW_HDR  = 0
ROW_ORD  = 3                ; first of 8 orderlist rows (titles on row 2)
ROW_INS  = 2                ; instrument panel rows 2-8
COL_INS  = 40
ROW_PTIT = 12
ROW_GRID = 14               ; first pattern row
COL_GRID = 6                ; voice 0's cell; a voice is 12 columns
ORD_ROWS = 8

TINT_GOLD  = 0x30
TINT_BLUE  = 0x40
TINT_GREEN = 0x20

; zero page x20-x5F
e_res   = 0x20              ; load_cmd: load_song's result across the redraw
e_pane  = 0x23              ; 0 pattern, 1 order, 2 instrument, 3 wave, 4 pulse
e_oct   = 0x26
e_ins   = 0x27
e_op    = 0x28              ; order position shown
e_otop  = 0x29              ; first order position on the screen
c_v     = 0x2A              ; pattern cursor: voice
c_row   = 0x2B              ;   row
c_col   = 0x2C              ;   column 0 note, 1-2 instrument, 3 effect, 4-5 parameter
c_top   = 0x2D              ; first pattern row on the screen
o_v     = 0x2E              ; order cursor: voice
o_k     = 0x2F              ;   position
o_f     = 0x30              ;   0 pattern, 1 transpose
i_f     = 0x31              ; instrument field 0-11
t_e     = 0x32              ; table entry 1-63
t_f     = 0x33              ; table side 0 left, 1 right
e_play  = 0x34
e_dirty = 0x35              ; 01 grid, 02 order, 04 instrument, 08 header, 10 table, 20 title
e_drow  = 0x36              ; grid draw: next voice column
p_len   = 0x37              ; rows of the decoded pattern
p_pat   = 0x38              ; which pattern SCRATCH holds (FF none)
e_plop  = 0x39              ; the position voice 1 plays (FF none)
e_plrow = 0x3A              ; the row it plays
s_col   = 0x3B              ; status: the column after its string (prompt)
e_mod   = 0x3C              ; the song changed since it was saved
e_key   = 0x3D
e_name  = 0x3E              ; x3E-x4A: the file name and a 00
p_ch    = 0x4B              ; text output
p_k     = 0x4C
p_pg    = 0x4D
p_off   = 0x4E
p_st    = 0x4F
u0 = 0x50                   ; scratch, the lower routines
u1 = 0x51
u2 = 0x52
u3 = 0x53
u4 = 0x54
u5 = 0x55
u6 = 0x56
u7 = 0x57
w0 = 0x58                   ; scratch, the higher routines
w1 = 0x59
w2 = 0x5A
w3 = 0x5B
w4 = 0x5C
w5 = 0x5D
i_np    = 0x5E              ; the name character being typed
e_fl    = 0x5F              ; bit 0: Esc / Ctrl-X pressed once

; MAP07 / MAPFF - the map register (x5000): the library's map, all RAM


; ============================================================
; main
; ============================================================

#addr 0x0100
main:
    ld   STACK_TOP, ac
    ld   ac, [SP]
    ld   0x07, ac
    ld   ac, [MAP_SHADOW]
    ld   LINK_LO, x             ; CALL l_fs_mount
    ld   tr_r1, [x]
    ld   LINK_HI, x
    ld   tr_r1 >> 8, [x]
    ld   l_fs_mount >> 8, y
    jmp  l_fs_mount
tr_r1:
    ld   LINK_LO, x             ; CALL ovl_load
    ld   tr_r2, [x]
    ld   LINK_HI, x
    ld   tr_r2 >> 8, [x]
    ld   ovl_load >> 8, y
    jmp  ovl_load
tr_r2:
    ld   0x50, y
    clr  x
    ld   0xFF, [y,x]
    clr  ac
    ld   ac, [e_pane]
    ld   ac, [e_ins]
    ld   ac, [e_op]
    ld   ac, [e_otop]
    ld   ac, [c_v]
    ld   ac, [c_row]
    ld   ac, [c_col]
    ld   ac, [c_top]
    ld   ac, [o_v]
    ld   ac, [o_k]
    ld   ac, [o_f]
    ld   ac, [i_f]
    ld   ac, [t_f]
    ld   ac, [e_play]
    ld   ac, [e_mod]
    ld   ac, [e_fl]
    ld   ac, [i_np]
    ld   1, ac
    ld   ac, [t_e]
    ld   4, ac
    ld   ac, [e_oct]
    ld   0xFF, ac
    ld   ac, [p_pat]
    ld   ac, [e_plop]
    ld   ac, [e_plrow]
    ld   LINK_LO, x             ; CALL set_slots
    ld   tr_r3, [x]
    ld   LINK_HI, x
    ld   tr_r3 >> 8, [x]
    ld   set_slots >> 8, y
    jmp  set_slots
tr_r3:
    ld   LINK_LO, x             ; CALL clear_screen
    ld   tr_r4, [x]
    ld   LINK_HI, x
    ld   tr_r4 >> 8, [x]
    ld   clear_screen >> 8, y
    jmp  clear_screen
tr_r4:
    ld   LINK_LO, x             ; CALL new_song
    ld   tr_r5, [x]
    ld   LINK_HI, x
    ld   tr_r5 >> 8, [x]
    ld   new_song >> 8, y
    jmp  new_song
tr_r5:
    ld   s_demo & 0xFF, ac      ; DEMO.SNG when the card has it
    ld   ac, [R0]
    ld   s_demo >> 8, ac
    ld   ac, [R1]
    ld   LINK_LO, x             ; CALL copy_name
    ld   tr_r6, [x]
    ld   LINK_HI, x
    ld   tr_r6 >> 8, [x]
    ld   copy_name >> 8, y
    jmp  copy_name
tr_r6:
    ld   LINK_LO, x             ; CALL load_song
    ld   tr_r7, [x]
    ld   LINK_HI, x
    ld   tr_r7 >> 8, [x]
    ld   load_song >> 8, y
    jmp  load_song
tr_r7:
    ld   LINK_LO, x             ; CALL redraw_all
    ld   tr_r8, [x]
    ld   LINK_HI, x
    ld   tr_r8 >> 8, [x]
    ld   redraw_all >> 8, y
    jmp  redraw_all
tr_r8:
    ld   loop >> 8, y
    jmp  loop

; ============================================================
; the frame loop
; ============================================================
s_ovl:
    #d "TRACKER.OVL", 0x00
s_demo:
    #d "DEMO.SNG", 0x00

; ------------------------------------------------------------
; tr_leave - the library's lib_leave (LEAVE) copied into the RAM: the
; ROM is mapped out while this program runs
; ------------------------------------------------------------
tr_leave:
    ld   ac, [SAVE_AC]
    ld   [SP], ac
    inc
    ld   ac, x
    inc
    ld   ac, [SP]
    ld   [x], ac
    ld   ac, [LINK_LO]
    ld   [SP], x
    ld   [x], ac
    ld   ac, y
    ld   [SAVE_AC], ac
    jmp  [LINK_LO]

; ------------------------------------------------------------
; l_* - the library and DOS routines, called under the library's map
; (see the header); exit_dos - back to the DOS under its map
; ------------------------------------------------------------
l_wait_frames:
    ld   LF_HI >> 8, y          ; lib_far: wait_frames under the library's map
    ld   LF_HI & 0xFF, x
    ld   wait_frames >> 8, [y,x]
    ld   LF_LO & 0xFF, x
    ld   wait_frames & 0xFF, [y,x]
    ld   LIB_FAR >> 8, y
    jmp  LIB_FAR

l_kbd_scan:
    ld   LF_HI >> 8, y          ; lib_far: kbd_scan under the library's map
    ld   LF_HI & 0xFF, x
    ld   kbd_scan >> 8, [y,x]
    ld   LF_LO & 0xFF, x
    ld   kbd_scan & 0xFF, [y,x]
    ld   LIB_FAR >> 8, y
    jmp  LIB_FAR

exit_dos:
    ld   0x50, y
    clr  x
    ld   0x07, [y,x]
    ld   dos_back >> 8, y
    jmp  dos_back

; ------------------------------------------------------------
; ovl_load - TRACKER.OVL (the code gen_plc.py put in the overlay) into
; the even pages from OVL_PAGE: a sector holds two of them
; ------------------------------------------------------------

#addr 0x0200
loop:
    ld   1, ac
    ld   LINK_LO, x             ; CALL l_wait_frames
    ld   tr_r9, [x]
    ld   LINK_HI, x
    ld   tr_r9 >> 8, [x]
    ld   l_wait_frames >> 8, y
    jmp  l_wait_frames
tr_r9:
    ld   LINK_LO, x             ; CALL mus_frame
    ld   tr_r10, [x]
    ld   LINK_HI, x
    ld   tr_r10 >> 8, [x]
    ld   mus_frame >> 8, y
    jmp  mus_frame
tr_r10:
    ld   LINK_LO, x             ; CALL l_kbd_scan
    ld   tr_r11, [x]
    ld   LINK_HI, x
    ld   tr_r11 >> 8, [x]
    ld   l_kbd_scan >> 8, y
    jmp  l_kbd_scan
tr_r11:
    ld   LINK_LO, x             ; CALL follow
    ld   tr_r12, [x]
    ld   LINK_HI, x
    ld   tr_r12 >> 8, [x]
    ld   follow >> 8, y
    jmp  follow
tr_r12:
    ld   LINK_LO, x             ; CALL l_kbd_getc
    ld   tr_r13, [x]
    ld   LINK_HI, x
    ld   tr_r13 >> 8, [x]
    ld   l_kbd_getc >> 8, y
    jmp  l_kbd_getc
tr_r13:
    beq  lp_draw
    ld   ac, [e_key]
    ld   LINK_LO, x             ; CALL handle_key
    ld   tr_r14, [x]
    ld   LINK_HI, x
    ld   tr_r14 >> 8, [x]
    ld   handle_key >> 8, y
    jmp  handle_key
tr_r14:
lp_draw:
    ld   LINK_LO, x             ; CALL draw_step
    ld   tr_r15, [x]
    ld   LINK_HI, x
    ld   tr_r15 >> 8, [x]
    ld   draw_step >> 8, y
    jmp  draw_step
tr_r15:
    ld   loop >> 8, y
    jmp  loop

; the file names the library reads (it runs under map 07, so they must be
; below x6000, not in the overlay)
l_kbd_getc:
    ld   LF_HI >> 8, y          ; lib_far: kbd_getc under the library's map
    ld   LF_HI & 0xFF, x
    ld   kbd_getc >> 8, [y,x]
    ld   LF_LO & 0xFF, x
    ld   kbd_getc & 0xFF, [y,x]
    ld   LIB_FAR >> 8, y
    jmp  LIB_FAR

l_fs_mount:
    ld   LF_HI >> 8, y          ; lib_far: fs_mount under the library's map
    ld   LF_HI & 0xFF, x
    ld   fs_mount >> 8, [y,x]
    ld   LF_LO & 0xFF, x
    ld   fs_mount & 0xFF, [y,x]
    ld   LIB_FAR >> 8, y
    jmp  LIB_FAR

l_fs_open:
    ld   LF_HI >> 8, y          ; lib_far: fs_open under the library's map
    ld   LF_HI & 0xFF, x
    ld   fs_open >> 8, [y,x]
    ld   LF_LO & 0xFF, x
    ld   fs_open & 0xFF, [y,x]
    ld   LIB_FAR >> 8, y
    jmp  LIB_FAR

l_fs_read:
    ld   LF_HI >> 8, y          ; lib_far: fs_read under the library's map
    ld   LF_HI & 0xFF, x
    ld   fs_read >> 8, [y,x]
    ld   LF_LO & 0xFF, x
    ld   fs_read & 0xFF, [y,x]
    ld   LIB_FAR >> 8, y
    jmp  LIB_FAR

l_fs_create:
    ld   LF_HI >> 8, y          ; lib_far: fs_create under the library's map
    ld   LF_HI & 0xFF, x
    ld   fs_create >> 8, [y,x]
    ld   LF_LO & 0xFF, x
    ld   fs_create & 0xFF, [y,x]
    ld   LIB_FAR >> 8, y
    jmp  LIB_FAR

l_fs_write:
    ld   LF_HI >> 8, y          ; lib_far: fs_write under the library's map
    ld   LF_HI & 0xFF, x
    ld   fs_write >> 8, [y,x]
    ld   LF_LO & 0xFF, x
    ld   fs_write & 0xFF, [y,x]
    ld   LIB_FAR >> 8, y
    jmp  LIB_FAR

l_fs_close:
    ld   LF_HI >> 8, y          ; lib_far: fs_close under the library's map
    ld   LF_HI & 0xFF, x
    ld   fs_close >> 8, [y,x]
    ld   LF_LO & 0xFF, x
    ld   fs_close & 0xFF, [y,x]
    ld   LIB_FAR >> 8, y
    jmp  LIB_FAR

l_vid_mode:
    ld   LF_HI >> 8, y          ; lib_far: vid_mode under the library's map
    ld   LF_HI & 0xFF, x
    ld   vid_mode >> 8, [y,x]
    ld   LF_LO & 0xFF, x
    ld   vid_mode & 0xFF, [y,x]
    ld   LIB_FAR >> 8, y
    jmp  LIB_FAR

l_vid_clear:
    ld   LF_HI >> 8, y          ; lib_far: vid_clear under the library's map
    ld   LF_HI & 0xFF, x
    ld   vid_clear >> 8, [y,x]
    ld   LF_LO & 0xFF, x
    ld   vid_clear & 0xFF, [y,x]
    ld   LIB_FAR >> 8, y
    jmp  LIB_FAR

tat:
    ld   [R2], ac
    ld   ac, [CUR_ROW]
    ld   [R3], ac
    ld   ac, [CUR_COL]
    ld   [LINK_HI], y
    jmp  [LINK_LO]

; tclr - AC spaces from the cursor; cursor back where it was
slot_addr:
    ld   ac, [u0]
    ld   PTAB_PG, y
    add  PTAB_HI, x
    ld   [y,x], ac
    ld   ac, [u1]
    ld   [u0], ac
    add  PTAB_LO, x
    ld   [y,x], ac
    ld   ac, [u2]
    ld   [LINK_HI], y
    jmp  [LINK_LO]

; pat_of - AC = voice: AC = its pattern at e_op, FF when the orderlist
; is shorter

#addr 0x0300
ovl_load:
    ld   ac, [SAVE_AC]          ; PUSH_LINK
    ld   [SP], x
    ld   [LINK_HI], ac
    ld   ac, [x]
    ld   [SP], ac
    dec
    ld   ac, x
    dec
    ld   ac, [SP]
    ld   [LINK_LO], ac
    ld   ac, [x]
    ld   [SAVE_AC], ac
    ld   s_ovl & 0xFF, ac
    ld   ac, [R0]
    ld   s_ovl >> 8, ac
    ld   ac, [R1]
    ld   LINK_LO, x             ; CALL l_fs_open
    ld   tr_r16, [x]
    ld   LINK_HI, x
    ld   tr_r16 >> 8, [x]
    ld   l_fs_open >> 8, y
    jmp  l_fs_open
tr_r16:
    bne  ov_e
    ld   OVL_PAGE, ac
    ld   ac, [u5]
ov_s:
    ld   FBUF & 0xFF, ac
    ld   ac, [R4]
    ld   FBUF >> 8, ac
    ld   ac, [R5]
    ld   LINK_LO, x             ; CALL l_fs_read
    ld   tr_r17, [x]
    ld   LINK_HI, x
    ld   tr_r17 >> 8, [x]
    ld   l_fs_read >> 8, y
    jmp  l_fs_read
tr_r17:
    bne  ov_e
    ld   FBUF >> 8, ac
    ld   ac, [u6]
    ld   2, ac
    ld   ac, [u7]
ov_p:
    clr  ac
    ld   ac, [u4]
ov_b:
    ld   [u6], y
    ld   [u4], x
    ld   [y,x], ac
    ld   [u5], y
    ld   ac, [y,x]
    ld   [u4], ac
    inc
    ld   ac, [u4]
    bne  ov_b
    ld   [u6], ac
    inc
    ld   ac, [u6]
    ld   [u5], ac
    add  2, ac
    ld   ac, [u5]
    beq  ov_e
    ld   [u7], ac
    dec
    ld   ac, [u7]
    bne  ov_p
    bra  ov_s
ov_e:
    ld   tr_leave >> 8, y
    jmp  tr_leave

; ------------------------------------------------------------
; set_slots - the slot table: slot n is the even video page x60 + 2n
; (n < CAP_VID), then the RAM pages in ramsl; low byte 0.  Then the
; song's offsets
; ------------------------------------------------------------
set_slots:
    clr  ac
    ld   ac, [u0]
sls_l:
    ld   [u0], ac
    sub  CAP_VID, ac
    bcc  sls_r
    ld   [u0], ac
    shl
    add  0x60, ac
    bra  sls_p
sls_r:
    add  ramsl & 0xFF, x
    ld   ramsl >> 8, y
    ld   [y,x], ac
sls_p:
    ld   ac, [u1]
    ld   PTAB_PG, y
    ld   [u0], ac
    add  PTAB_HI, x
    ld   [u1], ac
    ld   ac, [y,x]
    ld   [u0], ac
    add  PTAB_LO, x
    ld   SLOT_LO, [y,x]
    ld   [u0], ac
    inc
    ld   ac, [u0]
    xor  CAP, ac
    bne  sls_l
    ld   set_offsets >> 8, y
    jmp  set_offsets

; the song's page 0: pattern n's offset = slot n - SONG (the empty pattern
; at SONG + 7 for n past the capacity); the orderlist offsets x500 + 64v;
; one subtune; byte 7 = FF (the empty pattern)
tmark:
    ld   ac, [p_k]
tm_l:
    ld   [CUR_COL], ac
    sub  80, ac
    bcc  tm_off
    ld   [CUR_COL], ac
    shl
    add  0x61, ac
    ld   ac, [p_pg]
    ld   2, ac
    ld   ac, [p_st]
    ld   [CUR_ROW], ac
    sub  14, ac
    blt  ta_2a6
    shl                         ; rows 14-29: 16 (r - 14) + 1
    shl
    shl
    shl
    inc
    ld   ac, [p_off]
    bra  ta_go6
ta_2a6:
    add  16, ac                 ; rows 0-13: 16 r + 32
    shl
    shl
    shl
    shl
    ld   ac, [p_off]
ta_go6:
    ld   [p_st], ac             ; + 7 x stride
    shl
    shl
    shl
    sub  [p_st], ac
    add  [p_off], ac
    ld   ac, x
    ld   [p_pg], y
    ld   0xFF, [y,x]
    ld   [CUR_COL], ac
    inc
    ld   ac, [CUR_COL]
    ld   [p_k], ac
    dec
    ld   ac, [p_k]
    bne  tm_l
tm_off:
    ld   [LINK_HI], y
    jmp  [LINK_LO]

; tputs - the string at R1:R0 (ending in 00)

#addr 0x0400
set_offsets:
    clr  ac
    ld   ac, [u0]
so_l:
    ld   [u0], ac
    sub  CAP, ac
    bcc  so_e
    ld   PTAB_PG, y
    ld   [u0], ac
    add  PTAB_HI, x
    ld   [y,x], ac
    sub  SONG >> 8, ac
    ld   ac, [u1]
    ld   [u0], ac
    add  PTAB_LO, x
    ld   [y,x], ac
    ld   ac, [u2]
    bra  so_w
so_e:
    clr  ac
    ld   ac, [u1]
    ld   EMPTY_LO, ac
    ld   ac, [u2]
so_w:
    ld   SONG >> 8, y
    ld   [u0], ac
    add  0x80, x
    ld   [u2], ac
    ld   ac, [y,x]
    ld   [u0], ac
    add  0xC0, x
    ld   [u1], ac
    ld   ac, [y,x]
    ld   [u0], ac
    inc
    ld   ac, [u0]
    xor  64, ac
    bne  so_l
    ld   SONG >> 8, y
    ld   0x04, x
    ld   1, [y,x]
    ld   0x07, x
    ld   0xFF, [y,x]
    ld   0x41, x
    ld   0x00, [y,x]
    ld   0x42, x
    ld   OLH, [y,x]
    ld   0x43, x
    ld   0x40, [y,x]
    ld   0x44, x
    ld   OLH, [y,x]
    ld   0x45, x
    ld   0x80, [y,x]
    ld   0x46, x
    ld   OLH, [y,x]
    ld   0x47, x
    ld   0xC0, [y,x]
    ld   0x48, x
    ld   OLH, [y,x]
    ld   [LINK_HI], y
    jmp  [LINK_LO]

; ============================================================
; text output.  con_putc only knows the 1x screen, so the editor writes
; its own characters: tputc draws the glyph of AC at CUR_ROW, CUR_COL in
; the 1x or 2x layout (docs/video/VIDEO.md, "Line repeat") and moves on.
; ============================================================

; the address of the glyph's first byte: p_pg:p_off, p_st = the stride

tputc:
    ld   ac, [p_ch]
    ld   [CUR_COL], ac
    sub  80, ac
    bcc  tp_off                 ; past the right edge: nothing
    ld   [CUR_COL], ac
    shl
    add  0x61, ac
    ld   ac, [p_pg]
    ld   2, ac
    ld   ac, [p_st]
    ld   [CUR_ROW], ac
    sub  14, ac
    blt  ta_2a3
    shl                         ; rows 14-29: 16 (r - 14) + 1
    shl
    shl
    shl
    inc
    ld   ac, [p_off]
    bra  ta_go3
ta_2a3:
    add  16, ac                 ; rows 0-13: 16 r + 32
    shl
    shl
    shl
    shl
    ld   ac, [p_off]
ta_go3:
    ld   0x50, y
    clr  x
    ld   0x07, [y,x]
    clr  ac
    ld   ac, [p_k]
tp_l:
    ld   [p_k], ac
    add  [FONT_PG], y
    ld   [p_ch], x
    ld   [y,x], ac
    ld   [p_pg], y
    ld   [p_off], x
    ld   ac, [y,x]
    ld   [p_off], ac
    add  [p_st], ac
    ld   ac, [p_off]
    ld   [p_k], ac
    inc
    ld   ac, [p_k]
    xor  8, ac
    bne  tp_l
    ld   [CUR_COL], ac
    inc
    ld   ac, [CUR_COL]
    ld   0x50, y
    clr  x
    ld   0xFF, [y,x]
tp_off:
    ld   [p_ch], ac             ; AC kept (callers print a character twice)
    ld   [LINK_HI], y
    jmp  [LINK_LO]

; tmark - underline AC characters from the cursor (the glyph's last line)
tspc:
    ld   ac, [SAVE_AC]          ; PUSH_LINK
    ld   [SP], x
    ld   [LINK_HI], ac
    ld   ac, [x]
    ld   [SP], ac
    dec
    ld   ac, x
    dec
    ld   ac, [SP]
    ld   [LINK_LO], ac
    ld   ac, [x]
    ld   [SAVE_AC], ac
    ld   ac, [u7]
    beq  tsp_e
tsp_l:
    ld   0x20, ac
    ld   LINK_LO, x             ; CALL tputc
    ld   tr_r19, [x]
    ld   LINK_HI, x
    ld   tr_r19 >> 8, [x]
    ld   tputc >> 8, y
    jmp  tputc
tr_r19:
    ld   [u7], ac
    dec
    ld   ac, [u7]
    bne  tsp_l
tsp_e:
    ld   tr_leave >> 8, y
    jmp  tr_leave

; thex1 - the low nibble of AC as a hex digit

#addr 0x0500
tputs:
    ld   ac, [SAVE_AC]          ; PUSH_LINK
    ld   [SP], x
    ld   [LINK_HI], ac
    ld   ac, [x]
    ld   [SP], ac
    dec
    ld   ac, x
    dec
    ld   ac, [SP]
    ld   [LINK_LO], ac
    ld   ac, [x]
    ld   [SAVE_AC], ac
ts_l:
    ld   [R1], y
    ld   [R0], x
    ld   [y,x], ac
    beq  ts_e
    ld   LINK_LO, x             ; CALL tputc
    ld   tr_r18, [x]
    ld   LINK_HI, x
    ld   tr_r18 >> 8, [x]
    ld   tputc >> 8, y
    jmp  tputc
tr_r18:
    ld   [R0], ac
    inc
    ld   ac, [R0]
    bne  ts_l
    ld   [R1], ac
    inc
    ld   ac, [R1]
    bra  ts_l
ts_e:
    ld   tr_leave >> 8, y
    jmp  tr_leave

; tspc - AC spaces
thex1:
    ld   ac, [SAVE_AC]          ; PUSH_LINK
    ld   [SP], x
    ld   [LINK_HI], ac
    ld   ac, [x]
    ld   [SP], ac
    dec
    ld   ac, x
    dec
    ld   ac, [SP]
    ld   [LINK_LO], ac
    ld   ac, [x]
    ld   [SAVE_AC], ac
    and  15, ac
    add  hexdig & 0xFF, x
    ld   hexdig >> 8, y
    ld   [y,x], ac
    ld   LINK_LO, x             ; CALL tputc
    ld   tr_r20, [x]
    ld   LINK_HI, x
    ld   tr_r20 >> 8, [x]
    ld   tputc >> 8, y
    jmp  tputc
tr_r20:
    ld   tr_leave >> 8, y
    jmp  tr_leave

; thex2 - AC as two hex digits
thex2:
    ld   ac, [SAVE_AC]          ; PUSH_LINK
    ld   [SP], x
    ld   [LINK_HI], ac
    ld   ac, [x]
    ld   [SP], ac
    dec
    ld   ac, x
    dec
    ld   ac, [SP]
    ld   [LINK_LO], ac
    ld   ac, [x]
    ld   [SAVE_AC], ac
    ld   ac, [u6]
    shr  ac
    shr  ac
    shr  ac
    shr  ac
    ld   LINK_LO, x             ; CALL thex1
    ld   tr_r21, [x]
    ld   LINK_HI, x
    ld   tr_r21 >> 8, [x]
    ld   thex1 >> 8, y
    jmp  thex1
tr_r21:
    ld   [u6], ac
    ld   LINK_LO, x             ; CALL thex1
    ld   tr_r22, [x]
    ld   LINK_HI, x
    ld   tr_r22 >> 8, [x]
    ld   thex1 >> 8, y
    jmp  thex1
tr_r22:
    ld   tr_leave >> 8, y
    jmp  tr_leave

; tdec2 - AC (0-99) as two decimal digits
tdec2:
    ld   ac, [SAVE_AC]          ; PUSH_LINK
    ld   [SP], x
    ld   [LINK_HI], ac
    ld   ac, [x]
    ld   [SP], ac
    dec
    ld   ac, x
    dec
    ld   ac, [SP]
    ld   [LINK_LO], ac
    ld   ac, [x]
    ld   [SAVE_AC], ac
    ld   ac, [u6]
    clr  ac
    ld   ac, [u5]
td_l:
    ld   [u6], ac
    sub  10, ac
    bcs  td_d
    ld   ac, [u6]
    ld   [u5], ac
    inc
    ld   ac, [u5]
    bra  td_l
td_d:
    ld   [u5], ac
    ld   LINK_LO, x             ; CALL thex1
    ld   tr_r23, [x]
    ld   LINK_HI, x
    ld   tr_r23 >> 8, [x]
    ld   thex1 >> 8, y
    jmp  thex1
tr_r23:
    ld   [u6], ac
    ld   LINK_LO, x             ; CALL thex1
    ld   tr_r24, [x]
    ld   LINK_HI, x
    ld   tr_r24 >> 8, [x]
    ld   thex1 >> 8, y
    jmp  thex1
tr_r24:
    ld   tr_leave >> 8, y
    jmp  tr_leave

; tsigned - AC as a signed byte: +nn / -nn (decimal)
need:
    xor  [p_pat], ac
    beq  nd_ok
    xor  [p_pat], ac
    ld   decode_pat >> 8, y
    jmp  decode_pat
nd_ok:
    ld   [LINK_HI], y
    jmp  [LINK_LO]

; ------------------------------------------------------------
; encode_pat - SCRATCH (p_len rows) -> ENCBUF, then pattern p_pat's slot
; (the rest of the slot FF).  AC = 0 done, 1 too long for the slot (the
; slot is left as it was)
; ------------------------------------------------------------

en_fail:
    ld   1, ac
    ld   [LINK_HI], y
    jmp  [LINK_LO]

; ENCBUF (u1 bytes, 256 when u1 = 0) -> the slot, FF to its end

#addr 0x0600
tsigned:
    ld   ac, [SAVE_AC]          ; PUSH_LINK
    ld   [SP], x
    ld   [LINK_HI], ac
    ld   ac, [x]
    ld   [SP], ac
    dec
    ld   ac, x
    dec
    ld   ac, [SP]
    ld   [LINK_LO], ac
    ld   ac, [x]
    ld   [SAVE_AC], ac
    ld   ac, [u4]
    blt  tsg_n
    ld   0x2B, ac
    ld   LINK_LO, x             ; CALL tputc
    ld   tr_r25, [x]
    ld   LINK_HI, x
    ld   tr_r25 >> 8, [x]
    ld   tputc >> 8, y
    jmp  tputc
tr_r25:
    ld   [u4], ac
    bra  tsg_d
tsg_n:
    ld   0x2D, ac
    ld   LINK_LO, x             ; CALL tputc
    ld   tr_r26, [x]
    ld   LINK_HI, x
    ld   tr_r26 >> 8, [x]
    ld   tputc >> 8, y
    jmp  tputc
tr_r26:
    clr  ac
    sub  [u4], ac
tsg_d:
    ld   LINK_LO, x             ; CALL tdec2
    ld   tr_r27, [x]
    ld   LINK_HI, x
    ld   tr_r27 >> 8, [x]
    ld   tdec2 >> 8, y
    jmp  tdec2
tr_r27:
    ld   tr_leave >> 8, y
    jmp  tr_leave

; tnote - AC = a pattern note: C-4, === (key off), ... (none)
tnote:
    ld   ac, [SAVE_AC]          ; PUSH_LINK
    ld   [SP], x
    ld   [LINK_HI], ac
    ld   ac, [x]
    ld   [SP], ac
    dec
    ld   ac, x
    dec
    ld   ac, [SP]
    ld   [LINK_LO], ac
    ld   ac, [x]
    ld   [SAVE_AC], ac
    ld   ac, [u4]
    sub  0x60, ac
    bcs  tn_n
    beq  tn_off
    ld   s_dots & 0xFF, ac
    ld   ac, [R0]
    ld   s_dots >> 8, ac
    ld   ac, [R1]
    ld   LINK_LO, x             ; CALL tputs
    ld   tr_r28, [x]
    ld   LINK_HI, x
    ld   tr_r28 >> 8, [x]
    ld   tputs >> 8, y
    jmp  tputs
tr_r28:
    ld   tr_leave >> 8, y
    jmp  tr_leave
tn_off:
    ld   s_koff & 0xFF, ac
    ld   ac, [R0]
    ld   s_koff >> 8, ac
    ld   ac, [R1]
    ld   LINK_LO, x             ; CALL tputs
    ld   tr_r29, [x]
    ld   LINK_HI, x
    ld   tr_r29 >> 8, [x]
    ld   tputs >> 8, y
    jmp  tputs
tr_r29:
    ld   tr_leave >> 8, y
    jmp  tr_leave
tn_n:
    ld   tnote_name >> 8, y
    jmp  tnote_name

tnote_name:
    clr  ac                     ; octave = note / 12
    ld   ac, [u5]
tnn_o:
    ld   [u4], ac
    sub  12, ac
    bcs  tnn_d
    ld   ac, [u4]
    ld   [u5], ac
    inc
    ld   ac, [u5]
    bra  tnn_o
tnn_d:
    ld   [u4], ac
    add  [u4], ac
    add  notes & 0xFF, x
    ld   notes >> 8, y
    ld   [y,x], ac
    ld   LINK_LO, x             ; CALL tputc
    ld   tr_r30, [x]
    ld   LINK_HI, x
    ld   tr_r30 >> 8, [x]
    ld   tputc >> 8, y
    jmp  tputc
tr_r30:
    ld   [u4], ac
    add  [u4], ac
    add  (notes + 1) & 0xFF, x
    ld   notes >> 8, y
    ld   [y,x], ac
    ld   LINK_LO, x             ; CALL tputc
    ld   tr_r31, [x]
    ld   LINK_HI, x
    ld   tr_r31 >> 8, [x]
    ld   tputc >> 8, y
    jmp  tputc
tr_r31:
    ld   [u5], ac
    add  0x30, ac
    ld   LINK_LO, x             ; CALL tputc
    ld   tr_r32, [x]
    ld   LINK_HI, x
    ld   tr_r32 >> 8, [x]
    ld   tputc >> 8, y
    jmp  tputc
tr_r32:
    ld   tr_leave >> 8, y
    jmp  tr_leave

; tat - cursor to R2 = row, R3 = column
ins_changed:
    ld   1, ac
    ld   ac, [e_mod]
    ld   [e_dirty], ac
    or   0x04, ac
    ld   ac, [e_dirty]
    ld   [LINK_HI], y
    jmp  [LINK_LO]

; ------------------------------------------------------------
; key_tab - the wave and pulse table panes
; ------------------------------------------------------------

#addr 0x0700
tclr:
    ld   ac, [SAVE_AC]          ; PUSH_LINK
    ld   [SP], x
    ld   [LINK_HI], ac
    ld   ac, [x]
    ld   [SP], ac
    dec
    ld   ac, x
    dec
    ld   ac, [SP]
    ld   [LINK_LO], ac
    ld   ac, [x]
    ld   [SAVE_AC], ac
    ld   ac, [u3]
    ld   [CUR_COL], ac
    ld   ac, [u2]
    ld   [u3], ac
    ld   LINK_LO, x             ; CALL tspc
    ld   tr_r33, [x]
    ld   LINK_HI, x
    ld   tr_r33 >> 8, [x]
    ld   tspc >> 8, y
    jmp  tspc
tr_r33:
    ld   [u2], ac
    ld   ac, [CUR_COL]
    ld   tr_leave >> 8, y
    jmp  tr_leave

; ------------------------------------------------------------
; tint_row - AC = text row, R0 = tint bits: the row's 16 mode bytes
; (with the 2x line repeat bit)
; ------------------------------------------------------------
tint_row:
    ld   ac, [u0]
    ld   [u0], ac               ; 2x: lines 16r .. 16r+15
    shl
    shl
    shl
    shl
    add  0x20, ac
    ld   ac, [u1]
    ld   0x5A, ac
    ld   ac, [u2]
    ld   [u0], ac
    sub  14, ac
    blt  tr_2a
    ld   0x5B, ac
    ld   ac, [u2]
tr_2a:
    ld   16, ac
    ld   ac, [u3]
    ld   [R0], ac
    or   0x04, ac
tr_go:
    ld   ac, [u4]
    ld   [u2], y
tr_l:
    ld   [u1], x
    ld   [u4], ac
    ld   ac, [y,x]
    ld   [u1], ac
    inc
    ld   ac, [u1]
    ld   [u3], ac
    dec
    ld   ac, [u3]
    bne  tr_l
    ld   [LINK_HI], y
    jmp  [LINK_LO]

; ------------------------------------------------------------
; clear_screen - the pixels in the odd pages (the text; the even pages
; hold patterns and code), the mode bytes: 2x, no tint
; ------------------------------------------------------------
clear_screen:
    ld   ac, [SAVE_AC]          ; PUSH_LINK
    ld   [SP], x
    ld   [LINK_HI], ac
    ld   ac, [x]
    ld   [SP], ac
    dec
    ld   ac, x
    dec
    ld   ac, [SP]
    ld   [LINK_LO], ac
    ld   ac, [x]
    ld   [SAVE_AC], ac
    ld   0x61, ac
    ld   ac, [u0]
csc_p:
    ld   [u0], y
    clr  ac
csc_b:
    ld   ac, x
    ld   0x00, [y,x]
    inc
    bne  csc_b
    ld   [u0], ac
    add  2, ac
    ld   ac, [u0]
    xor  0x01, ac
    bne  csc_p
    ld   0x04, ac
    ld   LINK_LO, x             ; CALL l_vid_mode
    ld   tr_r34, [x]
    ld   LINK_HI, x
    ld   tr_r34 >> 8, [x]
    ld   l_vid_mode >> 8, y
    jmp  l_vid_mode
tr_r34:
    ld   tr_leave >> 8, y
    jmp  tr_leave

; ------------------------------------------------------------
; status - the string at R1:R0 on the status row, the rest cleared
; ------------------------------------------------------------
status:
    ld   ac, [SAVE_AC]          ; PUSH_LINK
    ld   [SP], x
    ld   [LINK_HI], ac
    ld   ac, [x]
    ld   [SP], ac
    dec
    ld   ac, x
    dec
    ld   ac, [SP]
    ld   [LINK_LO], ac
    ld   ac, [x]
    ld   [SAVE_AC], ac
    ld   ROWS - 2, ac
    ld   ac, [CUR_ROW]
    ld   1, ac
    ld   ac, [CUR_COL]
    ld   LINK_LO, x             ; CALL tputs
    ld   tr_r35, [x]
    ld   LINK_HI, x
    ld   tr_r35 >> 8, [x]
    ld   tputs >> 8, y
    jmp  tputs
tr_r35:
    ld   [CUR_COL], ac
    ld   ac, [s_col]
    ld   80, ac
    sub  [CUR_COL], ac
    ld   LINK_LO, x             ; CALL tspc
    ld   tr_r36, [x]
    ld   LINK_HI, x
    ld   tr_r36 >> 8, [x]
    ld   tspc >> 8, y
    jmp  tspc
tr_r36:
    ld   tr_leave >> 8, y
    jmp  tr_leave

mt_voice:
    ld   [M_VIDX], ac
    xor  4, ac
    bne  mv_in
    ld   [M_SFXN], ac
    bne  mv_in
    ld   mt_end >> 8, y
    jmp  mt_end
mv_in:
    ld   copy_in >> 8, y
    jmp  copy_in

status_clear:
    ld   ac, [SAVE_AC]          ; PUSH_LINK
    ld   [SP], x
    ld   [LINK_HI], ac
    ld   ac, [x]
    ld   [SP], ac
    dec
    ld   ac, x
    dec
    ld   ac, [SP]
    ld   [LINK_LO], ac
    ld   ac, [x]
    ld   [SAVE_AC], ac
    ld   s_empty & 0xFF, ac
    ld   ac, [R0]
    ld   s_empty >> 8, ac
    ld   ac, [R1]
    ld   LINK_LO, x             ; CALL status
    ld   tr_r37, [x]
    ld   LINK_HI, x
    ld   tr_r37 >> 8, [x]
    ld   status >> 8, y
    jmp  status
tr_r37:
    ld   tr_leave >> 8, y
    jmp  tr_leave

; ============================================================
; the song: patterns in their slots, the decoded pattern, the orderlists
; ============================================================

; SLOTADDR - AC = pattern: u1 = page, u2 = low byte of its slot

; slot_addr - the same as a routine (for callers that keep their link)
pat_of:
    add  VSPAGE, y
    ld   OD_LEN, x
    ld   [e_op], ac
    sub  [y,x], ac
    bcc  po_n
    ld   [e_op], ac
    shl
    add  OD_PAT, x
    ld   [y,x], ac
    ld   [LINK_HI], y
    jmp  [LINK_LO]
po_n:
    ld   0xFF, ac
    ld   [LINK_HI], y
    jmp  [LINK_LO]

; ------------------------------------------------------------
; decode_pat - AC = pattern: SCRATCH = its rows (p_len of them, the rest
; empty), p_pat = AC.  A blank slot (FF first) is 64 empty rows.
; ------------------------------------------------------------
decode_pat:
    ld   ac, [p_pat]
    ld   SCRATCH >> 8, y
    clr  ac
    ld   ac, [u0]
dp_c:
    ld   [u0], ac
    ld   ac, x
    ld   0x61, [y,x]
    inc
    ld   ac, x
    ld   0xFF, [y,x]
    inc
    ld   ac, x
    ld   0xFF, [y,x]
    inc
    ld   ac, x
    ld   0x00, [y,x]
    inc
    ld   ac, [u0]
    bne  dp_c
    ld   ac, [p_len]
    ld   [p_pat], ac
    sub  CAP, ac
    bcc  dp_none                ; none, or past the capacity
    ld   [p_pat], ac
    ld   ac, [u0]
    ld   PTAB_PG, y
    add  PTAB_HI, x
    ld   [y,x], ac
    ld   ac, [u1]
    ld   [u0], ac
    add  PTAB_LO, x
    ld   [y,x], ac
    ld   ac, [u2]
    ld   [u1], y
    ld   [u2], x
    ld   [y,x], ac
    xor  0xFF, ac
    bne  dp_go
    ld   64, ac                 ; blank: 64 empty rows
    ld   ac, [p_len]
dp_none:
    ld   [LINK_HI], y
    jmp  [LINK_LO]
dp_go:
    ld   dp_parse >> 8, y
    jmp  dp_parse

encode_pat:
    clr  ac
    ld   ac, [u0]               ; row
    ld   ac, [u1]               ; bytes out
    ld   ac, [u5]               ; full
    ld   0xFF, ac
    ld   ac, [u2]               ; the instrument emitted last
en_l:
    ld   [u0], ac
    xor  [p_len], ac
    beq  en_end
    ld   [u0], ac
    shl
    shl
    ld   ac, [u3]
    ld   ac, x
    ld   SCRATCH >> 8, y
    ld   [y,x], ac
    ld   ac, [u4]               ; note
    xor  0x61, ac
    bne  en_row
    ld   [u3], ac
    inc
    ld   ac, x
    ld   [y,x], ac
    xor  0xFF, ac
    bne  en_row
    ld   [u3], ac
    add  2, ac
    ld   ac, x
    ld   [y,x], ac
    xor  0xFF, ac
    bne  en_row
    ld   en_run >> 8, y
    jmp  en_run
en_row:
    ld   en_note >> 8, y
    jmp  en_note
en_end:
    ld   0xFF, ac
    ld   ac, [u7]
    ld   [u5], ac               ; EMIT: the byte in u7 -> ENCBUF
    bne  en_full9
    ld   ENCBUF >> 8, y
    ld   [u1], x
    ld   [u7], ac
    ld   ac, [y,x]
    ld   [u1], ac
    inc
    ld   ac, [u1]
    xor  SLOT_LO, ac
    bne  en_ok9
    ld   1, ac
    ld   ac, [u5]
en_ok9:
    bra  en_done9
en_full9:
    ld   en_fail >> 8, y
    jmp  en_fail
en_done9:
    ld   en_copy >> 8, y
    jmp  en_copy

; a run of empty rows from row u0: count them (64 at most), one byte

#addr 0x0900
dp_parse:
    clr  ac
    ld   ac, [u4]               ; rows so far
    ld   0xFF, ac
    ld   ac, [u5]               ; pending instrument
    ld   ac, [u6]               ; pending effect
    clr  ac
    ld   ac, [u7]
dpp_l:
    ld   [u4], ac
    xor  64, ac
    beq  dpp_end
    ld   [u1], y
    ld   [u2], x
    ld   [y,x], ac
    ld   ac, [u3]
    ld   [u2], ac
    inc
    ld   ac, [u2]
    ld   [u3], ac
    xor  0xFF, ac
    beq  dpp_end
    ld   [u3], ac
    sub  0xE0, ac
    bcc  dpp_fx
    ld   [u3], ac
    sub  0xC0, ac
    bcc  dpp_ins
    ld   [u3], ac
    sub  0x80, ac
    bcc  dpp_empty
    ld   [u4], ac               ; a note: row u4 = note, pending ins, fx, par
    shl
    shl
    ld   ac, [u0]
    ld   ac, x
    ld   SCRATCH >> 8, y
    ld   [u3], ac
    ld   ac, [y,x]
    ld   [u0], ac
    add  1, x
    ld   [u5], ac
    ld   ac, [y,x]
    ld   [u0], ac
    add  2, x
    ld   [u6], ac
    ld   ac, [y,x]
    ld   [u0], ac
    add  3, x
    ld   [u7], ac
    ld   ac, [y,x]
    ld   0xFF, ac
    ld   ac, [u5]
    ld   ac, [u6]
    ld   [u4], ac
    inc
    ld   ac, [u4]
    bra  dpp_l
dpp_fx:
    and  0x0F, ac
    ld   ac, [u6]
    ld   [u1], y
    ld   [u2], x
    ld   [y,x], ac
    ld   ac, [u7]
    ld   [u2], ac
    inc
    ld   ac, [u2]
    bra  dpp_l
dpp_ins:
    and  0x1F, ac
    ld   ac, [u5]
    bra  dpp_l
dpp_empty:
    and  0x3F, ac               ; this row and that many more
    inc
    add  [u4], ac
    ld   ac, [u4]
    sub  65, ac
    bcs  dpp_e2
    ld   64, ac
    ld   ac, [u4]
dpp_e2:
    ld   0xFF, ac
    ld   ac, [u5]
    ld   ac, [u6]
    bra  dpp_l
dpp_end:
    ld   [u4], ac
    ld   ac, [p_len]
    ld   [LINK_HI], y
    jmp  [LINK_LO]

; ------------------------------------------------------------
; need - AC = pattern: decoded into SCRATCH unless it is there already
; ------------------------------------------------------------
en_copy:
    ld   [p_pat], ac
    ld   ac, [u0]
    ld   PTAB_PG, y
    add  PTAB_HI, x
    ld   [y,x], ac
    ld   ac, [u1]
    ld   [u0], ac
    add  PTAB_LO, x
    ld   [y,x], ac
    ld   ac, [u2]
    clr  ac
    ld   ac, [u3]
ec_l:
    ld   ENCBUF >> 8, y
    ld   [u3], x
    ld   [y,x], ac
    ld   ac, [u4]
    ld   [u1], y
    ld   [u3], ac
    add  [u2], ac
    ld   ac, x
    ld   [u4], ac
    ld   ac, [y,x]
    ld   [u3], ac
    inc
    ld   ac, [u3]
    xor  [u1], ac
    bne  ec_l
ec_p:
    ld   [u3], ac
    xor  SLOT_LO, ac
    beq  ec_e
    ld   [u1], y
    ld   [u3], ac
    add  [u2], ac
    ld   ac, x
    ld   0xFF, [y,x]
    ld   [u3], ac
    inc
    ld   ac, [u3]
    bra  ec_p
ec_e:
    ld   1, ac
    ld   ac, [e_mod]
    clr  ac
    ld   [LINK_HI], y
    jmp  [LINK_LO]

; ------------------------------------------------------------
; encode_ol - AC = voice: its decoded orderlist -> OLIST + 64 v, with
; the byte offset of each position in OD_OFF (every position gets its
; transpose byte, so a loop lands on the right transpose)
; ------------------------------------------------------------
rr_stop:
    ld   1, ac
    ld   ac, [W_STOP]
    ld   3, ac
    ld   ac, [W_EST]
    ld   vt >> 8, y
    jmp  vt

; ------------------------------------------------------------
; rr_note - the row's note byte (T7) with its instrument and effect
; ------------------------------------------------------------

#addr 0x0A00
en_run:
    clr  ac
    ld   ac, [u6]               ; the count
er_l:
    ld   [u0], ac
    add  [u6], ac
    xor  [p_len], ac
    beq  er_d
    ld   [u0], ac
    add  [u6], ac
    shl
    shl
    ld   ac, [u3]
    ld   ac, x
    ld   SCRATCH >> 8, y
    ld   [y,x], ac
    xor  0x61, ac
    bne  er_d
    ld   [u3], ac
    inc
    ld   ac, x
    ld   [y,x], ac
    xor  0xFF, ac
    bne  er_d
    ld   [u3], ac
    add  2, ac
    ld   ac, x
    ld   [y,x], ac
    xor  0xFF, ac
    bne  er_d
    ld   [u6], ac
    inc
    ld   ac, [u6]
    xor  64, ac
    bne  er_l
er_d:
    ld   [u6], ac
    dec
    or   0x80, ac
    ld   ac, [u7]
    ld   [u5], ac               ; EMIT: the byte in u7 -> ENCBUF
    bne  en_full10
    ld   ENCBUF >> 8, y
    ld   [u1], x
    ld   [u7], ac
    ld   ac, [y,x]
    ld   [u1], ac
    inc
    ld   ac, [u1]
    xor  SLOT_LO, ac
    bne  en_ok10
    ld   1, ac
    ld   ac, [u5]
en_ok10:
    bra  en_done10
en_full10:
    ld   en_fail >> 8, y
    jmp  en_fail
en_done10:
    ld   [u0], ac
    add  [u6], ac
    ld   ac, [u0]
    ld   en_l >> 8, y
    jmp  en_l

; a row with something in it: [instrument] [effect, parameter] note
encode_ol:
    ld   ac, [u0]
    shl
    shl
    shl
    shl
    shl
    shl
    ld   ac, [u1]               ; 64 v: the list's first byte
    ld   ac, [u2]               ; the write pointer (low byte)
    clr  ac
    ld   ac, [u3]               ; position k
eo_l:
    ld   [u0], ac
    add  VSPAGE, y
    ld   OD_LEN, x
    ld   [u3], ac
    xor  [y,x], ac
    beq  eo_end
    ld   [u2], ac               ; OD_OFF + k = offset
    sub  [u1], ac
    ld   ac, [u4]
    ld   [u3], ac
    add  OD_OFF, x
    ld   [u4], ac
    ld   ac, [y,x]
    ld   [u3], ac
    shl
    add  OD_TR, x
    ld   [y,x], ac
    add  0xA0, ac
    ld   ac, [u5]
    ld   [u3], ac
    shl
    add  OD_PAT, x
    ld   [y,x], ac
    ld   ac, [u6]
    ld   OLIST >> 8, y
    ld   [u2], x
    ld   [u5], ac
    ld   ac, [y,x]
    ld   [u2], ac
    inc
    ld   ac, x
    ld   [u6], ac
    ld   ac, [y,x]
    ld   [u2], ac
    add  2, ac
    ld   ac, [u2]
    ld   [u3], ac
    inc
    ld   ac, [u3]
    bra  eo_l
eo_end:
    ld   [u2], ac               ; OD_OFF + len = the end's offset
    sub  [u1], ac
    ld   ac, [u4]
    ld   [u3], ac
    add  OD_OFF, x
    ld   [u4], ac
    ld   ac, [y,x]
    ld   OD_END, x
    ld   [y,x], ac
    xor  0xFF, ac
    bne  eo_stop
    ld   OD_TGT, x              ; FF, the target's offset
    ld   [y,x], ac
    add  OD_OFF, x
    ld   [y,x], ac
    ld   ac, [u5]
    ld   OLIST >> 8, y
    ld   [u2], x
    ld   0xFF, [y,x]
    ld   [u2], ac
    inc
    ld   ac, x
    ld   [u5], ac
    ld   ac, [y,x]
    ld   [LINK_HI], y
    jmp  [LINK_LO]
eo_stop:
    ld   OLIST >> 8, y
    ld   [u2], x
    ld   0xFE, [y,x]
    ld   [LINK_HI], y
    jmp  [LINK_LO]

; ------------------------------------------------------------
; decode_ol - AC = voice: OLIST + 64 v -> its decoded orderlist (at most
; OD_MAX positions; a loop lands on the position holding its byte)
; ------------------------------------------------------------

#addr 0x0B00
en_note:
    ld   [u3], ac
    inc
    ld   ac, x
    ld   SCRATCH >> 8, y
    ld   [y,x], ac
    ld   ac, [u6]               ; its instrument
    xor  0xFF, ac
    beq  en_fx
    ld   [u6], ac
    xor  [u2], ac
    beq  en_fx
    ld   [u6], ac
    ld   ac, [u2]
    or   0xC0, ac
    ld   ac, [u7]
    ld   [u5], ac               ; EMIT: the byte in u7 -> ENCBUF
    bne  en_full11
    ld   ENCBUF >> 8, y
    ld   [u1], x
    ld   [u7], ac
    ld   ac, [y,x]
    ld   [u1], ac
    inc
    ld   ac, [u1]
    xor  SLOT_LO, ac
    bne  en_ok11
    ld   1, ac
    ld   ac, [u5]
en_ok11:
    bra  en_done11
en_full11:
    ld   en_fail >> 8, y
    jmp  en_fail
en_done11:
en_fx:
    ld   [u3], ac
    add  2, ac
    ld   ac, x
    ld   SCRATCH >> 8, y
    ld   [y,x], ac
    xor  0xFF, ac
    beq  en_n
    ld   [y,x], ac
    or   0xE0, ac
    ld   ac, [u7]
    ld   [u5], ac               ; EMIT: the byte in u7 -> ENCBUF
    bne  en_full12
    ld   ENCBUF >> 8, y
    ld   [u1], x
    ld   [u7], ac
    ld   ac, [y,x]
    ld   [u1], ac
    inc
    ld   ac, [u1]
    xor  SLOT_LO, ac
    bne  en_ok12
    ld   1, ac
    ld   ac, [u5]
en_ok12:
    bra  en_done12
en_full12:
    ld   en_fail >> 8, y
    jmp  en_fail
en_done12:
    ld   [u3], ac
    add  3, ac
    ld   ac, x
    ld   SCRATCH >> 8, y
    ld   [y,x], ac
    ld   ac, [u7]
    ld   [u5], ac               ; EMIT: the byte in u7 -> ENCBUF
    bne  en_full13
    ld   ENCBUF >> 8, y
    ld   [u1], x
    ld   [u7], ac
    ld   ac, [y,x]
    ld   [u1], ac
    inc
    ld   ac, [u1]
    xor  SLOT_LO, ac
    bne  en_ok13
    ld   1, ac
    ld   ac, [u5]
en_ok13:
    bra  en_done13
en_full13:
    ld   en_fail >> 8, y
    jmp  en_fail
en_done13:
en_n:
    ld   [u3], ac
    ld   ac, x
    ld   SCRATCH >> 8, y
    ld   [y,x], ac
    ld   ac, [u7]
    ld   [u5], ac               ; EMIT: the byte in u7 -> ENCBUF
    bne  en_full14
    ld   ENCBUF >> 8, y
    ld   [u1], x
    ld   [u7], ac
    ld   ac, [y,x]
    ld   [u1], ac
    inc
    ld   ac, [u1]
    xor  SLOT_LO, ac
    bne  en_ok14
    ld   1, ac
    ld   ac, [u5]
en_ok14:
    bra  en_done14
en_full14:
    ld   en_fail >> 8, y
    jmp  en_fail
en_done14:
    ld   [u0], ac
    inc
    ld   ac, [u0]
    ld   en_l >> 8, y
    jmp  en_l

encode_all:
    ld   ac, [SAVE_AC]          ; PUSH_LINK
    ld   [SP], x
    ld   [LINK_HI], ac
    ld   ac, [x]
    ld   [SP], ac
    dec
    ld   ac, x
    dec
    ld   ac, [SP]
    ld   [LINK_LO], ac
    ld   ac, [x]
    ld   [SAVE_AC], ac
    clr  ac
    ld   ac, [w5]
ea_l:
    ld   [w5], ac
    ld   LINK_LO, x             ; CALL encode_ol
    ld   tr_r38, [x]
    ld   LINK_HI, x
    ld   tr_r38 >> 8, [x]
    ld   encode_ol >> 8, y
    jmp  encode_ol
tr_r38:
    ld   [w5], ac
    inc
    ld   ac, [w5]
    xor  4, ac
    bne  ea_l
    ld   tr_leave >> 8, y
    jmp  tr_leave


#addr 0x0C00
decode_ol:
    ld   ac, [u0]
    shl
    shl
    shl
    shl
    shl
    shl
    ld   ac, [u1]               ; the list's first byte
    ld   ac, [u2]               ; the read pointer
    clr  ac
    ld   ac, [u3]               ; position k
    ld   ac, [u4]               ; transpose
    ld   ac, [u6]               ; a transpose byte started the position
    ld   [u0], ac
    add  VSPAGE, y
    ld   OD_END, x
    ld   0xFE, [y,x]
    ld   OD_TGT, x
    ld   0x00, [y,x]
do_l:
    ld   OLIST >> 8, y
    ld   [u2], x
    ld   [y,x], ac
    ld   ac, [u5]
    xor  0xFE, ac
    beq  do_end
    ld   [u5], ac
    xor  0xFF, ac
    beq  do_loop
    ld   [u5], ac
    sub  0x80, ac
    bcs  do_pat
    ld   [u5], ac
    sub  0xC0, ac
    bcc  do_pat                 ; C0-FD: taken as a pattern byte (& 3F)
    ld   [u5], ac               ; a transpose
    sub  0xA0, ac
    ld   ac, [u4]
    ld   [u6], ac
    bne  do_t2
    ld   [u2], ac               ; the position starts here
    sub  [u1], ac
    ld   ac, [u7]
    ld   1, ac
    ld   ac, [u6]
do_t2:
    ld   [u2], ac
    inc
    ld   ac, [u2]
    bra  do_l
do_pat:
    ld   [u6], ac
    bne  do_p2
    ld   [u2], ac
    sub  [u1], ac
    ld   ac, [u7]
do_p2:
    ld   [u3], ac
    xor  OD_MAX, ac
    beq  do_end                 ; too many: the rest is dropped
    ld   [u0], ac
    add  VSPAGE, y
    ld   [u3], ac
    add  OD_OFF, x
    ld   [u7], ac
    ld   ac, [y,x]
    ld   [u3], ac
    shl
    add  OD_PAT, x
    ld   [u5], ac
    and  0x3F, ac
    ld   ac, [y,x]
    ld   [u3], ac
    shl
    add  OD_TR, x
    ld   [u4], ac
    ld   ac, [y,x]
    ld   [u3], ac
    inc
    ld   ac, [u3]
    clr  ac
    ld   ac, [u6]
    ld   [u2], ac
    inc
    ld   ac, [u2]
    bra  do_l
do_loop:
    ld   do_loop2 >> 8, y
    jmp  do_loop2
do_end:
    ld   [u0], ac
    add  VSPAGE, y
    ld   OD_LEN, x
    ld   [u3], ac
    ld   ac, [y,x]
    ld   [LINK_HI], y
    jmp  [LINK_LO]

; FF nn: the loop; OD_OFF + len = the FF's offset; target = the first
; position whose next position starts after nn
do_loop2:
    ld   [u0], ac
    add  VSPAGE, y
    ld   OD_END, x
    ld   0xFF, [y,x]
    ld   [u3], ac
    add  OD_OFF, x
    ld   [u2], ac
    sub  [u1], ac
    ld   ac, [y,x]
    ld   OLIST >> 8, y
    ld   [u2], ac
    inc
    ld   ac, x
    ld   [y,x], ac
    ld   ac, [u5]               ; nn
    ld   [u0], ac
    add  VSPAGE, y
    clr  ac
    ld   ac, [u7]               ; j
dl_l:
    ld   [u7], ac
    xor  [u3], ac
    beq  dl_0                   ; past the end: 0
    ld   [u7], ac
    add  OD_OFF + 1, x
    ld   [y,x], ac              ; start of j + 1
    sub  [u5], ac
    bcs  dl_n                   ; start(j+1) <= nn: not this one
    beq  dl_n
    ld   OD_TGT, x
    ld   [u7], ac
    ld   ac, [y,x]
    bra  dl_e
dl_n:
    ld   [u7], ac
    inc
    ld   ac, [u7]
    bra  dl_l
dl_0:
    ld   OD_TGT, x
    ld   0, [y,x]
dl_e:
    ld   OD_LEN, x
    ld   [u3], ac
    ld   ac, [y,x]
    ld   [LINK_HI], y
    jmp  [LINK_LO]

; ------------------------------------------------------------
; encode_all - the four orderlists
; ------------------------------------------------------------

#addr 0x0D00
decode_all:
    ld   ac, [SAVE_AC]          ; PUSH_LINK
    ld   [SP], x
    ld   [LINK_HI], ac
    ld   ac, [x]
    ld   [SP], ac
    dec
    ld   ac, x
    dec
    ld   ac, [SP]
    ld   [LINK_LO], ac
    ld   ac, [x]
    ld   [SAVE_AC], ac
    clr  ac
    ld   ac, [w5]
da_l:
    ld   [w5], ac
    ld   LINK_LO, x             ; CALL decode_ol
    ld   tr_r39, [x]
    ld   LINK_HI, x
    ld   tr_r39 >> 8, [x]
    ld   decode_ol >> 8, y
    jmp  decode_ol
tr_r39:
    ld   [w5], ac
    inc
    ld   ac, [w5]
    xor  4, ac
    bne  da_l
    ld   tr_leave >> 8, y
    jmp  tr_leave

; ------------------------------------------------------------
; slot_blank - AC = pattern: AC = 1 when its slot is blank (FF, or BF FF:
; 64 empty rows), else 0
; ------------------------------------------------------------
slot_blank:
    ld   ac, [u0]
    ld   PTAB_PG, y
    add  PTAB_HI, x
    ld   [y,x], ac
    ld   ac, [u1]
    ld   [u0], ac
    add  PTAB_LO, x
    ld   [y,x], ac
    ld   ac, [u2]
    ld   [u1], y
    ld   [u2], x
    ld   [y,x], ac
    xor  0xFF, ac
    beq  sb_y
    ld   [y,x], ac
    xor  0xBF, ac
    bne  sb_n
    ld   [u2], ac
    inc
    ld   ac, x
    ld   [y,x], ac
    xor  0xFF, ac
    bne  sb_n
sb_y:
    ld   1, ac
    ld   [LINK_HI], y
    jmp  [LINK_LO]
sb_n:
    clr  ac
    ld   [LINK_HI], y
    jmp  [LINK_LO]

; ------------------------------------------------------------
; slot_len - AC = pattern: AC = the bytes of its pattern up to and with
; the FF (the slot's size when there is no FF)
; ------------------------------------------------------------
slot_len:
    ld   ac, [u0]
    ld   PTAB_PG, y
    add  PTAB_HI, x
    ld   [y,x], ac
    ld   ac, [u1]
    ld   [u0], ac
    add  PTAB_LO, x
    ld   [y,x], ac
    ld   ac, [u2]
    clr  ac
    ld   ac, [u3]
sl_l:
    ld   [u1], y
    ld   [u3], ac
    add  [u2], ac
    ld   ac, x
    ld   [u3], ac
    inc
    ld   ac, [u3]
    ld   [y,x], ac
    xor  0xFF, ac
    beq  sl_e
    ld   [u3], ac
    xor  SLOT_LO, ac
    bne  sl_l
sl_e:
    ld   [u3], ac
    ld   [LINK_HI], y
    jmp  [LINK_LO]

; ------------------------------------------------------------
; slot_fix - AC = pattern: an FF at the slot's last byte when it has none
; ------------------------------------------------------------
slot_fix:
    ld   ac, [u0]
    ld   PTAB_PG, y
    add  PTAB_HI, x
    ld   [y,x], ac
    ld   ac, [u1]
    ld   [u0], ac
    add  PTAB_LO, x
    ld   [y,x], ac
    ld   ac, [u2]
    clr  ac
    ld   ac, [u3]
sf_l:
    ld   [u1], y
    ld   [u3], ac
    add  [u2], ac
    ld   ac, x
    ld   [y,x], ac
    xor  0xFF, ac
    beq  sf_e
    ld   [u3], ac
    inc
    ld   ac, [u3]
    xor  SLOT_LO, ac
    bne  sf_l
    ld   [u3], ac               ; none: the last byte
    dec
    add  [u2], ac
    ld   ac, x
    ld   0xFF, [y,x]
sf_e:
    ld   [LINK_HI], y
    jmp  [LINK_LO]

; ------------------------------------------------------------
; slot_clear - AC = pattern: its slot = FF (blank)
; ------------------------------------------------------------
slot_clear:
    ld   ac, [u0]
    ld   PTAB_PG, y
    add  PTAB_HI, x
    ld   [y,x], ac
    ld   ac, [u1]
    ld   [u0], ac
    add  PTAB_LO, x
    ld   [y,x], ac
    ld   ac, [u2]
    ld   [u1], y
    ld   [u2], x
    ld   0xFF, [y,x]
    ld   [LINK_HI], y
    jmp  [LINK_LO]

; ============================================================
; drawing
; ============================================================

; ------------------------------------------------------------
; draw_step - once a frame: the blocks marked in e_dirty; the pattern
; grid one voice column a frame (the player must run every frame)
; ------------------------------------------------------------
ord_end:
    ld   ac, [u0]
    ld   [o_v], ac
    add  VSPAGE, y
    ld   OD_END, x
    ld   [u0], ac
    ld   ac, [y,x]
    ld   OD_TGT, x
    ld   0, [y,x]
    ld   ord_changed >> 8, y
    jmp  ord_changed

; ord_insert - a position (pattern 00) at the cursor

#addr 0x0E00
draw_step:
    ld   ac, [SAVE_AC]          ; PUSH_LINK
    ld   [SP], x
    ld   [LINK_HI], ac
    ld   ac, [x]
    ld   [SP], ac
    dec
    ld   ac, x
    dec
    ld   ac, [SP]
    ld   [LINK_LO], ac
    ld   ac, [x]
    ld   [SAVE_AC], ac
    ld   [e_dirty], ac
    and  0x08, ac
    beq  ds_t
    ld   LINK_LO, x             ; CALL draw_header
    ld   tr_r40, [x]
    ld   LINK_HI, x
    ld   tr_r40 >> 8, [x]
    ld   draw_header >> 8, y
    jmp  draw_header
tr_r40:
    ld   [e_dirty], ac
    and  0xF7, ac
    ld   ac, [e_dirty]
ds_t:
    ld   [e_dirty], ac
    and  0x20, ac
    beq  ds_o
    ld   LINK_LO, x             ; CALL draw_ptitle
    ld   tr_r41, [x]
    ld   LINK_HI, x
    ld   tr_r41 >> 8, [x]
    ld   draw_ptitle >> 8, y
    jmp  draw_ptitle
tr_r41:
    ld   [e_dirty], ac
    and  0xDF, ac
    ld   ac, [e_dirty]
ds_o:
    ld   [e_dirty], ac
    and  0x02, ac
    beq  ds_i
    ld   LINK_LO, x             ; CALL draw_order
    ld   tr_r42, [x]
    ld   LINK_HI, x
    ld   tr_r42 >> 8, [x]
    ld   draw_order >> 8, y
    jmp  draw_order
tr_r42:
    ld   [e_dirty], ac
    and  0xFD, ac
    ld   ac, [e_dirty]
ds_i:
    ld   [e_dirty], ac
    and  0x04, ac
    beq  ds_g
    ld   LINK_LO, x             ; CALL draw_ins
    ld   tr_r43, [x]
    ld   LINK_HI, x
    ld   tr_r43 >> 8, [x]
    ld   draw_ins >> 8, y
    jmp  draw_ins
tr_r43:
    ld   [e_dirty], ac
    and  0xFB, ac
    ld   ac, [e_dirty]
ds_g:
    ld   draw_step2 >> 8, y
    jmp  draw_step2

draw_step2:
    ld   [e_pane], ac
    sub  3, ac
    bcc  ds_tab
    ld   [e_dirty], ac
    and  0x01, ac
    beq  ds_e
    ld   [e_drow], ac
    ld   LINK_LO, x             ; CALL draw_grid_col
    ld   tr_r44, [x]
    ld   LINK_HI, x
    ld   tr_r44 >> 8, [x]
    ld   draw_grid_col >> 8, y
    jmp  draw_grid_col
tr_r44:
    ld   [e_drow], ac
    inc
    ld   ac, [e_drow]
    xor  4, ac
    bne  ds_e
    ld   LINK_LO, x             ; CALL draw_rownums
    ld   tr_r45, [x]
    ld   LINK_HI, x
    ld   tr_r45 >> 8, [x]
    ld   draw_rownums >> 8, y
    jmp  draw_rownums
tr_r45:
    ld   LINK_LO, x             ; CALL grid_tints
    ld   tr_r46, [x]
    ld   LINK_HI, x
    ld   tr_r46 >> 8, [x]
    ld   grid_tints >> 8, y
    jmp  grid_tints
tr_r46:
    ld   LINK_LO, x             ; CALL cursor_show
    ld   tr_r47, [x]
    ld   LINK_HI, x
    ld   tr_r47 >> 8, [x]
    ld   cursor_show >> 8, y
    jmp  cursor_show
tr_r47:
    ld   [e_dirty], ac
    and  0xFE, ac
    ld   ac, [e_dirty]
    clr  ac
    ld   ac, [e_drow]
    ld   tr_leave >> 8, y
    jmp  tr_leave
ds_tab:
    ld   [e_dirty], ac
    and  0x11, ac
    beq  ds_e
    ld   LINK_LO, x             ; CALL draw_table
    ld   tr_r48, [x]
    ld   LINK_HI, x
    ld   tr_r48 >> 8, [x]
    ld   draw_table >> 8, y
    jmp  draw_table
tr_r48:
    ld   [e_dirty], ac
    and  0xEE, ac
    ld   ac, [e_dirty]
    clr  ac
    ld   ac, [e_drow]
ds_e:
    ld   tr_leave >> 8, y
    jmp  tr_leave

; ------------------------------------------------------------
; redraw_all - the screen from scratch
; ------------------------------------------------------------
ms_back:
    ld   [M_T1], ac
    bne  mb_p
    ld   mi_s2 >> 8, y
    jmp  mi_s2
mb_p:
    ld   mp_s2 >> 8, y
    jmp  mp_s2

; ------------------------------------------------------------
; mus_play - start subtune AC from its beginning
;   changes: AC, X, Y, T0-T7
; ------------------------------------------------------------

#addr 0x0F00
redraw_all:
    ld   ac, [SAVE_AC]          ; PUSH_LINK
    ld   [SP], x
    ld   [LINK_HI], ac
    ld   ac, [x]
    ld   [SP], ac
    dec
    ld   ac, x
    dec
    ld   ac, [SP]
    ld   [LINK_LO], ac
    ld   ac, [x]
    ld   [SAVE_AC], ac
    ld   LINK_LO, x             ; CALL clear_screen
    ld   tr_r49, [x]
    ld   LINK_HI, x
    ld   tr_r49 >> 8, [x]
    ld   clear_screen >> 8, y
    jmp  clear_screen
tr_r49:
    ld   LINK_LO, x             ; CALL draw_footer
    ld   tr_r50, [x]
    ld   LINK_HI, x
    ld   tr_r50 >> 8, [x]
    ld   draw_footer >> 8, y
    jmp  draw_footer
tr_r50:
    ld   0x3F, ac
    ld   ac, [e_dirty]
    clr  ac
    ld   ac, [e_drow]
    ld   tr_leave >> 8, y
    jmp  tr_leave

; ------------------------------------------------------------
; draw_header - row 0: file, title, octave, instrument, mode, state
; ------------------------------------------------------------
draw_header:
    ld   ac, [SAVE_AC]          ; PUSH_LINK
    ld   [SP], x
    ld   [LINK_HI], ac
    ld   ac, [x]
    ld   [SP], ac
    dec
    ld   ac, x
    dec
    ld   ac, [SP]
    ld   [LINK_LO], ac
    ld   ac, [x]
    ld   [SAVE_AC], ac
    clr  ac
    ld   ac, [CUR_ROW]
    ld   1, ac
    ld   ac, [CUR_COL]
    ld   s_hdr & 0xFF, ac
    ld   ac, [R0]
    ld   s_hdr >> 8, ac
    ld   ac, [R1]
    ld   LINK_LO, x             ; CALL tputs
    ld   tr_r51, [x]
    ld   LINK_HI, x
    ld   tr_r51 >> 8, [x]
    ld   tputs >> 8, y
    jmp  tputs
tr_r51:
    ld   e_name, ac
    ld   ac, [R0]
    clr  ac
    ld   ac, [R1]
    ld   LINK_LO, x             ; CALL tputs
    ld   tr_r52, [x]
    ld   LINK_HI, x
    ld   tr_r52 >> 8, [x]
    ld   tputs >> 8, y
    jmp  tputs
tr_r52:
    ld   31, ac
    sub  [CUR_COL], ac
    ld   LINK_LO, x             ; CALL tspc
    ld   tr_r53, [x]
    ld   LINK_HI, x
    ld   tr_r53 >> 8, [x]
    ld   tspc >> 8, y
    jmp  tspc
tr_r53:
    ld   0x20, ac
    ld   ac, [w0]
dh_t:
    ld   SONG >> 8, y
    ld   [w0], x
    ld   [y,x], ac
    bne  dh_t2
    ld   0x20, ac
dh_t2:
    ld   LINK_LO, x             ; CALL tputc
    ld   tr_r54, [x]
    ld   LINK_HI, x
    ld   tr_r54 >> 8, [x]
    ld   tputc >> 8, y
    jmp  tputc
tr_r54:
    ld   [w0], ac
    inc
    ld   ac, [w0]
    xor  0x38, ac
    bne  dh_t
    ld   s_oct & 0xFF, ac
    ld   ac, [R0]
    ld   s_oct >> 8, ac
    ld   ac, [R1]
    ld   LINK_LO, x             ; CALL tputs
    ld   tr_r55, [x]
    ld   LINK_HI, x
    ld   tr_r55 >> 8, [x]
    ld   tputs >> 8, y
    jmp  tputs
tr_r55:
    ld   [e_oct], ac
    ld   LINK_LO, x             ; CALL thex1
    ld   tr_r56, [x]
    ld   LINK_HI, x
    ld   tr_r56 >> 8, [x]
    ld   thex1 >> 8, y
    jmp  thex1
tr_r56:
    ld   s_ins & 0xFF, ac
    ld   ac, [R0]
    ld   s_ins >> 8, ac
    ld   ac, [R1]
    ld   LINK_LO, x             ; CALL tputs
    ld   tr_r57, [x]
    ld   LINK_HI, x
    ld   tr_r57 >> 8, [x]
    ld   tputs >> 8, y
    jmp  tputs
tr_r57:
    ld   [e_ins], ac
    ld   LINK_LO, x             ; CALL thex2
    ld   tr_r58, [x]
    ld   LINK_HI, x
    ld   tr_r58 >> 8, [x]
    ld   thex2 >> 8, y
    jmp  thex2
tr_r58:
    ld   draw_header2 >> 8, y
    jmp  draw_header2


#addr 0x1000
draw_header2:
    ld   0x20, ac
    ld   LINK_LO, x             ; CALL tputc
    ld   tr_r59, [x]
    ld   LINK_HI, x
    ld   tr_r59 >> 8, [x]
    ld   tputc >> 8, y
    jmp  tputc
tr_r59:
    ld   LINK_LO, x             ; CALL tputc
    ld   tr_r60, [x]
    ld   LINK_HI, x
    ld   tr_r60 >> 8, [x]
    ld   tputc >> 8, y
    jmp  tputc
tr_r60:
    ld   [e_play], ac
    bne  dh_p
    ld   s_stop & 0xFF, ac
    ld   ac, [R0]
    ld   s_stop >> 8, ac
    ld   ac, [R1]
    bra  dh_s
dh_p:
    ld   s_play & 0xFF, ac
    ld   ac, [R0]
    ld   s_play >> 8, ac
    ld   ac, [R1]
dh_s:
    ld   LINK_LO, x             ; CALL tputs
    ld   tr_r61, [x]
    ld   LINK_HI, x
    ld   tr_r61 >> 8, [x]
    ld   tputs >> 8, y
    jmp  tputs
tr_r61:
    clr  ac
    ld   ac, [R0]
    ld   TINT_GOLD, ac
    ld   ac, [R0]
    clr  ac
    ld   LINK_LO, x             ; CALL tint_row
    ld   tr_r62, [x]
    ld   LINK_HI, x
    ld   tr_r62 >> 8, [x]
    ld   tint_row >> 8, y
    jmp  tint_row
tr_r62:
    ld   tr_leave >> 8, y
    jmp  tr_leave

; ------------------------------------------------------------
; draw_footer - the keys on the last row
; ------------------------------------------------------------
draw_footer:
    ld   ac, [SAVE_AC]          ; PUSH_LINK
    ld   [SP], x
    ld   [LINK_HI], ac
    ld   ac, [x]
    ld   [SP], ac
    dec
    ld   ac, x
    dec
    ld   ac, [SP]
    ld   [LINK_LO], ac
    ld   ac, [x]
    ld   [SAVE_AC], ac
    ld   ROWS, ac
    dec
    ld   ac, [CUR_ROW]
    clr  ac
    ld   ac, [CUR_COL]
    ld   s_keys & 0xFF, ac
    ld   ac, [R0]
    ld   s_keys >> 8, ac
    ld   ac, [R1]
    ld   LINK_LO, x             ; CALL tputs
    ld   tr_r63, [x]
    ld   LINK_HI, x
    ld   tr_r63 >> 8, [x]
    ld   tputs >> 8, y
    jmp  tputs
tr_r63:
    ld   TINT_GOLD, ac
    ld   ac, [R0]
    ld   ROWS, ac
    dec
    ld   LINK_LO, x             ; CALL tint_row
    ld   tr_r64, [x]
    ld   LINK_HI, x
    ld   tr_r64 >> 8, [x]
    ld   tint_row >> 8, y
    jmp  tint_row
tr_r64:
    ld   tr_leave >> 8, y
    jmp  tr_leave

; ------------------------------------------------------------
; draw_order - the orderlist block: rows 2-10
; ------------------------------------------------------------
ins_byte:
    ld   ac, [u0]
    ld   [e_ins], ac
    and  0x0F, ac
    shl
    shl
    shl
    shl
    add  [u0], ac
    ld   ac, x
    ld   [e_ins], ac
    and  0x10, ac
    beq  ib_2
    ld   (SONG >> 8) + 3, y
    ld   [y,x], ac
    ld   [LINK_HI], y
    jmp  [LINK_LO]
ib_2:
    ld   (SONG >> 8) + 2, y
    ld   [y,x], ac
    ld   [LINK_HI], y
    jmp  [LINK_LO]

; ins_addr - AC = offset: Y:X = the byte's address (for a store)
ins_addr:
    ld   ac, [u0]
    ld   [e_ins], ac
    and  0x0F, ac
    shl
    shl
    shl
    shl
    add  [u0], ac
    ld   ac, x
    ld   [e_ins], ac
    and  0x10, ac
    beq  ia_2
    ld   (SONG >> 8) + 3, y
    ld   [LINK_HI], y
    jmp  [LINK_LO]
ia_2:
    ld   (SONG >> 8) + 2, y
    ld   [LINK_HI], y
    jmp  [LINK_LO]

; ------------------------------------------------------------
; draw_ptitle - rows 12-13: the pattern under the cursor, the columns
; ------------------------------------------------------------
ord_changed:
    ld   [o_v], ac
    ld   LINK_LO, x             ; CALL encode_ol
    ld   tr_r243, [x]
    ld   LINK_HI, x
    ld   tr_r243 >> 8, [x]
    ld   encode_ol >> 8, y
    jmp  encode_ol
tr_r243:
    ld   1, ac
    ld   ac, [e_mod]
    ld   [e_dirty], ac
    or   0x23, ac
    ld   ac, [e_dirty]
    clr  ac
    ld   ac, [e_drow]
    ld   tr_leave >> 8, y
    jmp  tr_leave

; ------------------------------------------------------------
; key_ins - the instrument pane
; ------------------------------------------------------------

#addr 0x1100
draw_order:
    ld   ac, [SAVE_AC]          ; PUSH_LINK
    ld   [SP], x
    ld   [LINK_HI], ac
    ld   ac, [x]
    ld   [SP], ac
    dec
    ld   ac, x
    dec
    ld   ac, [SP]
    ld   [LINK_LO], ac
    ld   ac, [x]
    ld   [SAVE_AC], ac
    ld   2, ac
    ld   ac, [CUR_ROW]
    ld   2, ac
    ld   ac, [CUR_COL]
    ld   s_order & 0xFF, ac
    ld   ac, [R0]
    ld   s_order >> 8, ac
    ld   ac, [R1]
    ld   LINK_LO, x             ; CALL tputs
    ld   tr_r65, [x]
    ld   LINK_HI, x
    ld   tr_r65 >> 8, [x]
    ld   tputs >> 8, y
    jmp  tputs
tr_r65:
    clr  ac
    ld   ac, [w0]               ; the screen row - 3
do_r:
    ld   [w0], ac
    add  ROW_ORD, ac
    ld   ac, [CUR_ROW]
    clr  ac
    ld   ac, [CUR_COL]
    ld   [w0], ac
    add  [e_otop], ac
    ld   ac, [w1]               ; the position
    ld   0x20, ac
    ld   [w1], ac
    xor  [e_op], ac
    bne  do_m
    ld   0x3E, ac
do_m:
    ld   LINK_LO, x             ; CALL tputc
    ld   tr_r66, [x]
    ld   LINK_HI, x
    ld   tr_r66 >> 8, [x]
    ld   tputc >> 8, y
    jmp  tputc
tr_r66:
    ld   0x20, ac
    ld   LINK_LO, x             ; CALL tputc
    ld   tr_r67, [x]
    ld   LINK_HI, x
    ld   tr_r67 >> 8, [x]
    ld   tputc >> 8, y
    jmp  tputc
tr_r67:
    ld   [w1], ac
    ld   LINK_LO, x             ; CALL thex2
    ld   tr_r68, [x]
    ld   LINK_HI, x
    ld   tr_r68 >> 8, [x]
    ld   thex2 >> 8, y
    jmp  thex2
tr_r68:
    clr  ac
    ld   ac, [w2]               ; the voice
do_v:
    ld   [w2], ac
    ld   LINK_LO, x             ; CALL draw_oentry
    ld   tr_r69, [x]
    ld   LINK_HI, x
    ld   tr_r69 >> 8, [x]
    ld   draw_oentry >> 8, y
    jmp  draw_oentry
tr_r69:
    ld   [w2], ac
    inc
    ld   ac, [w2]
    xor  4, ac
    bne  do_v
    ld   [w0], ac
    inc
    ld   ac, [w0]
    xor  ORD_ROWS, ac
    bne  do_r
    ld   LINK_LO, x             ; CALL cursor_show
    ld   tr_r70, [x]
    ld   LINK_HI, x
    ld   tr_r70 >> 8, [x]
    ld   cursor_show >> 8, y
    jmp  cursor_show
tr_r70:
    ld   tr_leave >> 8, y
    jmp  tr_leave

; one orderlist entry: voice AC, position w1, at column 8 + 7 v
draw_ttitle:
    ld   [e_pane], ac
    xor  3, ac
    bne  dtt_p
    ld   s_wtab & 0xFF, ac
    ld   ac, [R0]
    ld   s_wtab >> 8, ac
    ld   ac, [R1]
    bra  dtt_s
dtt_p:
    ld   s_ptab & 0xFF, ac
    ld   ac, [R0]
    ld   s_ptab >> 8, ac
    ld   ac, [R1]
dtt_s:
    ld   LINK_LO, x             ; CALL tputs
    ld   tr_r106, [x]
    ld   LINK_HI, x
    ld   tr_r106 >> 8, [x]
    ld   tputs >> 8, y
    jmp  tputs
tr_r106:
    ld   80, ac
    sub  [CUR_COL], ac
    ld   LINK_LO, x             ; CALL tspc
    ld   tr_r107, [x]
    ld   LINK_HI, x
    ld   tr_r107 >> 8, [x]
    ld   tspc >> 8, y
    jmp  tspc
tr_r107:
    ld   ROW_PTIT + 1, ac
    ld   ac, [CUR_ROW]
    clr  ac
    ld   ac, [CUR_COL]
    ld   80, ac
    ld   LINK_LO, x             ; CALL tspc
    ld   tr_r108, [x]
    ld   LINK_HI, x
    ld   tr_r108 >> 8, [x]
    ld   tspc >> 8, y
    jmp  tspc
tr_r108:
    ld   tr_leave >> 8, y
    jmp  tr_leave

; ------------------------------------------------------------
; draw_grid_col - AC = voice: its pattern's rows from c_top, PV of them
; ------------------------------------------------------------

#addr 0x1200
draw_oentry:
    ld   ac, [SAVE_AC]          ; PUSH_LINK
    ld   [SP], x
    ld   [LINK_HI], ac
    ld   ac, [x]
    ld   [SP], ac
    dec
    ld   ac, x
    dec
    ld   ac, [SP]
    ld   [LINK_LO], ac
    ld   ac, [x]
    ld   [SAVE_AC], ac
    ld   ac, [w3]
    shl
    shl
    shl
    sub  [w3], ac
    add  8, ac
    ld   ac, [CUR_COL]
    ld   [w3], ac
    add  VSPAGE, y
    ld   OD_LEN, x
    ld   [w1], ac
    sub  [y,x], ac
    bcs  doe_p
    bne  doe_blank
    ld   OD_END, x              ; the end row
    ld   [y,x], ac
    xor  0xFF, ac
    bne  doe_stop
    ld   s_loop & 0xFF, ac
    ld   ac, [R0]
    ld   s_loop >> 8, ac
    ld   ac, [R1]
    ld   LINK_LO, x             ; CALL tputs
    ld   tr_r71, [x]
    ld   LINK_HI, x
    ld   tr_r71 >> 8, [x]
    ld   tputs >> 8, y
    jmp  tputs
tr_r71:
    ld   [w3], ac
    add  VSPAGE, y
    ld   OD_TGT, x
    ld   [y,x], ac
    ld   LINK_LO, x             ; CALL thex2
    ld   tr_r72, [x]
    ld   LINK_HI, x
    ld   tr_r72 >> 8, [x]
    ld   thex2 >> 8, y
    jmp  thex2
tr_r72:
    ld   tr_leave >> 8, y
    jmp  tr_leave
doe_stop:
    ld   s_stop6 & 0xFF, ac
    ld   ac, [R0]
    ld   s_stop6 >> 8, ac
    ld   ac, [R1]
    ld   LINK_LO, x             ; CALL tputs
    ld   tr_r73, [x]
    ld   LINK_HI, x
    ld   tr_r73 >> 8, [x]
    ld   tputs >> 8, y
    jmp  tputs
tr_r73:
    ld   tr_leave >> 8, y
    jmp  tr_leave
doe_blank:
    ld   6, ac
    ld   LINK_LO, x             ; CALL tspc
    ld   tr_r74, [x]
    ld   LINK_HI, x
    ld   tr_r74 >> 8, [x]
    ld   tspc >> 8, y
    jmp  tspc
tr_r74:
    ld   tr_leave >> 8, y
    jmp  tr_leave
doe_p:
    ld   [w1], ac
    shl
    add  OD_PAT, x
    ld   [y,x], ac
    ld   LINK_LO, x             ; CALL thex2
    ld   tr_r75, [x]
    ld   LINK_HI, x
    ld   tr_r75 >> 8, [x]
    ld   thex2 >> 8, y
    jmp  thex2
tr_r75:
    ld   0x20, ac
    ld   LINK_LO, x             ; CALL tputc
    ld   tr_r76, [x]
    ld   LINK_HI, x
    ld   tr_r76 >> 8, [x]
    ld   tputc >> 8, y
    jmp  tputc
tr_r76:
    ld   [w3], ac
    add  VSPAGE, y
    ld   [w1], ac
    shl
    add  OD_TR, x
    ld   [y,x], ac
    bne  doe_t
    ld   3, ac
    ld   LINK_LO, x             ; CALL tspc
    ld   tr_r77, [x]
    ld   LINK_HI, x
    ld   tr_r77 >> 8, [x]
    ld   tspc >> 8, y
    jmp  tspc
tr_r77:
    ld   tr_leave >> 8, y
    jmp  tr_leave
doe_t:
    ld   LINK_LO, x             ; CALL tsigned
    ld   tr_r78, [x]
    ld   LINK_HI, x
    ld   tr_r78 >> 8, [x]
    ld   tsigned >> 8, y
    jmp  tsigned
tr_r78:
    ld   tr_leave >> 8, y
    jmp  tr_leave

; ------------------------------------------------------------
; draw_ins - the instrument panel, rows 2-8 from column 40
; ------------------------------------------------------------
ifield:
    ld   ac, [u0]
    shl
    add  [u0], ac
    add  ifld & 0xFF, x
    ld   ifld >> 8, y
    ld   [y,x], ac
    ld   ac, [R2]
    ld   [u0], ac
    shl
    add  [u0], ac
    add  (ifld + 1) & 0xFF, x
    ld   [y,x], ac
    ld   ac, [R3]
    ld   [u0], ac
    shl
    add  [u0], ac
    add  (ifld + 2) & 0xFF, x
    ld   [y,x], ac
    ld   ac, [R4]
    ld   [LINK_HI], y
    jmp  [LINK_LO]

; tcell - AC = table entry 1-63: R2 = row, R3 = column of its text

#addr 0x1300
draw_ins:
    ld   ac, [SAVE_AC]          ; PUSH_LINK
    ld   [SP], x
    ld   [LINK_HI], ac
    ld   ac, [x]
    ld   [SP], ac
    dec
    ld   ac, x
    dec
    ld   ac, [SP]
    ld   [LINK_LO], ac
    ld   ac, [x]
    ld   [SAVE_AC], ac
    ld   ROW_INS, ac
    ld   ac, [CUR_ROW]
    ld   COL_INS, ac
    ld   ac, [CUR_COL]
    ld   s_instr & 0xFF, ac
    ld   ac, [R0]
    ld   s_instr >> 8, ac
    ld   ac, [R1]
    ld   LINK_LO, x             ; CALL tputs
    ld   tr_r79, [x]
    ld   LINK_HI, x
    ld   tr_r79 >> 8, [x]
    ld   tputs >> 8, y
    jmp  tputs
tr_r79:
    ld   [e_ins], ac
    ld   LINK_LO, x             ; CALL thex2
    ld   tr_r80, [x]
    ld   LINK_HI, x
    ld   tr_r80 >> 8, [x]
    ld   thex2 >> 8, y
    jmp  thex2
tr_r80:
    ld   0x20, ac
    ld   LINK_LO, x             ; CALL tputc
    ld   tr_r81, [x]
    ld   LINK_HI, x
    ld   tr_r81 >> 8, [x]
    ld   tputc >> 8, y
    jmp  tputc
tr_r81:
    ld   I_NAME, ac
    ld   ac, [w0]
di_n:
    ld   [w0], ac
    ld   LINK_LO, x             ; CALL ins_byte
    ld   tr_r82, [x]
    ld   LINK_HI, x
    ld   tr_r82 >> 8, [x]
    ld   ins_byte >> 8, y
    jmp  ins_byte
tr_r82:
    bne  di_n2
    ld   0x20, ac
di_n2:
    ld   LINK_LO, x             ; CALL tputc
    ld   tr_r83, [x]
    ld   LINK_HI, x
    ld   tr_r83 >> 8, [x]
    ld   tputc >> 8, y
    jmp  tputc
tr_r83:
    ld   [w0], ac
    inc
    ld   ac, [w0]
    xor  16, ac
    bne  di_n
    ld   ROW_INS + 1, ac        ; the field rows, from a script
    ld   ac, [CUR_ROW]
    ld   COL_INS, ac
    ld   ac, [CUR_COL]
    ld   s_ifields & 0xFF, ac
    ld   ac, [R0]
    ld   s_ifields >> 8, ac
    ld   ac, [R1]
    ld   draw_ins2 >> 8, y
    jmp  draw_ins2

; the script: text, then a code byte: 01-7F a character, 80 + n the high
; nibble of instrument byte n, 90 + n its low nibble, A0 + n the byte,
; B0 + n bit 0 of it, FE a new row, FF the end
draw_grid_col:
    ld   ac, [SAVE_AC]          ; PUSH_LINK
    ld   [SP], x
    ld   [LINK_HI], ac
    ld   ac, [x]
    ld   [SP], ac
    dec
    ld   ac, x
    dec
    ld   ac, [SP]
    ld   [LINK_LO], ac
    ld   ac, [x]
    ld   [SAVE_AC], ac
    ld   ac, [w0]
    ld   LINK_LO, x             ; CALL pat_of
    ld   tr_r109, [x]
    ld   LINK_HI, x
    ld   tr_r109 >> 8, [x]
    ld   pat_of >> 8, y
    jmp  pat_of
tr_r109:
    ld   LINK_LO, x             ; CALL need
    ld   tr_r110, [x]
    ld   LINK_HI, x
    ld   tr_r110 >> 8, [x]
    ld   need >> 8, y
    jmp  need
tr_r110:
    clr  ac
    ld   ac, [w2]
dgc_l:
    ld   [w2], ac
    add  [c_top], ac
    ld   ac, [w1]
    ld   LINK_LO, x             ; CALL draw_cell
    ld   tr_r111, [x]
    ld   LINK_HI, x
    ld   tr_r111 >> 8, [x]
    ld   draw_cell >> 8, y
    jmp  draw_cell
tr_r111:
    ld   [w2], ac
    inc
    ld   ac, [w2]
    xor  PV, ac
    bne  dgc_l
    ld   tr_leave >> 8, y
    jmp  tr_leave

; ------------------------------------------------------------
; draw_cell - voice w0, pattern row w1 (from the decoded pattern in
; SCRATCH, which must be the voice's): note, instrument, effect
; ------------------------------------------------------------
mus_tick:
    ld   MUS_VS >> 8, y
    ld   G_T5, x
    ld   [T5], ac
    ld   ac, [y,x]
    ld   G_NR, x
    ld   0, [y,x]
    ld   [M_PLAY], ac
    and  1, ac
    beq  mt_0
    ld   [M_TICK], ac
    bne  mt_0
    ld   1, [y,x]               ; a new row
mt_0:
    clr  ac
    ld   ac, [M_VIDX]
    ld   mt_voice >> 8, y
    jmp  mt_voice


#addr 0x1400
draw_ins2:
    ld   [R1], y
    ld   [R0], x
    ld   [y,x], ac
    ld   ac, [w1]
    ld   [R0], ac
    inc
    ld   ac, [R0]
    bne  di2_a
    ld   [R1], ac
    inc
    ld   ac, [R1]
di2_a:
    ld   [w1], ac
    xor  0xFF, ac
    beq  di2_end
    ld   [w1], ac
    xor  0xFE, ac
    beq  di2_row
    ld   [w1], ac
    sub  0x80, ac
    bcs  di2_ch
    and  0x0F, ac
    ld   LINK_LO, x             ; CALL ins_byte
    ld   tr_r84, [x]
    ld   LINK_HI, x
    ld   tr_r84 >> 8, [x]
    ld   ins_byte >> 8, y
    jmp  ins_byte
tr_r84:
    ld   ac, [w2]
    ld   [w1], ac
    and  0x30, ac
    beq  di2_hi
    sub  0x10, ac
    beq  di2_lo
    sub  0x10, ac
    beq  di2_by
    ld   [w2], ac
    and  1, ac
    add  0x30, ac
    ld   LINK_LO, x             ; CALL tputc
    ld   tr_r85, [x]
    ld   LINK_HI, x
    ld   tr_r85 >> 8, [x]
    ld   tputc >> 8, y
    jmp  tputc
tr_r85:
    bra  draw_ins2
di2_hi:
    ld   [w2], ac
    shr  ac
    shr  ac
    shr  ac
    shr  ac
    ld   LINK_LO, x             ; CALL thex1
    ld   tr_r86, [x]
    ld   LINK_HI, x
    ld   tr_r86 >> 8, [x]
    ld   thex1 >> 8, y
    jmp  thex1
tr_r86:
    bra  draw_ins2
di2_lo:
    ld   [w2], ac
    ld   LINK_LO, x             ; CALL thex1
    ld   tr_r87, [x]
    ld   LINK_HI, x
    ld   tr_r87 >> 8, [x]
    ld   thex1 >> 8, y
    jmp  thex1
tr_r87:
    bra  draw_ins2
di2_by:
    ld   [w2], ac
    ld   LINK_LO, x             ; CALL thex2
    ld   tr_r88, [x]
    ld   LINK_HI, x
    ld   tr_r88 >> 8, [x]
    ld   thex2 >> 8, y
    jmp  thex2
tr_r88:
    bra  draw_ins2
di2_ch:
    ld   [w1], ac
    ld   LINK_LO, x             ; CALL tputc
    ld   tr_r89, [x]
    ld   LINK_HI, x
    ld   tr_r89 >> 8, [x]
    ld   tputc >> 8, y
    jmp  tputc
tr_r89:
    bra  draw_ins2
di2_row:
    ld   [CUR_ROW], ac
    inc
    ld   ac, [CUR_ROW]
    ld   COL_INS, ac
    ld   ac, [CUR_COL]
    bra  draw_ins2
di2_end:
    ld   LINK_LO, x             ; CALL cursor_show
    ld   tr_r90, [x]
    ld   LINK_HI, x
    ld   tr_r90 >> 8, [x]
    ld   cursor_show >> 8, y
    jmp  cursor_show
tr_r90:
    ld   tr_leave >> 8, y
    jmp  tr_leave

; ins_byte - AC = offset 0-15: AC = that byte of instrument e_ins
grid_tints:
    ld   ac, [SAVE_AC]          ; PUSH_LINK
    ld   [SP], x
    ld   [LINK_HI], ac
    ld   ac, [x]
    ld   [SP], ac
    dec
    ld   ac, x
    dec
    ld   ac, [SP]
    ld   [LINK_LO], ac
    ld   ac, [x]
    ld   [SAVE_AC], ac
    clr  ac
    ld   ac, [w4]
gts_l:
    ld   [w4], ac
    add  [c_top], ac
    ld   LINK_LO, x             ; CALL grid_tint
    ld   tr_r129, [x]
    ld   LINK_HI, x
    ld   tr_r129 >> 8, [x]
    ld   grid_tint >> 8, y
    jmp  grid_tint
tr_r129:
    ld   [w4], ac
    inc
    ld   ac, [w4]
    xor  PV, ac
    bne  gts_l
    ld   tr_leave >> 8, y
    jmp  tr_leave

; ------------------------------------------------------------
; pane_tint - the active pane's cursor row (not the grid: grid_tint)
; R0 = the tint (blue, or 0 to take it off)
; ------------------------------------------------------------

#addr 0x1500
draw_ptitle:
    ld   ac, [SAVE_AC]          ; PUSH_LINK
    ld   [SP], x
    ld   [LINK_HI], ac
    ld   ac, [x]
    ld   [SP], ac
    dec
    ld   ac, x
    dec
    ld   ac, [SP]
    ld   [LINK_LO], ac
    ld   ac, [x]
    ld   [SAVE_AC], ac
    ld   ROW_PTIT, ac
    ld   ac, [CUR_ROW]
    ld   1, ac
    ld   ac, [CUR_COL]
    ld   [e_pane], ac
    sub  3, ac
    bcs  dpt_pat
    ld   dpt_tab >> 8, y
    jmp  dpt_tab
dpt_pat:
    ld   s_pattern & 0xFF, ac
    ld   ac, [R0]
    ld   s_pattern >> 8, ac
    ld   ac, [R1]
    ld   LINK_LO, x             ; CALL tputs
    ld   tr_r91, [x]
    ld   LINK_HI, x
    ld   tr_r91 >> 8, [x]
    ld   tputs >> 8, y
    jmp  tputs
tr_r91:
    ld   [c_v], ac
    ld   LINK_LO, x             ; CALL pat_of
    ld   tr_r92, [x]
    ld   LINK_HI, x
    ld   tr_r92 >> 8, [x]
    ld   pat_of >> 8, y
    jmp  pat_of
tr_r92:
    ld   ac, [w0]
    xor  0xFF, ac
    beq  dpt_none
    ld   [w0], ac
    ld   LINK_LO, x             ; CALL thex2
    ld   tr_r93, [x]
    ld   LINK_HI, x
    ld   tr_r93 >> 8, [x]
    ld   thex2 >> 8, y
    jmp  thex2
tr_r93:
    ld   [w0], ac
    ld   LINK_LO, x             ; CALL need
    ld   tr_r94, [x]
    ld   LINK_HI, x
    ld   tr_r94 >> 8, [x]
    ld   need >> 8, y
    jmp  need
tr_r94:
    ld   0x20, ac
    ld   LINK_LO, x             ; CALL tputc
    ld   tr_r95, [x]
    ld   LINK_HI, x
    ld   tr_r95 >> 8, [x]
    ld   tputc >> 8, y
    jmp  tputc
tr_r95:
    ld   LINK_LO, x             ; CALL tputc
    ld   tr_r96, [x]
    ld   LINK_HI, x
    ld   tr_r96 >> 8, [x]
    ld   tputc >> 8, y
    jmp  tputc
tr_r96:
    ld   [p_len], ac
    ld   LINK_LO, x             ; CALL tdec2
    ld   tr_r97, [x]
    ld   LINK_HI, x
    ld   tr_r97 >> 8, [x]
    ld   tdec2 >> 8, y
    jmp  tdec2
tr_r97:
    ld   s_rows & 0xFF, ac
    ld   ac, [R0]
    ld   s_rows >> 8, ac
    ld   ac, [R1]
    ld   LINK_LO, x             ; CALL tputs
    ld   tr_r98, [x]
    ld   LINK_HI, x
    ld   tr_r98 >> 8, [x]
    ld   tputs >> 8, y
    jmp  tputs
tr_r98:
    ld   draw_ptitle2 >> 8, y
    jmp  draw_ptitle2
dpt_none:
    ld   s_nopat & 0xFF, ac
    ld   ac, [R0]
    ld   s_nopat >> 8, ac
    ld   ac, [R1]
    ld   LINK_LO, x             ; CALL tputs
    ld   tr_r99, [x]
    ld   LINK_HI, x
    ld   tr_r99 >> 8, [x]
    ld   tputs >> 8, y
    jmp  tputs
tr_r99:
    ld   draw_ptitle2 >> 8, y
    jmp  draw_ptitle2

tcell:
    dec
    ld   ac, [u0]
    clr  ac
    ld   ac, [u1]               ; the column
tc_l:
    ld   [u0], ac
    sub  PV, ac
    bcs  tc_d
    ld   ac, [u0]
    ld   [u1], ac
    inc
    ld   ac, [u1]
    bra  tc_l
tc_d:
    ld   [u0], ac
    add  ROW_GRID, ac
    ld   ac, [R2]
    ld   [u1], ac
    shl
    shl
    shl
    shl
    ld   ac, [R3]
    ld   [LINK_HI], y
    jmp  [LINK_LO]

; ------------------------------------------------------------
; cursor_show - the underline under the field of the active pane
; ------------------------------------------------------------
mus_sfx:
    ld   ac, [T7]
    sub  96, ac
    bcs  sx_a
    ld   95, ac
    ld   ac, [T7]
sx_a:
    ld   [R1], ac
    ld   ac, [M_SFXN]
    ld   sfx_in >> 8, y
    jmp  sfx_in

#addr 0x1600
draw_ptitle2:
    ld   s_voice & 0xFF, ac
    ld   ac, [R0]
    ld   s_voice >> 8, ac
    ld   ac, [R1]
    ld   LINK_LO, x             ; CALL tputs
    ld   tr_r100, [x]
    ld   LINK_HI, x
    ld   tr_r100 >> 8, [x]
    ld   tputs >> 8, y
    jmp  tputs
tr_r100:
    ld   [c_v], ac
    add  0x31, ac
    ld   LINK_LO, x             ; CALL tputc
    ld   tr_r101, [x]
    ld   LINK_HI, x
    ld   tr_r101 >> 8, [x]
    ld   tputc >> 8, y
    jmp  tputc
tr_r101:
    ld   s_pos & 0xFF, ac
    ld   ac, [R0]
    ld   s_pos >> 8, ac
    ld   ac, [R1]
    ld   LINK_LO, x             ; CALL tputs
    ld   tr_r102, [x]
    ld   LINK_HI, x
    ld   tr_r102 >> 8, [x]
    ld   tputs >> 8, y
    jmp  tputs
tr_r102:
    ld   [e_op], ac
    ld   LINK_LO, x             ; CALL thex2
    ld   tr_r103, [x]
    ld   LINK_HI, x
    ld   tr_r103 >> 8, [x]
    ld   thex2 >> 8, y
    jmp  thex2
tr_r103:
    ld   80, ac
    sub  [CUR_COL], ac
    ld   LINK_LO, x             ; CALL tspc
    ld   tr_r104, [x]
    ld   LINK_HI, x
    ld   tr_r104 >> 8, [x]
    ld   tspc >> 8, y
    jmp  tspc
tr_r104:
    ld   ROW_PTIT + 1, ac
    ld   ac, [CUR_ROW]
    ld   1, ac
    ld   ac, [CUR_COL]
    ld   s_cols & 0xFF, ac
    ld   ac, [R0]
    ld   s_cols >> 8, ac
    ld   ac, [R1]
    ld   LINK_LO, x             ; CALL tputs
    ld   tr_r105, [x]
    ld   LINK_HI, x
    ld   tr_r105 >> 8, [x]
    ld   tputs >> 8, y
    jmp  tputs
tr_r105:
    ld   tr_leave >> 8, y
    jmp  tr_leave
dpt_tab:
    ld   draw_ttitle >> 8, y
    jmp  draw_ttitle

draw_cell2:
    ld   0x20, ac
    ld   LINK_LO, x             ; CALL tputc
    ld   tr_r118, [x]
    ld   LINK_HI, x
    ld   tr_r118 >> 8, [x]
    ld   tputc >> 8, y
    jmp  tputc
tr_r118:
    ld   [w3], ac
    add  2, ac
    ld   ac, x
    ld   SCRATCH >> 8, y
    ld   [y,x], ac
    xor  0xFF, ac
    beq  dc_nofx
    ld   [y,x], ac
    ld   LINK_LO, x             ; CALL thex1
    ld   tr_r119, [x]
    ld   LINK_HI, x
    ld   tr_r119 >> 8, [x]
    ld   thex1 >> 8, y
    jmp  thex1
tr_r119:
    ld   [w3], ac
    add  3, ac
    ld   ac, x
    ld   SCRATCH >> 8, y
    ld   [y,x], ac
    ld   LINK_LO, x             ; CALL thex2
    ld   tr_r120, [x]
    ld   LINK_HI, x
    ld   tr_r120 >> 8, [x]
    ld   thex2 >> 8, y
    jmp  thex2
tr_r120:
    ld   tr_leave >> 8, y
    jmp  tr_leave
dc_nofx:
    ld   s_dots & 0xFF, ac
    ld   ac, [R0]
    ld   s_dots >> 8, ac
    ld   ac, [R1]
    ld   LINK_LO, x             ; CALL tputs
    ld   tr_r121, [x]
    ld   LINK_HI, x
    ld   tr_r121 >> 8, [x]
    ld   tputs >> 8, y
    jmp  tputs
tr_r121:
    ld   tr_leave >> 8, y
    jmp  tr_leave

; ------------------------------------------------------------
; draw_rownums - the row numbers down the grid
; ------------------------------------------------------------
hexval:
    ld   ac, [u0]
    sub  0x30, ac
    blt  hv_n
    sub  10, ac
    bcs  hv_d
    ld   [u0], ac
    sub  0x61, ac
    blt  hv_n
    sub  6, ac
    bcs  hv_a
hv_n:
    ld   0xFF, ac
    ld   [LINK_HI], y
    jmp  [LINK_LO]
hv_d:
    ld   [u0], ac
    sub  0x30, ac
    ld   [LINK_HI], y
    jmp  [LINK_LO]
hv_a:
    ld   [u0], ac
    sub  0x61 - 10, ac
    ld   [LINK_HI], y
    jmp  [LINK_LO]

; piano - AC = key: AC = semitone from the octave (0-28), FF when none

#addr 0x1700
draw_cell:
    ld   ac, [SAVE_AC]          ; PUSH_LINK
    ld   [SP], x
    ld   [LINK_HI], ac
    ld   ac, [x]
    ld   [SP], ac
    dec
    ld   ac, x
    dec
    ld   ac, [SP]
    ld   [LINK_LO], ac
    ld   ac, [x]
    ld   [SAVE_AC], ac
    ld   [w1], ac
    sub  [c_top], ac
    add  ROW_GRID, ac
    ld   ac, [CUR_ROW]
    ld   [w0], ac
    shl
    add  [w0], ac
    shl
    shl
    add  COL_GRID, ac
    ld   ac, [CUR_COL]
    ld   [w1], ac
    sub  [p_len], ac
    bcs  dc_r
    ld   10, ac
    ld   LINK_LO, x             ; CALL tspc
    ld   tr_r112, [x]
    ld   LINK_HI, x
    ld   tr_r112 >> 8, [x]
    ld   tspc >> 8, y
    jmp  tspc
tr_r112:
    ld   tr_leave >> 8, y
    jmp  tr_leave
dc_r:
    ld   [w1], ac
    shl
    shl
    ld   ac, [w3]
    ld   ac, x
    ld   SCRATCH >> 8, y
    ld   [y,x], ac
    ld   LINK_LO, x             ; CALL tnote
    ld   tr_r113, [x]
    ld   LINK_HI, x
    ld   tr_r113 >> 8, [x]
    ld   tnote >> 8, y
    jmp  tnote
tr_r113:
    ld   0x20, ac
    ld   LINK_LO, x             ; CALL tputc
    ld   tr_r114, [x]
    ld   LINK_HI, x
    ld   tr_r114 >> 8, [x]
    ld   tputc >> 8, y
    jmp  tputc
tr_r114:
    ld   [w3], ac
    inc
    ld   ac, x
    ld   SCRATCH >> 8, y
    ld   [y,x], ac
    xor  0xFF, ac
    beq  dc_noins
    ld   [y,x], ac
    ld   LINK_LO, x             ; CALL thex2
    ld   tr_r115, [x]
    ld   LINK_HI, x
    ld   tr_r115 >> 8, [x]
    ld   thex2 >> 8, y
    jmp  thex2
tr_r115:
    ld   draw_cell2 >> 8, y
    jmp  draw_cell2
dc_noins:
    ld   0x2D, ac
    ld   LINK_LO, x             ; CALL tputc
    ld   tr_r116, [x]
    ld   LINK_HI, x
    ld   tr_r116 >> 8, [x]
    ld   tputc >> 8, y
    jmp  tputc
tr_r116:
    ld   LINK_LO, x             ; CALL tputc
    ld   tr_r117, [x]
    ld   LINK_HI, x
    ld   tr_r117 >> 8, [x]
    ld   tputc >> 8, y
    jmp  tputc
tr_r117:
    ld   draw_cell2 >> 8, y
    jmp  draw_cell2

draw_rownums:
    ld   ac, [SAVE_AC]          ; PUSH_LINK
    ld   [SP], x
    ld   [LINK_HI], ac
    ld   ac, [x]
    ld   [SP], ac
    dec
    ld   ac, x
    dec
    ld   ac, [SP]
    ld   [LINK_LO], ac
    ld   ac, [x]
    ld   [SAVE_AC], ac
    clr  ac
    ld   ac, [w2]
dr_l:
    ld   [w2], ac
    add  ROW_GRID, ac
    ld   ac, [CUR_ROW]
    ld   2, ac
    ld   ac, [CUR_COL]
    ld   [w2], ac
    add  [c_top], ac
    ld   ac, [w1]
    sub  64, ac
    bcc  dr_b
    ld   [w1], ac
    ld   LINK_LO, x             ; CALL thex2
    ld   tr_r122, [x]
    ld   LINK_HI, x
    ld   tr_r122 >> 8, [x]
    ld   thex2 >> 8, y
    jmp  thex2
tr_r122:
    bra  dr_n
dr_b:
    ld   2, ac
    ld   LINK_LO, x             ; CALL tspc
    ld   tr_r123, [x]
    ld   LINK_HI, x
    ld   tr_r123 >> 8, [x]
    ld   tspc >> 8, y
    jmp  tspc
tr_r123:
dr_n:
    ld   [w2], ac
    inc
    ld   ac, [w2]
    xor  PV, ac
    bne  dr_l
    ld   tr_leave >> 8, y
    jmp  tr_leave

; ------------------------------------------------------------
; draw_row - pattern row AC of all four voices (when on the screen)
; ------------------------------------------------------------

#addr 0x1800
draw_row:
    ld   ac, [SAVE_AC]          ; PUSH_LINK
    ld   [SP], x
    ld   [LINK_HI], ac
    ld   ac, [x]
    ld   [SP], ac
    dec
    ld   ac, x
    dec
    ld   ac, [SP]
    ld   [LINK_LO], ac
    ld   ac, [x]
    ld   [SAVE_AC], ac
    ld   ac, [w1]
    sub  [c_top], ac
    bcs  drw_e
    sub  PV, ac
    bcc  drw_e
    clr  ac
    ld   ac, [w0]
drw_l:
    ld   [w0], ac
    ld   LINK_LO, x             ; CALL pat_of
    ld   tr_r124, [x]
    ld   LINK_HI, x
    ld   tr_r124 >> 8, [x]
    ld   pat_of >> 8, y
    jmp  pat_of
tr_r124:
    ld   LINK_LO, x             ; CALL need
    ld   tr_r125, [x]
    ld   LINK_HI, x
    ld   tr_r125 >> 8, [x]
    ld   need >> 8, y
    jmp  need
tr_r125:
    ld   LINK_LO, x             ; CALL draw_cell
    ld   tr_r126, [x]
    ld   LINK_HI, x
    ld   tr_r126 >> 8, [x]
    ld   draw_cell >> 8, y
    jmp  draw_cell
tr_r126:
    ld   [w0], ac
    inc
    ld   ac, [w0]
    xor  4, ac
    bne  drw_l
    ld   [w1], ac
    ld   LINK_LO, x             ; CALL grid_tint
    ld   tr_r127, [x]
    ld   LINK_HI, x
    ld   tr_r127 >> 8, [x]
    ld   grid_tint >> 8, y
    jmp  grid_tint
tr_r127:
drw_e:
    ld   tr_leave >> 8, y
    jmp  tr_leave

; ------------------------------------------------------------
; grid_tint - pattern row AC: its tint (blue under the cursor in the
; pattern pane, green when it is being played), when on the screen
; ------------------------------------------------------------
grid_tint:
    ld   ac, [SAVE_AC]          ; PUSH_LINK
    ld   [SP], x
    ld   [LINK_HI], ac
    ld   ac, [x]
    ld   [SP], ac
    dec
    ld   ac, x
    dec
    ld   ac, [SP]
    ld   [LINK_LO], ac
    ld   ac, [x]
    ld   [SAVE_AC], ac
    ld   ac, [u7]
    sub  [c_top], ac
    bcs  gt_e
    sub  PV, ac
    bcc  gt_e
    clr  ac
    ld   ac, [R0]
    ld   [e_pane], ac
    bne  gt_p
    ld   [u7], ac
    xor  [c_row], ac
    bne  gt_p
    ld   TINT_BLUE, ac
    ld   ac, [R0]
gt_p:
    ld   [e_play], ac
    beq  gt_w
    ld   [e_plop], ac
    xor  [e_op], ac
    bne  gt_w
    ld   [u7], ac
    xor  [e_plrow], ac
    bne  gt_w
    ld   [R0], ac
    or   TINT_GREEN, ac
    ld   ac, [R0]
gt_w:
    ld   [u7], ac
    sub  [c_top], ac
    add  ROW_GRID, ac
    ld   LINK_LO, x             ; CALL tint_row
    ld   tr_r128, [x]
    ld   LINK_HI, x
    ld   tr_r128 >> 8, [x]
    ld   tint_row >> 8, y
    jmp  tint_row
tr_r128:
gt_e:
    ld   tr_leave >> 8, y
    jmp  tr_leave

; grid_tints - every grid row on the screen
handle_key2:
    ld   [e_key], ac
    xor  0x3C, ac
    bne  hk2_1
    ld   [e_ins], ac
    beq  hk2_e
    dec
    bra  hk2_i
hk2_1:
    ld   [e_key], ac
    xor  0x3E, ac
    bne  hk2_2
    ld   [e_ins], ac
    xor  31, ac
    beq  hk2_e
    ld   [e_ins], ac
    inc
hk2_i:
    ld   ac, [e_ins]
    ld   [e_dirty], ac
    or   0x0C, ac
    ld   ac, [e_dirty]
    clr  ac
    ld   ac, [i_np]
    ld   tr_leave >> 8, y
    jmp  tr_leave
hk2_e:
    ld   tr_leave >> 8, y
    jmp  tr_leave
hk2_2:
    ld   handle_key3 >> 8, y
    jmp  handle_key3


#addr 0x1900
pane_tint:
    ld   ac, [SAVE_AC]          ; PUSH_LINK
    ld   [SP], x
    ld   [LINK_HI], ac
    ld   ac, [x]
    ld   [SP], ac
    dec
    ld   ac, x
    dec
    ld   ac, [SP]
    ld   [LINK_LO], ac
    ld   ac, [x]
    ld   [SAVE_AC], ac
    ld   [e_pane], ac
    xor  1, ac
    bne  pt_2
    ld   [o_k], ac
    sub  [e_otop], ac
    add  ROW_ORD, ac
    ld   LINK_LO, x             ; CALL tint_row
    ld   tr_r130, [x]
    ld   LINK_HI, x
    ld   tr_r130 >> 8, [x]
    ld   tint_row >> 8, y
    jmp  tint_row
tr_r130:
    ld   tr_leave >> 8, y
    jmp  tr_leave
pt_2:
    ld   [e_pane], ac
    xor  2, ac
    bne  pt_3
    ld   [i_f], ac
    ld   LINK_LO, x             ; CALL ifield
    ld   tr_r131, [x]
    ld   LINK_HI, x
    ld   tr_r131 >> 8, [x]
    ld   ifield >> 8, y
    jmp  ifield
tr_r131:
    ld   [R2], ac
    ld   LINK_LO, x             ; CALL tint_row
    ld   tr_r132, [x]
    ld   LINK_HI, x
    ld   tr_r132 >> 8, [x]
    ld   tint_row >> 8, y
    jmp  tint_row
tr_r132:
    ld   tr_leave >> 8, y
    jmp  tr_leave
pt_3:
    ld   [e_pane], ac
    sub  3, ac
    bcs  pt_e
    ld   [t_e], ac
    ld   LINK_LO, x             ; CALL tcell
    ld   tr_r133, [x]
    ld   LINK_HI, x
    ld   tr_r133 >> 8, [x]
    ld   tcell >> 8, y
    jmp  tcell
tr_r133:
    ld   [R2], ac
    ld   LINK_LO, x             ; CALL tint_row
    ld   tr_r134, [x]
    ld   LINK_HI, x
    ld   tr_r134 >> 8, [x]
    ld   tint_row >> 8, y
    jmp  tint_row
tr_r134:
pt_e:
    ld   tr_leave >> 8, y
    jmp  tr_leave
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
