tocksin/placard/(commit log)

2026-10-29 Merge pull request #171 from tocksin/claude/project-thread-85mn6q
    Case renders: refreshed with the side vents
2026-10-29 Case: halve the side vent slots (20 mm pitch: 10 right, 6 left)
    Justin: less venting. The black metal case sheds most of the 14 W through
    its surface; the floor slots stay. Printed pieces, drawings and renders
    regenerated.
    Claude-Session: https://claude.ai/code/session_01MQ2PBNTvS3gr2SYdqrAzoy
2026-10-29 SNES port 3D model from Justin's photos
    Flange round the plug opening (round end, flat end), two pin blocks
    (3 + 4 holes), ribbed top, slotted back ledge, pins that leave the back
    wall and bend down into the footprint's holes. Envelope 42 x 16 x 21 mm:
    16 above the board + 5 mm of pin below (was read as 18 + 3).
    Claude-Session: https://claude.ai/code/session_01DnW5SUmhwqsoUSKk75vATC
2026-10-29 SNES port footprint and model: pins 4 + 3 from Justin's photos
    Pins 1-4 at the flat end, 5-7 at the round end, 3.5 mm apart in a group
    with a 6 mm gap (read from the photos, no datasheet). Locating peg holes
    dropped (the photos show none). Model pin blocks and back ledge follow
    the pins.
    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
2026-10-29 Case: SNES cut-outs follow the 16 mm jack (centre z 8, 39 x 12 plug outline)
    PR #173's SNES model: 16 mm tall with a 42 x 16 flange round a 37 x 10 plug
    opening. The front-wall cut-outs move down to centre z 8 and widen to the plug
    outline + clearance, aluminium and printed; 0 collisions. Case height is set
    by J5, unchanged. Renders regenerated.
    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
2026-10-29 Main board: Justin's routing for the SNES ports on the front edge
    Justin's board as saved on his PC (line endings normalized), with the
    PR #174 SNES footprints and his hand routing. DRC (KiCad 9, PCBWay rules)
    after a zone refill: 0 errors, 0 unconnected, 1 warning (D18 silk 0.09 mm
    from its pad). The saved file still has stale plane fills around TP1-TP3.
    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
2026-10-29 LED_D5.0mm: silk circle r 2.6 so it clears pad 1 by 0.19 mm
    KiCad's own LED_D5.0mm draws the body circle (r 2.5) 0.09 mm from pad 1's
    square corner, under the board's 0.15 mm PCBWay silk-to-pad rule (D18).
    gen_kicad_stock_footprints.py now applies SILK_FIX to the copy.
    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
2026-10-29 Main board: Justin's refilled board with D18 updated from the library
    Justin's board as saved at 7:10 PM ET (zones refilled), line endings
    normalized, with D18's silk circle at r 2.6 as in PR #177. KiCad 9.0.8
    DRC, PCBWay rules: 0 errors, 0 warnings, 0 unconnected, 0 parity issues.
    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
2026-10-29 Fab files: regenerate Gerber, drill and ODB++ for main (PR #178) and both carts (rev A)
    kicad-cli 9.0.8 from copies, saved zone fills, same settings as the
    10-27 export. DRC 0 errors / 0 warnings on all three boards.
    Claude-Session: https://claude.ai/code/session_01DnW5SVfTC1ykqH1VEPPtnQ
2026-10-29 Carts: Justin's schematic update and refill, H1 restored; fab files regenerated
    Update PCB from Schematic renamed the nets (ADDR*/DATABUS*), named the spare
    fingers and added part fields, and removed the mounting hole H1 (not in the
    cart schematics). H1 is put back at its old position (same uuid), zones
    refilled. DRC 0/0/0. Copper otherwise unchanged; the 64K cart's stale plane
    gap under U4 is now filled.
    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
2026-10-29 S/N box filled white on main and both carts; fab files regenerated
    Silk only: the 17 x 5.5 mm S/N rectangle is now a filled silk shape so a
    black marker shows on it. DRC 0/0/0 on all three boards; only the silk
    gerbers change.
    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
2026-10-30 Case: quote package (case/quote/, gen_case_quote.py); manufacturable plate flanges
    The quote check found the plates' 6 mm flanges ran over six floor standoffs
    and were too short for a bend plus a PEM nut. Now: 14 mm flanges with open
    notches round the standoffs and J7 (stopping at the bend), plates standing on
    a floor that runs to the outside edges, PEM nuts 9 mm in, R2 bends.
    gen_case_quote.py writes bent STEPs with real radii and reliefs, flat-pattern
    DXFs (CUT + BEND layers, K 0.44), A3 PDF drawings with material, finish,
    hardware and tolerances, acrylic DXFs, PARTS.csv, README.md and quote.zip.
    Board models vs the bent parts: 0 collisions. Renders, print pieces and
    CASE.md regenerated.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
2026-10-30 CASE.md: magnet gluing, the jig holds each magnet while the epoxy sets; magnet first, then glue
    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
2026-10-30 Case: concept renders of printed snap covers (no magnets), gen_cover_snap_concept.py
    Concept only; the case design is unchanged.
    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
2026-10-30 Case concept: printed covers held by pull-off detents (tabs through small acrylic slots, back lip dome in the card screw hole)
    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
2026-10-30 Case concept: flat slot covers (no back lip), covers park clicked into floor slots (second bump on each tab)
    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
2026-10-30 Move C41 to +5V after K1 and drain the rail through K1's NO contact
    K1's COM now carries +5V and its NC contact VON, so holding reset swings
    COM onto the NO contact, where new R64 (22 ohm) empties the board rail in
    a few ms however short the press. C41 (220u) moves from VON to +5V so it
    carries the board through the NC contact's bounce when reset lets go.
    Power sheet relaid (NT1 moved down), BOMs, BRINGUP and SCHEMATIC_PLAN
    updated; BRINGUP's K1 part number typo (CS6VDC) fixed.
    Claude-Session: https://claude.ai/code/session_01DnW5SRTxWuv4xnT2rLGBJ6
2026-10-30 Case concept: slot cover back lip back; its dome clicks into the card screw hole on top and a second back plate hole when parked
    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
2026-10-30 Case concept renders: tray and plates with their real bends (R2 inside, corner reliefs) from gen_case_quote.py
    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
2026-10-30 Case: exploded views with every screw, standoff, PEM insert and foot; fastener stack drawing (gen_case_hardware.py)
    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
2026-10-30 Case: floor PEM standoffs replaced by 6 mm male-female standoffs screwed down from below; 27 mm standoffs female-female (Justin)
    Tray gets 14 countersunk M3 holes and no PEM; flange notches 8 mm wide for the hex corners.
    BOM, CASE.md, quote package, hardware renders and stack drawing updated.
    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
2026-10-30 Case: loose M3 hex nuts on the plate flanges instead of PEM nuts
    Justin: no PEM nuts pressed into the plates. Flange holes are plain
    3.4 mm; each of the six countersunk M3 x 6 screws from below goes into an
    ISO 4032 nut on top of the flange (clear of SW2/K1 leads and the board).
    Quote package, BOM, CASE.md assembly steps and hardware drawings updated.
    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
2026-10-30 Expansion slots 2 x 25 (Sullins EBC25DRXH): A15:A8 and PIXEL_ENABLE on every slot
    Contacts 1-20 unchanged; 21-24 = A8-A15, A25 = PIXEL_ENABLE, B25 = GND, so a
    card can follow the video reads (HDMI capture) or CPU writes. Footprint, 3D
    model and shell keepout from Sullins drawing C10881 rev P (card 86.7 mm,
    keepout 93.7 x 25.04 mm, 3.18 mm ear holes 78.11 apart, M3 x 12 + nut).
    Schematic, netlist check, BOM (Digi-Key S3322-ND $6.63), EXPANSION.md
    ("Video capture cards"), CASE.md, BRINGUP.md, shell keepout drawing.
    Main board file untouched: Justin updates the PCB from the schematic.
    Claude-Session: https://claude.ai/code/session_01DnW5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
2026-10-30 Expansion slots use the cartridge's Molex 87715-9106
    Justin, 2026-10-30: instead of the 2 x 25 EBC25DRXH (which would have moved
    J9-J12 and U38/U42), the four expansion slots take the cartridge's 64-contact
    connector. Every slot has A15:A0, D7:D0, PIXEL_ENABLE, /HSYNC and /VSYNC.
    The contacts a cartridge drives are left open, and every expansion output is
    on a cartridge-slot spare, so neither does harm in the other's slot.
    Footprint Molex_87715-9106_Expansion_Slot keeps the 72 mm card and its keepout
    where the 2 x 20 slot had them (connector offset 7.63 mm), so nothing on the
    board moves. Schematic (netlist check 0 problems), symbol, 3D model,
    EXPANSION.md pinout, CASE.md, BRINGUP.md, BOM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
2026-10-30 Case: commit to the 3D-printed snap covers (no magnets)
    Justin chose the printed covers with pull-off detents. The concept geometry
    moves into gen_case.py: tab slots in the acrylic top, parking slots in the
    floor, a parking hole under each card screw hole in the back plate, and
    one-piece covers with snap tabs (slot covers also a back lip with a dome),
    written as case/slot_cover.stl and case/cart_cover.stl (cap face down).
    Magnets, steel discs, acrylic covers and the gluing jig are gone from the
    model, quote package, BOM and CASE.md. gen_case_covers.py draws the
    detent section; gen_case_quote.py --mesh writes the bent metal for the
    renders (V.bent). Renders and drawings regenerated.
    Co-Autho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
2026-10-30 Expansion slots: grounds on the inner rows, signals outer; take in Justin's KiCad edits
    Reassign the expansion slot contacts so the extra grounds sit on the
    inner (even) rows and the signals on the outer (odd) rows wherever the
    cartridge pinout allows: 19 of 38 signals outer. The cartridge's power
    and ground contacts, the shared signals and the wrong-slot rules are
    kept (every expansion output and extra ground on a J8 spare, every
    cartridge output open on the expansion slot). BT4 and BT6-BT8 dropped.
    Justin's local KiCad edits (all main-board sheets, the board and the
    project; K1 coil pins swapped) are committed as he saved them; only the
    expansion sheet comes from the generator. Netlist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
2026-10-30 Expansion slots: slot 1 nearest the board center
    Swap the symbol uuids of J9/J12, J10/J11, R51/R54 and R52/R53 in the
    expansion sheet, so Update PCB from Schematic renames the footprints in
    place: slot 1 (J9, boot contacts, /EXP1, SEL GND) lands on the slot at
    x 175, nearest the center, and slot 4 on the outermost one at x 94. No
    footprint moves. Justin's latest board (routing since PR #196) is
    committed as he saved it.
    Claude-Session: https://claude.ai/code/session_01DnW5SUDtmC2C2nXUS4xVk2
2026-10-31 Main board rules: expansion slot ring exception and 0.4 mm thermal gap
    J9-J12 use the same Molex 87715 pads as J8 (0.95 mm pad, 0.65 mm hole,
    0.15 mm ring), so add them to the fixed-footprint ring exception. A
    0.4 mm thermal gap on the slot pads widens the 0.13 mm GND web between
    B31 and B32. Justin's board (saved 6:51 PM ET 10-31): 203 -> 0 DRC
    violations after a refill.
    Claude-Session: https://claude.ai/code/session_01DnW5SUnwNTReeh8gwXgsaY
2026-10-31 Timing with the routed main board (Justin's 2026-10-31 routing)
    New docs/TIMING_ROUTED.md: memory and control paths with trace delays and
    clock skew from the routed board, against the 2026-10-29 board and the
    datasheets. STALL path improves to +0.4 ns; reads through /RAM_OE and
    /ROM_OE into the IR and State PLDs are short (-1.3 RAM, -2.2 ROM) from the
    data bus route. Notes in WE_TIMING, FETCH_TIMING and TIMING, with two
    datasheet corrections (zero-page store start, source AC after FETCH).
    Claude-Session: https://claude.ai/code/session_01DnW5SSXi25ixkyMRfs6r1X
2026-11-01 Main board: Justin's finished Oct 31 layout (slot 1 rename applied, final routing)
    Taken from his local copy in C:\git\placard (saved 2026-10-31 18:51 EDT);
    it includes everything main had plus his Oct 31 routing.
    Claude-Session: https://claude.ai/code/session_01DnW5SVSAjR8WVHRf49759K
2026-11-01 Add grid router v4: parallel CPU/CUDA negotiated router, tidy and score tools
    Router v4 routes outside KiCad on the 0.125 mm grid with the board rules
    (1 mm outline clearance, mounting-hole bands, no self-parallel nets).
    mroute4.py routes nets in parallel batches (OpenMP threads on the CPU, one
    CUDA block per net on the GPU through CuPy), then hard rounds and rip-up
    with locking; tidy.py cleans chains; score.py gives one comparable report;
    route.py chains them. Windows DLLs are prebuilt (MinGW); the mux-region
    benchmark board is in bench/.
    Claude-Session: https://claude.ai/code/session_01DnW5SVVdLhTVRZy4mmP7CM
2026-11-01 router_v4: nets in a batch see each other's previous routes; tidy keeps chains that join via pads
    Occupancy now excludes only the net's own previous route (ownocc windows)
    instead of every batch-mate's, which had broken the negotiation. tidy
    decides to drop a chain from the components its real copper touches.
    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
2026-11-01 router_v4: near/far GPU frontier, chain-level rip-up, pair tidy, 45-degree corners, whole-board bench, critical-net defaults
    - pfgpu.cu: near/far bucket frontier (DELTA) so the big nets stop re-relaxing
    - mroute4: CHAINRIP rips only the crossed chains of a neighbour (partial routes
    count as groups); PROT/CRIT default to the clock, stall, write and sync nets,
    critical nets routed first with via cost x2
    - tidy.py PAIR mode: a chain with a via is re-routed together with a neighbour
    - corner45.py: chamfers 90-degree corners where clearance allows
    - makebench.py: whole-board test bench from a copy of the board
    - gridcore: a dropped via no longer joins the layers (ghost thru cells)
    - nvrtc_che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
2026-11-01 router_v4: CPU benchmark on the laptop (4 threads)
    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
2026-11-01 router_v4: whole-board bench files and run_wb.bat
    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
2026-11-01 router_v4: whole-board GPU benchmark from the RTX 4070 laptop
    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
2026-11-01 router_v4: patroute.py pattern router, NPTH hole clearance 0.32, corner45 drops zero-length legs; whole-board DRC
    KiCad 9 DRC on the whole-board GPU result: 0 unconnected, 0 clearance
    errors; 14 NPTH hole-clearance errors (0.26-0.29 vs 0.30 mm rule, router
    used 0.25, now 0.32) and 172 zero-length tracks left by chamfers eating a
    short leg from both ends (now dropped). Refilled, DRC'd board in bench/.
    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
2026-11-01 router_v4 README: round-2 benchmark tables (r1 sweep, whole board vs hand layout)
    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
2026-11-01 router_v4: whole-net polish pass in tidy (NETPASS), bench keeps CLK_E
    tidy.py NETPASS=1 lifts each net entirely and re-routes it from scratch against
    everything else, keeping the result when the whole net is cheaper. makebench.py
    now keeps CLK_E (a deliberate delay lead) so the whole-board bench does not
    shorten it; bench/wb.kicad_pcb.zip rebuilt from the Oct 31 board.
    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
2026-11-01 router_v4: whole-board round-3 run from the RTX 4070 laptop (wb3)
2026-11-01 router_v4: meander pass for minimum net length (MINLEN), thermal via keep-out, round-3 notes
    meander.py adds trombone bumps to a routed net until it reaches a minimum
    length (MINLEN=NET:mm in run_wb.bat / run_bench.bat, after corner45).
    rules.THERMCLR keeps vias 2 mm away from GND/+5V through-hole pads so the
    inner-plane thermal spokes are not cut (DRC starved_thermal on wb3).
    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
2026-11-01 Board dimensions and case regenerated from the final Oct 31 board
    - docs/placard_main_dimensions.pdf: rerun gen_board_dimensions.py; the
    expansion slots are drawn where PR #197 moved them (slot 1 nearest the
    board center, 27 mm pitch, order reversed).
    - case/: gen_case.py, gen_case_quote.py, gen_case_print.py rerun on the
    final board: the slot bay, card screw holes and slot cover pieces follow
    the moved slots (0.6-1.2 mm), quote package and print pieces updated.
    - Case renders: slot covers are numbered from the left of the bay, so after
    the slot order reversal the renders put covers on the slots holding cards.
    views.json now names the covers by the new positions (cover n -> 5-n)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
2026-11-01 router_v4: whole-board round-3 run wb4 (thermal via keep-out) from the RTX 4070 laptop
2026-11-01 router_v4: wb4m MINLEN demo, CLK_E meandered to 420 mm
2026-11-01 router_v4 round 3: autorouted main board copy (wb4, DRC clean), results in README
    kicad/placard_autorouted.kicad_pcb is the wb4 route (38.96 m, 656 vias vs the
    hand layout's 41.85 m, 956) with Justin's GND/+5V/CLK_E copper kept, as a
    ready-to-swap copy. KiCad 9 DRC after zone refill: 0 clearance, 0 unconnected.
    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
2026-11-01 router_v4: Specctra DSN export and SES merge tools, whole-board bench DSN for a Freerouting comparison
    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
2026-11-01 router_v4: Freerouting 1.9 run on the whole-board bench (wb_fr.ses) from the laptop
    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
2026-11-01 router_v4: dsn.py no longer adds the cartridge finger-tab keepout by default (it covered the whole main board); bench DSN regenerated
    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
2026-11-01 Music player: SID-style 4-voice sequencer, demo song, PLAY.PLC, snd_update fix (#205)
    Phase 1 of the music sequencer (docs/MUSIC.md):
    - placard_mus.masm: 4 voices + a sound-effect voice, pulse/saw/tri/noise/
    custom waves, ADSR, wave and pulse programs, 12 effects, orderlists per
    voice; mixes into the line-fetched buffer as a write-ahead ring
    - mus_tool.py: .mus text to .SNG, reference model, WAV; mus_tables.masm
    - src/music/demo.mus: 54 s demo song using every feature (sdcard/DEMO.SNG)
    - play.masm -> sdcard/PLAY.PLC: plays DEMO.SNG, shows the voices with tints
    - test_mus.py (sim vs model, sample for sample) and test_play.py
    - snd_update: BASIC SOUND stalled when called once a frame at th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
2026-11-01 router_v4: Freerouting 2.1 run on the whole-board bench (wb_fr2.ses) from the laptop
    40 passes, 1 router thread, fixed DSN (2ce845a): 25 unrouted after optimization, 1761 wires, 445 vias.
    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
2026-11-01 router_v4: Freerouting 2.1 whole-board comparison (merged SES, v4 finish of its 20 open nets, README table)
    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
2026-11-01 router_v4: dsn.py PROTNETS (protect only named nets' wiring), wb4 board exported for a Freerouting optimisation pass
    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
2026-11-02 router_v4: Freerouting 2.1 optimisation pass over the wb4 board (wb4_fr.ses) from the laptop
2026-11-02 Tracker: TRACKER.PLC, the on-machine music editor (2x screen, code overlay) (#208)
    tracker.masm edits a song for the music player on the machine: the
    orderlists, the four voices' patterns side by side, the instruments and
    the wave and pulse tables, plays it while editing (the played row green,
    the cursor row blue, header and keys gold), loads and saves .SNG files on
    the card, and starts with DEMO.SNG. Screen 80 x 30 on 2x lines: the
    editor and the player are about 20 KB of code, more than the RAM beside a
    1x screen holds, so the even video pages that 2x frees hold the 40
    pattern slots and the rest of the code (TRACKER.OVL, read by the program
    at start). The program runs with the map at FF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
2026-11-02 router_v4: GRID env for the grid pitch (0.0625 fine grid), run_wb_fine.bat
    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
2026-11-02 Docs: main board is 290 x 215 mm, not 290 x 290 (BOM, kit pricing, kicad README) (#210)
    The board outline in kicad/placard.kicad_pcb is 290 x 215 mm; several
    docs still gave the 290 x 290 size from PR #37. BOMs regenerated with
    gen_bom.py (only the date and the PCB line change).
    Claude-Session: https://claude.ai/code/session_01DnW5SRZ85YQCPKyczN39PN
2026-11-02 router_v4: tidy chain bbox margin holds the via disk on fine grids
    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
2026-11-02 router_v4 round 4: via-cost ladder in run_wb.bat (656 -> 541 -> 524 vias on wb4), results, swappable board = VIA 800 ladder result
    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
2026-11-02 Main board: adopt the round-4 autorouted layout (39.98 m / 541 vias, zones refilled); dimension drawing regenerated with the board moved left on the sheet
    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
2026-11-02 SNES port: measured pins and shell (4 mm pitch, 6.5 mm gap, 1 mm pins, 42.8 mm)
    Justin measured the part: pins 4 mm apart in each group, 6.5 mm from pin 4
    to pin 5, 1 mm pins, shell just under 43 x 16 mm. Footprint pads 2.0 mm
    with 1.3 mm drill, body/courtyard 42.8 mm; model flange, pin blocks and
    leads to match. Pin 4 stays at x -1.25.
    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
2026-11-02 Main board: J2/J3 to measured SNES footprint, tracks rerouted
    Update the two SNES controller ports on the board to the measured
    footprint (4 mm pitch, 6.5 mm gap, 2.0 mm pads / 1.3 mm drill), move the
    tracks that clashed with the new pad positions (DATABUS2, ~LOAD_Y,
    PAD2_DATA, P_MOSI, P_SCK) and reconnect the pins whose pads moved.
    Zones refilled. KiCad 9 DRC: 0 violations, 0 unconnected, 0 schematic
    parity issues.
    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
2026-11-02 Organize docs/ into subfolders
    docs/ held 77 files flat. Group them by subject: architecture, timing,
    video, sound, software, hardware (with keyboard/ for the dropped matrix
    keyboard drawings), case, bom and kit, each drawing next to the doc that
    uses it. WORKFLOW.md and logo/ stay at the top, and a new docs/README.md
    lists everything.
    Every reference follows the move: README, kicad/README, the schematic
    title-block comments (sheet PDFs re-exported from the unchanged sheets),
    PLD/VHDL/asm/script comments, relative links inside the docs, and the
    generators that write into docs/ (gen_bom, gen_board_dimensions,
    gen_case*, gen_kicad_pcb, gen_kicad_cart_pcb, gen_shell_keepout,
    gen_fetch_paths, g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
2026-11-02 Main board: bring track ends to pad centers for teardrops
    1303 track ends stopped inside a pad but off its center, so KiCad would
    not build teardrops there. 1238 ends moved to the pad center; where the
    moved segment would break clearance (56 ends) a short in-pad stub to the
    center was added instead; 5 track pieces lying wholly inside one pad
    were removed. Zones refilled. KiCad 9 DRC: 0 violations, 0 unconnected,
    0 schematic parity issues.
    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
2026-11-02 Web emulator: rebuild built-in ROM and SD card
    The built-in 32K ROM was 214 bytes behind rom32.asm and the card lacked
    PLAY.PLC, TRACKER.PLC, TRACKER.OVL and DEMO.SNG. Regenerated with
    gen_web_assets.py; test_web_emu.py passes (200 frames, same as placard_sim).
    Claude-Session: https://claude.ai/code/session_01DnW5SUpyev2A4UwiqNxF73
2026-11-02 Web emulator: boot the built-in card to the DOS
    gen_web_assets.py leaves BOOT.CFG off the built-in card, so the loader
    runs DOS.PLC at power-up instead of MENU.PLC. sdcard/ is unchanged.
    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
2026-11-02 ROM loader: silence the sound buffer at power-up
    The sound buffer x5DF3-x5FFF powers up random and nothing cleared it
    before the DOS or a program ran, so the random bytes played every frame
    as a loud 60 Hz buzz (on the board too). power_up now calls snd_init.
    Rebuilt rom32.asm and the web emulator's built-in ROM; test_web_emu.py
    and test_dos.py pass.
    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
2026-11-02 Move kitting and kit pricing out of the public repo
    docs/kit/KITTING.md and KIT_PRICING.md now live in the private project
    folder. Drop the links to them from docs/README.md, BOM.md (via
    gen_bom.py), the PCB lines of the BOMs and CASE.md.
    Claude-Session: https://claude.ai/code/session_01DnW5SSLBVX5LfDMePk4TyT
2026-11-02 Tracker: Esc goes back to the DOS (#221)
    Esc now runs the Ctrl-X exit (one "Not saved" warning when the song
    has unsaved changes, Esc again leaves); Space still stops playback.
    The keys row says "Esc exit" instead of "Esc stop". MUSIC.md key table,
    test_tracker.py (stops with Space, checks the unsaved warning and the
    exit) and the web emulator's built-in card updated.
    Claude-Session: https://claude.ai/code/session_01DnW5SRSxW2eckK6uaDCUqj
2026-11-02 Docs: describe the current design only; merge routed timing into TIMING.md
    - TIMING.md rewritten as the one timing document: datasheet and routed-board
    slack for every path, recomputed on the round-4 autorouted main board and
    the 64K cartridge. TIMING_ROUTED.md and TIMING_FIXES.md removed.
    - FETCH, WE, ALU, XY and VIDEO timing notes rewritten to the design as built
    (no options, no history); fetch_paths.png redrawn with one panel.
    - Old options and history removed from the architecture, hardware, video,
    sound, software, case and BOM docs and the README; OPTIMIZATION.md, the
    matrix keyboard drawings, the option B board drawing and the unchosen logo
    concepts removed. gen_logo.py now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
2026-11-02 DOS: Ctrl+B starts BASIC; ray caster and side scroller as SD programs in the demo menu
    - dos.masm: Ctrl+B in the file browser jumps to ROM BASIC; help line shows it
    - gen_raycast.py --sd: RAYCAST.PLC (code and tables in RAM, high pages copied up at start)
    - gen_scroller.py --sd: SCROLLER.PLC + SCROLLER.OVL (strips in the video RAM the
    4x screen leaves free, run with map FF; Esc via menu_poll)
    - menu.masm: 8 programs (adds Boing, 3D ships, ray caster, runner)
    - tests: test_dos Ctrl+B; test_raycast_sim/test_scroller_sim --sd boot from a card;
    test_menu handles library programs
    - docs, web emulator card rebuilt
    Claude-Session: https:/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
2026-11-02 Timing fixes 1 and 2: I/O read strobe from the state bits, /WE falls with CLK
    I/O decode PLD rev 06: RD = IO & !PC_ENABLE & !Q0 & !PIXEL_ENABLE (LOAD_MEM
    on a clock the CPU owns), Q0 from State pin 18 on pin 23 instead of
    !LOAD_IMM. The read strobe no longer waits for STALL through the Branch PLD
    and the cartridge: the I/O read right after a video stall goes from -7.3 to
    +7.7 ns (datasheet).
    Sync PLD rev 11: WE = !CLK_E & !CLK & !RW & !PIXEL_ENABLE. /WE falls on the
    later edge (CLK, pin 1) and still rises on CLK_E. Zero-page store start on
    the routed board goes from -1.5 to +2.6 ns; write pulse +5.4 -> +2.4 ns.
    FPGA models (io_decode_pld, sync_pld, basys_top) match. tb_ps2_kbd (GHDL,
    io_de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
2026-11-02 Textured ray caster on the SD card (RAYTEX.PLC + RAYTEX.OVL), menu program 9
    gen_raycast_tex.py --sd builds the full textured ray caster as a card
    program: code and page tables in RAM, textures, hit tables and the
    compiled scalers in the video RAM the 4x view and text rows never show,
    loaded from RAYTEX.OVL after build. Same scalers as the ROM build, so
    every view matches the model (test_raycast_tex_sim.py --sd, 600 views).
    Esc goes back to the DOS. The demo menu now lists 9 programs.
    Claude-Session: https://claude.ai/code/session_01DnW5SU9g1vKiFBYNJzzjVa
2026-11-02 System test on the SD card (TEST.PLC), T in the demo menu
    TEST.PLC (test.masm) checks RAM (two address passes over 57.75 KB of
    both chips, video RAM included), the card slot IDs, PS/2 keyboard and
    mouse presence (KBD_FLAGS, F5 acknowledge), SD init and mount, and plays
    two beeps. No ROM bytes used. test_systest.py runs it on a good machine
    and with a stuck RAM bit and no mouse; test_menu.py checks key T.
    Claude-Session: https://claude.ai/code/session_01DnW5SUXAq27syZd3V4L7Gy
2026-11-02 Schematic: I/O decode U12 pin 23 to State Q0 (I/O decode rev 06)
    - memory sheet: U12 pin 23's global label ~{LOAD_IMM} is now Q0; the
    cached IO_DECODE symbol names the pin Q0.
    - control sheet: the U1 pin 18 / U2 pin 10 net (was the local /Control/Q0)
    gets a global label Q0, drawn like PC_ENABLE; C1's value text moved left
    of the capacitor to make room.
    - placard.kicad_sym and gen_kicad_symbols.py: IO_DECODE pin 23 is Q0.
    - gen_kicad_schematic.py net map follows (U12 pin 23 = Q0).
    - schematics/placard_main.pdf re-exported (KiCad 9).
    Netlist against main: only U1-18, U2-10 (renamed /Control/Q0 -> Q0) and
    U12-23 (~{LOAD_IMM} -> Q0) change; /LOAD_IMM keeps U1-19, U18-1 and the
    slot A20 pi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
2026-11-02 Case: 4 plain M3 holes in the floor at the feet for optional screw-on feet
    Stick-on feet stay in the BOM and cover the holes. CASE.md gains a
    Screw-on feet section (Keystone 722, M3 x 10 socket head, M3 nyloc).
    Regenerated tray STEP, quote package and printed tray pieces.
    Claude-Session: https://claude.ai/code/session_01DnW5SSWd3dkPDjausLLuWu
2026-11-02 Router v4: track-length budgets from the timing model (budgets.py, lenfix.py)
    budgets.py turns the routed-timing model into per pin-pair maximum track lengths
    (0.5 ns margin, 45-53 % duty, helping lengths at straight distance, CLK_E fixed);
    lenbudget.py measures them on the grid, tracklen.py on real tracks; lenfix.py lifts
    and regrows nets over budget (astar2 start costs, rip-up, exact connectivity check).
    BUDGET=file: mroute4 routes budgeted nets first, tidy keeps no move that worsens a
    break, score.py reports breaks, run_wb.bat adds the lenfix step.
    Bench (round-4 board): 17 pairs / 1659 mm over budget -> 3 pairs / 58 mm, 0 open.
    Cla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
2026-11-02 Schematic: U11 memory control PLD clocked from CLK_E (timing fix 4)
    U11 pin 1 global label CLK -> CLK_E (memory sheet), so /RAM_OE and /ROM_OE
    fall about 3.7 ns earlier and the /OE reads keep their margin up to a 53 %
    clock high half. Netlist change is only U11-1; ERC unchanged. Power-sheet
    note, generator, MEM_CTRL header note (equations unchanged), TIMING.md and
    the main schematic PDF updated. Layout (U11 pin 1 to the CLK_E tap) is Justin's.
    Claude-Session: https://claude.ai/code/session_01DnW5STCvhWEvWXnyf8Xybi
2026-11-02 budgets.py: Q0 net rename, budget the CLK_E taps (only the X1->NT2 lead fixed)
    The schematic made /Control/Q0 the global Q0; the model's name is mapped and a
    missing net now stops the run. FIXED takes NET:FROM:TO pairs; the default fixes
    only the CLK_E delay lead, so the taps to U11 pin 1 / U15 pin 9 get budgets
    (X1 -> U11-1 at most 47.6 mm on the 2026-11-02 placement).
    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
2026-11-03 budgets.py: RAM write-pulse check (tWP vs the CLK_E delay lead)
    /WE is low from the CLK fall at U15 pin 1 to the CLK_E rise at pin 9, less the
    spread of its two edges, so the CLK_E lead shortens the write pulse. With the
    2026-11-02 placement and 53 % duty the lead must stay under about 520 mm for
    0.5 ns margin; address hold wants about 480 mm or more.
    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
2026-11-03 Main board: full route with timing length budgets, ends snapped to pad centres
    Router v4 on the GPU with budgets.py (U11E=1, CLK_E lead 505.9 mm fixed):
    0 open, 0 collisions, 0 pairs over budget, 510 vias, 41.46 m.
    Real-track slack min: addr_hold +0.75 ns, write_pulse +1.05 ns.
    snapends.py adds a stub from each off-centre track end to the pad
    centre (1276 ends) so KiCad can make teardrops; run_wb.bat runs it last.
    KiCad 9 DRC: clearance 0; only the 3 existing J7 GND unconnects.
    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
2026-11-03 Main board: join J7 GND pads 6, 7, 8 and 10 on B.Cu
    The plane can't reach the middle row of the HD-15 (the antipads of the
    staggered rows close it off), so pads 6 and 8 get 0.5 mm tracks to pad 7
    and pad 10 one to pad 5. Zones refilled; KiCad 9 DRC: 0 errors, 0 unconnected.
    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
2026-11-03 Main board: title block date 2026-11-03
    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
2026-11-03 TIMING.md: recheck on the routed board of 2026-11-03
    All paths meet 25.175 MHz at a 50 % clock on the budget-routed board
    (fix 4 on the board, CLK_E lead 505.9 mm). Tightest: address hold +0.75,
    zero-page read +1.81, write pulse +2.24 ns. Board columns, clock and net
    length tables, I/O reads and Method updated.
    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
2026-11-03 Expansion slots: card timing budget at the fingers, slot checks in budgets.py
    budgets.py (SLOTS=1) checks the I/O read and write of J9-J12 against a
    card budget at the fingers (/EXP to data 10.5 ns, address/RW/LOAD_IMM to
    data 18, write select 13 before /WE rises, data setup 3, hold 2), so the
    router keeps the slot tracks short enough. EXPANSION.md gets a Card timing
    section with that table and the reference card (74F541 read, 74F377
    write, read-ahead for RAM). Present board: read +0.63 ns worst slot.
    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
2026-11-03 SCRAPWRIGHT phase 3: salvage, the tug's air, rooms with air and warnings
    - Parts in the wreck are bolted: CUT FREE with the plasma cutter in a
    hand (1.5 s, 5 % battery), PICK UP into the left hand, right hand or
    back, PUT DOWN on a deck next to you; carried parts slow the walk.
    - The tug: its worth and whether it has air (a working O2 tank and
    scrubber on board) in the player panel; with air it tops up its rooms
    and fills the suit, with a battery it charges it.
    - Rooms (gen_scrap.py flood fill, ids in the map's spare bits) each hold
    a pressure; open doors and the airlocks share it, the breach drains it,
    decks in a room without air are frosted. The suit uses its O2 below
    60; ca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
2026-11-03 Expansion slots: selects straight from the address, plain SRAM cards pass
    I/O decode PLD rev 07 makes /P0, /PORT and /EXP1-/EXP4 combinationally
    from Y, X7, Y_ENABLE, PC_ENABLE and PIXEL_ENABLE (valid about 13 ns), one
    select per slot. Reads are select and Q0 low: U29 /OE2 = Q0, the port
    and PS/2 PLDs use PORT & !Q0 and clock on /WE, and slot pin A10 is Q0
    (R51-R54 removed). Sync PLD rev 12 makes /MAP_WR. No chip added.
    Board re-netted and the changed nets rerouted (DRC clean, zones
    refilled). On the routed board a plain 15 ns SRAM card reads with
    +3.41 ns; the line and port reads gain about 8 ns. VHDL models, sheets,
    symbols, budgets.py checks, docs, BOM and schematic PDF updated.
    Co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
2026-11-03 TIMING.md: rerun from scratch on the redesigned board, cartridge re-measured
    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
2026-11-03 Fab: regenerate main board Gerbers and drill from the expansion-redesign board
    Main board at PR #243: refill identical to saved fill, DRC 0 violations,
    0 unconnected, 0 schematic parity issues (kicad-cli 9.0.8).
    Claude-Session: https://claude.ai/code/session_01DnW5SSnN63LizYLAfrcy4Q
2026-11-03 SCRAPWRIGHT: take the ship apart and build it, broken walls and doors leak
    Walls, decks and doors uninstall on the tug (CUT FREE in a wreck): a wall
    leaves a wall panel, a door a door kit, a deck a deck plate in a carry
    slot and open space. Panels and door kits INSTALL on the tug as walls
    and doors; LAY DECK PLATE builds on open space. The tug's area is now
    x0-19, y18-46, round its hull.
    rooms_build works the rooms out at the start and after every change
    (about 0.3 s): each cell's room, the average pressure, leaks to vacuum,
    the tug's rooms, the links. A wall or closed door at 50 % damage or
    worse leaks a unit a tick (two to vacuum). gen_scrap.rooms() follows
    the same rules and test_scr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
2026-11-03 Main board: redo the dimensions in the layout from the current board
    The Dwgs.User dimensions in kicad/placard.kicad_pcb were from the old
    290 x 290 layout (290 deep, holes at 285, slots at 20.32 pitch). They are
    replaced by 24 dimensions read from the current board, from the back left
    corner: overall 290 x 215, back-panel connector centers (J13 J6 J7 J5),
    left-edge SW1 SW2 J4, front SNES J2 J3, mounting holes, slot and
    cartridge centers. gen_board_dimensions.py --layout makes them and only
    touches the dimension blocks. Stale notes fixed (hole list, SNES on the
    front edge, old slot pitch note removed) and the side labels moved clear
    of the dimensions. docs/hardware/placard_main_dimensions.pd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
2026-11-03 Main board: bring the layout notes up to date
    The Cmts.User notes still described the placement test on the 290 x 290
    board (keyboard over the front 65 mm, dashed boxes and lines that no
    longer exist, chip rows). They now describe the routed board: case tray
    walls, slot and cartridge courtyards, chip-puller boxes, which
    footprints are still preliminary, and where the timing and dimension
    drawings are. FRONT label no longer says keyboard side.
    Claude-Session: https://claude.ai/code/session_01DnW5ST28pFYGyHJbVrydmR
2026-11-03 SCRAPWRIGHT: numbered menu items, airlocks side by side, UNINSTALL everywhere
    - each action in the panel menu shows its key: "1: ", "2: " ...
    - the tug moved 10 cells east: docked, its airlock (29,32) is right next
    to the wreck's (30,32); the docking tube is gone. A link next to an
    airlock looks past it (rooms() and rl_side), so the two corridors share
    their air through the pair
    - a part in the wreck says INSTALLED and is UNINSTALLed (still with the
    cutter there); CUT FREE and BOLTED are gone
    - test: tug coordinates moved, UNINSTALL in the wreck, key-up gaps in the
    door walks; docs and screenshots
    Claude-Session: https://cla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
2026-11-04 SCRAPWRIGHT: skills, REPAIR, taking the suit off, loose parts crated
    - six skills (mechanical, electrical, nuclear, computers, hydraulics,
    suit), all 10 at the start; each part needs one or two (its info
    lines say which). A job (install, uninstall, repair) is 16 work units
    a frame of its full-speed time, done at 2 + the average of the needed
    skills' quarters a frame; in the suit half that and an eighth of the
    suit skill. A job done raises the skills it used (job_start,
    work_tick, sk_gain; gen_scrap.job_frames / skill_gain model them)
    - REPAIR: a damaged part, wall, deck or door, 15 frames a damage step
    at full speed; a repaired wall or door stops leaking
    - the player's menu: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
2026-11-04 SCRAPWRIGHT: the action menu in two columns (keys 1-8)
    - the panel menu is two columns of four from column 42: actions 1-4,
    then 5-8 (menu_row, menu_item); keys 1-8, and the pointer picks an
    action in either column (hover_panel)
    - the action list moves out of zero page to x36F0-x36F7 (8 entries)
    - info lines are 40 columns at most, action names 14 (gen_scrap.py
    checks): REFILL SUIT, PUT DOWN LEFT / RIGHT / BACK, SPARE PLATE, a
    shorter scrubber line; on yourself the tug's worth and air move to
    the name row
    - test: INSPECT picked and clicked in the second column; the blackout
    message waited for
    Claude-Session: https://claude.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
2026-11-04 SCRAPWRIGHT: out of the suit drawn, wall and door seals, spacewalks, a leak fix
    - without the suit the player is drawn without it (PL_NOSUIT: bare
    head, blue work clothes; cell_extra), redrawn at TAKE OFF / PUT ON
    - a wall or door (and a wall panel or door kit) shows SEALED - NO LEAKS
    up to 50 % damage and LEAKS AIR - NEEDS REPAIR from there (the 02
    info line, ts_seal), not a "works at" percentage
    - open space and hull breaches are walkable (WALK HERE too): a spacewalk
    on suit air, to repair the outside and build
    - fix: a broken wall or door between two rooms took a unit from the
    emptier room when it was the lower one, so its air went under 0 and
    read 255 % (air_crack)
    - test: th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
2026-11-04 SCRAPWRIGHT: an inventory screen, installing from it, installing in wrecks
    I or Tab (or INVENTORY on yourself) shows the carry slots in cell art with
    the panel and menu on the hovered one; INSTALL there picks the cell next to
    you: ship parts on a bare deck, wall panels and doors on a deck or open
    space, deck plates and thrusters on open space. Loose parts on a deck
    install in a wreck too. Thrusters uninstall into a carry slot. The job
    bar is drawn at run time to make room.
    Claude-Session: https://claude.ai/code/session_01DnW5SUvX2Xih8989SJsSij
2026-11-04 SCRAPWRIGHT: the inventory screen as in the mock-up, read from SCRAP.INV
    The inventory's code, font and layout are a swap file (SCRAP.INV, gen_plc
    --swap) read into rooms_build's work space each time it opens; a rebuild
    waits until it closes. Title bar, GEAR (suit, battery, O2, utility) and
    CARRYING (hands, back) columns with framed slots and 3 x 5 labels; the
    area under CARRYING kept for an open bag. The test checks the whole
    screen against gen_scrap.inventory_screen().
    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
2026-11-04 SCRAPWRIGHT: hull breach as broken walls, cracked art for broken things, inventory pointer
    - The vented section's breach is two broken hull wall segments (WALL at
    damage 15); a broken wall or closed door with vacuum beyond it drains
    an eighth of the room's air and one a tick, like a breach.
    - Anything broken (damage step 8 on: parts, walls, decks, doors) is drawn
    with a crack through its art (crack_cell, CRACK), also in the
    inventory's carry slots.
    - The inventory screen draws an arrow pointer at the mouse (pt_show,
    pt_hide), saving what is under it at x4080. SCRAP.INV now x4100-x4CFF
    (6 sectors).
    - Tests: the view and inventory checks expect the cracks and pointer;
    O2 timing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
2026-11-05 SCRAPWRIGHT: health bar, step-by-step repairs, pointer on the ship view, jammed doors
    - The panel shows HEALTH (100 % undamaged) with a health bar instead of
    DAMAGE. A repair takes a damage step off at a time (rep_bar,
    rep_step): the health bar rises, no job bar, and a repair stopped part
    way keeps its steps.
    - The arrow pointer is drawn on the ship view as well as the inventory
    (pt_show from the frame loop; view_cell and hover_update take it off).
    - A door under 50 % health is jammed: shut, it stops you and refuses
    OPEN until repaired to 50 %; open, it stays open. The KESTREL 9 has a
    jammed armory door, a jammed open med bay door and some broken decks.
    - No INVENTORY action (I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
2026-11-05 SCRAPWRIGHT: parts stand on whole decks, conduit section part, comms antenna
    Parts can only be put down or installed on a deck or power conduit at
    50% health or more, so the deck under a part is never broken and needs
    no layer of its own. Parts on a conduit are listed (CND) so picking one
    up lays the conduit again. A second left click on a locked part shows
    the deck or conduit under it. The conduit is also a part: it installs
    into a deck and uninstalls into a loose conduit section. A comms
    antenna installs on open space; a working one on the tug gives COMMS.
    SCRAP.OVL now also fills x5C00-x5DF2 and its last sector stays in the
    x5400 sector buffer, for room.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
2026-11-05 SCRAPWRIGHT: comms off the player panel; the tug's antenna starts barely working
    Comms will show on the navigation station's display in the next game
    mode, so the player panel no longer says COMMS; N_ANT still records a
    working antenna on the tug. The tug's antenna starts at 56% so the
    player can head out at once.
    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
2026-11-06 Main board: teardrops on pads and vias, fab files regenerated
    Justin's board with 1022 teardrops (saved 2026-11-06 8:19 AM ET), zones
    refilled in KiCad 9.0.8. The saved teardrop fills had 28 clearance errors
    (teardrops 0.02-0.19 mm from neighbouring tracks); the refill clips them
    and DRC is 0/0/0 with schematic parity. Gerbers, drill and DRC report
    regenerated; only the copper and plane layers changed.
    Claude-Session: https://claude.ai/code/session_01DnW5SV3RGLgWZQYJqA4Fnk
2026-11-06 Release rev A; working main board and 32K cart move to rev B
    Rev A (main board PLC-1001 and 32K cart PLC-1002, ordered 2026-11-06) is
    main e4799a7 (PR #262). docs/hardware/RELEASES.md records it with the
    gerber/ODB zip SHA-1s. The working main board and 32K cart files now say
    rev B (title blocks, silkscreen "REV B", schematic title blocks, BOM bare-PCB
    lines); no copper changed. The 64K cart was not ordered and stays rev A.
    kicad/fab/ keeps the rev A outputs.
    Claude-Session: https://claude.ai/code/session_01DnW5SSr6pLuvHFwBa2NE7s
2026-11-06 router_v4: corner45 keeps a corner whose cut leg pieces carry a junction of the same net (opened Y2 on the r1 bench)
    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
2026-11-06 router_v4: free the cupy memory pool after every GPU launch
    On the fine-grid whole-board route the pool grew to fill the 8 GB card by
    iteration 2 and the driver fell back to system memory (4.7x slower
    iterations).
    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
2026-11-06 router_v4: run_wb_fine.bat STAGE=route|tidy to run the router and the tidy ladder separately
    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
2026-11-07 SCRAPWRIGHT: room to grow (part text on SD, 64 kinds, 32 rooms), nitrogen, pumps, intakes, radar
    - Part info lines and INSPECT text move to sdcard/SCRAP/Kxy (two kinds a
    file); the panel reads the sector it needs when the kind pair changes.
    - Kinds are 6 bits (64), rooms 0-31 (room 32 on shares room 31 for now);
    the fixed table pages are placed down from the art (gen_scrap works them out).
    - FUEL tank is the NITROGEN TANK; new AIR PUMP (by an O2 tank: the tug's air
    needs it), GAS INTAKE (by a nitrogen tank: fuel) and RADAR ARRAY (open space).
    - sdimage.py and the web emulator's makeFat16 size folders for their entries;
    gen_web_assets.py includes sdcard/ folders.
    - test_scrap_sim.py: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
2026-11-07 SCRAPWRIGHT navigation step 1: flight
    NAVIGATE at a working helm opens SCRAP.NAV (a second swap file, #overlay2
    at x4100): the sector map (3 zooms), undock / dock, thrust and turning.
    The flight is resident (scrap_fl.masm) and goes on while you walk: mass
    per kind, 20 kN a working thruster, 400 L of nitrogen a tank with an
    intake, PROXIMITY / IMPACT alarms and hull collisions that damage the
    tug by speed. Undocked, the airlocks seal and the wreck is out of sight.
    rb_cold now stops at 32 rooms; tug_scan skips open space (half the time).
    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
2026-11-07 router_v4: fine-grid whole-board bench results (wbf)
    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
2026-11-07 router_v4: round 5 README with the whole-board fine-grid ladder, its DRC, and the parallel ladder numbers
    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
2026-11-07 router_v4 round 6: streaming shared-memory tidy workers, consistent coarse A* heuristic, windowed searches, router DISJOINT option
    tidy.py: worker processes attach to the main grid's read-only arrays (shared memory) and keep
    only their own occupancy and routes; the main process hands out one net at a time in the
    sequential order, validates each move (free copper, per-net versions) and streams accepted
    moves to all workers; rejected moves are retried. gridcore.py: Grid.share/attach/unshare,
    window-sized A* inputs, windowed blocked/own_ring, cached fixed-copper boxes in components(),
    coarse (4x4 block, bilinear, consistent) goal heuristic. mroute4.py: DISJOINT batching option
    (off). r1 fine la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
2026-11-08 router_v4 round 7: tidy options tried without gain (window rip-up REGION, multi-root and branching polish), second round 6 ladder run is the best r1 board
    tidy.py: REGION=mm window rip-up with a window negotiation (pressure + history), POLSTARTS multi-root
    polish, POLBRANCH branching polish; all off by default, none beats the ladder on fine r1 (README
    round 7 has the numbers). A second run of the round 6 streaming ladder gives 449 vias / 26.46 m
    (bench/r1_fine7_*), showing a run-to-run spread of about 10 vias.
    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
2026-11-08 SCRAPWRIGHT nav: 2 bpp map, Q/E side thrust, no speed in FLIGHT, smaller tug
    The map is 2 bpp while the screen is up (256 x 192 square pixels, byte
    columns 8-71): blue grid, white tug and station, gold derelicts, drift
    dots and target corners; the view's mode bytes go back to 4 bpp on Esc.
    Q and E thrust sideways at half thrust (fl_dv's side vectors). FLIGHT
    shows heading and docked only. The range shows as 1 << zoom km.
    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
2026-11-08 router_v4 round 8: best-of-N ladder driver (ladder.py, tidy SEED), router ALLEVERY/WINLATE options and their coarse A/B, fine r1 best-of-3 results
    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
2026-11-08 router_v4 round 8: VIA 3200 rung on the best round 6 board, 438 vias / 26.77 m on the fine r1 bench
    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
2026-11-08 router_v4: whole-board round 6 results (wbf6), wider pair rung, DISJOINT GPU timing, cvm.py, research survey
    Round 6 tidy on the round 5 route and on a new DISJOINT=16 GPU route, four ladder rungs plus a wider pair rung;
    best board 478 vias / 40.66 m, KiCad 9 DRC clean. Layer-flip pass (cvm.py) removes nothing after the ladder.
2026-11-08 SCRAPWRIGHT nav step 2b: docking and comms screen, spin momentum, tug icon
    - SCRAP.DCK/DK2/DK3/DK4 docking screen: two rings, drifting port ring,
    flashing clear-to-clamp, mouse-driven hail/dock/undock/clamp menu
    - map spin carries into docking as yaw rate plus a pitch component;
    heading carries over as yaw; R stops spin; top spin rate NAV_SPIN
    - clean 8-direction triangle tug icon on the map
    - no turning or thrust while docked
    - Esc to DOS fixed: overlays no longer overwrite the DOS menu block
    - tests and SCRAP.md updated
    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
2026-11-08 router_v4: 45-degree segments re-read as movable chains; full DIAG=1 ladder on fine r1 = 424 vias / 26.34 m (orthogonal 423 / 26.73 m)
    gridcore.py classifies exact on-grid 45-degree segments as chain members on load (and paths_from_tail accepts them),
    so rungs after a DIAG tidy can move the diagonal copper an earlier rung laid instead of treating it as fixed.
    Bench r1_fine9_diag_*: 462 / 448 / 442 / 437 -> wide 424 vias / 26.34 m, DRC clean, 72 min.
    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
2026-11-09 router_v4: placeguide.py, placement guidance for routability (RUDY congestion, via estimate calibrated on routed boards, suggested moves)
2026-11-09 SCRAPWRIGHT: the tug starts with eight thrusters
    Six more thrusters on the tug's hull (two left, two above, two below),
    placed after the random damage pass so the wreck's damage is unchanged.
    Tug starts at 108.8 t and speeds up by 1.5 m/s each second.
    test_scrap_sim.py passes (8 thrusters, 108800 kg).
    Claude-Session: https://claude.ai/code/session_01DnW5SVkWnb5psHtGtJbNh6
2026-11-09 router_v4: placeguide.py modes (report/fit/sweep/moves/swaps/optimize) and a routed check
    Rebuilds the placement guidance tool of PR #282 around modes: same-footprint swaps, per-part
    sweep heatmaps, bus pin-order inversions, Eco1 puller boxes, decaps riding with their IC,
    rotation about the courtyard centre on the 0.635 mm grid, timing-budget penalty, cached greedy
    optimizer that writes a moved copy (signal tracks stripped) for the router. Via model refitted
    on the routed main board (per-net r = 0.88).
    Route check on the container CPU (coarse route + tidy VIA 400): optimizer placement 532 vias /
    38.42 m against 578 / 41.49 m for the current placement (-8 % vias, -7.4 % track).
    Co-Authored-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
2026-11-09 router_v4 round 9 on the whole board: 479 vias / 39.69 m with the round-9 ladder (BEST tidy, DIAGRUNGS=2, wide); junction move JUNC=1 option (no gain)
    Whole-board ladder on round 6's DISJOINT fine route, cloud CPU, 3 workers, 4.0 h: 563 / 535 / 505 / 493 -> wide 479 vias /
    39.69 m against round 6's 591 / 550 / 510 / 504 -> 484 / 40.17 m on the same route; previous best board 478 / 40.66 m.
    tidy.py JUNC=1 lifts the chains meeting at a junction and reconnects them (Freerouting's via sliding at tree level);
    only 5 junctions on fine r1, none cheaper, so it stays off.
    Claude-Session: https://claude.ai/code/session_01DnW5SVVdLhTVRZy4mmP7CM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
2026-11-09 SCRAPWRIGHT: quarter-size tug with aluminum hull
    The tug is now 8 x 8 cells (gen_scrap.TUG_PLAN): a cockpit and engine
    room above a cabin, one door between them, eight thrusters, antenna and
    radar on the hull. The wreck's random damage is unchanged (the damage
    pass replays the first tug's draws). Walls weigh 200 kg and decks
    100 kg (aluminum): the tug starts at 33.7 t and speeds up by 4.7 m/s
    each second. Thruster info line says 20 KN to match the flight.
    test_scrap_sim.py updated for the new cells and passes.
    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
2026-11-09 router_v4: CKPT=file checkpoints the router after every iteration and phase and resumes from it (bit-identical to an uninterrupted run)
    Routes, PathFinder pressure and conflict history, best-iteration snapshot and the post-loop phases (hard rounds, rip-retry,
    improve passes) are saved, so a whole-board route can run under a wall-clock cap and be restarted. CKPTSTOP=N is a test hook.
    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
2026-11-09 router_v4: group labels of a net's fixed copper stored sparse (a full-grid pair per net was 65 MB on the fine grid, 16 GB for the whole board: OOM on a 16 GB machine); route output unchanged
    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
2026-11-09 router_v4 round 10: whole-board route on the cloud CPU + round 9 ladder = 468 vias / 39.54 m (bench wbf10_a0_*); README round 10
    Fresh fine-grid route with ALLEVERY=0 (16 iterations, CPU, checkpointed across the 2 h job cap): raw 643 vias / 38.88 m,
    then the BEST tidy ladder with DIAGRUNGS=2 and the wide rung: 538 / 520 / 506 / 491 -> 468 vias / 39.54 m, 0 open, 0
    collisions. Previous best whole board 478 / 40.66 m (round 8) and 479 / 39.69 m (round 9).
    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
2026-11-09 SCRAPWRIGHT: conduits on any deck or wall, under parts; V power view
    A conduit is now a bit a cell (in the hidden bytes of the screen), so a
    conduit section can go on a deck, in a wall, or under an installed part.
    V turns on the power view: each conduit drawn as a line, yellow when its
    network reaches a working reactor or installed battery, orange when not,
    with stubs into the powered parts beside it (plugged in). The tug is
    wired through its hull walls to its reactor, battery and parts.
    The power view's code is the SCRAP.PWR swap (x4700-x4CFF) and the start
    code moved to the SCRAP.INI swap (x4100-x44FF), freeing resident memory.
    test_scrap_sim.py checks it (--power for the quick run).
    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
2026-11-09 router_v4: placeguide scratch mode (placement from the netlist), swap-overlap fix, ICROTS
    scratch: only connectors, slots, cartridge, holes, switches and logo stay; chips and passives are
    placed by quadratic placement with bisection spreading, legalised (caps beside ICs) and refined by
    optimize. Routed (coarse + tidy VIA 400): free rotation 600 vias / 39.21 m, horizontal rows 652 /
    41.52 m, against 578 / 41.49 m for the hand placement and 532 / 38.42 m for hand + optimize.
    Fixes Legal.ok during swaps (moved parts were not checked), adds ICROTS rotation limit.
    Claude-Session: https://claude.ai/code/session_01DnW5SUHZHeb8n61VZHhhXv
2026-11-09 SCRAPWRIGHT: thrusters, antennas and radars face any side (TURN)
    Each of THRUST, ANT and RADAR now has left, down and right facing kinds
    (same name, value and needs; the code treats them as the same part).
    The left ones have their own art; down and right are drawn by flipping
    and mirroring at draw time (dc_face), so only 36 kinds need art slots.
    TURN on a part cycles it up, right, down, left; picking it up gives the
    plain part. The art is redrawn so each part sits on a flange that
    touches the hull. The tug's side and bottom thrusters face outward.
    Identical strings are shared to keep the resident code in its pages.
    Claude-Session: http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
2026-11-09 SCRAPWRIGHT power WIP: new kinds (flat battery, switch, deuterium), SCRAP.ACT swap
    Claude-Session: https://claude.ai/code/session_01DnW5SREacNVruzRW4jN2TA
2026-11-09 SCRAPWRIGHT: real power - battery bank, loads, switches, reactor fuel, power lights
    The tug's installed batteries share one charge (8 kWh each); every 4 s
    the load of every working installed part with power comes off it (the
    start's tug draws 16 kW: one battery lasts about 30 minutes). A flat
    bank stops the scrubber, pump, intake, antenna and thrusters. Loose
    batteries are charged or flat; installing one adds its charge,
    uninstalling takes it out. New items: flat battery, power switch
    (TURN ON / TURN OFF cuts its conduit), deuterium cell (beside a reactor
    it runs 40 kW for about 2 hours, then is used up). The starting tug has
    no reactor; the reactor is now a part that can be salvaged. Instal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
2026-11-09 router_v4: placeguide rules mode (Justin's placement rules) and pinswap mode with pin-swap table
    Rules placer: single-destination passives at their connector, chips outside-in on rows,
    decap at pin 1, optional refine with any rotation. Pin-swap table (pinswap.py): register
    D/Q and buffer A/Y pairs, SRAM address/data, ATF22V10C pins within OLMC product-term
    limits; greedy swaps scored by the model, bench copy with pad nets swapped. Routed on the
    main board test bench: hand + optimize + pin swaps 447 vias / 36.47 m (hand 578 / 41.49).
    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
2026-11-10 router_v4: power-layer jumpers in the tidy (JUMP=1) and pin swapping before routing (PINSWAP=1)
    Jumpers: third search layer In2.Cu (+5V plane, never GND) for short runs in tough
    spots: astar3 in astar.c, gridcore layer model, tidy chain moves, ladder JUMPRUNG=1,
    score.py jumper report and +5V plane check. At most JMAX mm per run, JSPACE mm
    between jumpers. Fine r1 422 -> 418 vias; whole board 468 -> 463 at JENTRY=0.25.
    Pin swapping: mroute4.py PINSWAP=1 runs placeguide's pinswap pass first (pins of
    nets with copper stay), routes the swapped copy and writes the pin change list.
    Fine r1 with swaps 412 vias / 25.93 m, with jumpers 394 / 25.60 m.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
2026-11-10 SCRAPWRIGHT: M toggles a zoomed-out ship map
    M swaps the ship view for the whole 96 x 64 map, a pixel per cell
    (square on the monitor), each cell its kind's average art color (chroma
    pushed x2 from gray, nearest of the 16 colors), the player white. View
    only: walking stops, M or I goes back. map_draw lives in SCRAP.INV
    (inv = 2), so the resident program only gains the key check.
    Test: --map quick mode and a step in the full run against
    gen_scrap.map_screen(); a guard that SCRAP.INV labels stay in its swap
    region; two timing-sensitive waits made robust (a job starting a frame
    or two late; the power view's lights bit).
    Claude-Session: h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
2026-11-10 SCRAPWRIGHT: everything but SCRAP.PLC in the card's SCRAP folder
    ovl_load opens the folder SCRAP first and it stays the current folder, so
    SCRAP.OVL, the swap files and the part text are read from there (prt_load
    no longer goes in and out of it). gen_plc.py --dir puts the .OVL and swap
    files in a folder next to the .PLC. test_scrap_sim builds the card the same
    way and checks Esc brings the DOS back in the root folder. Web SD image
    Claude-Session: https://claude.ai/code/session_01DnW5SU58AdmeWPzYTY8Dp5
    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
2026-11-10 test_scrap_sim: pump/intake check waits for pw_chk to finish before restoring the part
    tug_scan zeroes the counts first, so the broken state can show mid-scan;
    pc_draw then cleared the PW_GO the test set, and the part never came back.
    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
2026-11-10 Add schematic drawing rules from Justin's requests
    docs/hardware/SCHEMATIC_DRAWING_RULES.md collects every schematic, symbol
    and block diagram change Justin asked for, quoted with date and source.
    SCHEMATIC_PLAN.md links it and now says Justin's KiCad sheets are the
    source for the main board.
    Claude-Session: https://claude.ai/code/session_01DnW5SSdtMGrS97QzWXjExc
2026-11-10 Library: faster mul8 and con_dec16, lib_far for map-FF programs
    - mul8: the smaller factor is the multiplier, read from bit 0 up, and the
    loop stops when it runs out of 1 bits (96 clocks for x1, ~340 under 16,
    691 at most, was 476-719)
    - con_dec16: powers of ten subtracted instead of a div16 a digit
    (about 900-4,200 clocks, was 1,840-9,530); entry addresses unchanged
    - lib_far at LIB_FAR (x1FA0, in LIB_RAM): a library call from a program
    running with map FF; SCRAPWRIGHT's and the tracker's l_* stubs use it
    (about 34 bytes a stub smaller, 95 clocks over a direct call, was 129,
    no stack); test_lib tests it
    - placard_mus: mus_frame no longer stalls when it is called exactly a
    lap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
2026-11-10 router_v4 bench: whole board with pin swaps and power-layer jumpers (laptop GPU)
    placeguide.py: numpy point-in-polygon fallback when matplotlib is missing
    (pin-swap mode only needs contains_points).
2026-11-10 router_v4 README: round 11 whole board with pin swaps and jumpers (388 vias / 37.42 m)
    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
2026-11-10 Library: con_dec16 in one block (free end of the slot page)
    con_dec16 was split over pages 5 and 6 of LIB_CODE with its table in
    page 3, so each digit took two jumps between pages. It now sits whole
    in the free end of the slot helpers' page (lib_dec16.asm, included after
    placard_slot.asm), with no jumps between pages; the jump table entry
    points at it. Frees 108 bytes at xF994 and 63 at xFAB6 (and 8 at xF7CB).
    Programs that call con_dec16 directly were rebuilt: DOS.PLC, TEST.PLC,
    SCROLLER.PLC, TEXT.PLC, the ROM hexes and the web emulator's assets.
    Claude-Session: https://claude.ai/code/session_01DnW5SViD8R2RMtf2921hj4
2026-11-11 router_v4 bench: PNG views of the pin-swap j25 board (signal layers, In2)
2026-11-11 router_v4 bench: WinCUPL check of the wbf11_ps PLD pin swaps (all 20 fit)
2026-11-11 router_v4: pldcheck.py, static check of PLD pin swaps + swapped .pld variants
    All 20 ATF22V10 pin swaps on the 388-via bench board fit their new pins.
    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
2026-11-11 Font pointer FONT_PG in the zero page; asm_expand flow placement fix
    - zeropage.asm: FONT_PG (xBF) holds the high byte of the font's first
    page. The boot (ROM programs) and the card loader (lib_ram_copy: at
    power-up, before a program starts and when one ends) set it to
    LIB_FONT >> 8; a program may point it at its own 8 pages.
    - con_putc reads the glyph through FONT_PG (376 clocks, was 327). BASIC,
    SCRAPWRIGHT, the tracker and the text demo read the font through it too.
    - The bring-up ROM sets FONT_PG after its RAM tests.
    - asm_expand.py: .flow chunks were placed without looking at the pages
    already used (the key of the used table changed on 11/06), so a rebuilt
    rom32.asm put BA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
2026-11-11 Group the 32K ROM by 8 KB section
    Section 7 (always on): jump table, core routines, PS/2 keyboard and mouse,
    pads, line input, menu hook, slot helpers. Section 6: SD card driver, FAT
    reader and FAT writer. Section 5: BASIC only. Section 4: vectors, loader,
    sound driver, font (read through FONT_PG), LIB_RAM image. The jump table
    and the vector page keep their addresses; every card program is rebuilt.
    Development ROMs keep the released 32K in the upper half and one program
    in the first 32K (boot mode byte at x0005). The ROM builds of boing,
    wire3d, raycast, raycast_tex, scroller and text_demo are retired; those
    demos run from the SD card.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
2026-11-11 Bring-up guide: example monitor pictures at every step that changes the screen
    gen_bringup_screens.py renders steps 5-13 pixel by pixel from the
    bringup_signals.py PLD model as each step wires it, and steps 19-21 from
    the 32K bring-up ROM in the simulator. Images in
    docs/hardware/bringup_screens/, embedded in BRINGUP.md.
    Claude-Session: https://claude.ai/code/session_01DnW5STXVAEeiRrMJ6o3ihg
2026-11-11 Bring-up guide: a board picture per step with that step's parts highlighted
    gen_bringup_boards.py reads each step's parts table in BRINGUP.md and the
    part outlines in kicad/placard.kicad_pcb (as text, no KiCad needed) and
    draws the board with the parts to fit in orange, parts already fitted in
    gray and the rest outlined; the 32K cartridge gets its own picture at
    step 19. Images in docs/hardware/bringup_boards/.
    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
2026-11-11 Docs: bring stale drawings and text up to date, archive what was superseded
    - Board pictures drawn from the current board files by the new
    gen_board_pictures.py: main board 3D view and copper, 32K and 64K
    cartridge boards. The 290 x 290 mm outline plan, the placement fit
    test, the cartridge placement drawings, the first connector models
    and the pre-KiCad audio sketch move to docs/archive/ with an index.
    - Memory map redrawn for the ROM grouped by section (FONT_PG, sound
    and font in section 4, files in section 6, dev program in 16 KB).
    - Shell keepout drawing and EXPANSION.md: slots are 27 mm apart.
    - State diagram: State PLD revision 15, /WE made by the Sync PLD.
    - SOUND.md shows s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
2026-11-11 Bring-up board pictures: socket-only color, straps drawn pin to pin
    A socket fitted without its chip is blue (pale blue until the chip goes
    in). Straps S1-S4 are read from the guide's text and drawn in green
    between their pins for as long as they stay in; steps 6 and 8 get a
    close-up of the sockets with every pin numbered and the test lead clip
    points.
    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
2026-11-12 Bring-up step 16: assembly check readings at U18 and U26
    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
2026-11-12 Bring-up guide: call them test stages, split the CPU section in two
    Rename "chip gates" to "test stages" in the guide, the ROM generator,
    the simulator and the screen script. Split the CPU section into one
    before the cartridge (steps 13-16) and one with the cartridge (17-22).
    The ROM image is byte-identical; only labels and comments changed.
    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
2026-11-13 Skyward Tobi: World 1 of Skyward Tobi 4 as an SD card game
    SKYWARD.PLC with its six course files in SKYWARD/, made by
    gen_skyward.py on the scroller's engine (five tile rows, courses read
    from the card). Four courses, the glider, Baron Rook, title and ending.
    The story, cast, course ideas and some sprite frames are from Skyward
    Tobi 4 (MIT License, Copyright (c) 2026 Mark Szlemko); the hero, the
    score line and the blocks are the Placard's own. test_skyward_sim.py
    plays it through with a bot and checks every frame against the model.
    Claude-Session: https://claude.ai/code/session_01DnW5SUYM2hiJmVafsW2SDD
2026-11-13 Lamplighter: an exploration platform game, stage 1 (engine and six rooms)
    Two-way scrolling rooms read from the SD card, the hero, shots, doors and
    crawling; gen_lamp.py with a Python model of the rules, test_lamp_sim.py
    with a bot that plans its route by searching the model.
    Claude-Session: https://claude.ai/code/session_01DnW5SUUtAij8RDpV8nBapB
2026-11-13 Lamplighter stage 2: creatures, energy, items, the Glasswort Gardens and its boss
    Creatures (walkers, flyers, sitters that spit, droppers), their bolts,
    energy and damage, embers, items that stay found (the Burrow Rig, the
    Updraft Bellows, Oil Flasks, the Ash Sail), a message line. A room has
    up to 6 things; an area's table says what each kind does. The Glasswort
    Gardens: eight rooms off the West Gallery, four kinds of creature and the
    boss Bramblejaw (32 x 32, in a sprite set of its own). The drawing
    starts 20 lines earlier, so sprites at the top of the screen are done
    before the beam. test_lamp_sim.py: the bot goes through all 14 rooms,
    beats the boss and comes back (7,535 frames), com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
2026-11-13 Lamplighter stage 3a: the Slagworks, the Kiln Charge, the Cinder Coat, Clinker
    The deep Wellshaft and seven rooms of the Slagworks, a hopper and a boss
    that floats and drops bolts, the charged blast and sooted blocks, a hot
    room, the Cinder Coat. Every boss can now be reached as well as beaten
    with nothing collected: a second way into the Gardens, ledges at the
    Thorn Gate and the East Gate, a way over the Soot Lock. The test proves
    both bare runs on the model before its long run.
    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
2026-11-13 Skyward Tobi: the rest of World 1
    Seven more courses (Whistling Cave, Gale Fort with Captain Squall,
    Shellback Beach, Skyrail Rise, Thorn Garden, Bouncy Boughs, Cloud
    Cellar), Mark Szlemko's own Tobi, Spindle, Shellby, Snapjaw, Tengu Geta
    and Squall art, crates with the Sky Berry, Glide Feather and Tengu Geta,
    thorns, bounce drums, air vents and lifts. Course files are now
    SKYWARD/CA.LVL to CM.LVL.
    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
2026-11-13 Lamplighter: the stage 3a test in the doc
    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
2026-11-13 Skyward Tobi: World 2 (Gusty Mesa) and the Ember Pepper
    The harbor (a picture of the boat between the worlds), ten more
    courses (Sandstone Trail, Thermal Ridge, Updraft Canyon, Drywell Cavern,
    Spindle Gulch, Glider Gorge, Tengu Skywalk, Mirage Mesa, Squall Fort,
    Dust Keep), a desert theme, mirage blocks, bosses with four hits, and
    the Ember Pepper: Down or pad Y throws an ember that knocks out an
    enemy. Course files are now SKYWARD/CA.LVL to CX.LVL.
    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
2026-11-13 Lamplighter stage 3b: the Brine Vaults, water, the Ballast Boots, the Wide Flame, Old Gulper
    Six rooms from the foot of the deep Wellshaft. Water slows Wick and
    lowers his jump until the Ballast Boots are found; the third boss, Old
    Gulper, wades a flooded cistern and leaves the Wide Flame (three sparks
    a shot). It too can be reached and beaten with nothing collected.
    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
2026-11-13 Lamplighter: the stage 3b test in the doc
    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
2026-11-14 WIP stage 3: zero page and low RAM freed for the music player
2026-11-14 Lamplighter stage 3c: the Orrery, the seal, the Snuffer, the Great Lamp
    Six rooms under a brass seal in the deep Wellshaft's floor that opens
    once the three bosses are beaten (the prize need not be taken, so the
    last boss is still reached with nothing collected). The Snuffer floats
    and drops bolts, and is faster and spits twice as often when wounded;
    past its own seal is the Great Lamp. Rooms can carry a message.
    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
2026-11-14 Lamplighter: the stage 3c test in the doc; web card image
    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
2026-11-14 Lamplighter stage 4a: title, save lamps, ending, go on from the card
    The title offers a new game (jump) or, when LAMP/SAVE.DAT holds a save,
    going on from the last save lamp (fire). Five save lamps fill the lantern
    and write the found-things page to the card; losing all energy starts
    again at the last lamp. The Great Lamp's room shows the time played and
    the things found, and jump goes back to the title. The card ships a blank
    SAVE.DAT.
    The FAT writer (ROM section 6) could not replace or add a file past a
    folder's first cluster: the folder sector it had just read was taken as
    the cached FAT sector, and the sector it wrote was the one before the
    read, wrong for a folder whose clusters are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
2026-11-14 Lamplighter stage 4b: four-voice tracker music and sound effects
    Original songs for the title, every area, each boss den and the ending
    (lamp_music.py), played by the four-voice player from video-RAM gaps
    and spare pages; memory map reworked so the player fits; sound effects
    go through the player's sfx voice. The sim test checks music is in the
    audio buffer.
    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
